v3ai/miata-ecus/motherboards/1996-97/README.md

# Miata ECU motherboard 1996-1997 (NA8 OBD2), rev 0.7

The motherboard replaces the stock Mazda ECU board inside the **stock ECU case**. It carries:

- the stock harness header;
- the year-independent I/O: the LSU 4.9 wideband sensor connector, IAT, USB-C and the MAP sensor;
- the sockets for the universal daughterboard, which does all the engine control (including the wideband controller).

## Changes in this revision
- Rev 0.7, for daughterboard rev 0.9: the daughterboard sits 16 mm lower, centred on the board (42 mm from the top, as up to rev 0.7), with its J1 on its top edge again: JD1 and the upper standoffs HD1/HD2 are back at their rev 0.7 places, JD2, the lower standoffs HD3/HD4, the AUX header J5 (with F4 beside it) and the parts placed against JD2 (CAN termination R1/R6, pull-up options) are 16 mm lower, and the board is routed again. Not compatible with a rev 0.8 daughterboard.
- Rev 0.6, for daughterboard rev 0.8: the harness's sensor 5 V (3I) and the AUX header pin J5-14 now come from the daughterboard's protected 5 V (V5_EXT, JD1 pin 13, which was a ground pin): a sensor 5 V wire shorted to the battery no longer back-feeds the MAP sensor and the ECU's own 5 V. The MAP sensor keeps its own supply (V5_SENS). The daughterboard outline on the silkscreen is 16 mm taller (125 x 76 mm): its new strip of output drivers overhangs the free area above JD1.
- Rev 0.5: LSU heater fuse F1 is a 3 A hold PTC (LUTE 2920L300/30GR, 30 V, 2920 size) instead of the 2 A 1812 part. A cold LSU 4.9 heater draws 1.6-2.3 A rms at the start of the wideband's warm-up, more than the old fuse holds once warm, so it could trip and the controller time out. No 1812 PTC holds 3 A above 8 V.
- Rev 0.4: freewheel diode D1 on the idle valve to its +12 V feed (the PWM turn-off energy no longer goes into the daughterboard driver); F4 resettable fuse on the AUX +12 V pin J5-15; not-fitted 12 V pull-up options R20-R22 for the VSS / A/C / clutch inputs.
- Rev 0.3: IAT source is now a removable jumper (JP1, 1x3 2.54 mm header + shunt) instead of the R4 / R5 0R links: shunt on EXT (default) reads the IAT connector J3, on STOCK the stock harness sensor; labelled on the silkscreen.
- Rev 0.2: MAP sensor is now the MPX5700AP (absolute, case 867B, one barb; LCSC C90152) instead of the MPX5700DP: new footprint with the real lozenge body and offset barb, holes on the NXP 23.11 mm spacing with 3.3 mm M3 clearance drills.
- Rev 0.1: first release (design complete, case geometry provisional).

## Files
| Path | What |
|---|---|
| `miata_mb_9697.kicad_pro / .kicad_sch / .kicad_pcb` | KiCad 7 project. Root schematic plus three sheets: harness, daughterboard, I/O |
| `miata_mb_9697_schematic.pdf` | Schematic PDF |
| `fab/miata-ecu-motherboard-1996-97-rev0.7_jlcpcb_gerbers.zip`, `fab/miata-ecu-motherboard-1996-97-rev0.7_jlcpcb_bom.csv`, `fab/miata-ecu-motherboard-1996-97-rev0.7_jlcpcb_cpl.csv` | JLC fabrication and assembly files (2 layers, 1.6 mm). The JLC BOM is the SMD parts and USB-C only |
| `fab/miata-ecu-motherboard-1996-97-rev0.7_self_order_bom.csv` | Everything you order and fit yourself: harness header, through-hole connectors, MAP sensor, shunt, standoffs and screws, plus the not-fitted options. Its columns load into LCSC's BOM tool |
| `fab/miata-ecu-motherboard-1996-97-rev0.7_parts_list.csv` | Every part, including the hand-fitted and not-fitted ones |
| `fab/drc_report.txt` | KiCad DRC |
| `ecu_mb.pretty/`, `fp-lib-table` | Project footprints (harness header, MAP sensor lying flat, USB-C, M4 case hole) |
| `renders/` | Top and bottom copper |
| `scripts/` | The design source; `mb_make.sh` rebuilds the whole board |

## Case fit
**PROVISIONAL.** No source gives this case's board outline and mounting holes yet (the open-source boards for these years either use their own enclosure or a different Mazda case). Until a stock board or case is measured, this board uses the NA case outline and holes as a stand-in, with the header centred on the top edge. Moving to the real outline is a change of OUTLINE / CASE_HOLES / HDR_1A in the year module plus an automatic reroute. **Do not order this board before the case is measured.**

Board: **154.0 × 161.5 mm**, 1.6 mm. The origin is the top-left corner and y points down, toward the bottom edge.

| Hole | x, y (mm) |
|---|---|
| H3 | 4.0, 84.0 |
| H4 | 150.0, 84.0 |
| H5 | 4.0, 143.0 |
| H6 | 150.0, 143.0 |

All holes are 4.5 mm plated with a 7 mm pad, tied to GND, for M4 screws. Harness header terminal 1A sits at (16.00, 18.13) mm (lower pin row).

## Harness header
TE **178780-1**, 76 positions (alternates 174915-6, 3-178780-6): OEM plug 1 = 1A-1V (22), plug 2 = 2A-2L (12, no harness plug: left open), plug 3 = 3A-3P (16), plug 4 = 4A-4Z (26). Hellen's board names the same cavities 1 / 4 / 2 / 3. Fitted by hand.

| Pin | Net | Use | Stock function / note |
|---|---|---|---|
| 1A | `OUT_FAN` | fan relay | cooling (radiator) fan relay |
| 1B | `OUT_LS7` | spare low side | fan No.2 / A/C condenser fan relay |
| 1E | `OUT_CEL` | check engine lamp | MIL |
| 1G | `OUT_AC` | A/C relay | A/C relay |
| 1K | `IN_SW2` | 12 V switch input 2 | A/C switch / refrigerant pressure switch |
| 1L | `IN_SW3` | 12 V switch input 3 | clutch switch |
| 1M | `IN_SW1` | 12 V switch input 1 | vehicle speed sensor |
| 1O | `GND` | ground | ground |
| 1U | `OUT_FP` | fuel pump relay | fuel pump relay |
| 3B | `IN_AUX3` | spare analog 3 | MAF signal |
| 3C | `IN_AUX2` | spare analog 2 | front HO2S (narrowband) |
| 3D | `IN_AUX1` | spare analog 1 | rear HO2S |
| 3F | `IN_TPS` | TPS | throttle position sensor |
| 3G | `IN_CLT` | coolant temp | coolant temperature sensor |
| 3I | `V5_EXT` | sensor 5 V reference (out; protected, short-to-battery proof) | +5 V sensor reference (TPS, MAF) |
| 3K | `HARN_IAT` | stock air-temp sensor (JP1 on STOCK) | intake air temperature sensor (IAT jumper JP1 on STOCK to use it) |
| 3M | `OUT_VVT` | PWM low side (VVT driver) | front HO2S heater (PWM low side; no VVT on this engine) |
| 3O | `GND` | ground | sensor ground (BLK/BLU) |
| 4A | `GND` | ground | ground |
| 4B | `VBAT_IN` | ECU power (main relay) | ECU +12 V from the main relay (WHT/RED) |
| 4C | `GND` | ground |  |
| 4D | `GND` | ground |  |
| 4F | `IN_HALL1` | hall input 1 (crank) | CAS 4-pulse crank angle (SGT), hall / open collector |
| 4G | `IN_HALL2` | hall input 2 (cam) | CAS 2-pulse cam (SGC), hall / open collector |
| 4L | `OUT_TACH` | tach out | tachometer |
| 4N | `OUT_IGN1` | ignition 1 (5 V logic) | igniter cylinders 1 & 4 |
| 4Q | `OUT_IACV` | idle air valve | idle air control valve (low side) |
| 4R | `OUT_IGN2` | ignition 2 (5 V logic) | igniter cylinders 2 & 3 |
| 4U | `OUT_INJ1` | injector 1 |  |
| 4V | `OUT_INJ2` | injector 2 |  |
| 4W | `OUT_INJ3` | injector 3 |  |
| 4X | `OUT_INJ4` | injector 4 |  |

Not connected: 1C, 1D, 1F, 1H, 1I, 1J, 1N, 1P, 1Q, 1R, 1S, 1T, 1V, 2A, 2B, 2C, 2D, 2E, 2F, 2G, 2H, 2I, 2J, 2K, 2L, 3A, 3E, 3H, 3J, 3L, 3N, 3P, 4E, 4H, 4I, 4J, 4K, 4M, 4O, 4P, 4S, 4T, 4Y, 4Z.

## Bottom edge, left to right
| Ref | What | Notes |
|---|---|---|
| J2 | LSU 4.9 (Molex Micro-Fit 2×3, right angle) | Pin n = LSU pin n: 1 IP, 2 VM, 3 H−, 4 H+, 5 RT, 6 UN. Heater fed from the main relay through F1 (3 A hold, 30 V, 2920). The controller is on the daughterboard |
| J3 | IAT (Micro-Fit 1×2) | M12×1.5 open-element thermistor, used when the IAT jumper JP1 is on EXT |
| JP1 | IAT source jumper (1×3, 2.54 mm) | Shunt on **2-3 (EXT, default)**: the IAT connector J3. Shunt on **1-2 (STOCK)**: the stock air-temp sensor through the harness (inside the airflow meter on 1989-97, in the air filter box on 1999-2005). Set the matching sensor curve in TunerStudio; the pull-up is 2.7 kΩ |
| J4 | USB-C | USB 2.0 device: tuning, logging, DFU |
| U2 | MPX5700AP | Absolute MAP sensor (15-700 kPa, case 867B). Lies flat on 2 × M3, marking side up, leads bent 90° down, the single barb toward the board centre |

**CAN:** R1 + R6 terminate the bus at the ECU end; remove R6 if the bus is terminated elsewhere.

**AUX (J5, 2×8 box header):** what the stock harness has no pins for: COP 3/4, boost, alternator and main-relay outputs, knock input, VR crank/cam inputs, external AFR input, UART, 5 V sensor supply, +12 V and GND.

**Protection (motherboard rev 0.4 / 0.6):** D1 (and D2 where the VVT driver runs a coil) freewheel the PWM valve coils into their own +12 V feed, so the drivers don't absorb the turn-off energy. F4 fuses the AUX +12 V pin (0.5 A hold).

**Switch inputs (R20-R22, not fitted):** the VSS, A/C and clutch inputs read signals that are driven to 12 V. If your car's signal only switches to ground (or is open collector), fit the 4.7 kΩ pull-up for that input. Never fit it for a switch that drives 12 V: the input would always read on.

**Sensor 5 V:** the harness's 5 V reference and the AUX header pin J5-14 come from the daughterboard's protected 5 V regulator (V5_EXT; it survives a short to the battery or to ground). The MAP sensor has its own supply (V5_SENS), so a damaged sensor wire doesn't take the MAP reading with it.

## Assembly
- The daughterboard plugs into JD1/JD2 (8.5 mm sockets) on four M3 × 11 mm standoffs.
- Fitted by hand (all in `fab/miata-ecu-motherboard-1996-97-rev0.7_self_order_bom.csv`): the harness header (salvage from a stock ECU or use a clone), the daughterboard sockets JD1/JD2, the LSU and IAT connectors, the AUX header, the JP1 header and its shunt (EXT or STOCK), the MAP sensor, the standoffs, and any not-fitted option links. JLCPCB fits only the SMD parts and USB-C. USB-C has through-hole shell pegs: check in JLC's quote whether that needs Standard PCBA.
- The case needs cut-outs in its bottom edge for the LSU, IAT, USB-C and MAP hose.

## Still to verify
- **The case outline, mounting holes and header position (provisional here).**
- The 76-position header housing is 130 mm wide and reaches into the top-corner notches of the provisional (NA) outline; the real 1996-97 case must clear it.
- 4E / 4H: the separate OBD-II crank-pulley sensor (VR) is left unconnected, as on every PnP board found; rusEFI uses the CAS signals on 4F / 4G.
- 1O and 4A are tied to ground (sources agree they are grounds; power vs signal role unconfirmed).
- 4I (possible battery backup), 4K, 1D, 1H, 1I, 1P, 3H, 3J, 3N, 3P and the other unidentified cavities are left open.
- Brake switch (1Q) is not read: the spare inputs are 0-5 V analog, not 12 V switch inputs.
