v3ai/miata-ecus/daughterboard/fab/drc_report.txt

** Drc report for /home/claude/miata-ecus/daughterboard/miata_ecu_daughter.kicad_pcb **
** Created on 2026-11-03 22:32:18 **

** Found 474 DRC violations **
[silk_overlap]: Silkscreen overlap
    Rule: board setup constraints silk; Severity: warning
    @(151.3500 mm, 121.5100 mm): Line on F.Silkscreen
    @(151.3800 mm, 120.1536 mm): Line on F.Silkscreen
[silk_overlap]: Silkscreen overlap
    Rule: board setup constraints silk; Severity: warning
    @(-1.1625 mm, -1.5100 mm): Polygon on F.Silkscreen
    @(156.6000 mm, 111.0000 mm): Reference 'D17'
[silk_overlap]: Silkscreen overlap
    Rule: board setup constraints silk; Severity: warning
    @(112.0000 mm, 108.6000 mm): Reference 'U8'
    @(111.7627 mm, 108.1225 mm): Line on F.Silkscreen
[silk_overlap]: Silkscreen overlap
    Rule: board setup constraints silk; Severity: warning
    @(121.7500 mm, 89.9100 mm): Line on F.Silkscreen
    @(121.8900 mm, 87.7400 mm): Line on F.Silkscreen
[silk_overlap]: Silkscreen overlap
    Rule: board setup constraints silk; Severity: warning
    @(121.7500 mm, 89.9100 mm): Line on F.Silkscreen
    @(121.8900 mm, 87.7400 mm): Line on F.Silkscreen
[silk_overlap]: Silkscreen overlap
    Rule: board setup constraints silk; Severity: warning
    @(118.4500 mm, 89.9100 mm): Line on F.Silkscreen
    @(121.8900 mm, 87.7400 mm): Line on F.Silkscreen
[silk_overlap]: Silkscreen overlap
    Rule: board setup constraints silk; Severity: warning
    @(114.0594 mm, 86.9100 mm): Line on F.Silkscreen
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
    Local override; Severity: warning
    @(166.3400 mm, 117.4000 mm): Footprint R52
[lib_footprint_issues]: The current configuration does not include the library 'Capacitor_SMD'.
    Local override; Severity: warning
    @(117.6000 mm, 95.2000 mm): Footprint C20
[lib_footprint_issues]: The current configuration does not include the library 'Resistor_SMD'.
    Local override; Severity: warning
    @(115.6000 mm, 113.6000 mm): Footprint R45
[lib_footprint_issues]: The current configuration does not include the library 'Package_TO_SOT_SMD'.
    Local override; Severity: warning
    @(166.3400 mm, 61.5000 mm): Footprint Q2
[lib_footprint_issues]: The current configuration does not include the library 'Diode_SMD'.
    Local override; Severity: warning
    @(124.0000 mm, 114.9000 mm): Footprint D20
[lib_footprint_issues]: The current configuration does not include the library 'Capacitor_SMD'.
    Local override; Severity: warning
    @(212.0000 mm, 104.0500 mm): Footprint C114
[lib_footprint_issues]: The current configuration does not include the library 'Capacitor_SMD'.
    Local override; Severity: warning
    @(118.0800 mm, 118.9000 mm): Footprint C44
[lib_footprint_issues]: The current configuration does not include the library 'Button_Switch_SMD'.
    Local override; Severity: warning
    @(219.5000 mm, 103.6000 mm): Footprint SW1
[lib_footprint_issues]: The current configuration does not include the library 'Package_TO_SOT_SMD'.
    Local override; Severity: warning
    @(173.9600 mm, 61.5000 mm): Footprint Q3
[lib_footprint_issues]: The current configuration does not include the library 'Package_SO'.
    Local override; Severity: warning
    @(151.7350 mm, 80.6000 mm): Footprint U7
[lib_footprint_issues]: The current configuration does not include the library 'Diode_SMD'.
    Local override; Severity: warning
    @(143.4800 mm, 114.3000 mm): Footprint D13
[lib_footprint_issues]: The current configuration does not include the library 'Resistor_SMD'.
    Local override; Severity: warning
    @(172.8000 mm, 120.0000 mm): Footprint R80
[lib_footprint_issues]: The current configuration does not include the library 'Diode_SMD'.
    Local override; Severity: warning
    @(149.7000 mm, 119.9000 mm): Footprint D27
[lib_footprint_issues]: The current configuration does not include the library 'MountingHole'.
    Local override; Severity: warning
    @(220.5000 mm, 121.5000 mm): Footprint H4
[lib_footprint_issues]: The current configuration does not include the library 'Resistor_SMD'.
    Local override; Severity: warning
    @(143.5000 mm, 120.0000 mm): Footprint R61
[lib_footprint_issues]: The current configuration does not include the library 'Resistor_SMD'.
    Local override; Severity: warning
    @(137.9000 mm, 117.6000 mm): Footprint R44
[lib_footprint_issues]: The current configuration does not include the library 'Package_TO_SOT_SMD'.
    Local override; Severity: warning
    @(151.1000 mm, 64.1000 mm): Footprint Q18
[lib_footprint_issues]: The current configuration does not include the library 'Fuse'.
    Local override; Severity: warning
    @(203.8200 mm, 120.4500 mm): Footprint F2
[lib_footprint_issues]: The current configuration does not include the library 'Capacitor_SMD'.
    Local override; Severity: warning
    @(179.7500 mm, 110.4400 mm): Footprint C67
[lib_footprint_issues]: The current configuration does not include the library 'Capacitor_SMD'.
    Local override; Severity: warning
    @(196.6000 mm, 105.0000 mm): Footprint C119
[lib_footprint_issues]: The current configuration does not include the library 'Capacitor_SMD'.
    Local override; Severity: warning
    @(107.4000 mm, 98.0000 mm): Footprint C24
[lib_footprint_issues]: The current configuration does not include the library 'Resistor_SMD'.
    Local override; Severity: warning
    @(176.2500 mm, 102.1000 mm): Footprint R139
[lib_footprint_issues]: The current configuration does not include the library 'LED_SMD'.
    Local override; Severity: warning
    @(219.6000 mm, 95.0000 mm): Footprint D4
[lib_footprint_issues]: The current configuration does not include the library 'Resistor_SMD'.
    Local override; Severity: warning
    @(150.4000 mm, 117.6000 mm): Footprint R68
[lib_footprint_issues]: The current configuration does not include the library 'Package_TO_SOT_SMD'.
    Local override; Severity: warning
    @(194.4000 mm, 75.4000 mm): Footprint U15
[lib_footprint_issues]: The current configuration does not include the library 'Capacitor_SMD'.
    Local override; Severity: warning
    @(143.5000 mm, 117.6000 mm): Footprint C51
[lib_footprint_issues]: The current configuration does not include the library 'Capacitor_SMD'.
    Local override; Severity: warning
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
    Local override; Severity: warning
    @(174.0000 mm, 97.5000 mm): Footprint D37
[lib_footprint_issues]: The current configuration does not include the library 'Package_TO_SOT_SMD'.
    Local override; Severity: warning
    @(141.4000 mm, 119.9000 mm): Footprint D35
[lib_footprint_issues]: The current configuration does not include the library 'Resistor_SMD'.
    Local override; Severity: warning
    @(205.6000 mm, 104.3000 mm): Footprint R124
[lib_footprint_issues]: The current configuration does not include the library 'Package_TO_SOT_SMD'.
    Local override; Severity: warning
    @(135.8600 mm, 58.5000 mm): Footprint Q13
[lib_footprint_issues]: The current configuration does not include the library 'Resistor_SMD'.
    Local override; Severity: warning
    @(215.8700 mm, 69.4000 mm): Footprint R26
[lib_footprint_issues]: The current configuration does not include the library 'Resistor_SMD'.
    Local override; Severity: warning
    @(141.9000 mm, 113.2000 mm): Footprint R13
[lib_footprint_issues]: The current configuration does not include the library 'Resistor_SMD'.
    Local override; Severity: warning
    @(140.1000 mm, 115.1000 mm): Footprint R12
[lib_footprint_issues]: The current configuration does not include the library 'MountingHole'.
    Local override; Severity: warning
    @(104.5000 mm, 54.5000 mm): Footprint H1
[lib_footprint_issues]: The current configuration does not include the library 'Capacitor_SMD'.
    Local override; Severity: warning
    @(136.3500 mm, 117.6000 mm): Footprint C42
[lib_footprint_issues]: The current configuration does not include the library 'Capacitor_SMD'.
    Local override; Severity: warning
    @(162.0000 mm, 79.4000 mm): Footprint C61
[lib_footprint_issues]: The current configuration does not include the library 'Capacitor_SMD'.
    Local override; Severity: warning
    @(150.4000 mm, 101.2000 mm): Footprint C3
[lib_footprint_issues]: The current configuration does not include the library 'Crystal'.
    Local override; Severity: warning
    @(144.6000 mm, 98.4000 mm): Footprint Y1
[lib_footprint_issues]: The current configuration does not include the library 'Resistor_SMD'.
    Local override; Severity: warning
    @(155.4000 mm, 116.6000 mm): Footprint R75
[lib_footprint_issues]: The current configuration does not include the library 'Package_QFP'.
    Local override; Severity: warning
    @(200.5000 mm, 98.5000 mm): Footprint U102
[lib_footprint_issues]: The current configuration does not include the library 'Capacitor_SMD'.
    Local override; Severity: warning
    @(123.8500 mm, 117.6000 mm): Footprint C37
[lib_footprint_issues]: The current configuration does not include the library 'Resistor_SMD'.
    Local override; Severity: warning
    @(163.8000 mm, 117.4000 mm): Footprint R54
[lib_footprint_issues]: The current configuration does not include the library 'Button_Switch_SMD'.
    Local override; Severity: warning
    @(219.5000 mm, 111.4000 mm): Footprint SW2
[lib_footprint_issues]: The current configuration does not include the library 'Resistor_SMD'.
    Local override; Severity: warning
    @(155.4000 mm, 119.3000 mm): Footprint R78
[lib_footprint_issues]: The current configuration does not include the library 'Capacitor_SMD'.
    Local override; Severity: warning
    @(153.2000 mm, 88.0000 mm): Footprint C1
[lib_footprint_issues]: The current configuration does not include the library 'Resistor_SMD'.
    Local override; Severity: warning
    @(174.8000 mm, 95.4500 mm): Footprint R140
[courtyards_overlap]: Courtyards overlap
    Rule: board setup constraints courtyard; Severity: error
    @(135.1500 mm, 117.6000 mm): Footprint R42
    @(135.7500 mm, 119.8000 mm): Footprint R41
[courtyards_overlap]: Courtyards overlap
    Rule: board setup constraints courtyard; Severity: error
    @(173.8000 mm, 102.4000 mm): Footprint C4
    @(174.0000 mm, 100.5000 mm): Footprint D36
[courtyards_overlap]: Courtyards overlap
    Rule: board setup constraints courtyard; Severity: error
    @(153.5500 mm, 63.3000 mm): Footprint R147
    @(151.1000 mm, 64.1000 mm): Footprint Q18
[courtyards_overlap]: Courtyards overlap
    Rule: board setup constraints courtyard; Severity: error
    @(153.5500 mm, 63.3000 mm): Footprint R147
    @(153.6400 mm, 58.9000 mm): Footprint D34
[courtyards_overlap]: Courtyards overlap
    Rule: board setup constraints courtyard; Severity: error
    @(133.2500 mm, 119.8000 mm): Footprint R39
    @(133.8500 mm, 117.6000 mm): Footprint C41
[courtyards_overlap]: Courtyards overlap
    Rule: board setup constraints courtyard; Severity: error
    @(133.2500 mm, 119.8000 mm): Footprint R39
    @(132.6500 mm, 117.6000 mm): Footprint R40
[courtyards_overlap]: Courtyards overlap
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
    @(198.0000 mm, 80.0000 mm): Footprint C63
[courtyards_overlap]: Courtyards overlap
    Rule: board setup constraints courtyard; Severity: error
    @(136.1500 mm, 112.7500 mm): Footprint D38
    @(136.3500 mm, 114.9000 mm): Footprint D25
[courtyards_overlap]: Courtyards overlap
    Rule: board setup constraints courtyard; Severity: error
    @(136.1500 mm, 112.7500 mm): Footprint D38
    @(134.0000 mm, 114.9000 mm): Footprint D24

** Found 0 unconnected pads **

** Found 0 Footprint errors **

** End of Report **
