v3ai/miata-ecus/motherboards/1989-93/fab/drc_report.txt

** Drc report for ../mb/release_8993/miata_mb_8993.kicad_pcb **
** Created on 2026-11-04 20:15:21 **

** Found 110 DRC violations **
[silk_overlap]: Silkscreen overlap
    Rule: board setup constraints silk; Severity: warning
    @(119.0000 mm, 92.3000 mm): Reference 'HD1'
    @(114.5000 mm, 92.0000 mm): Line on F.Silkscreen
[silk_overlap]: Silkscreen overlap
    Rule: board setup constraints silk; Severity: warning
    @(194.4325 mm, 169.8373 mm): Line on F.Silkscreen
    @(194.2800 mm, 169.6000 mm): Reference 'R6'
[silk_overlap]: Silkscreen overlap
    Rule: board setup constraints silk; Severity: warning
    @(114.5000 mm, 92.0000 mm): Line on F.Silkscreen
    @(235.0000 mm, 92.3000 mm): Reference 'HD2'
[silk_overlap]: Silkscreen overlap
    Rule: board setup constraints silk; Severity: warning
    @(163.5825 mm, 160.2373 mm): Line on F.Silkscreen
    @(164.1700 mm, 160.0000 mm): Reference 'R21'
[silk_overlap]: Silkscreen overlap
    Rule: board setup constraints silk; Severity: warning
    @(166.7100 mm, 160.0000 mm): Reference 'R22'
    @(166.1225 mm, 160.2373 mm): Line on F.Silkscreen
[silk_over_copper]: Silkscreen clipped by solder mask
    Local override; Severity: warning
    @(139.7025 mm, 68.1300 mm): PTH pad 1A [<no net>] of J1
[silk_over_copper]: Silkscreen clipped by solder mask
    Local override; Severity: warning
    @(139.7025 mm, 63.6291 mm): PTH pad 1B [VBAT_IN] of J1
[silk_over_copper]: Silkscreen clipped by solder mask
    Local override; Severity: warning
    @(143.2001 mm, 68.1300 mm): PTH pad 1C [VIGN_IN] of J1
[silk_over_copper]: Silkscreen clipped by solder mask
    Local override; Severity: warning
    @(143.2001 mm, 63.6291 mm): PTH pad 1D [<no net>] of J1
[silk_over_copper]: Silkscreen clipped by solder mask
    Local override; Severity: warning
    @(146.3015 mm, 68.1300 mm): PTH pad 1E [OUT_CEL] of J1
[silk_over_copper]: Silkscreen clipped by solder mask
    Local override; Severity: warning
    @(146.3015 mm, 63.6291 mm): PTH pad 1F [<no net>] of J1
[silk_over_copper]: Silkscreen clipped by solder mask
    Local override; Severity: warning
    @(149.3012 mm, 68.1300 mm): PTH pad 1G [OUT_IGN1] of J1
[silk_over_copper]: Silkscreen clipped by solder mask
    Local override; Severity: warning
    @(149.3012 mm, 63.6291 mm): PTH pad 1H [OUT_IGN2] of J1
[silk_over_copper]: Silkscreen clipped by solder mask
    Local override; Severity: warning
    @(152.3009 mm, 68.1300 mm): PTH pad 1I [<no net>] of J1
[silk_over_copper]: Silkscreen clipped by solder mask
    Local override; Severity: warning
    @(152.3009 mm, 63.6291 mm): PTH pad 1J [OUT_AC] of J1
[silk_over_copper]: Silkscreen clipped by solder mask
    Local override; Severity: warning
    @(155.3007 mm, 68.1300 mm): PTH pad 1K [<no net>] of J1
[silk_over_copper]: Silkscreen clipped by solder mask
    Local override; Severity: warning
    @(155.3007 mm, 63.6291 mm): PTH pad 1L [OUT_FAN] of J1
[silk_over_copper]: Silkscreen clipped by solder mask
    Local override; Severity: warning
    @(158.3004 mm, 68.1300 mm): PTH pad 1M [IN_SW1] of J1
[silk_over_copper]: Silkscreen clipped by solder mask
    Local override; Severity: warning
    @(158.3004 mm, 63.6291 mm): PTH pad 1N [HARN_1N] of J1
[silk_over_copper]: Silkscreen clipped by solder mask
    Local override; Severity: warning
    @(161.3002 mm, 68.1300 mm): PTH pad 1O [<no net>] of J1
[silk_over_copper]: Silkscreen clipped by solder mask
    Local override; Severity: warning
    @(161.3002 mm, 63.6291 mm): PTH pad 1P [<no net>] of J1
[silk_over_copper]: Silkscreen clipped by solder mask
    Local override; Severity: warning
    @(164.2999 mm, 68.1300 mm): PTH pad 1Q [IN_SW2] of J1
[silk_over_copper]: Silkscreen clipped by solder mask
    Local override; Severity: warning
    @(164.2999 mm, 63.6291 mm): PTH pad 1R [OUT_LS7] of J1
[silk_over_copper]: Silkscreen clipped by solder mask
    Local override; Severity: warning
    @(167.2996 mm, 68.1300 mm): PTH pad 1S [<no net>] of J1
[silk_over_copper]: Silkscreen clipped by solder mask
    Local override; Severity: warning
    @(167.2996 mm, 63.6291 mm): PTH pad 1T [<no net>] of J1
[silk_over_copper]: Silkscreen clipped by solder mask
    Local override; Severity: warning
    @(170.4010 mm, 68.1300 mm): PTH pad 1U [<no net>] of J1
[silk_over_copper]: Silkscreen clipped by solder mask
    Local override; Severity: warning
    @(170.4010 mm, 63.6291 mm): PTH pad 1V [IN_SW3] of J1
[silk_over_copper]: Silkscreen clipped by solder mask
    Local override; Severity: warning
    @(176.6011 mm, 68.1300 mm): PTH pad 2A [GND] of J1
[silk_over_copper]: Silkscreen clipped by solder mask
    Local override; Severity: warning
    @(176.6011 mm, 63.6291 mm): PTH pad 2B [GND] of J1
[silk_over_copper]: Silkscreen clipped by solder mask
    Local override; Severity: warning
    @(180.1012 mm, 68.1300 mm): PTH pad 2C [GND] of J1
[silk_over_copper]: Silkscreen clipped by solder mask
    Local override; Severity: warning
    @(180.1012 mm, 63.6291 mm): PTH pad 2D [GND] of J1
[silk_over_copper]: Silkscreen clipped by solder mask
    Local override; Severity: warning
    @(183.2051 mm, 68.1300 mm): PTH pad 2E [IN_HALL1] of J1
[silk_over_copper]: Silkscreen clipped by solder mask
    Local override; Severity: warning
    @(183.2051 mm, 63.6291 mm): PTH pad 2F [GND] of J1
[silk_over_copper]: Silkscreen clipped by solder mask
    Local override; Severity: warning
    @(186.2049 mm, 68.1300 mm): PTH pad 2G [IN_HALL2] of J1
[silk_over_copper]: Silkscreen clipped by solder mask
    Local override; Severity: warning
    @(186.2049 mm, 63.6291 mm): PTH pad 2H [<no net>] of J1
[silk_over_copper]: Silkscreen clipped by solder mask
    Local override; Severity: warning
    @(189.2046 mm, 68.1300 mm): PTH pad 2I [OUT_TACH] of J1
[silk_over_copper]: Silkscreen clipped by solder mask
    Local override; Severity: warning
    @(189.2046 mm, 63.6291 mm): PTH pad 2J [<no net>] of J1
[silk_over_copper]: Silkscreen clipped by solder mask
    Local override; Severity: warning
    @(192.2043 mm, 68.1300 mm): PTH pad 2K [V5_EXT] of J1
[silk_over_copper]: Silkscreen clipped by solder mask
    Local override; Severity: warning
    @(192.2043 mm, 63.6291 mm): PTH pad 2L [HARN_2L] of J1
[silk_over_copper]: Silkscreen clipped by solder mask
    Local override; Severity: warning
    @(195.2041 mm, 68.1300 mm): PTH pad 2M [IN_TPS] of J1
[silk_over_copper]: Silkscreen clipped by solder mask
    Local override; Severity: warning
    @(195.2041 mm, 63.6291 mm): PTH pad 2N [IN_AUX2] of J1
[silk_over_copper]: Silkscreen clipped by solder mask
    Local override; Severity: warning
    @(198.2038 mm, 68.1300 mm): PTH pad 2O [IN_AUX3] of J1
[silk_over_copper]: Silkscreen clipped by solder mask
    Local override; Severity: warning
    @(198.2038 mm, 63.6291 mm): PTH pad 2P [HARN_IAT] of J1
[silk_over_copper]: Silkscreen clipped by solder mask
    Local override; Severity: warning
    @(201.2036 mm, 68.1300 mm): PTH pad 2Q [IN_CLT] of J1
[silk_over_copper]: Silkscreen clipped by solder mask
    Local override; Severity: warning
    @(201.2036 mm, 63.6291 mm): PTH pad 2R [<no net>] of J1
[silk_over_copper]: Silkscreen clipped by solder mask
    Local override; Severity: warning
    @(204.2033 mm, 68.1300 mm): PTH pad 2S [<no net>] of J1
[silk_over_copper]: Silkscreen clipped by solder mask
    Local override; Severity: warning
    @(204.2033 mm, 63.6291 mm): PTH pad 2T [OUT_FP] of J1
[silk_over_copper]: Silkscreen clipped by solder mask
    Local override; Severity: warning
    @(207.3046 mm, 68.1300 mm): PTH pad 2U [OUT_INJ1] of J1
[silk_over_copper]: Silkscreen clipped by solder mask
    Local override; Severity: warning
    @(207.3046 mm, 63.6291 mm): PTH pad 2V [OUT_INJ2] of J1
[silk_over_copper]: Silkscreen clipped by solder mask
    Local override; Severity: warning
    @(210.8048 mm, 68.1300 mm): PTH pad 2W [OUT_IACV] of J1
[silk_over_copper]: Silkscreen clipped by solder mask
    Local override; Severity: warning
    @(210.8048 mm, 63.6291 mm): PTH pad 2X [OUT_VVT] of J1
[silk_over_copper]: Silkscreen clipped by solder mask
    Local override; Severity: warning
    @(214.3049 mm, 68.1300 mm): PTH pad 2Y [HARN_2Y] of J1
[silk_over_copper]: Silkscreen clipped by solder mask
    Local override; Severity: warning
    @(214.3049 mm, 63.6291 mm): PTH pad 2Z [HARN_2Z] of J1
[silk_over_copper]: Silkscreen clipped by solder mask
    Local override; Severity: warning
    @(194.2800 mm, 169.6000 mm): Reference 'R6'
[starved_thermal]: Thermal relief connection to zone incomplete (zone min spoke count 2; actual 1)
    Local override; Severity: error
    @(115.5000 mm, 50.0000 mm): Zone [GND] on F.Cu
    @(176.8000 mm, 203.9200 mm): Pad A1 [GND] of J4 on F.Cu
[starved_thermal]: Thermal relief connection to zone incomplete (zone min spoke count 2; actual 1)
    Local override; Severity: error
    @(115.5000 mm, 50.0000 mm): Zone [GND] on F.Cu
    @(176.8000 mm, 203.9200 mm): Pad B12 [GND] of J4 on F.Cu
[starved_thermal]: Thermal relief connection to zone incomplete (zone min spoke count 2; actual 1)
    Local override; Severity: error
    @(115.5000 mm, 50.0000 mm): Zone [GND] on F.Cu
    @(176.6011 mm, 68.1300 mm): PTH pad 2A [GND] of J1
[starved_thermal]: Thermal relief connection to zone incomplete (zone min spoke count 2; actual 1)
    Local override; Severity: error
    @(115.5000 mm, 50.0000 mm): Zone [GND] on F.Cu
    @(180.1012 mm, 68.1300 mm): PTH pad 2C [GND] of J1
[starved_thermal]: Thermal relief connection to zone incomplete (zone min spoke count 2; actual 1)
    Local override; Severity: error
    @(115.5000 mm, 50.0000 mm): Zone [GND] on F.Cu
    @(226.5600 mm, 165.2500 mm): PTH pad 40 [GND] of JD2
[starved_thermal]: Thermal relief connection to zone incomplete (zone min spoke count 2; actual 1)
    Local override; Severity: error
    @(115.5000 mm, 50.0000 mm): Zone [GND] on F.Cu
    @(168.1100 mm, 180.7875 mm): PTH pad 16 [GND] of J5
[lib_footprint_issues]: The current configuration does not include the library 'Resistor_SMD'.
    Local override; Severity: warning
    @(196.0000 mm, 107.5000 mm): Footprint R26
[lib_footprint_issues]: The current configuration does not include the library 'Package_TO_SOT_SMD'.
    Local override; Severity: warning
    @(180.0000 mm, 199.0000 mm): Footprint U4
[lib_footprint_issues]: The current configuration does not include the library 'ecu_mb'.
    Local override; Severity: warning
    @(117.0000 mm, 57.3000 mm): Footprint H1
[lib_footprint_issues]: The current configuration does not include the library 'Fuse'.
    Local override; Severity: warning
    @(198.0000 mm, 179.0000 mm): Footprint F4
[lib_footprint_issues]: The current configuration does not include the library 'ecu_mb'.
    Local override; Severity: warning
    @(224.0000 mm, 192.0000 mm): Footprint U2
[lib_footprint_issues]: The current configuration does not include the library 'Diode_SMD'.
    Local override; Severity: warning
    @(186.0000 mm, 114.0000 mm): Footprint D4
[lib_footprint_issues]: The current configuration does not include the library 'ecu_mb'.
    Local override; Severity: warning
    @(104.0000 mm, 134.0000 mm): Footprint H3
[lib_footprint_issues]: The current configuration does not include the library 'Resistor_SMD'.
    Local override; Severity: warning
    @(193.9100 mm, 169.6000 mm): Footprint R1
[lib_footprint_issues]: The current configuration does not include the library 'Capacitor_SMD'.
    Local override; Severity: warning
    @(243.6000 mm, 186.6000 mm): Footprint C2
[lib_footprint_issues]: The current configuration does not include the library 'Resistor_SMD'.
    Local override; Severity: warning
    @(190.0000 mm, 107.5000 mm): Footprint R25
[lib_footprint_issues]: The current configuration does not include the library 'Diode_SMD'.
    Local override; Severity: warning
    @(203.7000 mm, 102.0000 mm): Footprint D1
[lib_footprint_issues]: The current configuration does not include the library 'ecu_mb'.
    Local override; Severity: warning
    @(250.0000 mm, 193.0000 mm): Footprint H6
[lib_footprint_issues]: The current configuration does not include the library 'Resistor_SMD'.
    Local override; Severity: warning
    @(163.0600 mm, 160.0000 mm): Footprint R20
[lib_footprint_issues]: The current configuration does not include the library 'MountingHole'.
    Local override; Severity: warning
    @(119.0000 mm, 96.5000 mm): Footprint HD1
[lib_footprint_issues]: The current configuration does not include the library 'Diode_SMD'.
    Local override; Severity: warning
    @(211.3200 mm, 102.0000 mm): Footprint D2
[lib_footprint_issues]: The current configuration does not include the library 'Resistor_SMD'.
    Local override; Severity: warning
    @(142.5000 mm, 152.5000 mm): Footprint R30
[lib_footprint_issues]: The current configuration does not include the library 'Connector_Molex'.
    Local override; Severity: warning
    @(129.0000 mm, 202.3000 mm): Footprint J2
[lib_footprint_issues]: The current configuration does not include the library 'Capacitor_SMD'.
    Local override; Severity: warning
    @(243.6000 mm, 198.0000 mm): Footprint C3
[lib_footprint_issues]: The current configuration does not include the library 'Resistor_SMD'.
    Local override; Severity: warning
    @(173.5000 mm, 201.0000 mm): Footprint R2
[lib_footprint_issues]: The current configuration does not include the library 'Capacitor_SMD'.
    Local override; Severity: warning
    @(243.6000 mm, 190.6000 mm): Footprint C1
[lib_footprint_issues]: The current configuration does not include the library 'Resistor_SMD'.
    Local override; Severity: warning
    @(158.2000 mm, 72.7500 mm): Footprint R28
[lib_footprint_issues]: The current configuration does not include the library 'Resistor_SMD'.
    Local override; Severity: warning
    @(184.6000 mm, 103.0000 mm): Footprint R24
[lib_footprint_issues]: The current configuration does not include the library 'Resistor_SMD'.
    Local override; Severity: warning
    @(149.0900 mm, 152.5000 mm): Footprint R29
[lib_footprint_issues]: The current configuration does not include the library 'MountingHole'.
    Local override; Severity: warning
    @(119.0000 mm, 163.5000 mm): Footprint HD3
[lib_footprint_issues]: The current configuration does not include the library 'ecu_mb'.
    Local override; Severity: warning
    @(180.0000 mm, 207.6000 mm): Footprint J4
[lib_footprint_issues]: The current configuration does not include the library 'ecu_mb'.
    Local override; Severity: warning
    @(139.7000 mm, 68.1300 mm): Footprint J1
[lib_footprint_issues]: The current configuration does not include the library 'ecu_mb'.
    Local override; Severity: warning
    @(237.0000 mm, 57.3000 mm): Footprint H2
[lib_footprint_issues]: The current configuration does not include the library 'Resistor_SMD'.
    Local override; Severity: warning
    @(186.5000 mm, 201.0000 mm): Footprint R3
[lib_footprint_issues]: The current configuration does not include the library 'Connector_Molex'.
    Local override; Severity: warning
    @(155.0000 mm, 202.3000 mm): Footprint J3
[lib_footprint_issues]: The current configuration does not include the library 'Diode_SMD'.
    Local override; Severity: warning
    @(172.0000 mm, 114.0000 mm): Footprint D3
[lib_footprint_issues]: The current configuration does not include the library 'Resistor_SMD'.
    Local override; Severity: warning
    @(184.6000 mm, 99.0000 mm): Footprint R23
[lib_footprint_issues]: The current configuration does not include the library 'Connector_PinSocket_2.54mm'.
    Local override; Severity: warning
    @(127.5000 mm, 165.2500 mm): Footprint JD2
[lib_footprint_issues]: The current configuration does not include the library 'Connector_PinSocket_2.54mm'.
    Local override; Severity: warning
    @(127.5000 mm, 94.7500 mm): Footprint JD1
[lib_footprint_issues]: The current configuration does not include the library 'MountingHole'.
    Local override; Severity: warning
    @(235.0000 mm, 96.5000 mm): Footprint HD2
[lib_footprint_issues]: The current configuration does not include the library 'ecu_mb'.
    Local override; Severity: warning
    @(104.0000 mm, 193.0000 mm): Footprint H5
[lib_footprint_issues]: The current configuration does not include the library 'Connector_PinHeader_2.54mm'.
    Local override; Severity: warning
    @(152.4600 mm, 195.0000 mm): Footprint JP1
[lib_footprint_issues]: The current configuration does not include the library 'Resistor_SMD'.
    Local override; Severity: warning
    @(147.8200 mm, 160.0000 mm): Footprint R27
[lib_footprint_issues]: The current configuration does not include the library 'ecu_mb'.
    Local override; Severity: warning
    @(250.0000 mm, 134.0000 mm): Footprint H4
[lib_footprint_issues]: The current configuration does not include the library 'MountingHole'.
    Local override; Severity: warning
    @(235.0000 mm, 163.5000 mm): Footprint HD4
[lib_footprint_issues]: The current configuration does not include the library 'Resistor_SMD'.
    Local override; Severity: warning
    @(168.1400 mm, 160.0000 mm): Footprint R22
[lib_footprint_issues]: The current configuration does not include the library 'Connector_IDC'.
    Local override; Severity: warning
    @(185.8900 mm, 178.2475 mm): Footprint J5
[lib_footprint_issues]: The current configuration does not include the library 'Resistor_SMD'.
    Local override; Severity: warning
    @(195.7100 mm, 169.6000 mm): Footprint R6
[lib_footprint_issues]: The current configuration does not include the library 'Fuse'.
    Local override; Severity: warning
    @(144.0000 mm, 193.0000 mm): Footprint F1
[lib_footprint_issues]: The current configuration does not include the library 'Resistor_SMD'.
    Local override; Severity: warning
    @(165.6000 mm, 160.0000 mm): Footprint R21
[silk_edge_clearance]: Silkscreen clipped by board edge
    Rule: board setup constraints silk; Severity: warning
    @(115.5000 mm, 50.0000 mm): Line on Edge.Cuts
    @(135.8494 mm, 42.6309 mm): Line on F.Silkscreen
[silk_edge_clearance]: Silkscreen clipped by board edge
    Rule: board setup constraints silk; Severity: warning
    @(115.5000 mm, 50.0000 mm): Line on Edge.Cuts
    @(218.1555 mm, 42.6309 mm): Line on F.Silkscreen
[hole_clearance]: Hole clearance violation (board setup constraints hole clearance 0.2500 mm; actual 0.1944 mm)
    Rule: board setup constraints hole; Severity: error
    @(177.1100 mm, 204.9950 mm): NPTH pad of J4
    @(176.8000 mm, 203.9200 mm): Pad A1 [GND] of J4 on F.Cu
[hole_clearance]: Hole clearance violation (board setup constraints hole clearance 0.2500 mm; actual 0.1944 mm)
    Rule: board setup constraints hole; Severity: error
    @(177.1100 mm, 204.9950 mm): NPTH pad of J4
    @(176.8000 mm, 203.9200 mm): Pad B12 [GND] of J4 on F.Cu
[hole_clearance]: Hole clearance violation (board setup constraints hole clearance 0.2500 mm; actual 0.1944 mm)
    Rule: board setup constraints hole; Severity: error
    @(182.8900 mm, 204.9950 mm): NPTH pad of J4
    @(183.2000 mm, 203.9200 mm): Pad A12 [GND] of J4 on F.Cu
[hole_clearance]: Hole clearance violation (board setup constraints hole clearance 0.2500 mm; actual 0.1944 mm)
    Rule: board setup constraints hole; Severity: error
    @(182.8900 mm, 204.9950 mm): NPTH pad of J4
    @(183.2000 mm, 203.9200 mm): Pad B1 [GND] of J4 on F.Cu

** Found 0 unconnected pads **

** Found 0 Footprint errors **

** End of Report **
