v3ai/miata-ecus/daughterboard/renders/bottom_copper.png

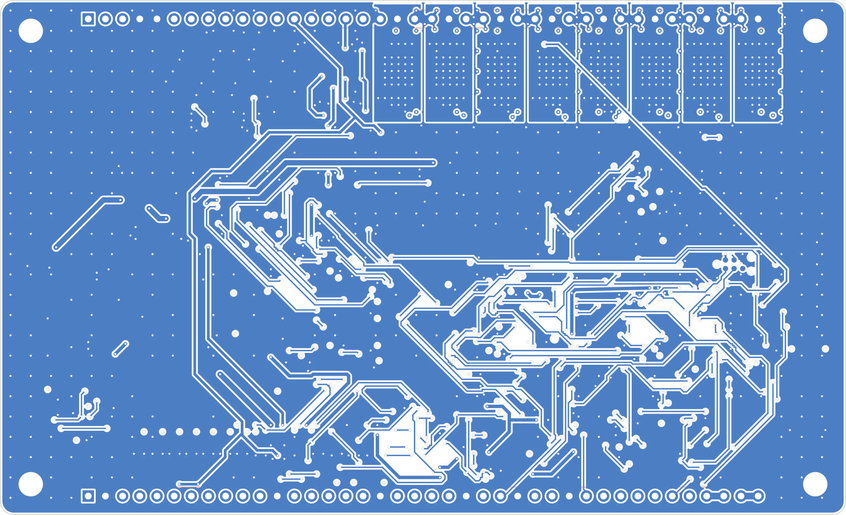
daughterboard/renders/bottom_copper.png
