v3ai/miata-ecus/daughterboard/renders/top_copper_silk.png

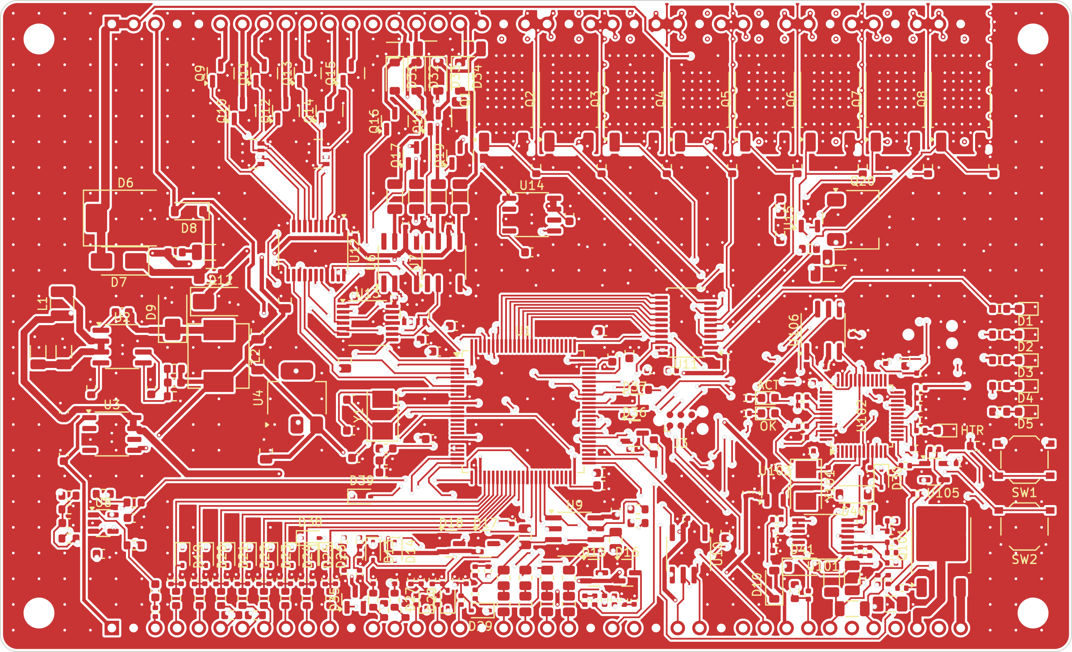
daughterboard/renders/top_copper_silk.png
