v3ai/miata-ecus/images/annotated_1989-93.jpg

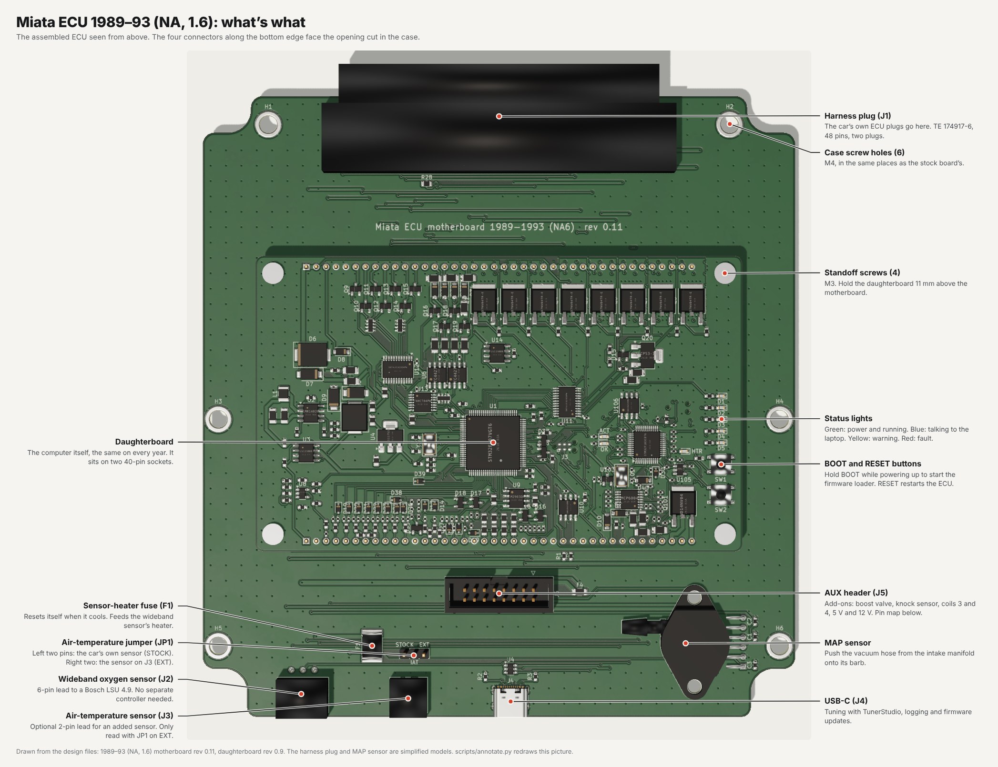
images/annotated_1989-93.jpg
