v3ai/miata-ecus/images/annotated_motherboard_1989-93.jpg

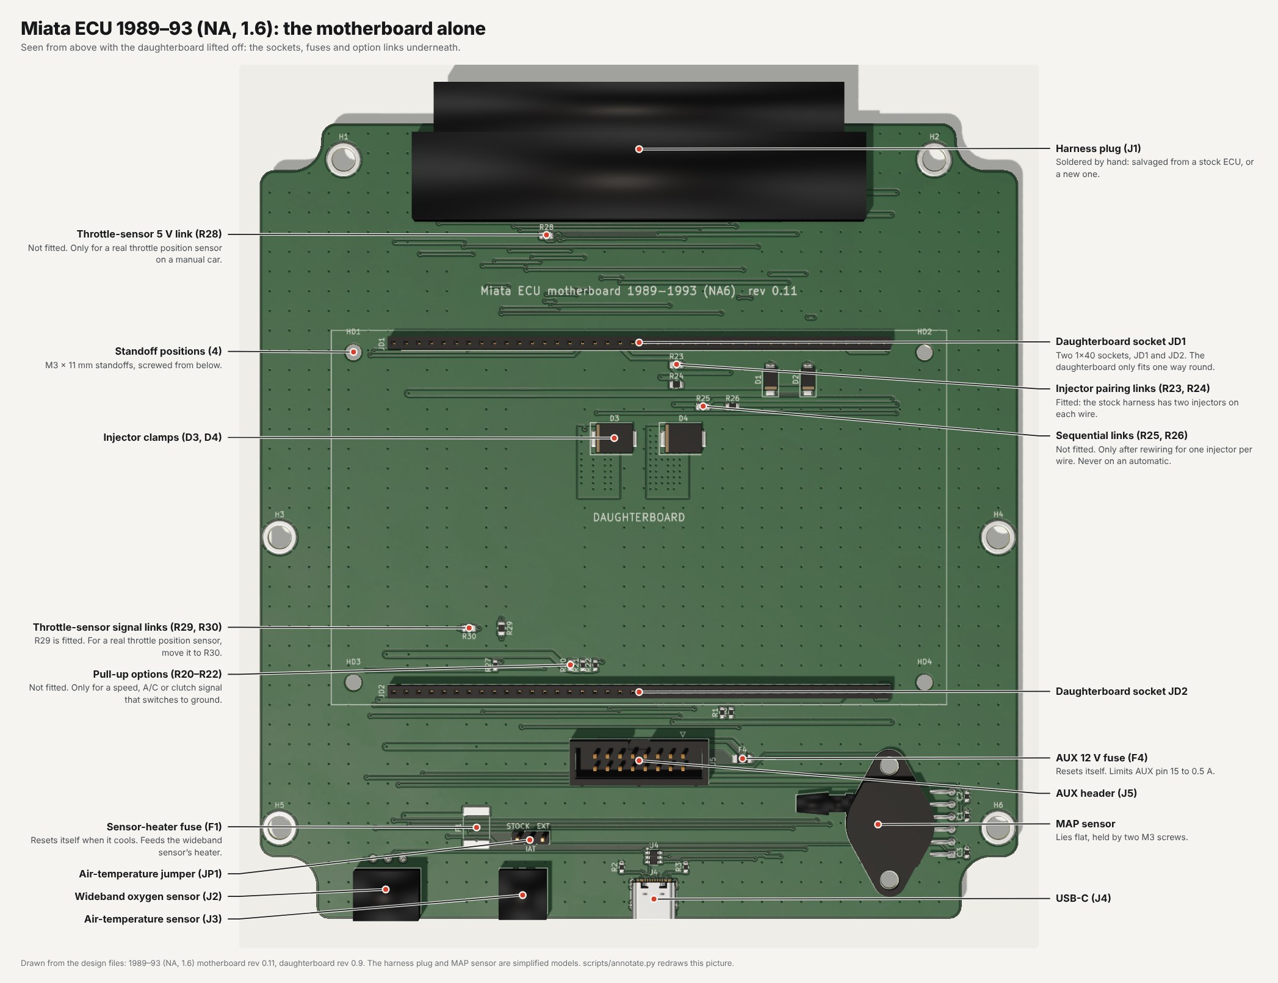
images/annotated_motherboard_1989-93.jpg
