v3ai/miata-ecus/images/annotated_motherboard_1999-2000.jpg

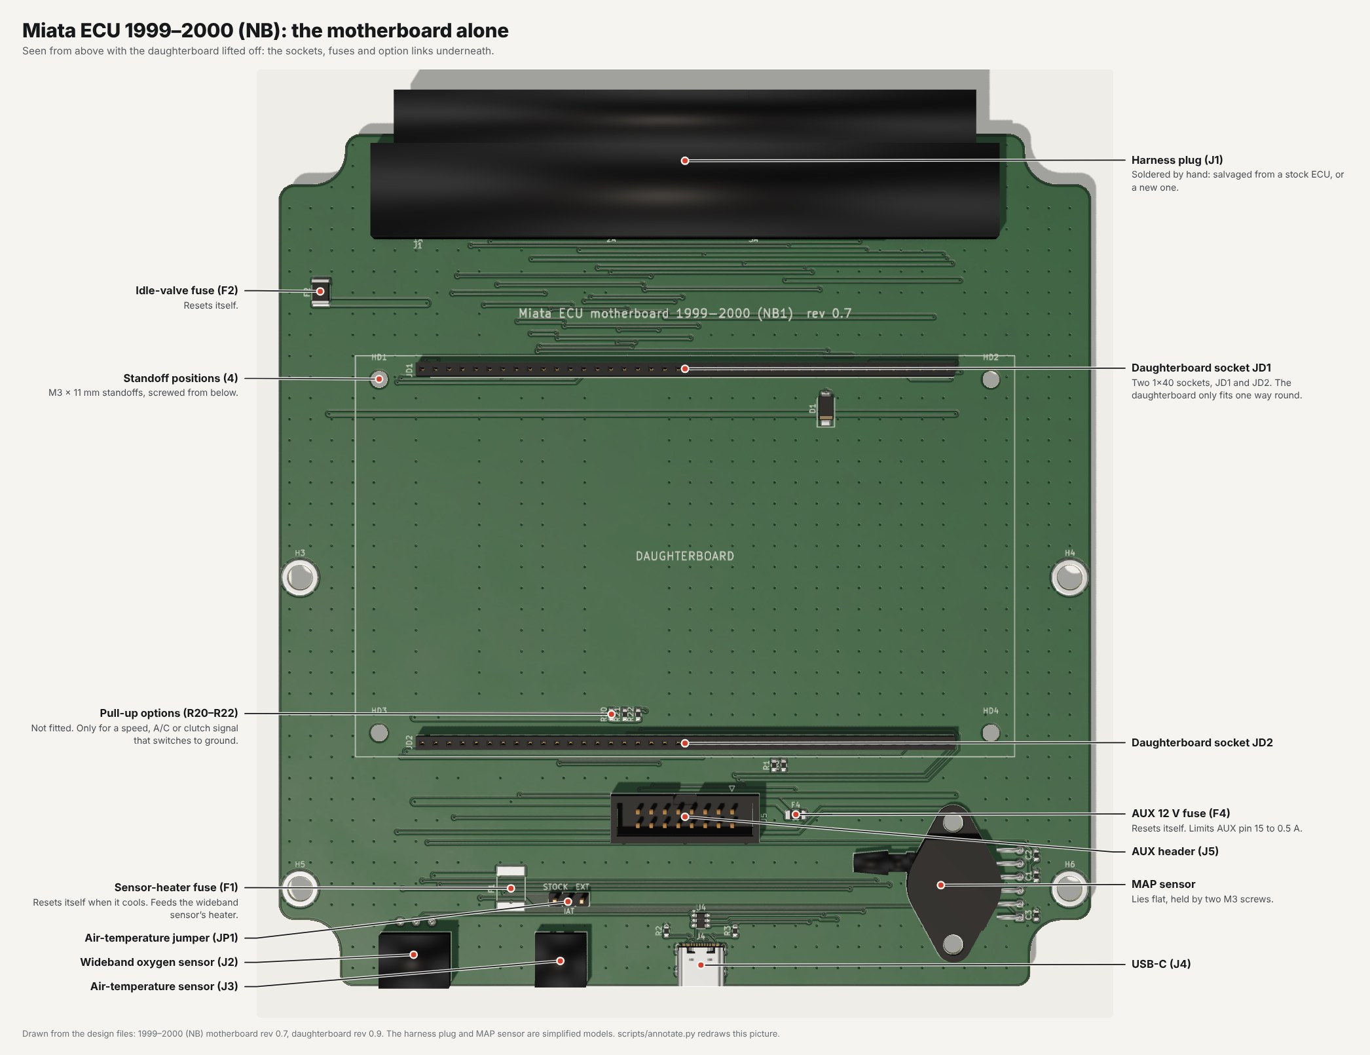
images/annotated_motherboard_1999-2000.jpg
