v3ai/miata-ecus/motherboards/1989-93/renders/bottom_copper.png

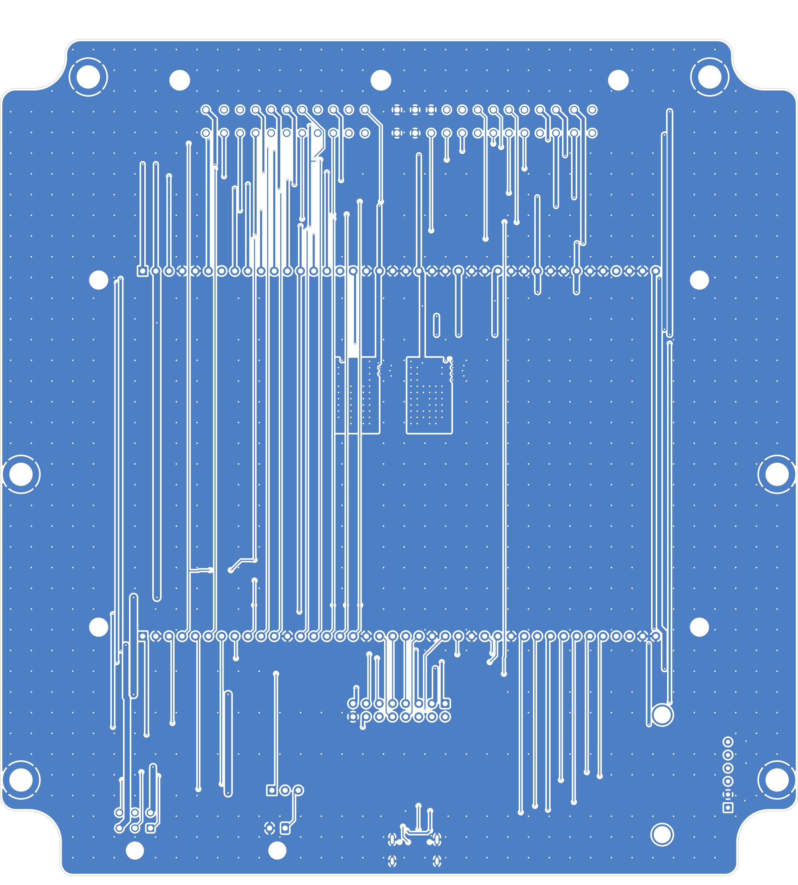
motherboards/1989-93/renders/bottom_copper.png
