v3ai/miata-ecus/motherboards/1989-93/renders/top_copper_silk.png

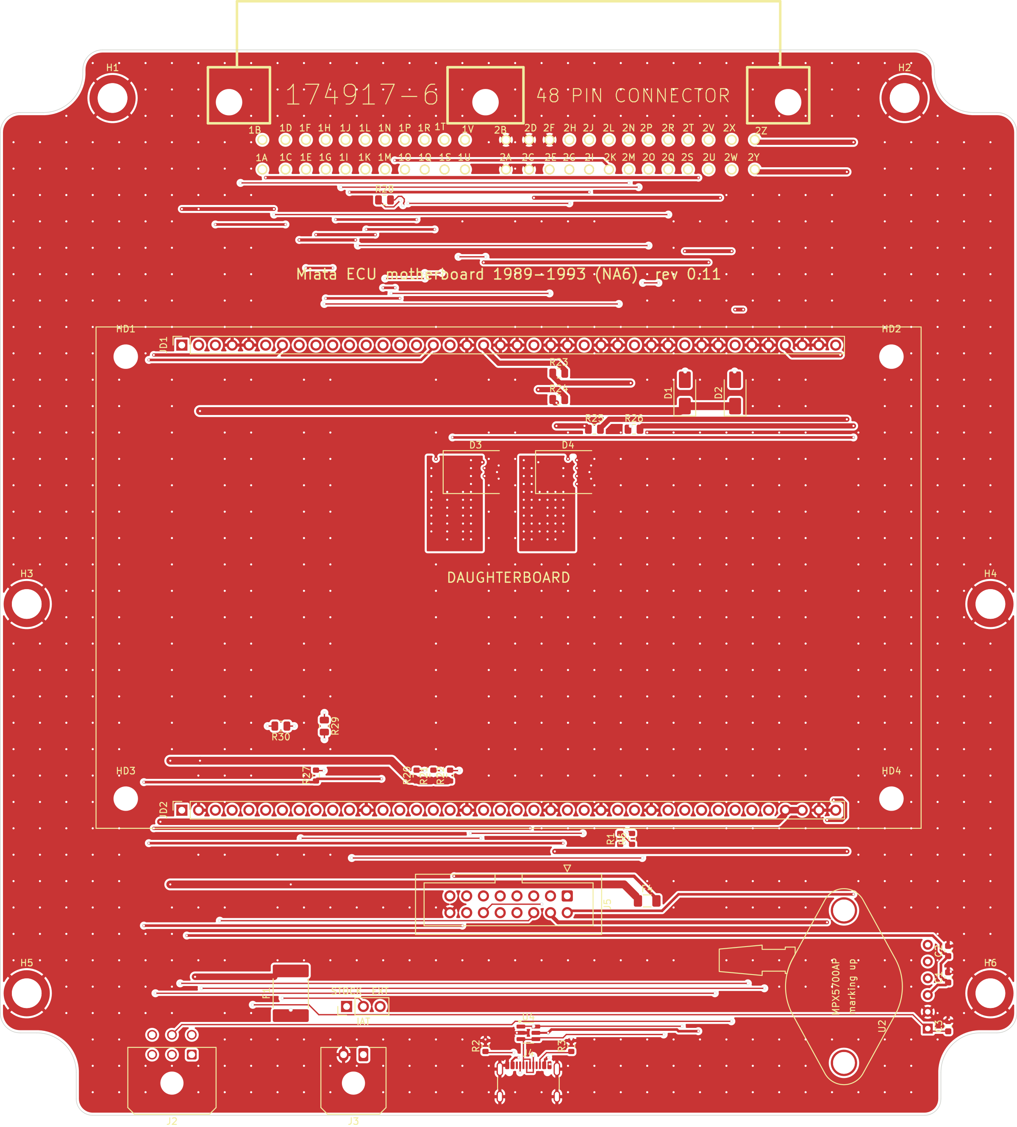
motherboards/1989-93/renders/top_copper_silk.png
