v3ai/miata-ecus/motherboards/1994-95/renders/bottom_copper.png

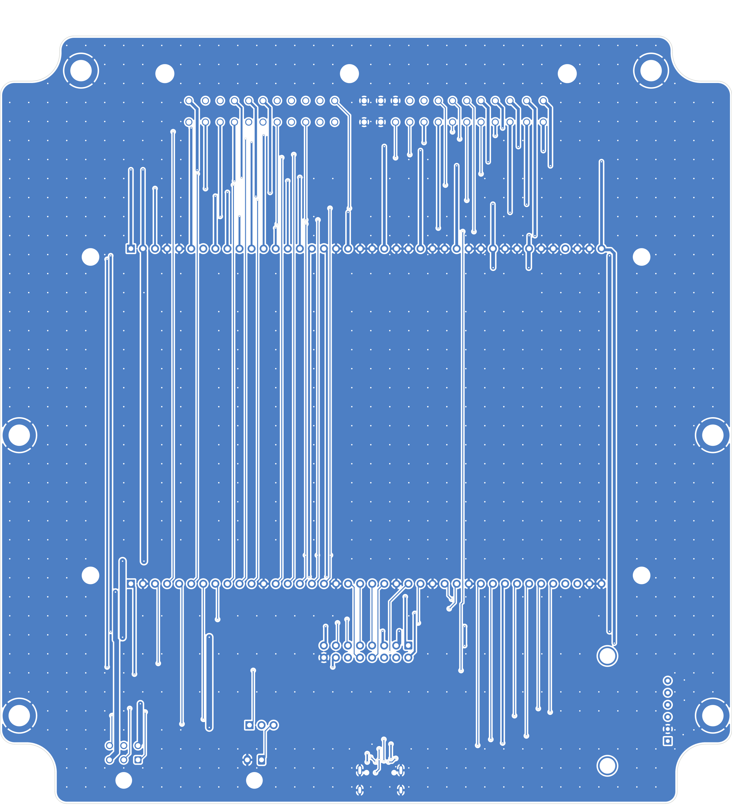
motherboards/1994-95/renders/bottom_copper.png
