v3ai/miata-ecus/motherboards/1996-97/renders/bottom_copper.png

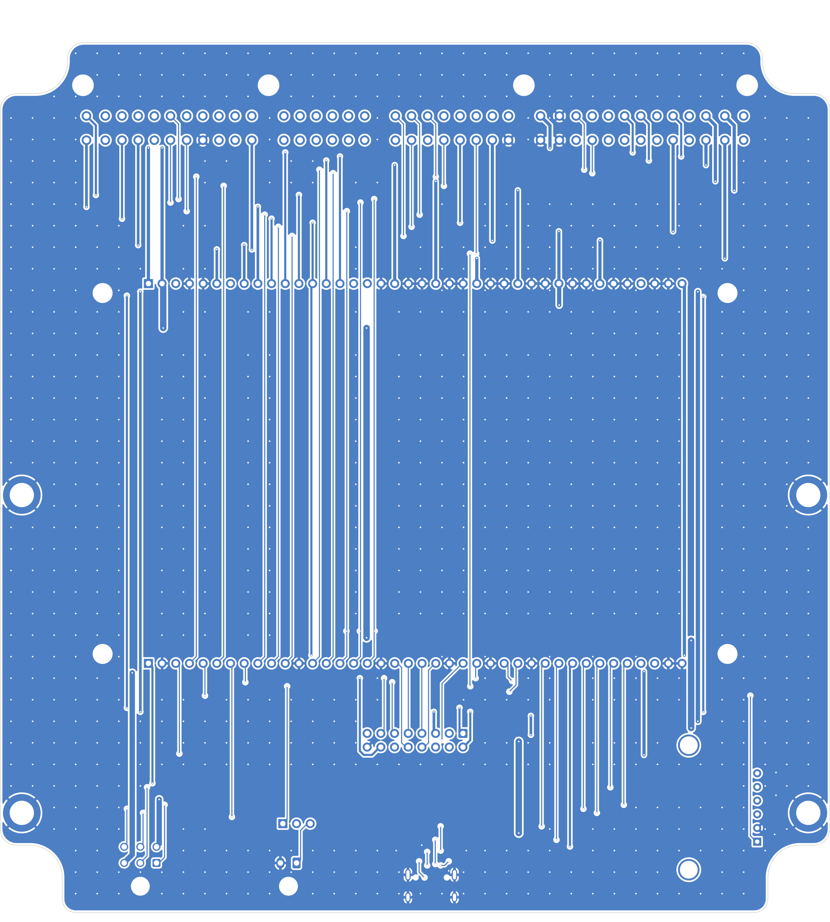
motherboards/1996-97/renders/bottom_copper.png
