v3ai/miata-ecus/motherboards/1996-97/renders/top_copper_silk.png

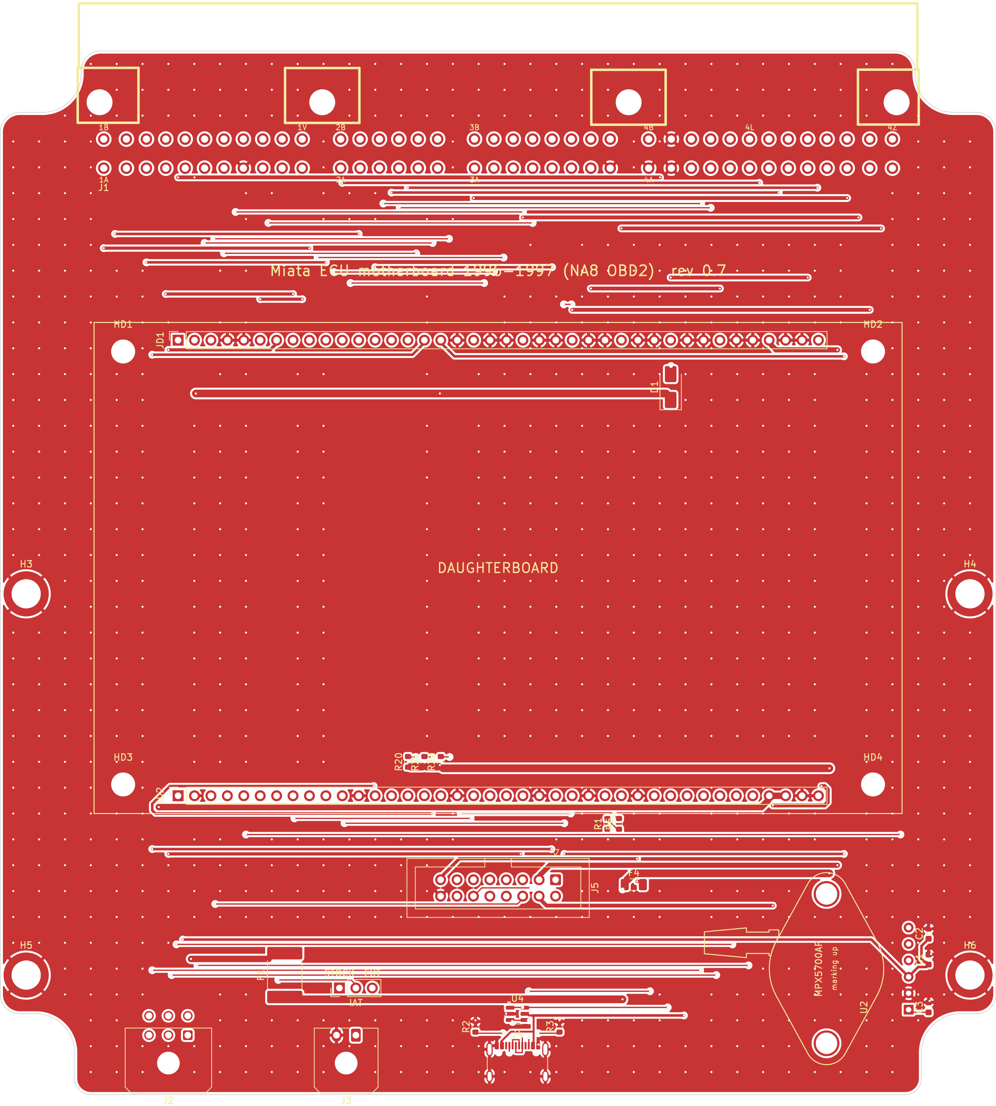
motherboards/1996-97/renders/top_copper_silk.png
