v3ai/miata-ecus/motherboards/1999-2000/renders/bottom_copper.png

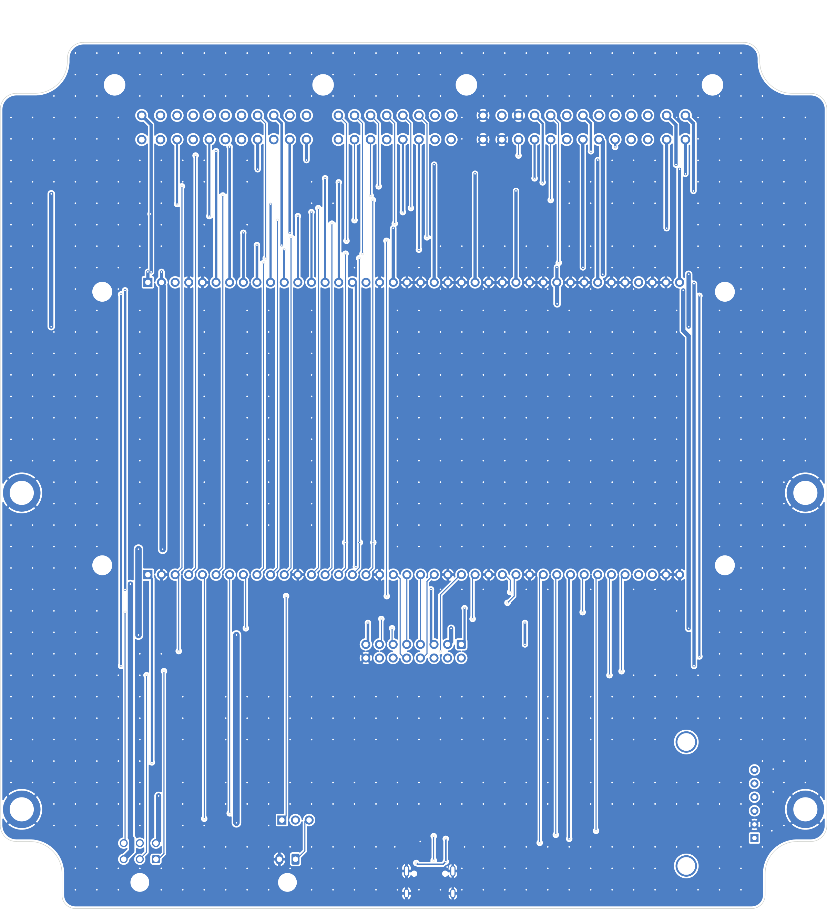
motherboards/1999-2000/renders/bottom_copper.png
