v3ai/miata-ecus/motherboards/1999-2000/renders/top_copper_silk.png

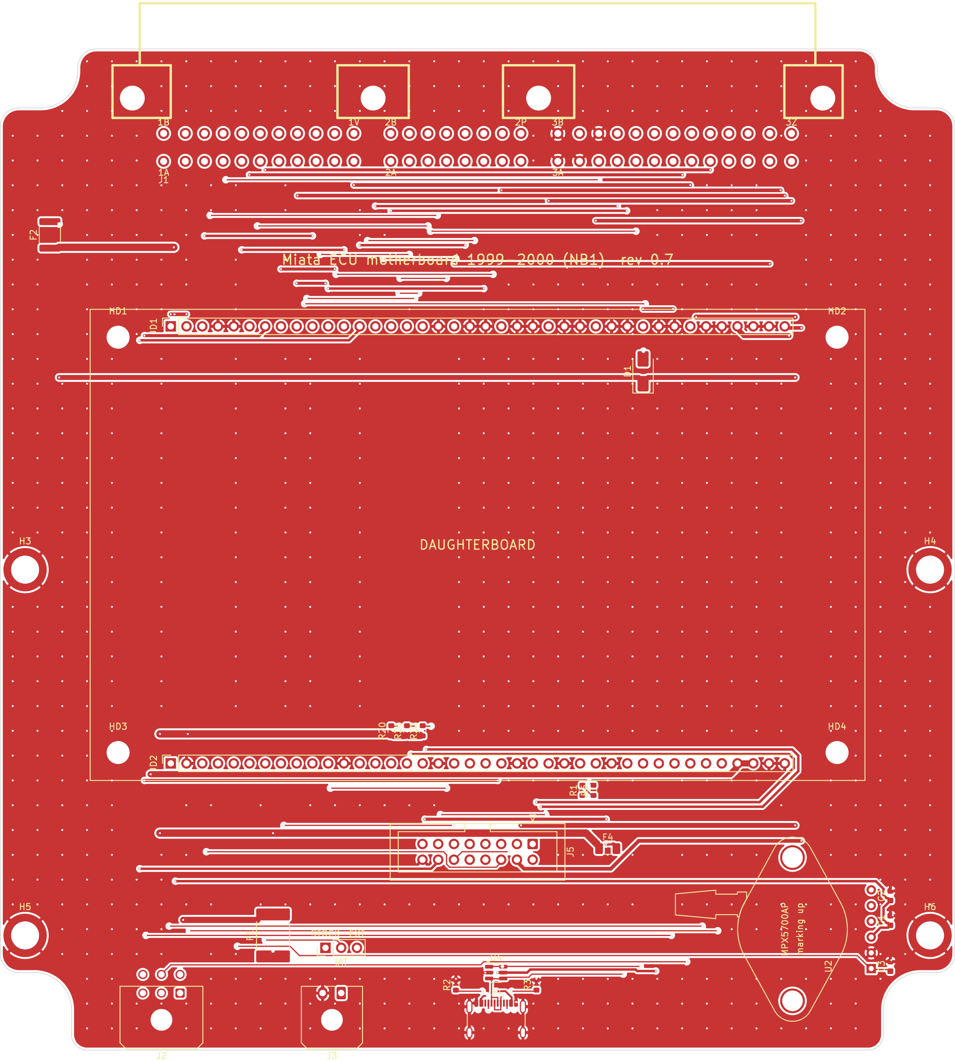
motherboards/1999-2000/renders/top_copper_silk.png
