v3ai/miata-ecus/motherboards/2001-05/renders/bottom_copper.png

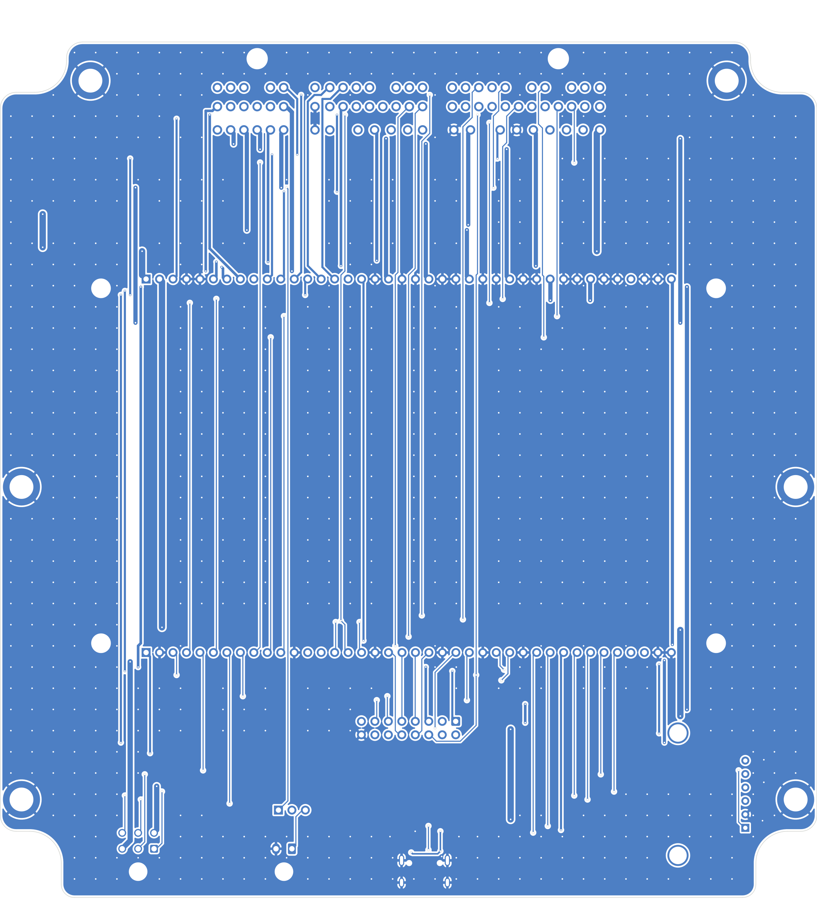
motherboards/2001-05/renders/bottom_copper.png
