v3ai/miata-ecus/motherboards/2001-05/renders/top_copper_silk.png

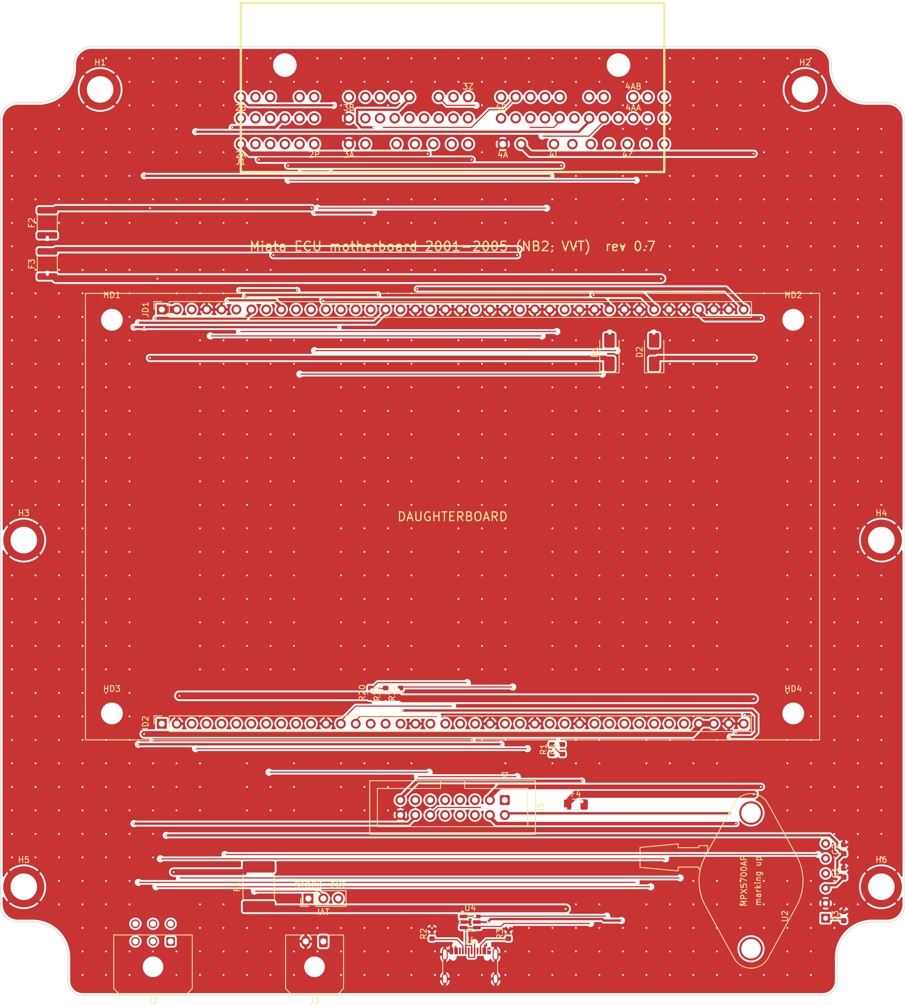
motherboards/2001-05/renders/top_copper_silk.png
