v3ai/miata-ecus/ordered-boards/2026-11/images/header_pinouts.png

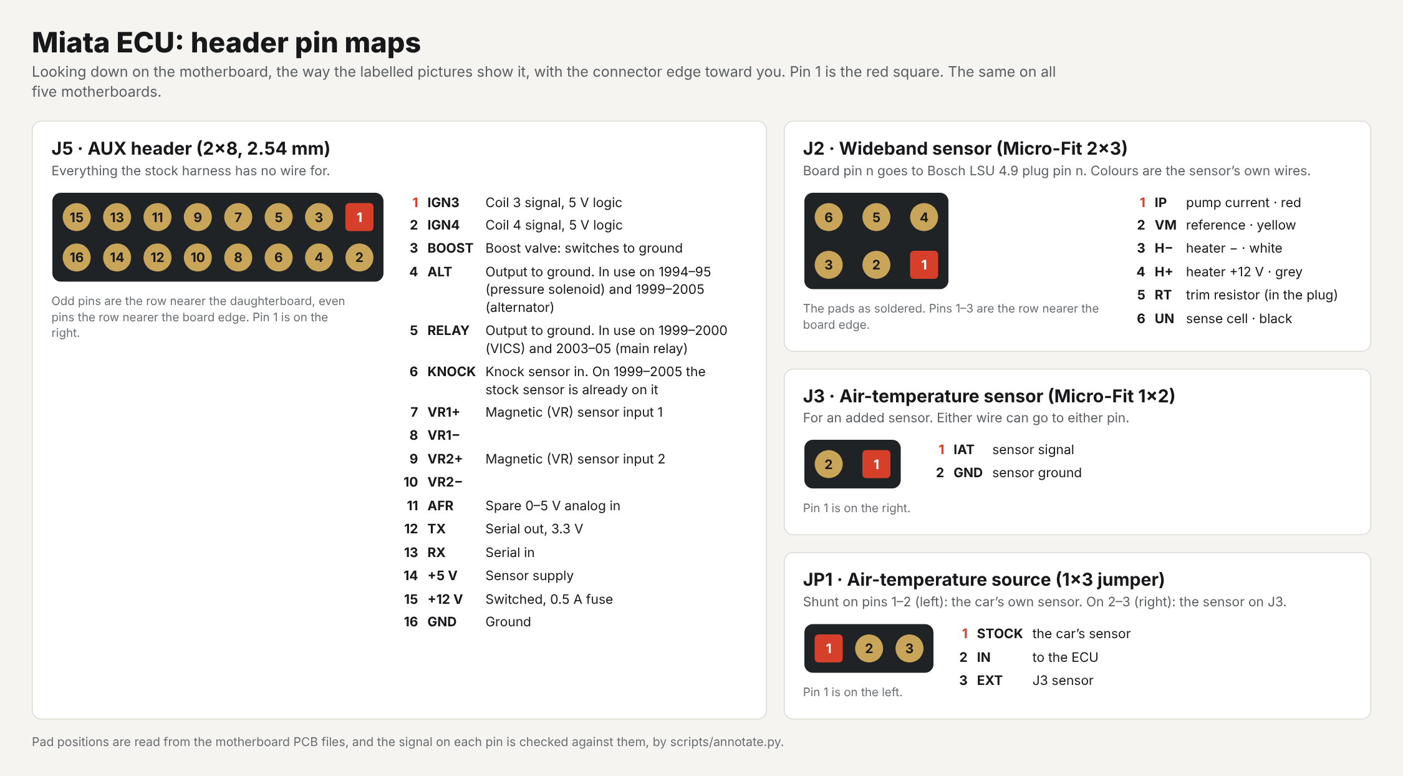
ordered-boards/2026-11/images/header_pinouts.png
