v3ai/miata-ecus/viewer/bottom_albedo.webp

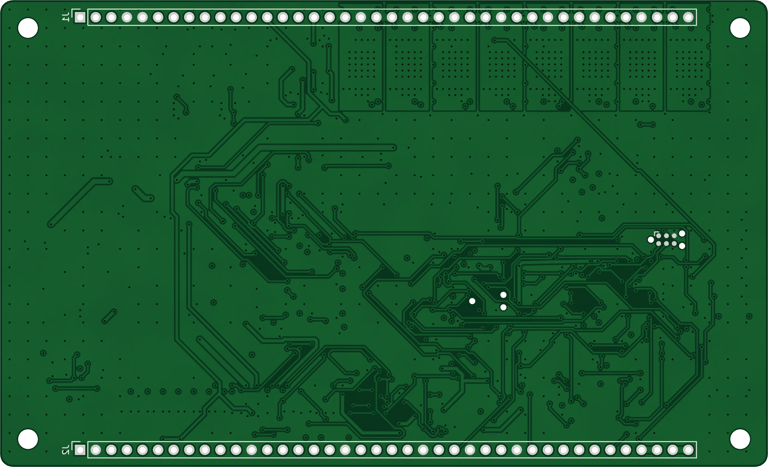
viewer/bottom_albedo.webp
