v3ai/miata-ecus/viewer/bottom_normal.webp

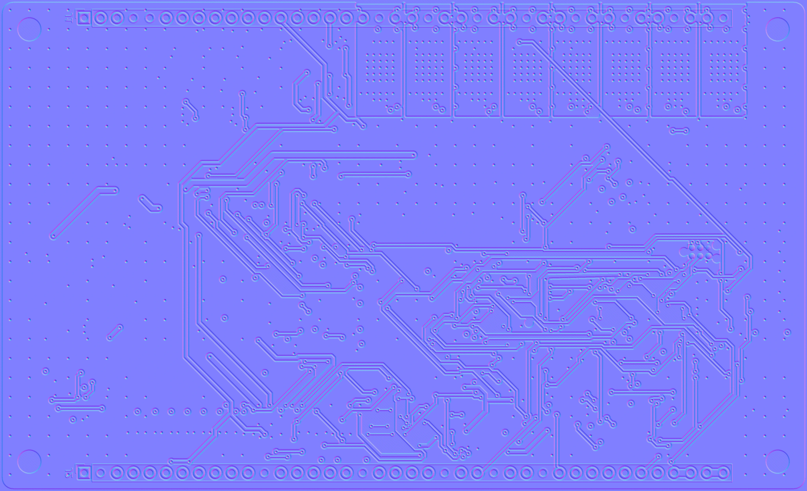
viewer/bottom_normal.webp
