v3ai/miata-ecus/viewer/bottom_orm.webp

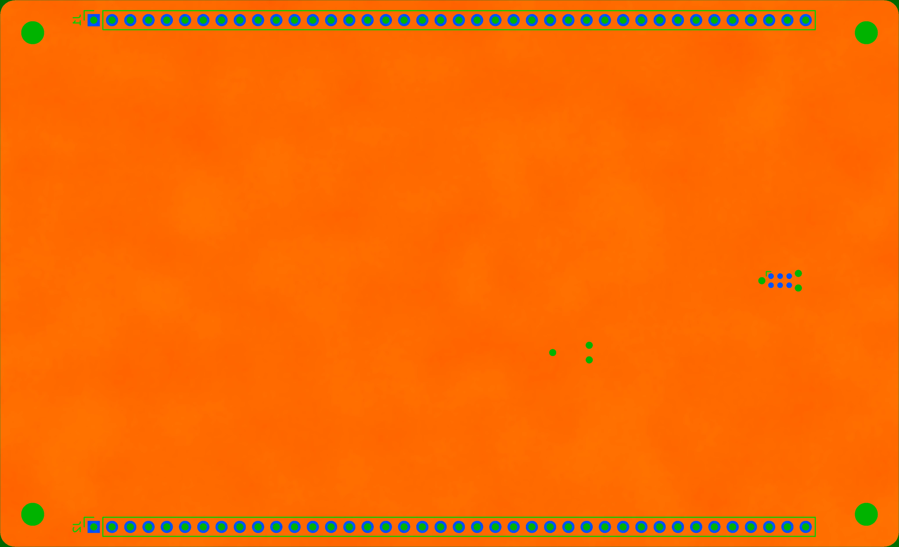
viewer/bottom_orm.webp
