v3ai/miata-ecus/viewer/mb0105_bottom_albedo.webp

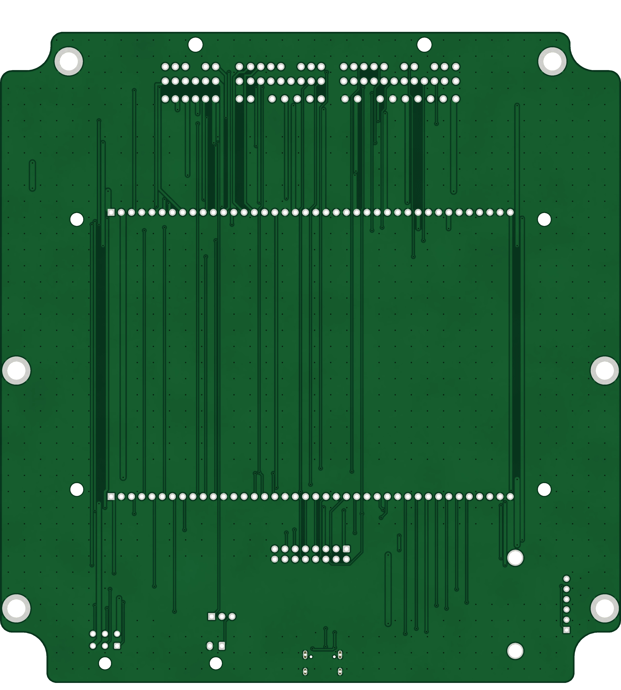
viewer/mb0105_bottom_albedo.webp
