v3ai/miata-ecus/viewer/mb0105_bottom_normal.webp

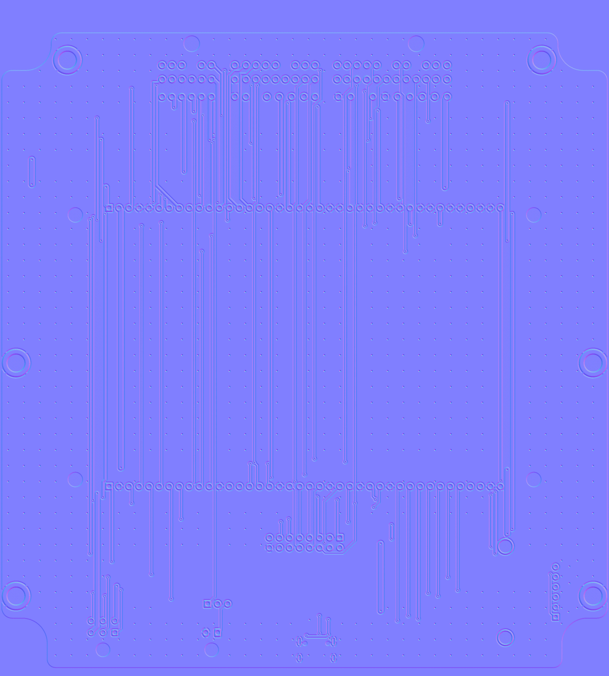
viewer/mb0105_bottom_normal.webp
