v3ai/miata-ecus/viewer/mb0105_bottom_orm.webp

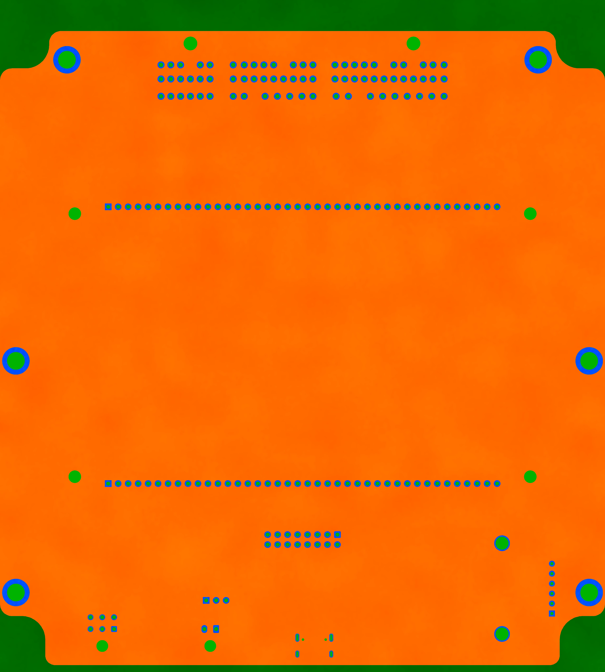
viewer/mb0105_bottom_orm.webp
