v3ai/miata-ecus/viewer/mb0105_top_albedo.webp

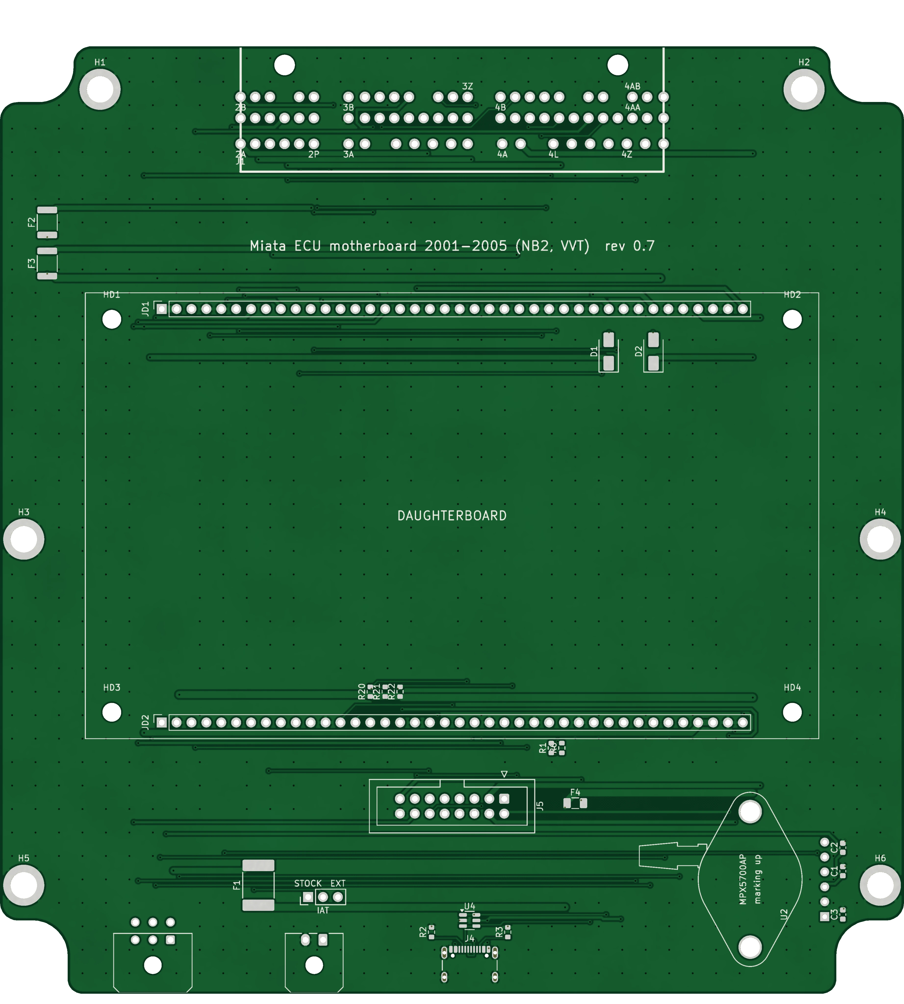
viewer/mb0105_top_albedo.webp
