v3ai/miata-ecus/viewer/mb0105_top_orm.webp

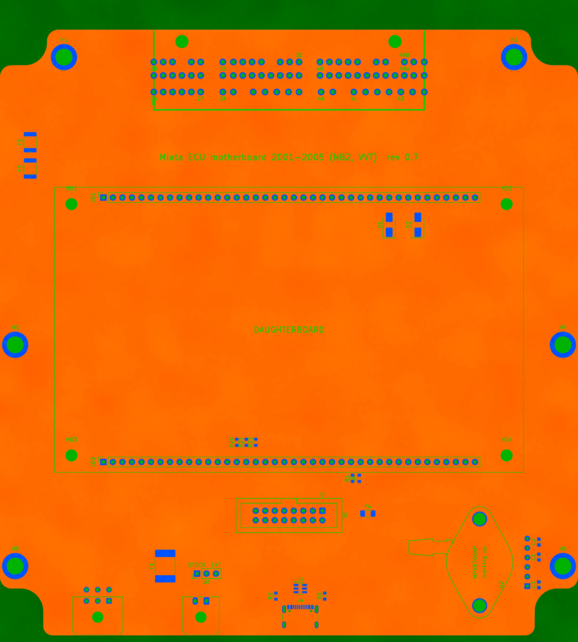
viewer/mb0105_top_orm.webp
