v3ai/miata-ecus/viewer/mb8993_bottom_albedo.webp

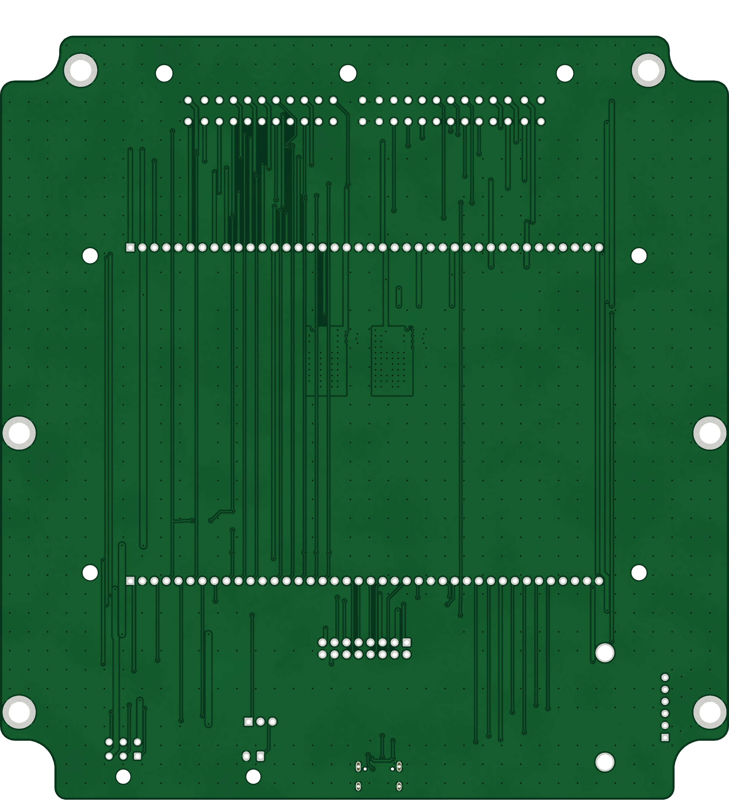
viewer/mb8993_bottom_albedo.webp
