v3ai/miata-ecus/viewer/mb8993_bottom_normal.webp

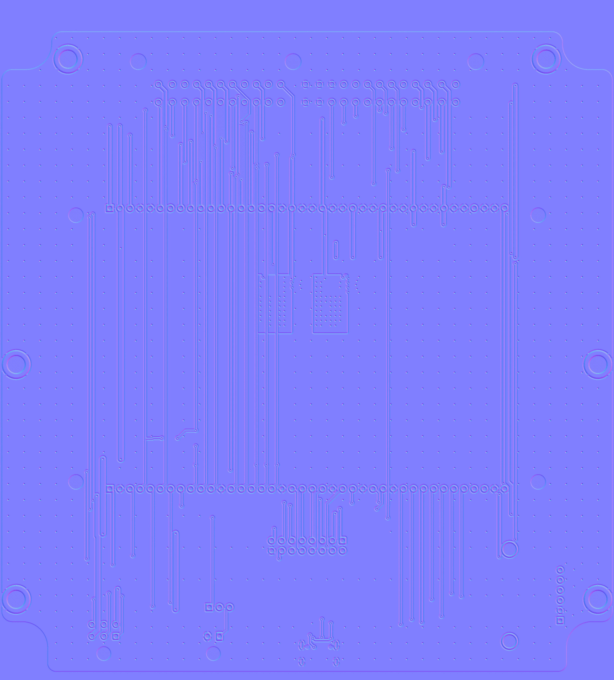
viewer/mb8993_bottom_normal.webp
