v3ai/miata-ecus/viewer/mb8993_bottom_orm.webp

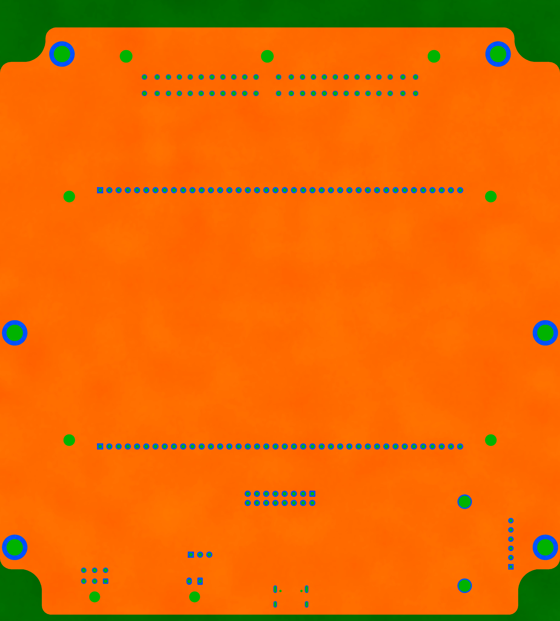
viewer/mb8993_bottom_orm.webp
