v3ai/miata-ecus/viewer/mb8993_top_albedo.webp

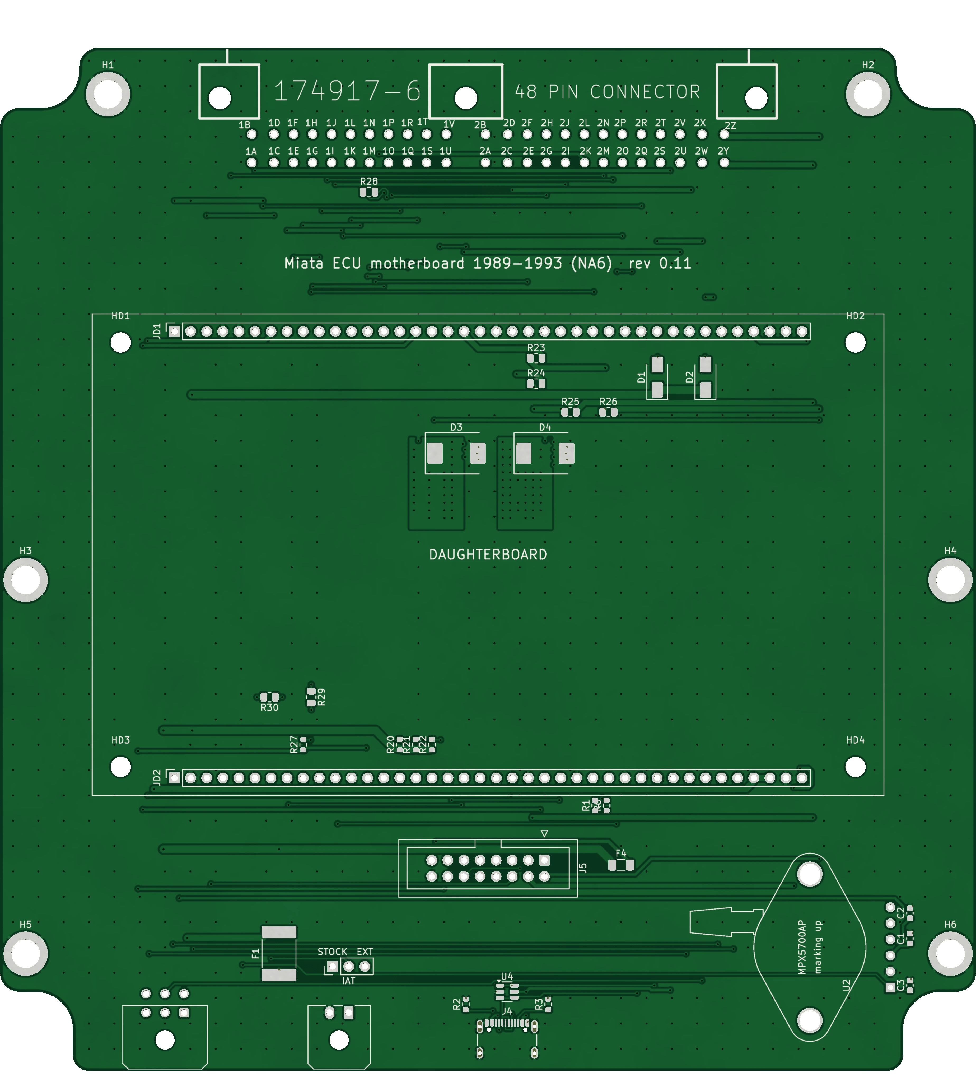
viewer/mb8993_top_albedo.webp
