v3ai/miata-ecus/viewer/mb8993_top_orm.webp

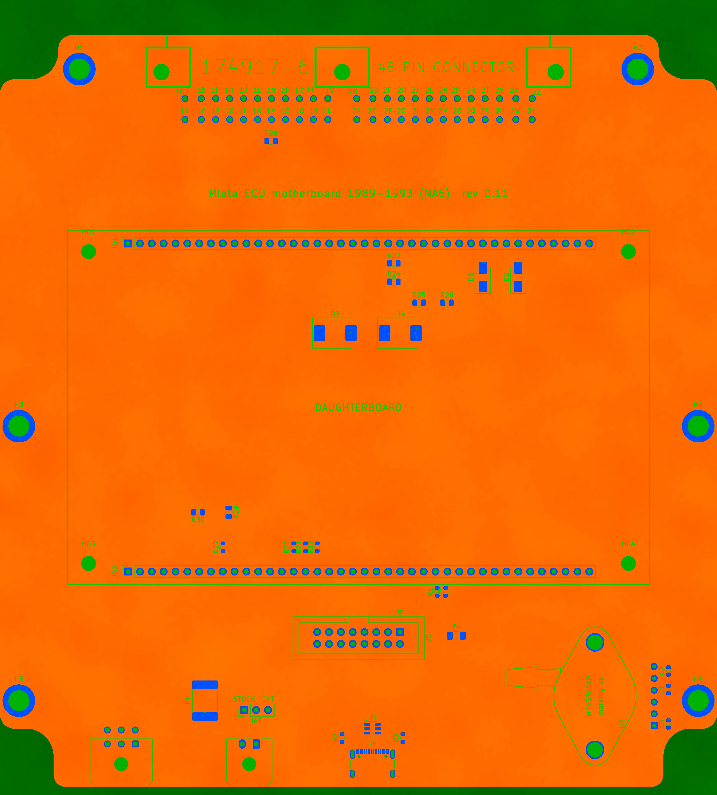
viewer/mb8993_top_orm.webp
