v3ai/miata-ecus/viewer/mb9495_bottom_albedo.webp

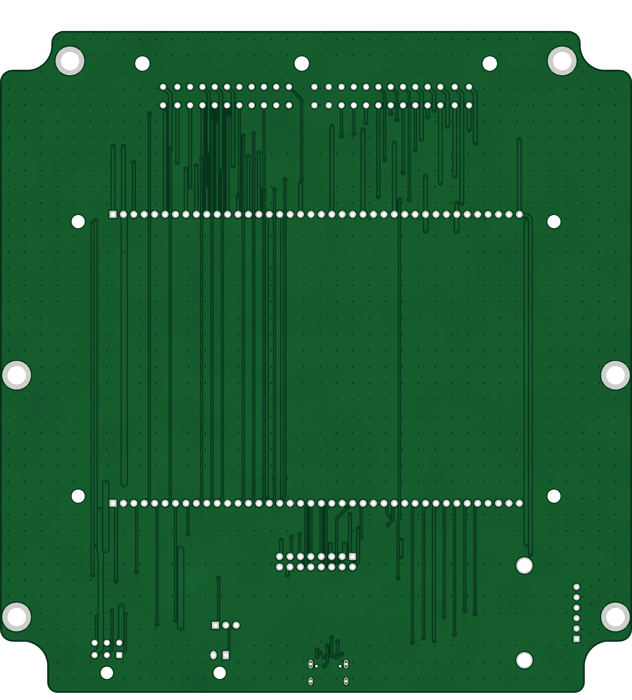
viewer/mb9495_bottom_albedo.webp
