v3ai/miata-ecus/viewer/mb9495_bottom_orm.webp

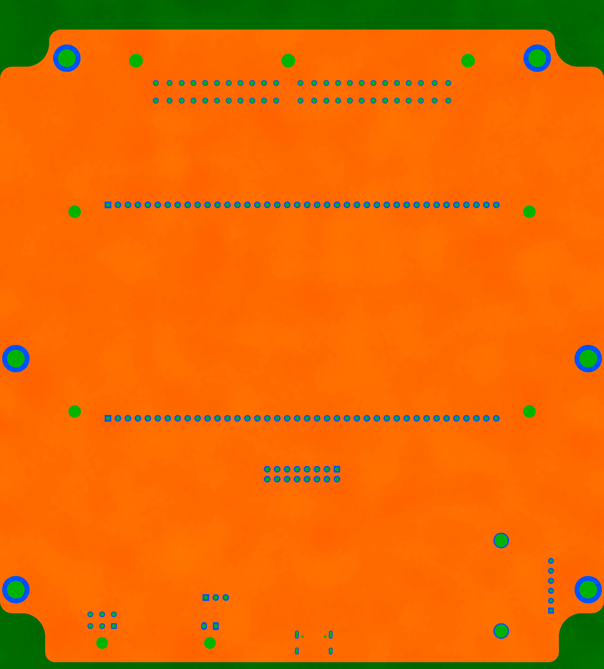
viewer/mb9495_bottom_orm.webp
