v3ai/miata-ecus/viewer/mb9495_top_albedo.webp

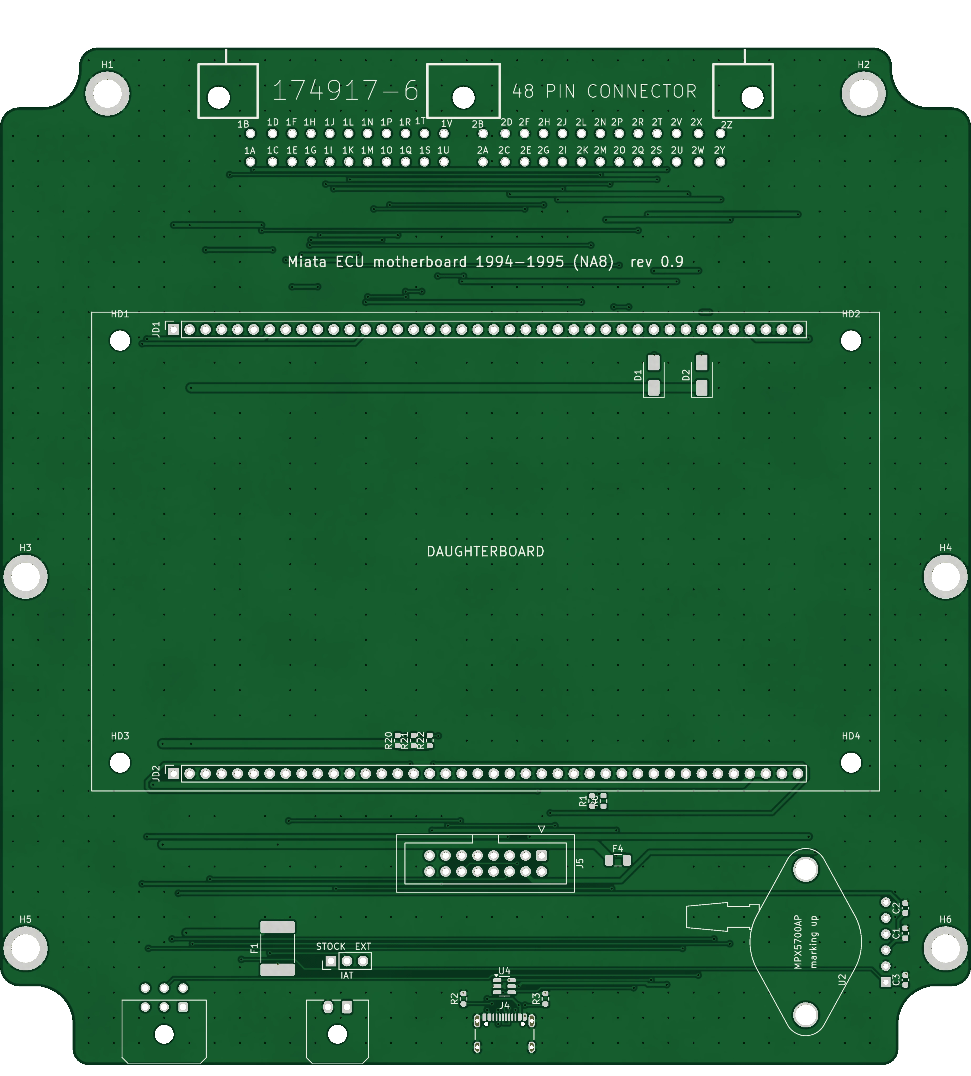
viewer/mb9495_top_albedo.webp
