v3ai/miata-ecus/viewer/mb9495_top_orm.webp

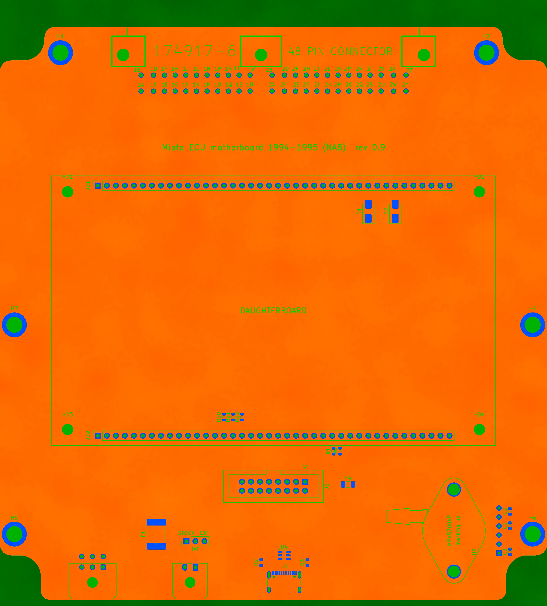
viewer/mb9495_top_orm.webp
