v3ai/miata-ecus/viewer/mb9697_bottom_albedo.webp

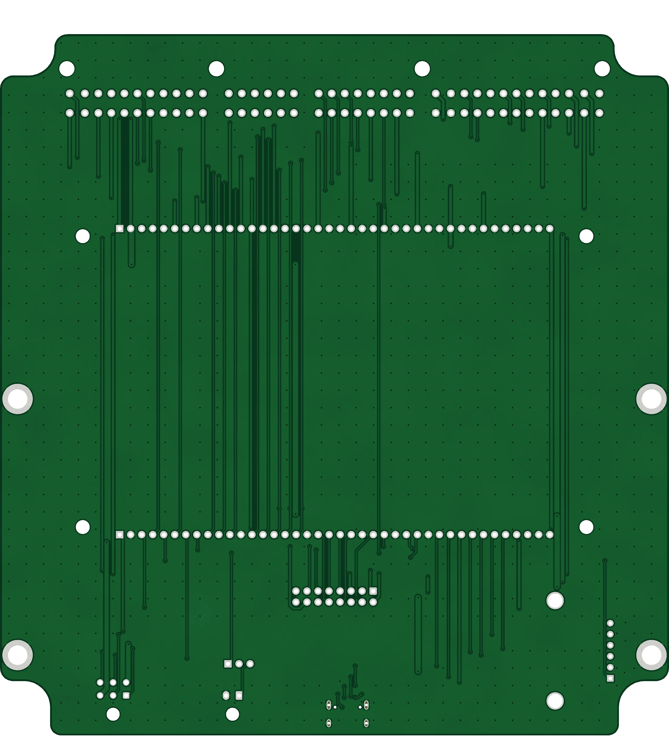
viewer/mb9697_bottom_albedo.webp
