v3ai/miata-ecus/viewer/mb9697_bottom_orm.webp

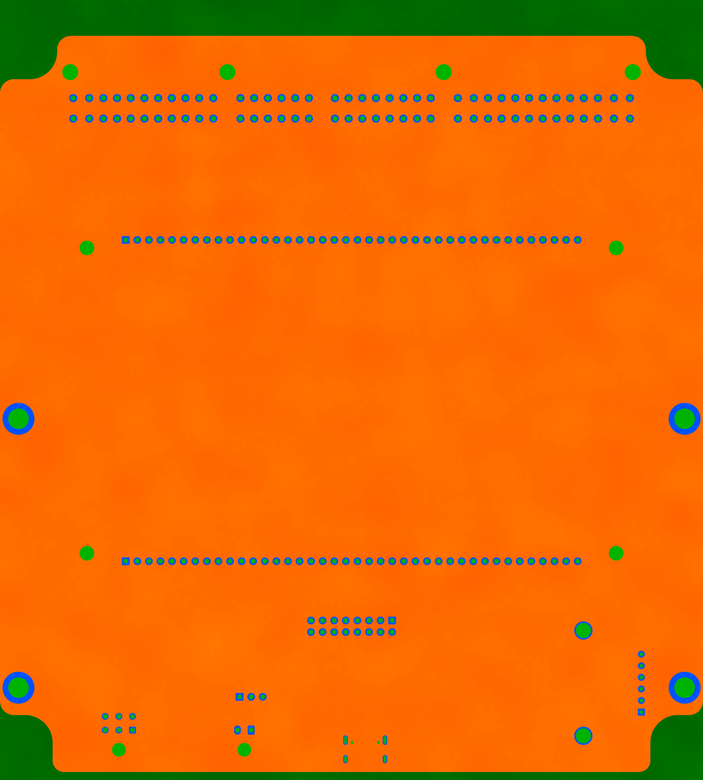
viewer/mb9697_bottom_orm.webp
