v3ai/miata-ecus/viewer/mb9697_top_albedo.webp

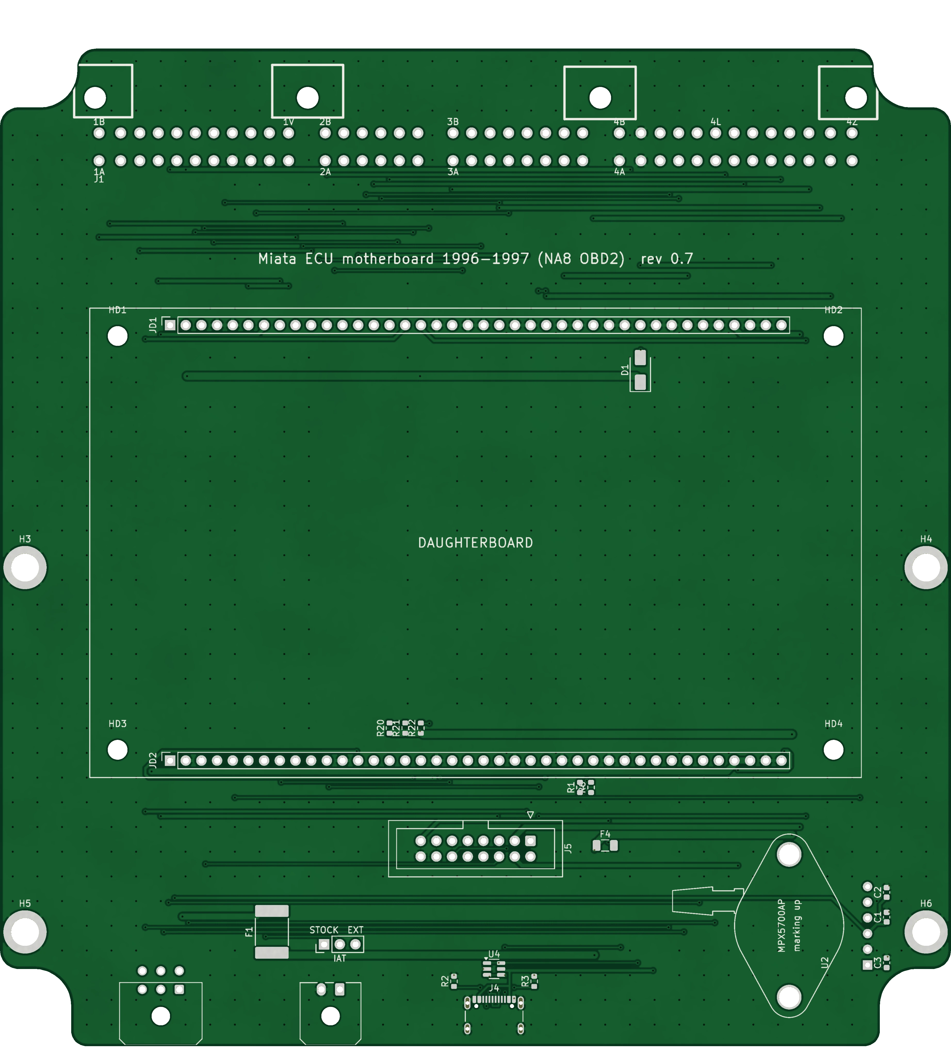
viewer/mb9697_top_albedo.webp
