v3ai/miata-ecus/viewer/mb9900_bottom_albedo.webp

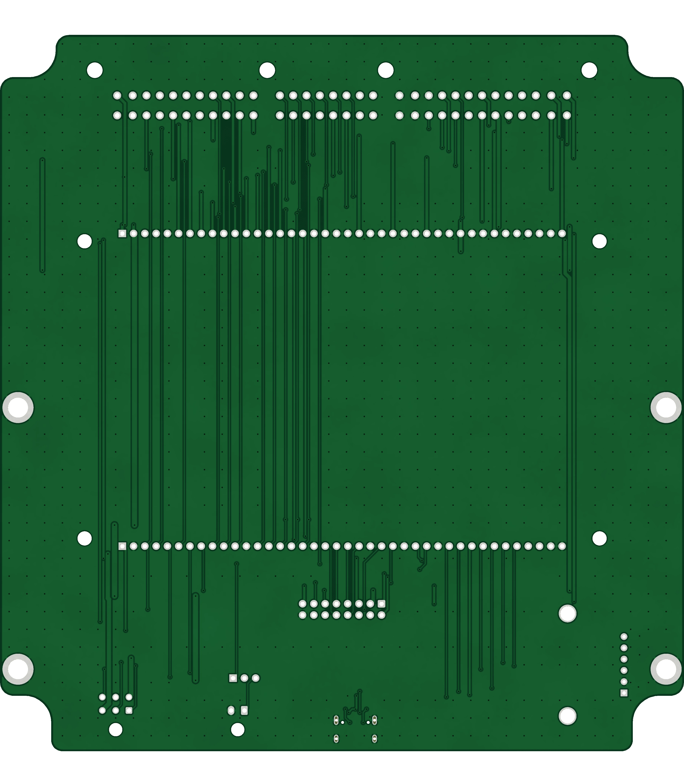
viewer/mb9900_bottom_albedo.webp
