v3ai/miata-ecus/viewer/mb9900_bottom_orm.webp

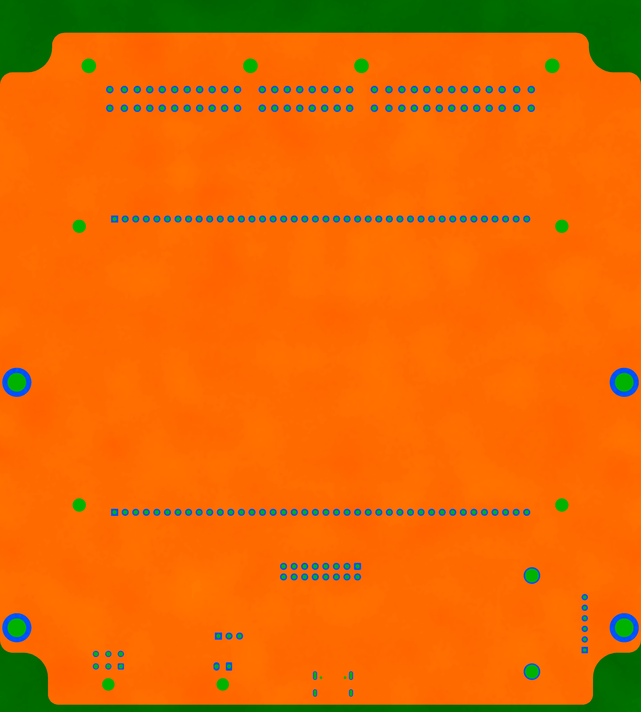
viewer/mb9900_bottom_orm.webp
