v3ai/miata-ecus/viewer/mb9900_top_albedo.webp

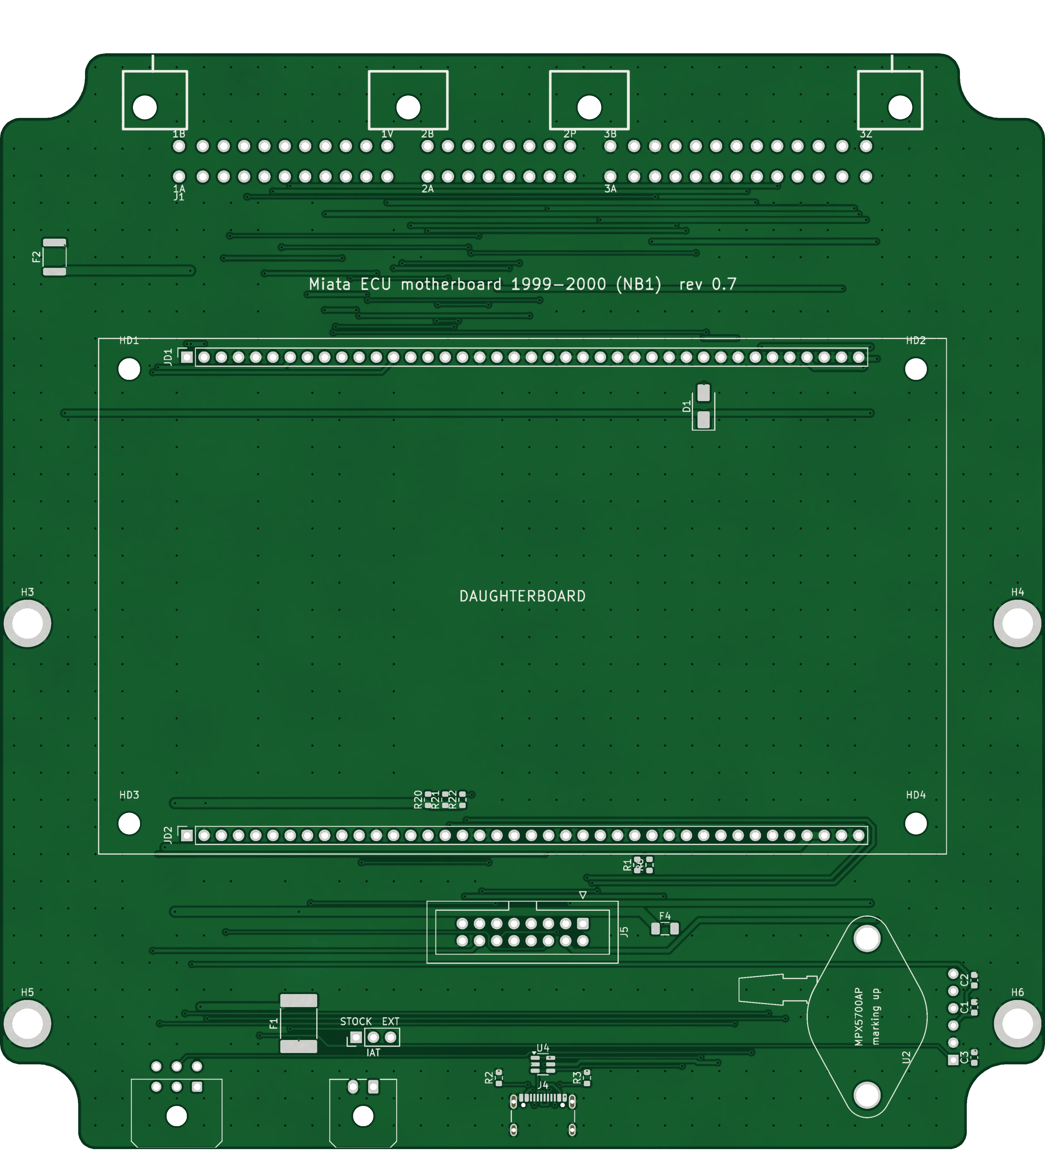
viewer/mb9900_top_albedo.webp
