v3ai/miata-ecus/viewer/mb9900_top_orm.webp

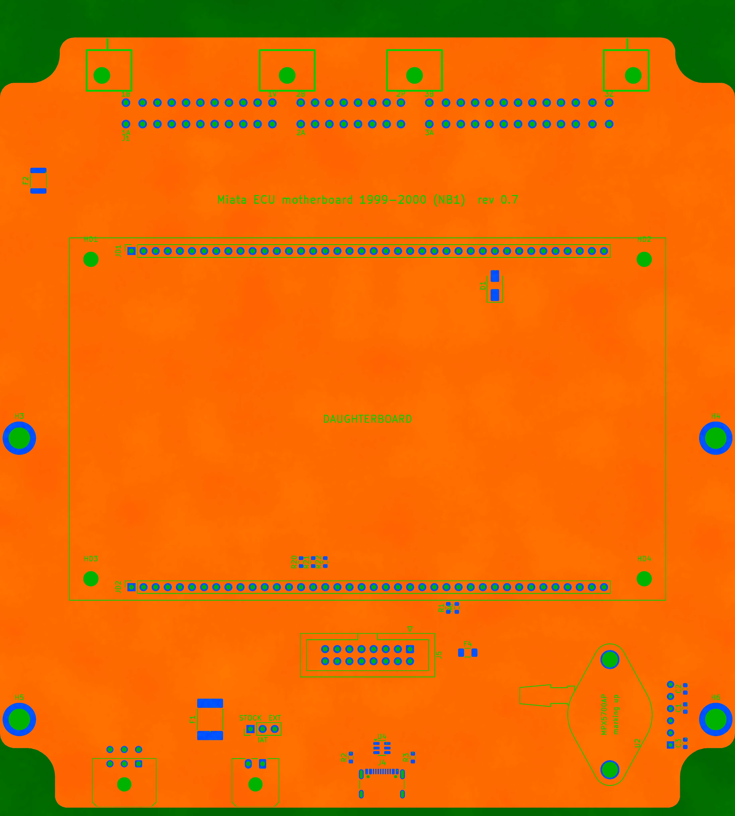
viewer/mb9900_top_orm.webp
