v3ai/miata-ecus/viewer/top_albedo.webp

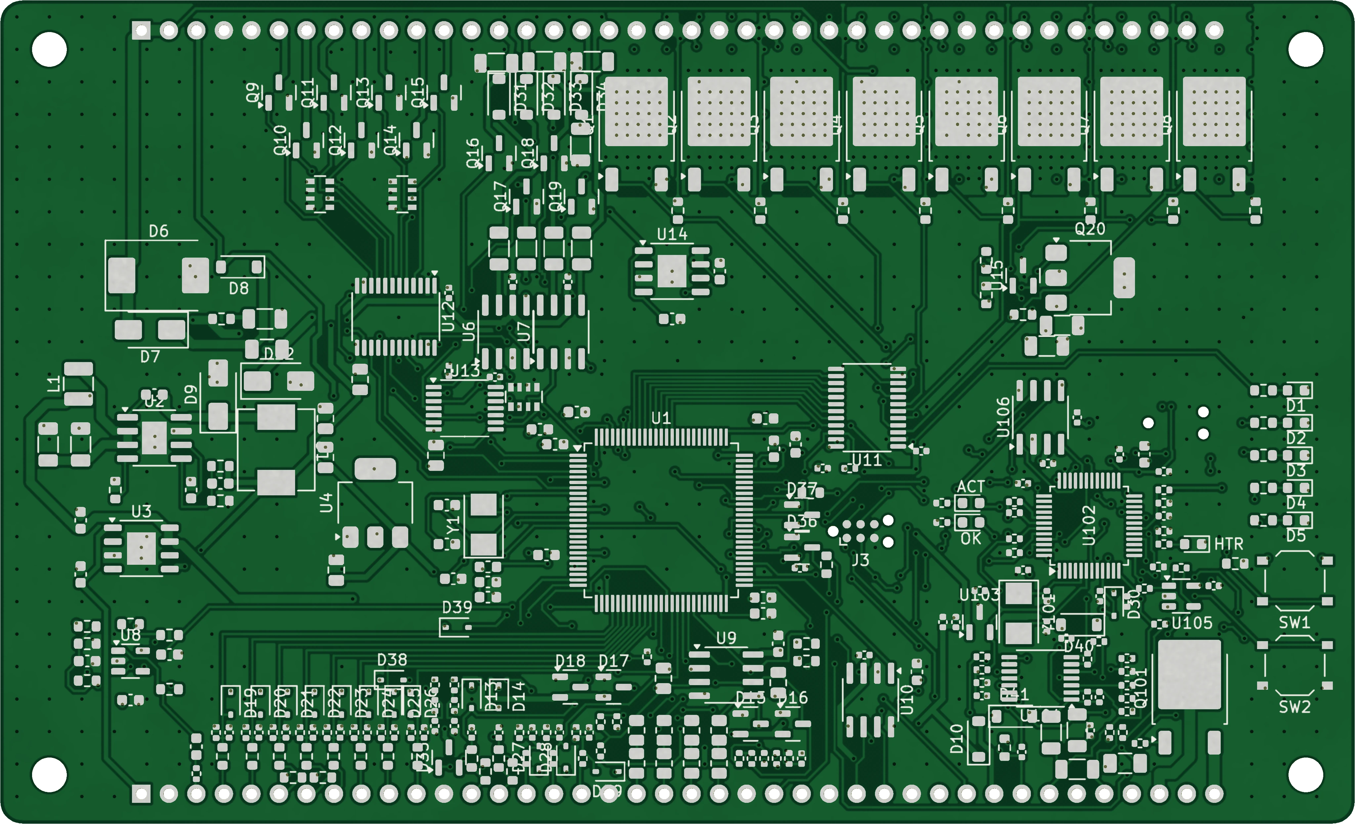
viewer/top_albedo.webp
