v3ai/miata-ecus/viewer/top_normal.webp

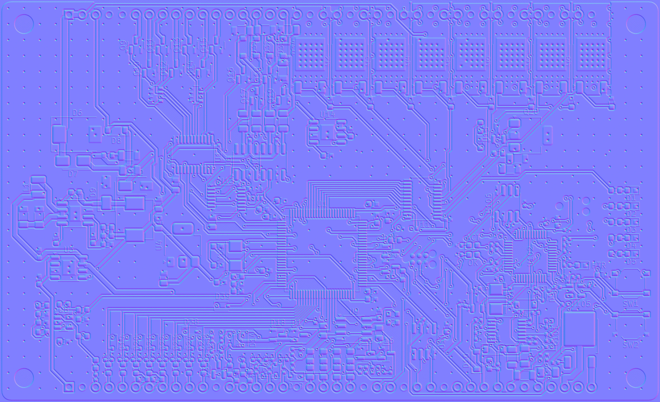
viewer/top_normal.webp
