v3ai/miata-ecus/viewer/top_orm.webp

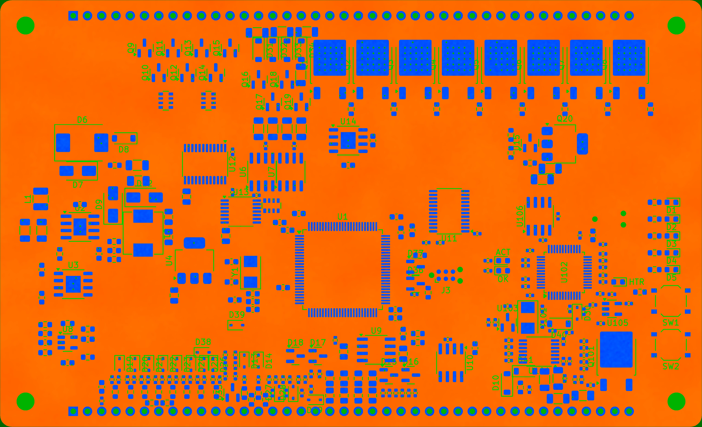
viewer/top_orm.webp
