v3ai/miata-ecus/website/product-images/ecu-0105.jpg

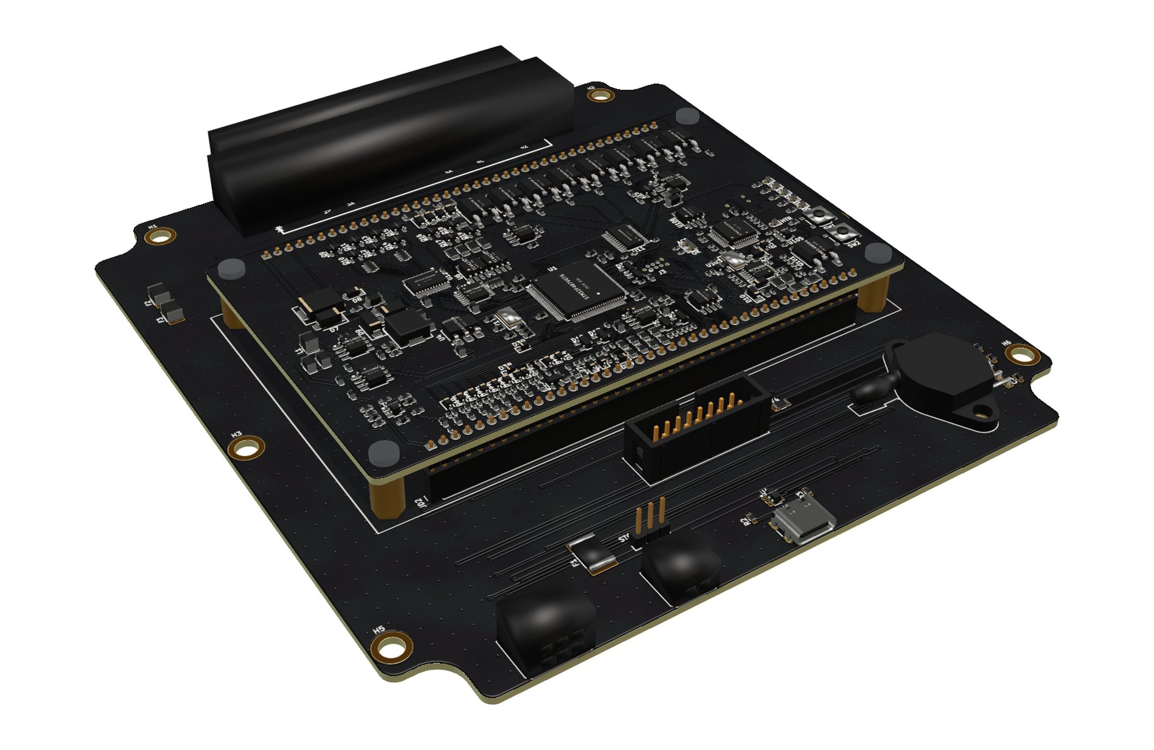
website/product-images/ecu-0105.jpg
