v3ai/miata-ecus/website/product-images/ecu-9697.jpg

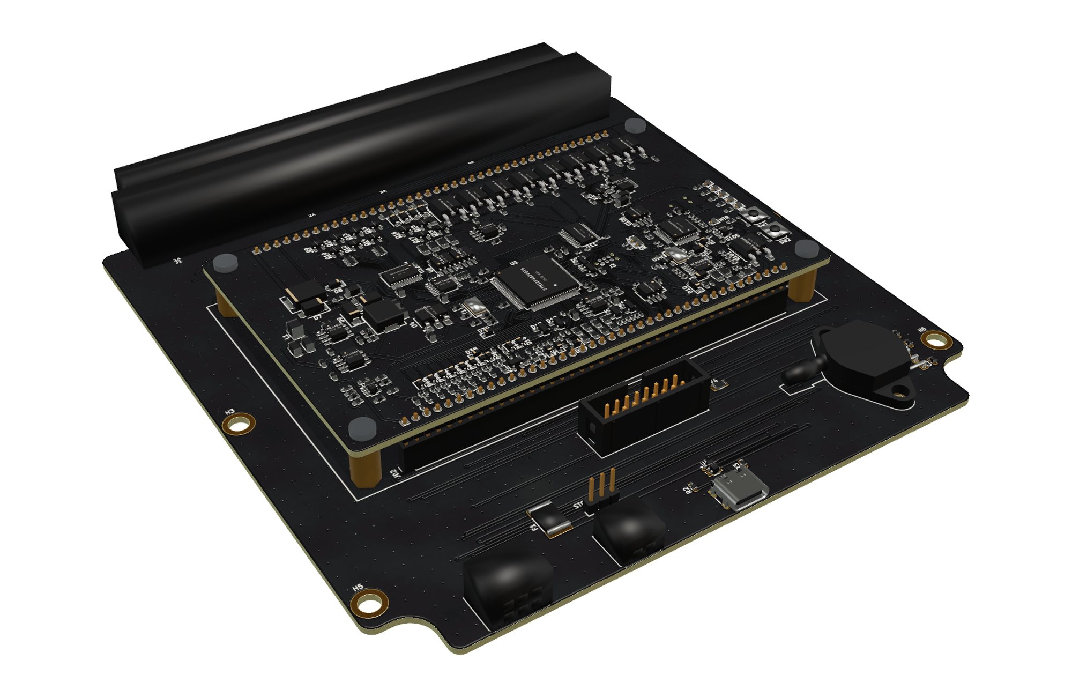
website/product-images/ecu-9697.jpg
