v3ai/miata-ecus/website/product-images/ecu-9900.jpg

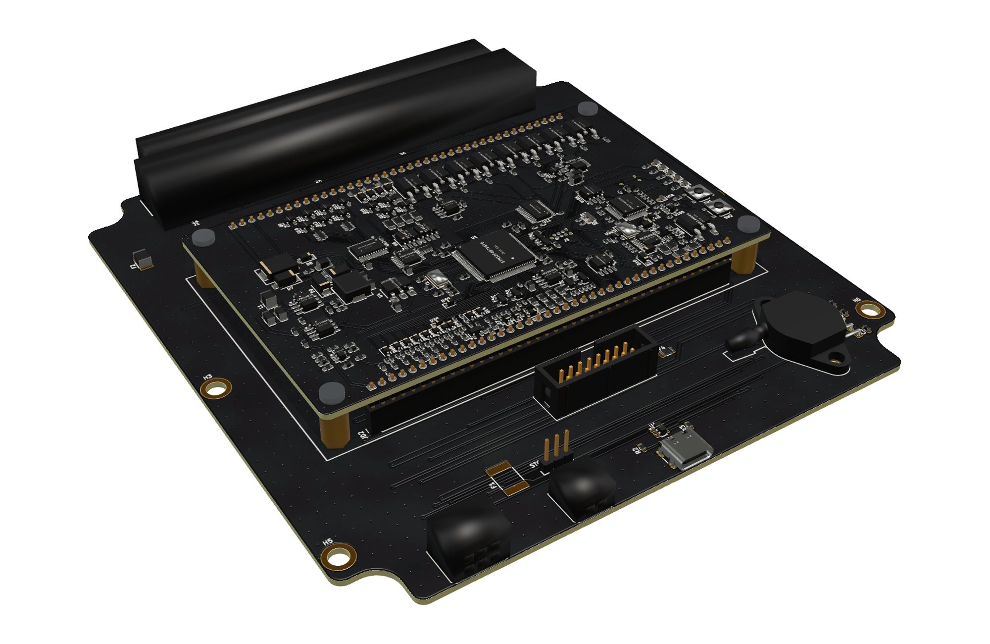
website/product-images/ecu-9900.jpg
