v3ai/miata-ecus/website/product-images/exploded.jpg

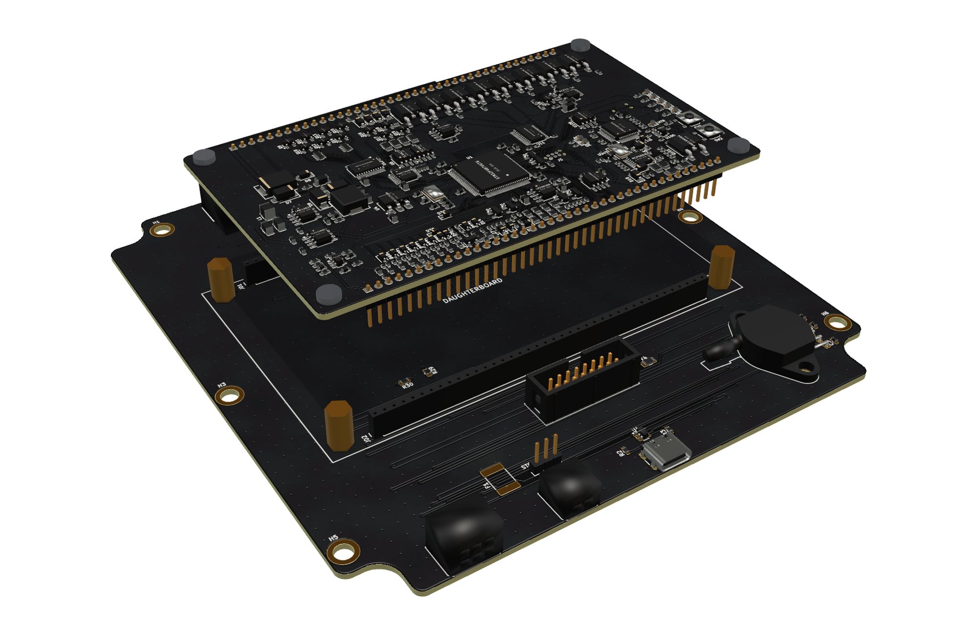
website/product-images/exploded.jpg
