v3ai/miata-ecus/website/theme/assets/render-daughterboard-1200.jpg

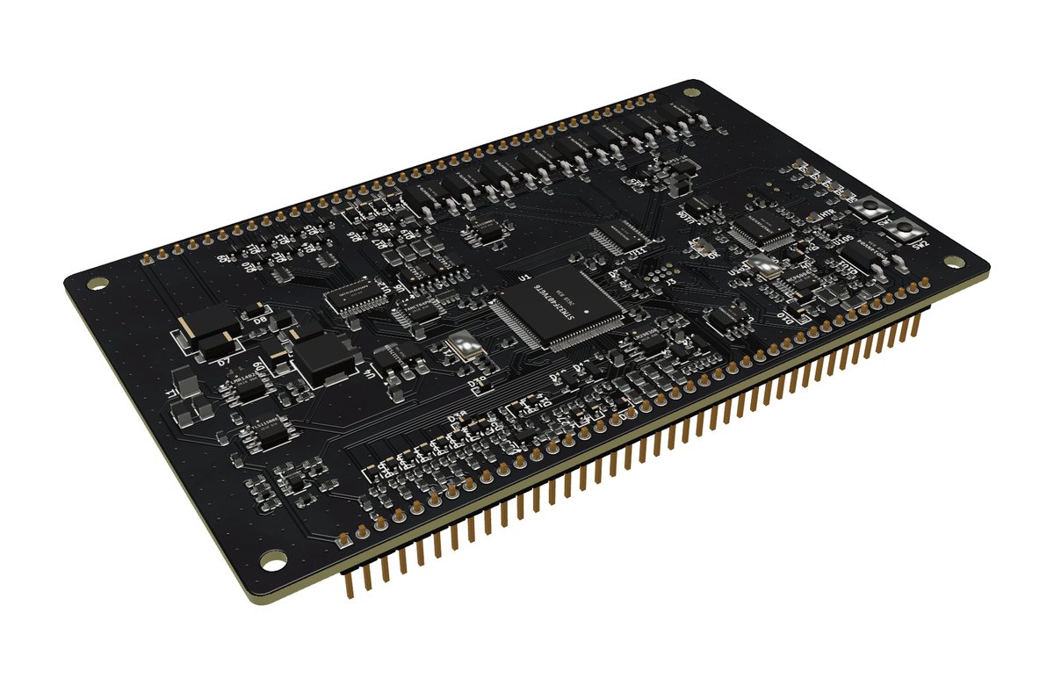
website/theme/assets/render-daughterboard-1200.jpg
