v3ai/miata-ecus/daughterboard/miata_ecu_daughterboard_parts.xlsx

Sheet: Parts List
Group | Qty | Value | Description | Designators | Footprint | LCSC # | JLC type | Notes | Manufacturer | MPN
MCU & support
MCU & support | 7 | 100n |  | C1, C2, C3, C5, C6, C12, C15 | C_0603_1608Metric | C14663 | Basic |  | YAGEO | CC0603KRX7R9BB104
MCU & support | 1 | 100n |  | C4 | C_0402_1005Metric | C1525 | Basic |  | Samsung Electro-Mechanics | CL05B104KO5NNNC
MCU & support | 1 | 10k |  | R1 | R_0603_1608Metric | C25804 | Basic |  | UNI-ROYAL(Uniroyal Elec) | 0603WAF1002T5E
MCU & support | 1 | 1u |  | C11 | C_0603_1608Metric | C15849 | Basic |  | Samsung Electro-Mechanics | CL10A105KB8NNNC
MCU & support | 2 | 2.2u |  | C9, C10 | C_0603_1608Metric | C23630 | Basic |  | Samsung Electro-Mechanics | CL10A225KO8NNNC
MCU & support | 2 | 33p |  | C13, C14 | C_0603_1608Metric | C1663 | Extended |  | Samsung Electro-Mechanics | CL10C330JB8NNNC
MCU & support | 2 | 4.7u |  | C7, C8 | C_0603_1608Metric | C19666 | Basic |  | Samsung Electro-Mechanics | CL10A475KO8NNNC
MCU & support | 1 | 8MHz | 8MHz crystal 5032, 20pF (YXC X50328MSB2GI) | Y1 | Crystal_SMD_5032-2Pin_5.0x3.2mm | C115962 | Extended |  | YXC Crystal Oscillators | X50328MSB2GI
MCU & support | 1 | BLM18PG221 |  | FB1 | L_0603_1608Metric | C80165 | Extended |  | Murata | BLM18PG221SN1D
MCU & support | 1 | BOOT |  | SW1 | SW_Push_1P1T_XKB_TS-1187A | C318884 | Basic |  | XKB Connection | TS-1187A-B-A-B
MCU & support | 1 | RESET |  | SW2 | SW_Push_1P1T_XKB_TS-1187A | C318884 | Basic |  | XKB Connection | TS-1187A-B-A-B
MCU & support | 1 | STM32F407VGT6 | MCU, Cortex-M4F 168MHz, 1MB flash, LQFP-100 | U1 | LQFP-100_14x14mm_P0.5mm | C12345 | Extended |  | STMicroelectronics | STM32F407VGT6
MCU & support | 1 | SWD | Tag-Connect TC2030-NL footprint, nothing to place | J3 | Tag-Connect_TC2030-IDC-NL_2x03_P1.27mm_Vertical |  |  | Not assembled
Status LEDs
Status LEDs | 5 | 1k |  | R2, R3, R4, R5, R6 | R_0603_1608Metric | C21190 | Basic |  | UNI-ROYAL(Uniroyal Elec) | 0603WAF1001T5E
Status LEDs | 1 | BLUE |  | D2 | LED_0603_1608Metric | C2288 | Extended |  | Hubei KENTO Elec | KT-0603B
Status LEDs | 2 | GREEN |  | D1, D5 | LED_0603_1608Metric | C12624 | Extended |  | Hubei KENTO Elec | KT-0603G
Status LEDs | 1 | RED |  | D4 | LED_0603_1608Metric | C2286 | Basic |  | Hubei KENTO Elec | KT-0603R
Status LEDs | 1 | YELLOW |  | D3 | LED_0603_1608Metric | C2287 | Extended |  | Hubei KENTO Elec | KT-0603Y
Power
Power | 1 | 1 |  | R7 | R_0603_1608Metric | C22936 | Basic |  | UNI-ROYAL(Uniroyal Elec) | 0603WAF100KT5E
Power | 1 | 100n |  | C19 | C_0603_1608Metric | C14663 | Basic |  | YAGEO | CC0603KRX7R9BB104
Power | 2 | 100n |  | C28, C29 | C_0402_1005Metric | C1525 | Basic |  | Samsung Electro-Mechanics | CL05B104KO5NNNC
Power | 1 | 10k |  | R8 | R_0603_1608Metric | C25804 | Basic |  | UNI-ROYAL(Uniroyal Elec) | 0603WAF1002T5E
Power | 1 | 10n |  | C20 | C_0603_1608Metric | C57112 | Basic |  | FH(Guangdong Fenghua Advanced Tech) | 0603B103K500NT
Power | 4 | 10u |  | C22, C23, C26, C27 | C_0805_2012Metric | C15850 | Basic |  | Samsung Electro-Mechanics | CL21A106KAYNNNE
Power | 3 | 10u/50V |  | C16, C17, C18 | C_1206_3216Metric | C13585 | Basic |  | Samsung Electro-Mechanics | CL31A106KBHNNNE
Power | 1 | 10uH |  | L2 | L_Sunlord_MWSA0603S | C132141 | Extended |  | Sunlord | MWSA0603S-100MT
Power | 1 | 12k |  | R10 | R_0603_1608Metric | C22790 | Basic |  | UNI-ROYAL(Uniroyal Elec) | 0603WAF1202T5E
Power | 2 | 1u |  | C24, C25 | C_0603_1608Metric | C15849 | Basic |  | Samsung Electro-Mechanics | CL10A105KB8NNNC
Power | 1 | 2.2uH |  | L1 | L_1210_3225Metric | C70960 | Extended |  | FH(Guangdong Fenghua Advanced Tech) | CMI322513U2R2KT
Power | 1 | 220p |  | C21 | C_0603_1608Metric | C1603 | Basic |  | Samsung Electro-Mechanics | CL10B221KB8NNNC
Power | 2 | 33k |  | R11, R13 | R_0402_1005Metric | C25779 | Basic |  | UNI-ROYAL(Uniroyal Elec) | 0402WGF3302TCE
Power | 2 | 6.8k |  | R12, R14 | R_0402_1005Metric | C25917 | Basic |  | UNI-ROYAL(Uniroyal Elec) | 0402WGF6801TCE
Power | 1 | 68k |  | R9 | R_0603_1608Metric | C23231 | Basic |  | UNI-ROYAL(Uniroyal Elec) | 0603WAF6802T5E
Power | 1 | B360A | 3A 60V Schottky, buck catch diode | D9 | D_SMA | C94193 | Extended |  | Diodes Incorporated | B360A-13-F
Power | 2 | B5819W | 1A 40V Schottky | D8, D10 | D_SOD-123 | C8598 | Extended |  | JSCJ | B5819W SL
Power | 1 | LDL1117S33R |  | U4 | SOT-223-3_TabPin2 | C435835 | Extended |  | STMicroelectronics | LDL1117S33R
Power | 1 | LMR14020 | 40V 2A buck converter, 12V -> 5V | U2 | SOIC-8-1EP_3.9x4.9mm_P1.27mm_EP2.29x3mm | C187824 | Extended |  | Texas Instruments | LMR14020SDDAR
Power | 1 | SMCJ30A | 1500W TVS, load dump | D6 | D_SMC | C224048 | Extended |  | Littelfuse | SMCJ30A
Power | 1 | SS34 | 3A 40V Schottky | D7 | D_SMA | C8678 | Basic |  | MDD(Microdiode Semiconductor) | SS34
Power | 1 | TLS115B0EJ | 5V sensor supply tracker, short-to-battery protected | U3 | Infineon_PG-DSO-8-27_3.9x4.9mm_EP2.65x3mm | C3743696 | Extended |  | Infineon | TLS115B0EJ
Injector / solenoid drivers
Injector / solenoid drivers | 1 | BCP53-16 |  | Q20 | SOT-223 | C85085 | Extended
Injector / solenoid drivers | 1 | VND14NV04 |  | Q101 | TO-252-2 | C2649436 | Extended |  | STMicroelectronics | VND14NV04TR-E
Injector / solenoid drivers | 8 | VND7NV04TR-E |  | Q1, Q2, Q3, Q4, Q5, Q6, Q7, Q8 | TO-252-2 | C155605 | Extended
Injector / solenoid drivers | 11 | ZXMS6004FFTA |  | Q9, Q10, Q11, Q12, Q13, Q14, Q15, Q16, Q17, Q18, Q19 | SOT-23 | C95063 | Extended
Ignition drivers
Ignition drivers | 4 | 100 |  | R15, R16, R17, R18 | R_1206_3216Metric | C17901 | Extended
Ignition drivers | 2 | 1u |  | C34, C35 | C_0402_1005Metric | C52923 | Extended |  | Samsung Electro-Mechanics | CL05A105KA5NQNC
Ignition drivers | 4 | 3.3k |  | R144, R145, R146, R147 | R_1206_3216Metric | C26032 | Extended
Ignition drivers | 1 | 4x10k |  | RN1 | R_Array_Convex_4x0603 | C29718 | Basic |  | UNI-ROYAL(Uniroyal Elec) | 4D03WGJ0103T5E
Ignition drivers | 1 | 74HCT04PW |  | U13 | TSSOP-14_4.4x5mm_P0.65mm | C131317 | Extended
Ignition drivers | 4 | B5819W | 1A 40V Schottky | D31, D32, D33, D34 | D_SOD-123 | C8598 | Extended |  | JSCJ | B5819W SL
Ignition drivers | 1 | BAT54WS |  | D39 | D_SOD-323 | C124205 | Extended |  | Diodes Incorporated | BAT54WS-7-F
Ignition drivers | 1 | Mezz_Power_Out | 1x40 2.54mm male header (power/outputs) | J1 | PinHeader_1x40_P2.54mm_Vertical | C2977586 | Extended |  | ZHOURI | 2.54-1*40
Ignition drivers | 2 | TC4427 | Dual 1.5A driver, 5V logic out for COP smart coils | U6, U7 | SOIC-8_3.9x4.9mm_P1.27mm | C20551 | Extended |  | Microchip | TC4427AEOA713
Knock input
Knock input | 3 | 100k |  | R45, R46, R47 | R_0603_1608Metric | C25803 | Basic |  | UNI-ROYAL(Uniroyal Elec) | 0603WAF1003T5E
Knock input | 1 | 100n |  | C44 | C_0603_1608Metric | C14663 | Basic |  | YAGEO | CC0603KRX7R9BB104
Knock input | 1 | 10k |  | R49 | R_0603_1608Metric | C25804 | Basic |  | UNI-ROYAL(Uniroyal Elec) | 0603WAF1002T5E
Knock input | 1 | 10n |  | C46 | C_0603_1608Metric | C57112 | Basic |  | FH(Guangdong Fenghua Advanced Tech) | 0603B103K500NT
Knock input | 1 | 1u |  | C45 | C_0603_1608Metric | C15849 | Basic |  | Samsung Electro-Mechanics | CL10A105KB8NNNC
Knock input | 1 | 2.2k |  | R138 | R_0402_1005Metric | C25879 | Basic |  | UNI-ROYAL | 0402WGF2201TCE
Knock input | 1 | 330 |  | R50 | R_0603_1608Metric | C23138 | Basic |  | UNI-ROYAL(Uniroyal Elec) | 0603WAF3300T5E
Knock input | 1 | 47k |  | R48 | R_0603_1608Metric | C25819 | Basic |  | UNI-ROYAL(Uniroyal Elec) | 0603WAF4702T5E
Knock input | 1 | LMV321IDBVR | Op-amp, knock sensor gain stage | U8 | SOT-23-5 | C7972 | Extended |  | Texas Instruments | LMV321IDBVR
VR (crank/cam) input
VR (crank/cam) input | 4 | 100k |  | R73, R74, R75, R76 | R_0402_1005Metric | C25741 | Extended |  | UNI-ROYAL(Uniroyal Elec) | 0402WGF1003TCE
VR (crank/cam) input | 1 | 100n |  | C60 | C_0402_1005Metric | C1525 | Basic |  | Samsung Electro-Mechanics | CL05B104KO5NNNC
VR (crank/cam) input | 1 | 100n |  | C50 | C_0603_1608Metric | C14663 | Basic |  | YAGEO | CC0603KRX7R9BB104
VR (crank/cam) input | 2 | 10k |  | R79, R80 | R_0402_1005Metric | C25744 | Basic |  | UNI-ROYAL(Uniroyal Elec) | 0402WGF1002TCE
VR (crank/cam) input | 2 | 10k |  | R55, R60 | R_0603_1608Metric | C25804 | Basic |  | UNI-ROYAL(Uniroyal Elec) | 0603WAF1002T5E
VR (crank/cam) input | 2 | 1M |  | R77, R78 | R_0402_1005Metric | C26083 | Extended |  | UNI-ROYAL(Uniroyal Elec) | 0402WGF1004TCE
VR (crank/cam) input | 2 | 1n |  | C48, C49 | C_0805_2012Metric | C46653 | Basic |  | Samsung Electro-Mechanics | CL21B102KBCNNNC
VR (crank/cam) input | 8 | 5.1k |  | R51, R52, R53, R54, R56, R57, R58, R59 | R_0805_2012Metric | C27834 | Basic |  | UNI-ROYAL(Uniroyal Elec) | 0805W8F5101T5E
VR (crank/cam) input | 4 | BAT54S | Dual series Schottky, VR input clamp | D15, D16, D17, D18 | SOT-23 | C19726 | Extended |  | onsemi | BAT54SLT1G
VR (crank/cam) input | 1 | LM2903DR | Dual comparator, VR input conditioner (spare VR inputs) | U9 | SOIC-8_3.9x4.9mm_P1.27mm | C7549 | Extended |  | Texas Instruments | LM2903DR
VR (crank/cam) input | 1 | Mezz_Signal_In | 1x40 2.54mm male header (inputs/comms) | J2 | PinHeader_1x40_P2.54mm_Vertical | C2977586 | Extended |  | ZHOURI | 2.54-1*40
Analog / hall / switch inputs
Analog / hall / switch inputs | 11 | 10k |  | R28, R30, R32, R35, R38, R40, R42, R44, R66, R68, R70 | R_0402_1005Metric | C25744 | Basic |  | UNI-ROYAL(Uniroyal Elec) | 0402WGF1002TCE
Analog / hall / switch inputs | 11 | 10n |  | C36, C37, C38, C39, C40, C41, C42, C43, C53, C54, C55 | C_0402_1005Metric | C15195 | Basic |  | Samsung Electro-Mechanics | CL05B103KB5NNNC
Analog / hall / switch inputs | 5 | 1N4148WS |  | D13, D14, D27, D28, D29 | D_SOD-323 | C2128 | Extended |  | JSCJ | 1N4148WS
Analog / hall / switch inputs | 2 | 1k |  | R62, R64 | R_0603_1608Metric | C21190 | Basic |  | UNI-ROYAL(Uniroyal Elec) | 0603WAF1001T5E
Analog / hall / switch inputs | 2 | 1n |  | C51, C52 | C_0402_1005Metric | C1523 | Basic |  | FH(Guangdong Fenghua Advanced Tech) | 0402B102K500NT
Analog / hall / switch inputs | 2 | 2.7k |  | R33, R36 | R_0603_1608Metric | C13167 | Extended |  | UNI-ROYAL | 0603WAF2701T5E
Analog / hall / switch inputs | 3 | 22k |  | R65, R67, R69 | R_0402_1005Metric | C25768 | Extended |  | UNI-ROYAL(Uniroyal Elec) | 0402WGF2202TCE
Analog / hall / switch inputs | 2 | 4.7k |  | R61, R63 | R_0603_1608Metric | C23162 | Basic |  | UNI-ROYAL(Uniroyal Elec) | 0603WAF4701T5E
Analog / hall / switch inputs | 8 | 5.6k |  | R27, R29, R31, R34, R37, R39, R41, R43 | R_0603_1608Metric | C23189 | Extended |  | UNI-ROYAL | 0603WAF5601T5E
Analog / hall / switch inputs | 9 | BAT54WS |  | D19, D20, D21, D22, D23, D24, D25, D26, D38 | D_SOD-323 | C124205 | Extended |  | Diodes Incorporated | BAT54WS-7-F
CAN
CAN | 1 | 100n |  | C56 | C_0603_1608Metric | C14663 | Basic |  | YAGEO | CC0603KRX7R9BB104
CAN | 1 | TCAN1042VDRQ1 |  | U10 | SOIC-8_3.9x4.9mm_P1.27mm | C485806 | Extended
Mechanical
Mechanical | 4 | M3 | M3 mounting hole | H1, H2, H3, H4 | MountingHole_3.2mm_M3 |  |  | Not assembled
Other
Other | 1 | 10 |  | R109 | R_1206_3216Metric | C17903 | Extended
Other | 3 | 100k |  | R115, R117, R120 | R_0402_1005Metric | C25741 | Extended |  | UNI-ROYAL(Uniroyal Elec) | 0402WGF1003TCE
Other | 1 | 100n |  | C47 | C_0603_1608Metric | C14663 | Basic |  | YAGEO | CC0603KRX7R9BB104
Other | 18 | 100n |  | C57, C58, C64, C65, C66, C67, C111, C112, C113, C114, C116, C102, C105, C108, C109, C122, C118, C121 | C_0402_1005Metric | C1525 | Basic |  | Samsung Electro-Mechanics | CL05B104KO5NNNC
Other | 2 | 100u |  | C63, C68 | C_1206_3216Metric | C15008 | Extended
Other | 10 | 10k |  | R19, R20, R21, R22, R23, R24, R25, R26, R139, R140 | R_0603_1608Metric | C25804 | Basic |  | UNI-ROYAL(Uniroyal Elec) | 0603WAF1002T5E
Other | 11 | 10k |  | R71, R72, R111, R112, R121, R129, R103, R133, R134, R104, R135 | R_0402_1005Metric | C25744 | Basic |  | UNI-ROYAL(Uniroyal Elec) | 0402WGF1002TCE
Other | 1 | 10u |  | C59 | C_0805_2012Metric | C15850 | Basic |  | Samsung Electro-Mechanics | CL21A106KAYNNNE
Other | 1 | 12k |  | R143 | R_0603_1608Metric | C22790 | Basic |  | UNI-ROYAL(Uniroyal Elec) | 0603WAF1202T5E
Other | 1 | 1k |  | R141 | R_0603_1608Metric | C21190 | Basic |  | UNI-ROYAL(Uniroyal Elec) | 0603WAF1001T5E
Other | 7 | 1k |  | R101, R113, R102, R125, R126, R127, R130 | R_0402_1005Metric | C11702 | Basic |  | UNI-ROYAL(Uniroyal Elec) | 0402WGF1001TCE
Other | 2 | 1u |  | C61, C62 | C_0603_1608Metric | C15849 | Basic |  | Samsung Electro-Mechanics | CL10A105KB8NNNC
Other | 5 | 1u |  | C101, C117, C104, C106, C107 | C_0402_1005Metric | C52923 | Extended |  | Samsung Electro-Mechanics | CL05A105KA5NQNC
Other | 2 | 22k |  | R106, R137 | R_0402_1005Metric | C25768 | Extended |  | UNI-ROYAL(Uniroyal Elec) | 0402WGF2202TCE
Other | 2 | 27k |  | R105, R107 | R_0402_1005Metric | C25771 | Extended |  | UNI-ROYAL(Uniroyal Elec) | 0402WGF2702TCE
Other | 1 | 3.3k |  | R124 | R_0402_1005Metric | C25890 | Extended |  | UNI-ROYAL(Uniroyal Elec) | 0402WGF3301TCE
Other | 1 | 33n |  | C103 | C_0402_1005Metric | C106862 | Extended |  | YAGEO | CC0402KRX7R9BB333
Other | 2 | 33p |  | C119, C120 | C_0402_1005Metric | C1562 | Extended |  | FH(Guangdong Fenghua Advanced Tech) | 0402CG330J500NT
Other | 1 | 4.7u |  | C110 | C_0603_1608Metric | C19666 | Basic |  | Samsung Electro-Mechanics | CL10A475KO8NNNC
Other | 1 | 47 |  | R108 | R_1206_3216Metric | C17969 | Extended
Other | 1 | 47k |  | R119 | R_0402_1005Metric | C25792 | Extended |  | UNI-ROYAL(Uniroyal Elec) | 0402WGF4702TCE
Other | 2 | 4x10k |  | RN2, RN3 | R_Array_Convex_4x0603 | C29718 | Basic |  | UNI-ROYAL(Uniroyal Elec) | 4D03WGJ0103T5E
Other | 1 | 5.1k |  | R142 | R_0603_1608Metric | C23186 | Basic |  | UNI-ROYAL(Uniroyal Elec) | 0603WAF5101T5E
Other | 1 | 6.8k |  | R116 | R_0402_1005Metric | C25917 | Basic |  | UNI-ROYAL(Uniroyal Elec) | 0402WGF6801TCE
Other | 1 | 62 |  | R110 | R_1206_3216Metric | C25341 | Extended
Other | 1 | 62k |  | R114 | R_0603_1608Metric | C23221 | Extended |  | UNI-ROYAL(Uniroyal Elec) | 0603WAF6202T5E
Other | 2 | 68k |  | R131, R132 | R_0402_1005Metric | C36871 | Extended |  | UNI-ROYAL(Uniroyal Elec) | 0402WGF6802TCE
Other | 1 | 8MHz | 8MHz crystal 5032, 20pF (YXC X50328MSB2GI) | Y101 | Crystal_SMD_5032-2Pin_5.0x3.2mm | C115962 | Extended |  | YXC Crystal Oscillators | X50328MSB2GI
Other | 1 | AD8628 |  | U105 | SOT-23-5 | C29309 | Extended |  | Analog Devices | AD8628ARTZ-REEL7
Other | 2 | B5819W | 1A 40V Schottky | D40, D41 | D_SOD-123 | C8598 | Extended |  | JSCJ | B5819W SL
Other | 1 | BAT54A |  | D35 | SOT-23 | C916423 | Extended
Other | 2 | BAT54S | Dual series Schottky, VR input clamp | D36, D37 | SOT-23 | C19726 | Extended |  | onsemi | BAT54SLT1G
Other | 1 | BAT54WS |  | D30 | D_SOD-323 | C124205 | Extended |  | Diodes Incorporated | BAT54WS-7-F
Other | 1 | BLUE |  | D103 | LED_0603_1608Metric | C2288 | Extended |  | Hubei KENTO Elec | KT-0603B
Other | 1 | GREEN |  | D102 | LED_0603_1608Metric | C12624 | Extended |  | Hubei KENTO Elec | KT-0603G
Other | 1 | MCP6004 |  | U101 | TSSOP-14_4.4x5mm_P0.65mm | C50282 | Extended |  | Microchip | MCP6004T-I/ST
Other | 1 | RED |  | D101 | LED_0603_1608Metric | C2286 | Basic |  | Hubei KENTO Elec | KT-0603R
Other | 1 | REF3033 |  | U103 | SOT-23 | C36658 | Extended |  | Texas Instruments | REF3033AIDBZR
Other | 1 | SMAJ33A |  | D12 | D_SMA | C223988 | Extended |  | Littelfuse | SMAJ33A
Other | 2 | SN74LVC4245APWR |  | U12, U11 | TSSOP-24_4.4x7.8mm_P0.65mm | C7859 | Extended |  | Texas Instruments | SN74LVC4245APWR
Other | 1 | STM32F103C8T6 |  | U102 | LQFP-48_7x7mm_P0.5mm | C8734 | Extended |  | STMicroelectronics | STM32F103C8T6
Other | 1 | SWD (WBO) |  | J102 | Tag-Connect_TC2030-IDC-NL_2x03_P1.27mm_Vertical |  |  | Not assembled
Other | 1 | TCAN1042VDRQ1 |  | U106 | SOIC-8_3.9x4.9mm_P1.27mm | C485806 | Extended
Other | 1 | TL431AIDBZR |  | U15 | SOT-23 | C23892 | Extended
Other | 1 | TLS115B0EJ | 5V sensor supply tracker, short-to-battery protected | U14 | Infineon_PG-DSO-8-27_3.9x4.9mm_EP2.65x3mm | C3743696 | Extended |  | Infineon | TLS115B0EJ
Other | 1 | nSMD010 |  | F2 | Fuse_1206_3216Metric | C70065 | Extended
Other | 1 | nSMD050-33V |  | F1 | Fuse_1206_3216Metric | C70077 | Extended |  | TECHFUSE | nSMD050-33V
Total placements
Unique extended parts |  | JLC charges a one-time loading fee per unique extended part
All LCSC numbers were checked against LCSC/JLCPCB listings on 2026-10-28 (manufacturer + MPN columns). Check stock at order time.

Sheet: Header Pinout
Pin | J1 (top edge) net | J1 function | J2 (bottom edge) net | J2 function
1 | VBAT_IN | 12V from main relay (feeds ECU + flyback) | V5_SENS | Protected 5V sensor supply
2 | VBAT_IN | 12V from main relay (feeds ECU + flyback) | GND | Ground
3 | VIGN_IN | Switched ignition (wakes ECU, sensed) | IN_KNOCK | Knock sensor
4 | GND | Ground | IN_TPS | Throttle position 0-5V
5 | GND | Ground | IN_MAP | MAP sensor 0-5V (MPX5700AP on motherboard)
6 | OUT_FP | Fuel pump relay (low side) | IN_CLT | Coolant temp (2.7k pull-up on board)
7 | OUT_MAINRLY | Main relay coil (low side) | IN_IAT | Intake air temp (2.7k pull-up on board)
8 | OUT_AC | A/C clutch relay (low side) | IN_AFR | Wideband analog out 0-5V
9 | OUT_FAN | Radiator fan relay (low side) | IN_AUX1 | Spare analog 0-5V
10 | OUT_CEL | Check engine lamp (low side) | IN_AUX2 | Spare analog 0-5V
11 | OUT_TACH | Tach output (open collector) | IN_AUX3 | Spare analog 0-5V
12 | OUT_LS7 | Spare low side 500mA | GND | Ground
13 | V5_EXT |  | IN_HALL1 | Hall input (1k pull-up to 5V), e.g. NB2 cam
14 | OUT_IGN1 | Coil 1, 5V logic (COP / igniter) | IN_HALL2 | Hall input, e.g. VSS
15 | OUT_IGN2 | Coil 2, 5V logic | IN_SW1 | Switch input 0-12V (A/C request)
16 | OUT_IGN3 | Coil 3, 5V logic | IN_SW2 | Switch input 0-12V (clutch/neutral)
17 | OUT_IGN4 | Coil 4, 5V logic | IN_SW3 | Switch input 0-12V (PS pressure)
18 | GND | Ground | GND | Ground
19 | OUT_INJ1 | Injector 1 (low side, protected) | VR2_N | VR #2 (cam) -
20 | GND | Ground | VR2_P | VR #2 (cam) +
21 | GND | Ground | VR1_P | VR #1 (crank) +
22 | OUT_INJ2 | Injector 2 | VR1_N | VR #1 (crank) -
23 | GND | Ground | GND | Ground
24 | GND | Ground | UART_TX | USART3 TX (3.3V, Bluetooth etc.)
25 | OUT_INJ3 | Injector 3 | UART_RX | USART3 RX
26 | GND | Ground | GND | Ground
27 | GND | Ground | CAN_L | CAN low (wideband controller, dash)
28 | OUT_INJ4 | Injector 4 | CAN_H | CAN high
29 | GND | Ground | GND | Ground
30 | GND | Ground | USB_DM | USB D- to motherboard USB-C
31 | OUT_IACV | Idle air valve (PWM) | USB_DP | USB D+
32 | GND | Ground | USB_VBUS | USB 5V (bench power/flashing)
33 | GND | Ground | LSU_UN
34 | OUT_VVT | VVT oil control valve (PWM, NB2) | LSU_RT
35 | GND | Ground | LSU_VM
36 | GND | Ground | LSU_IP
37 | OUT_BOOST | Boost control solenoid (PWM) | LSU_HTR_N
38 | GND | Ground | LSU_HTR_N
39 | GND | Ground | HTR_GND
40 | OUT_ALT | Alternator field control (NB2) | HTR_GND

Sheet: MCU Pin Map
LQFP pin | Port | Net | Use
1 | PE2 | LS7_CTL
2 | PE3 | TACH_CTL
3 | PE4 | CEL_CTL
4 | PE5 | FAN_CTL
5 | PE6 | AC_CTL
7 | PC13 | MAINRLY_CTL
8 | PC14 | FP_CTL
12 | PH0 | HSE_IN
13 | PH1 | HSE_OUT
14 | NRST | NRST | MCU reset
24 | PA1 | AN_VBATT
25 | PA2 | AN_VIGN
26 | PA3 | AN_KNOCK
29 | PA4 | AN_TPS
30 | PA5 | AN_MAP
31 | PA6 | AN_CLT
32 | PA7 | AN_IAT
33 | PC4 | AN_AFR
34 | PC5 | AN_AUX1
35 | PB0 | AN_AUX2
36 | PB1 | AN_AUX3
37 | PB2 | BOOT1
38 | PE7 | HALL1
39 | PE8 | HALL2
40 | PE9 | SW1
41 | PE10 | SW2
42 | PE11 | SW3
43 | PE12 | VR2_OUT
44 | PE13 | VR1_OUT
51 | PB12 | CAN_RX
52 | PB13 | CAN_TX
55 | PD8 | WB_PROG_TX
56 | PD9 | WB_PROG_RX
57 | PD10 | WB_BOOT0
58 | PD11 | WB_NRST
59 | PD12 | LED_RUN
62 | PD15 | LED_ERR
63 | PC6 | UART_TX_M
64 | PC7 | UART_RX_M
65 | PC8 | LED_COMM
66 | PC9 | LED_WARN
67 | PA8 | DRV_EN_N
70 | PA11 | USB_DM | USB D- to motherboard USB-C
71 | PA12 | USB_DP | USB D+
72 | PA13 | SWDIO | SWD data
76 | PA14 | SWCLK | SWD clock
86 | PD5 | ALT_CTL
87 | PD6 | BOOST_CTL
88 | PD7 | VVT_CTL
89 | PB3 | IACV_CTL
90 | PB4 | INJ4_CTL
91 | PB5 | INJ3_CTL
92 | PB6 | INJ2_CTL
93 | PB7 | INJ1_CTL
94 | BOOT0 | BOOT0 | DFU boot select
95 | PB8 | IGN4_CTL
96 | PB9 | IGN3_CTL
97 | PE0 | IGN2_CTL
98 | PE1 | IGN1_CTL
