v3ai/miata-ecus/daughterboard/fab/self_order_bom.csv

Line | Item | Quantity | Designator | Manufacturer | Manufacture Part Number | LCSC Part Number | Required | Find it | Notes
1 | Pin header, male, 1x40, 2.54mm, through-hole, vertical | 2 | J1,J2 | ZHOURI | 2.54-1*40 | C2977586 | Yes | https://www.lcsc.com/product-detail/C2977586.html | Bottom side. Solder while plugged into a motherboard's sockets so they come out straight
