v3ai/miata-ecus/motherboards/1989-93/fab/miata-ecu-motherboard-1989-93-rev0.11_jlcpcb_bom.csv

Comment | Designator | Footprint | LCSC Part #
120 | R1 | R_0603_1608Metric | C22787
0R | R6 | R_0603_1608Metric | C21189
3A hold | F1 | Fuse_2920_7451Metric | C22446884
1u | C1 | C_0603_1608Metric | C15849
10n | C2 | C_0603_1608Metric | C57112
470p | C3 | C_0603_1608Metric | C1620
USB4105-GF-A | J4 | USB_C_GCT_USB4105_16P | C3020560
5.1k | R2,R3 | R_0603_1608Metric | C23186
USBLC6-2SC6 | U4 | SOT-23-6 | C7519
0.5A hold | F4 | Fuse_1206_3216Metric | C70077
SS34 | D1,D2 | D_SMA | C8678
0R | R23,R24,R29 | R_0805_2012Metric | C17477
SMCJ30A | D3,D4 | D_SMC | C224048
