v3ai/miata-ecus/motherboards/1989-93/fab/miata-ecu-motherboard-1989-93-rev0.11_parts_list.csv

Ref | Value | Footprint | LCSC | Assembly | Description
J1 | TE 174917-6 | ecu_mb:TE_174917-6_48P |  | hand-fit / not fitted | Stock harness header, 48 pins (22 + 26). Hand-solder; salvage from a stock ECU or use a clone
H1 | M4 | ecu_mb:MountingHole_M4_4.5mm_Pad7 |  | mechanical | Case mounting boss, M4 x 10
H2 | M4 | ecu_mb:MountingHole_M4_4.5mm_Pad7 |  | mechanical | Case mounting boss, M4 x 10
H3 | M4 | ecu_mb:MountingHole_M4_4.5mm_Pad7 |  | mechanical | Case mounting boss, M4 x 10
H4 | M4 | ecu_mb:MountingHole_M4_4.5mm_Pad7 |  | mechanical | Case mounting boss, M4 x 10
H5 | M4 | ecu_mb:MountingHole_M4_4.5mm_Pad7 |  | mechanical | Case mounting boss, M4 x 10
H6 | M4 | ecu_mb:MountingHole_M4_4.5mm_Pad7 |  | mechanical | Case mounting boss, M4 x 10
JD1 | Socket 1x40 (daughter J1) | Connector_PinSocket_2.54mm:PinSocket_1x40_P2.54mm_Vertical | C124412 | hand-fit | 2.54 mm 1x40 female, 8.5 mm. Mates with the daughterboard J1 (power + outputs)
JD2 | Socket 1x40 (daughter J2) | Connector_PinSocket_2.54mm:PinSocket_1x40_P2.54mm_Vertical | C124412 | hand-fit | 2.54 mm 1x40 female, 8.5 mm. Mates with the daughterboard J2 (inputs + comms)
HD1 | M3 standoff | MountingHole:MountingHole_3.2mm_M3 |  | mechanical | Daughterboard standoff, M3 x 11 mm (8.5 mm socket + 2.5 mm header plastic)
HD2 | M3 standoff | MountingHole:MountingHole_3.2mm_M3 |  | mechanical | Daughterboard standoff, M3 x 11 mm (8.5 mm socket + 2.5 mm header plastic)
HD3 | M3 standoff | MountingHole:MountingHole_3.2mm_M3 |  | mechanical | Daughterboard standoff, M3 x 11 mm (8.5 mm socket + 2.5 mm header plastic)
HD4 | M3 standoff | MountingHole:MountingHole_3.2mm_M3 |  | mechanical | Daughterboard standoff, M3 x 11 mm (8.5 mm socket + 2.5 mm header plastic)
R1 | 120 | Resistor_SMD:R_0603_1608Metric | C22787 | JLC | CAN termination
R6 | 0R | Resistor_SMD:R_0603_1608Metric | C21189 | JLC | CAN termination link: fitted = 120R terminator active; remove if the bus is terminated elsewhere
F1 | 3A hold | Fuse:Fuse_2920_7451Metric | C22446884 | JLC | Resettable fuse for the LSU heater supply (LUTE 2920L300/30GR: 3 A hold, 5 A trip, 30 V)
J2 | LSU 4.9 | Connector_Molex:Molex_Micro-Fit_3.0_43045-0600_2x03_P3.00mm_Horizontal | C127367 | hand-fit | Bosch LSU 4.9 wideband sensor. Pin n = LSU pin n: 1 IP, 2 VM, 3 H-, 4 H+, 5 RT, 6 UN
J3 | IAT | Connector_Molex:Molex_Micro-Fit_3.0_43650-0200_1x02_P3.00mm_Horizontal | C587650 | hand-fit | Intake air temperature sensor (M12x1.5 thermistor, 2 wires)
JP1 | IAT SEL | Connector_PinHeader_2.54mm:PinHeader_1x03_P2.54mm_Vertical | C49257 | hand-fit | IAT source jumper: shunt on 1-2 (STOCK) = stock harness air-temp sensor, on 2-3 (EXT) = IAT connector J3 (default). Shunt: 2.54 mm jumper cap, LCSC C5305, fitted by hand
U2 | MPX5700AP | ecu_mb:MPX5700AP_867B_Flat | C90152 | hand-fit | MAP sensor, 15-700 kPa absolute, single barbed port (case 867B). Lies flat, marking up, leads bent 90 deg, 2x M3 screws
C1 | 1u | Capacitor_SMD:C_0603_1608Metric | C15849 | JLC | MAP supply
C2 | 10n | Capacitor_SMD:C_0603_1608Metric | C57112 | JLC | MAP supply
C3 | 470p | Capacitor_SMD:C_0603_1608Metric | C1620 | JLC | MAP output filter
J4 | USB-C | ecu_mb:USB_C_GCT_USB4105_16P | C3020560 | JLC | USB-C for tuning and firmware (USB 2.0 FS)
R2 | 5.1k | Resistor_SMD:R_0603_1608Metric | C23186 | JLC | USB-C sink CC1
R3 | 5.1k | Resistor_SMD:R_0603_1608Metric | C23186 | JLC | USB-C sink CC2
U4 | USBLC6-2SC6 | Package_TO_SOT_SMD:SOT-23-6 | C7519 | JLC | USB ESD protection
J5 | AUX 2x8 | Connector_IDC:IDC-Header_2x08_P2.54mm_Vertical | C3406 | hand-fit | Add-on I/O: COP 3/4, boost, alternator, main relay, knock, VR crank/cam, external AFR, UART, 5 V, +12 V (fused, F4)
F4 | 0.5A hold | Fuse:Fuse_1206_3216Metric | C70077 | JLC | Resettable fuse for the AUX +12 V pin J5-15 (TECHFUSE nSMD050-33V: 0.5 A hold, 1 A trip, 33 V)
D1 | SS34 | Diode_SMD:D_SMA | C8678 | JLC | Idle valve freewheel diode (to its +12 V feed, VBAT_IN): keeps the PWM turn-off energy out of the driver
D2 | SS34 | Diode_SMD:D_SMA | C8678 | JLC | VVT-driver coil freewheel diode (to its +12 V feed, VBAT_IN)
R20 | 4.7k | Resistor_SMD:R_0603_1608Metric |  | hand-fit / not fitted | NOT FITTED: 12 V pull-up for the vehicle speed input. Fit (4.7k 0603, LCSC C23162: 48 mW at 15 V with the switch closed) only if your car's signal switches to ground or is open collector; a switch that drives 12 V must not have it
R21 | 4.7k | Resistor_SMD:R_0603_1608Metric |  | hand-fit / not fitted | NOT FITTED: 12 V pull-up for the A/C switch input. Fit (4.7k 0603, LCSC C23162: 48 mW at 15 V with the switch closed) only if your car's signal switches to ground or is open collector; a switch that drives 12 V must not have it
R22 | 4.7k | Resistor_SMD:R_0603_1608Metric |  | hand-fit / not fitted | NOT FITTED: 12 V pull-up for the clutch switch input. Fit (4.7k 0603, LCSC C23162: 48 mW at 15 V with the switch closed) only if your car's signal switches to ground or is open collector; a switch that drives 12 V must not have it
R23 | 0R | Resistor_SMD:R_0805_2012Metric | C17477 | JLC | Batch: INJ4 driver in parallel with INJ1 on 2U (remove for a sequential conversion)
R24 | 0R | Resistor_SMD:R_0805_2012Metric | C17477 | JLC | Batch: INJ3 driver in parallel with INJ2 on 2V (remove for a sequential conversion)
R25 | 0R | Resistor_SMD:R_0805_2012Metric |  | hand-fit / not fitted | NOT FITTED: sequential conversion only, INJ3 to 2Y (fit instead of R24)
R26 | 0R | Resistor_SMD:R_0805_2012Metric |  | hand-fit / not fitted | NOT FITTED: sequential conversion only, INJ4 to 2Z (fit instead of R23). NEVER on an automatic: 2Z is the A/T unit
D3 | SMCJ30A | Diode_SMD:D_SMC | C224048 | JLC | Injector clamp for the two injectors on 2U (30 V standoff, 33.3-36.8 V breakdown, about 37.5 V at the 1.8 A turn-off current: always below the VND7NV04 drivers' 40 V minimum clamp, so the TVS takes all of the turn-off energy). Same part as the daughterboard's load-dump TVS D6
D4 | SMCJ30A | Diode_SMD:D_SMC | C224048 | JLC | Injector clamp for the two injectors on 2V (30 V standoff, 33.3-36.8 V breakdown, about 37.5 V at the 1.8 A turn-off current: always below the VND7NV04 drivers' 40 V minimum clamp, so the TVS takes all of the turn-off energy). Same part as the daughterboard's load-dump TVS D6
R27 | 4.7k | Resistor_SMD:R_0603_1608Metric |  | hand-fit / not fitted | NOT FITTED: 5 V pull-up for the stock throttle switch contact on 2L (manual cars, R29 fitted). Fit (4.7k 0603, LCSC C23162; 1.1 mA with the switch closed) to read the stock switch; never with a sensor on 2L
R28 | 0R | Resistor_SMD:R_0805_2012Metric |  | hand-fit / not fitted | NOT FITTED: TPS conversion only (manual cars): protected 5 V to 1N for a 0-5 V sensor on the stock plug. Never with the stock throttle switch: it shorts 1N to ground at idle
R29 | 0R | Resistor_SMD:R_0805_2012Metric | C17477 | JLC | Stock: 2L to the spare analog input AUX1 (remove for a TPS conversion)
R30 | 0R | Resistor_SMD:R_0805_2012Metric |  | hand-fit / not fitted | NOT FITTED: TPS conversion only (manual cars): 2L to the TPS input, in place of R29. Never on an automatic: its sensor is on 2M
