v3ai/miata-ecus/motherboards/1989-93/fab/miata-ecu-motherboard-1989-93-rev0.10_self_order_bom.csv

Line | Item | Quantity | Designator | Manufacturer | Manufacture Part Number | LCSC Part Number | Required | Find it | Notes
1 | Harness header TE 174917-6 | 1 | J1 | TE Connectivity | 174917-6 |  | Yes | https://www.digikey.com/en/products/result?keywords=174917-6 | Not available from TE: salvage from a stock NA ECU or buy a clone
2 | Female socket 1x40, 2.54mm, through-hole, 8.5mm | 2 | JD1,JD2 | Ckmtw(Shenzhen Cankemeng) | B-2200S40P-A120 | C124412 | Yes | https://www.lcsc.com/product-detail/C124412.html
3 | IDC box header 2x8 (16P), 2.54mm, through-hole | 1 | J5 | BOOMELE(Boom Precision Elec) | 2.54-2*8P | C3406 | Yes | https://www.lcsc.com/product-detail/C3406.html
4 | Jumper shunt, 2.54 mm | 1 |  | BOOMELE(Boom Precision Elec) | 2.54 Short Circuit Cap | C5305 | Yes | https://www.lcsc.com/product-detail/C5305.html | For JP1 (IAT source): EXT = board IAT connector J3, STOCK = harness sensor
5 | Micro-Fit 3.0 header, 1x2 (2P), 3.0mm, right angle, through-hole | 1 | J3 | MOLEX | 436500202 | C587650 | Yes | https://www.lcsc.com/product-detail/C587650.html
6 | Micro-Fit 3.0 header, 1x4 (4P), 3.0mm, right angle, through-hole | 1 | J6 | MOLEX | 436500400 | C277684 | Yes | https://www.lcsc.com/product-detail/C277684.html
7 | Micro-Fit 3.0 header, male, 2x3 (6P), 3.0mm, right angle, through-hole | 1 | J2 | MOLEX | 430450600 | C127367 | Yes | https://www.lcsc.com/product-detail/C127367.html
8 | Pin header, male, 1x3, 2.54mm, through-hole, vertical | 1 | JP1 | BOOMELE(Boom Precision Elec) | 2.54-1*3PPin | C49257 | Yes | https://www.lcsc.com/product-detail/C49257.html
9 | Pressure sensor 15-700kPa absolute, 5V, ratiometric analog out, unibody single port (867B) | 1 | U2 | NXP | MPX5700AP | C90152 | Yes | https://www.lcsc.com/product-detail/C90152.html | Lies flat, marking side up, leads bent 90 deg down, held by 2 x M3 screws
10 | Nut, M3 | 2 |  |  | M3 hex nut |  | Yes |  | MAP sensor (U2) hold-down
11 | Screw, M3 x 10, pan head | 2 |  |  | M3 x 10 pan head |  | Yes |  | MAP sensor (U2) hold-down
12 | Screw, M3 x 6, pan head | 8 |  |  | M3 x 6 pan head |  | Yes |  | Two per daughterboard standoff (HD1-HD4)
13 | Standoff, M3 x 11 mm, hex, female-female | 4 | HD1,HD2,HD3,HD4 |  | M3 x 11 F-F hex standoff |  | Yes |  | Daughterboard above the motherboard (8.5 mm sockets + 2.5 mm header plastic)
14 | Thick film resistor 0 ohm 0805 | 2 | R25,R26 | UNI-ROYAL(Uniroyal Elec) | 0805W8F0000T5E | C17477 | Optional | https://www.lcsc.com/product-detail/C17477.html | R25: sequential conversion only, INJ3 to 2Y (fit instead of R24); R26: sequential conversion only, INJ4 to 2Z (fit instead of R23). NEVER on an automatic: 2Z is the A/T unit
15 | Thick film resistor 4.7k 1% 100mW 0603 | 4 | R20,R21,R22,R27 | UNI-ROYAL(Uniroyal Elec) | 0603WAF4701T5E | C23162 | Optional | https://www.lcsc.com/product-detail/C23162.html | R20: 12 V pull-up for the vehicle speed input. Fit (4.7k 0603, LCSC C23162: 48 mW at 15 V with the switch closed) only if your car's signal switches to ground or is open collector; a switch that drives 12 V must not have it; R21: 12 V pull-up for the A/C switch input. Fit (4.7k 0603, LCSC C23162: 48 mW at 15 V with the switch closed) only if your car's signal switches to ground or is open collector; a switch that drives 12 V must not have it; R22: 12 V pull-up for the clutch switch input. Fit (4.7k 0603, LCSC C23162: 48 mW at 15 V with the switch closed) only if your car's signal switches to ground or is open collector; a switch that drives 12 V must not have it; R27: 5 V pull-up for the TPS idle switch on 2L (manual cars). Fit (4.7k 0603, LCSC C23162; 1.1 mA with the switch closed) if the idle switch is used; from the protected harness 5 V
16 | Throttle position sensor, 0-5 V potentiometer, 3 pins | 1 |  | Bosch | 0 280 122 001 |  | Manual cars | https://www.digikey.com/en/products/result?keywords=0%20280%20122%20001 | Same part as BMW 13 63 1 721 456; the sensor the NA6 adapter plates below are made for. 86 deg usable travel, 2 kOhm track, -40 to +130 C. Pins 1 and 2 are the ends of the track (5 V and ground, about 2 kOhm between them at any throttle), pin 3 the wiper (signal): check with an ohmmeter before wiring. Replaces the stock idle switch
17 | TPS adapter plate for the NA6 throttle body (buy) | 1 |  | Flyin' Miata | TPS upgrade kit 07-360XX, no-TPS option |  | Manual cars | https://flyinmiata.com/products/tps-upgrade | Bolts to the side of the 1990-93 manual throttle body and carries the Bosch / BMW sensor. Either this or the printed plate below. Not with an NB intake manifold
18 | TPS plug, Bosch Junior Timer 3-pin, with terminals | 1 |  | Bosch | 1 237 000 039 |  | Manual cars | https://www.efihardware.com/products/388/connector-TPS-Module-3-pin-plug-Bosch | Mates with the Bosch 0 280 122 001. Buy it as a kit with its terminals (e.g. EFI Hardware C03F-0002): loose terminals often don't fit the housing
19 | Shielded cable, 3 x 22 AWG with drain, 105 C or better | 3 |  |  | M27500-22SB3T23 (or equivalent), metres |  | Manual cars |  | J6 to the sensor: about 3 m from the ECU in the passenger footwell through the firewall to the throttle body; measure your route. Shield drain to J6 pin 4 only (open at the sensor end). Office cable rated 60 C is not good enough under the hood. Three twisted 22 AWG TXL wires in loom also work (leave pin 4 empty)
20 | Micro-Fit 3.0 receptacle, 1x4 | 1 |  | Molex | 43645-0400 |  | Manual cars | https://www.digikey.com/en/products/result?keywords=43645-0400 | Mates with J6: 1 = 5 V, 2 = TPS signal, 3 = sensor ground, 4 = shield drain
21 | Micro-Fit 3.0 female crimp terminal, 20-24 AWG (TPS lead) | 4 |  | Molex | 43030-0007 |  | Manual cars | https://www.digikey.com/en/products/result?keywords=43030-0007 | For the J6 receptacle; buy spares
22 | TPS adapter plate for the NA6 throttle body (3D print) | 1 |  |  | Thingiverse 4476762 or Printables 619337 |  | Optional | https://www.thingiverse.com/thing:4476762 | Instead of the bought plate: Skuzzle's "Mazda MX5 - BMW TPS adapter" (Thingiverse 4476762), or its thicker remix "BMW tps adaptor maximum beef" (Printables 619337). Print in ASA (PLA and PETG soften in the engine bay); check the licence on the model page
23 | Screw, M4, with nut (sensor to printed plate) | 2 |  |  | M4 screw + M4 nut, length to suit the plate |  | Optional |  | Printed plate only
24 | Screw, M4, with wide (fender) washer (printed plate to throttle body) | 2 |  |  | M4 screw + M4 fender washer, length to suit |  | Optional |  | Printed plate only: the wide washers spread the load on the plastic
25 | Convoluted loom, 6 mm (1/4 in), split | 2 |  |  | 6 mm split loom, metres |  | Optional |  | Engine-bay run of the TPS lead; tie it to the engine harness, away from the exhaust and the coil leads
