v3ai/miata-ecus/website/products/products.csv

Handle | Title | Body (HTML) | Vendor | Type | Tags | Published | Option1 Name | Option1 Value | Variant SKU | Variant Inventory Policy | Variant Fulfillment Service | Variant Price | Variant Requires Shipping | Variant Taxable | Image Src | Image Alt Text | Gift Card | SEO Title | SEO Description | Status
plug-in-ecu-1989-93 | Plug-in ECU 1989–93 | <p>A rusEFI engine computer for the 1989–93 Mazda MX-5 Miata (NA · 1.6). It fits the stock ECU case and plugs into the stock harness connector. Two boards: the universal daughterboard that runs the engine, and a motherboard made for your model year.</p><p>The 1989–93 manual cars have a throttle switch rather than a throttle position sensor. For closed-loop idle and throttle-based acceleration fuel, add a 0–5 V sensor on the stock plug: two 0 Ω links on the board.</p><table><tr><th>Fits</th><td>1989–93 MX-5 Miata, manual and manual-swapped</td></tr><tr><th>Connector</th><td>Stock 48-pin (2 plugs)</td></tr><tr><th>Processor</th><td>STM32F407, running rusEFI</td></tr><tr><th>Wideband</th><td>Built-in LSU 4.9 controller</td></tr><tr><th>MAP sensor</th><td>700 kPa absolute, on the board</td></tr><tr><th>Outputs</th><td>8 low-side drivers, 7 protected relay and lamp outputs, 4 ignition</td></tr><tr><th>Tuning</th><td>TunerStudio over USB-C</td></tr><tr><th>You add</th><td>A Bosch LSU 4.9 sensor (it fits the stock front oxygen sensor's hole) and its lead, a vacuum hose to the intake manifold, your stock ECU case</td></tr></table> |  | Plug-in ECU | ECU, NA, 1989–93 | FALSE | Title | Default Title | plug-in-ecu-1989-93 | deny | manual | 399.00 | TRUE | TRUE |  |  | FALSE | Plug-in ECU 1989–93 | Plug-in ECU 1989–93: a plug-in rusEFI engine computer for the Mazda MX-5 Miata. | draft
plug-in-ecu-1994-95 | Plug-in ECU 1994–95 | <p>A rusEFI engine computer for the 1994–95 Mazda MX-5 Miata (NA · 1.8). It fits the stock ECU case and plugs into the stock harness connector. Two boards: the universal daughterboard that runs the engine, and a motherboard made for your model year.</p><table><tr><th>Fits</th><td>1994–95 MX-5 Miata, manual and manual-swapped</td></tr><tr><th>Connector</th><td>Stock 48-pin (2 plugs)</td></tr><tr><th>Processor</th><td>STM32F407, running rusEFI</td></tr><tr><th>Wideband</th><td>Built-in LSU 4.9 controller</td></tr><tr><th>MAP sensor</th><td>700 kPa absolute, on the board</td></tr><tr><th>Outputs</th><td>8 low-side drivers, 7 protected relay and lamp outputs, 4 ignition</td></tr><tr><th>Tuning</th><td>TunerStudio over USB-C</td></tr><tr><th>You add</th><td>A Bosch LSU 4.9 sensor (it fits the stock front oxygen sensor's hole) and its lead, a vacuum hose to the intake manifold, your stock ECU case</td></tr></table> |  | Plug-in ECU | ECU, NA, 1994–95 | FALSE | Title | Default Title | plug-in-ecu-1994-95 | deny | manual | 399.00 | TRUE | TRUE |  |  | FALSE | Plug-in ECU 1994–95 | Plug-in ECU 1994–95: a plug-in rusEFI engine computer for the Mazda MX-5 Miata. | draft
plug-in-ecu-1996-97 | Plug-in ECU 1996–97 | <p>A rusEFI engine computer for the 1996–97 Mazda MX-5 Miata (NA · 1.8 OBD-II). It fits the stock ECU case and plugs into the stock harness connector. Two boards: the universal daughterboard that runs the engine, and a motherboard made for your model year.</p><table><tr><th>Fits</th><td>1996–97 MX-5 Miata, manual and manual-swapped</td></tr><tr><th>Connector</th><td>Stock 76-pin</td></tr><tr><th>Processor</th><td>STM32F407, running rusEFI</td></tr><tr><th>Wideband</th><td>Built-in LSU 4.9 controller</td></tr><tr><th>MAP sensor</th><td>700 kPa absolute, on the board</td></tr><tr><th>Outputs</th><td>8 low-side drivers, 7 protected relay and lamp outputs, 4 ignition</td></tr><tr><th>Tuning</th><td>TunerStudio over USB-C</td></tr><tr><th>You add</th><td>A Bosch LSU 4.9 sensor (it fits the stock front oxygen sensor's hole) and its lead, a vacuum hose to the intake manifold, your stock ECU case</td></tr></table> |  | Plug-in ECU | ECU, NA, 1996–97 | FALSE | Title | Default Title | plug-in-ecu-1996-97 | deny | manual | 399.00 | TRUE | TRUE |  |  | FALSE | Plug-in ECU 1996–97 | Plug-in ECU 1996–97: a plug-in rusEFI engine computer for the Mazda MX-5 Miata. | draft
plug-in-ecu-1999-2000 | Plug-in ECU 1999–2000 | <p>A rusEFI engine computer for the 1999–2000 Mazda MX-5 Miata (NB · 1.8). It fits the stock ECU case and plugs into the stock harness connector. Two boards: the universal daughterboard that runs the engine, and a motherboard made for your model year.</p><table><tr><th>Fits</th><td>1999–2000 MX-5 Miata, manual and manual-swapped</td></tr><tr><th>Connector</th><td>Stock 64-pin</td></tr><tr><th>Processor</th><td>STM32F407, running rusEFI</td></tr><tr><th>Wideband</th><td>Built-in LSU 4.9 controller</td></tr><tr><th>MAP sensor</th><td>700 kPa absolute, on the board</td></tr><tr><th>Outputs</th><td>8 low-side drivers, 7 protected relay and lamp outputs, 4 ignition</td></tr><tr><th>Tuning</th><td>TunerStudio over USB-C</td></tr><tr><th>You add</th><td>A Bosch LSU 4.9 sensor (it fits the stock front oxygen sensor's hole) and its lead, a vacuum hose to the intake manifold, your stock ECU case</td></tr></table> |  | Plug-in ECU | ECU, NB, 1999–2000 | FALSE | Title | Default Title | plug-in-ecu-1999-2000 | deny | manual | 399.00 | TRUE | TRUE |  |  | FALSE | Plug-in ECU 1999–2000 | Plug-in ECU 1999–2000: a plug-in rusEFI engine computer for the Mazda MX-5 Miata. | draft
plug-in-ecu-2001-05 | Plug-in ECU 2001–05 | <p>A rusEFI engine computer for the 2001–05 Mazda MX-5 Miata (NB · 1.8 VVT). It fits the stock ECU case and plugs into the stock harness connector. Two boards: the universal daughterboard that runs the engine, and a motherboard made for your model year.</p><table><tr><th>Fits</th><td>2001–05 MX-5 Miata, manual and manual-swapped</td></tr><tr><th>Connector</th><td>Stock 72-pin (3 rows)</td></tr><tr><th>Processor</th><td>STM32F407, running rusEFI</td></tr><tr><th>Wideband</th><td>Built-in LSU 4.9 controller</td></tr><tr><th>MAP sensor</th><td>700 kPa absolute, on the board</td></tr><tr><th>Outputs</th><td>8 low-side drivers, 7 protected relay and lamp outputs, 4 ignition</td></tr><tr><th>Tuning</th><td>TunerStudio over USB-C</td></tr><tr><th>You add</th><td>A Bosch LSU 4.9 sensor (it fits the stock front oxygen sensor's hole) and its lead, a vacuum hose to the intake manifold, your stock ECU case</td></tr></table> |  | Plug-in ECU | ECU, NB, 2001–05 | FALSE | Title | Default Title | plug-in-ecu-2001-05 | deny | manual | 399.00 | TRUE | TRUE |  |  | FALSE | Plug-in ECU 2001–05 | Plug-in ECU 2001–05: a plug-in rusEFI engine computer for the Mazda MX-5 Miata. | draft
