v3ai/miata-ecus/daughterboard/miata_ecu_daughter_schematic.pdf

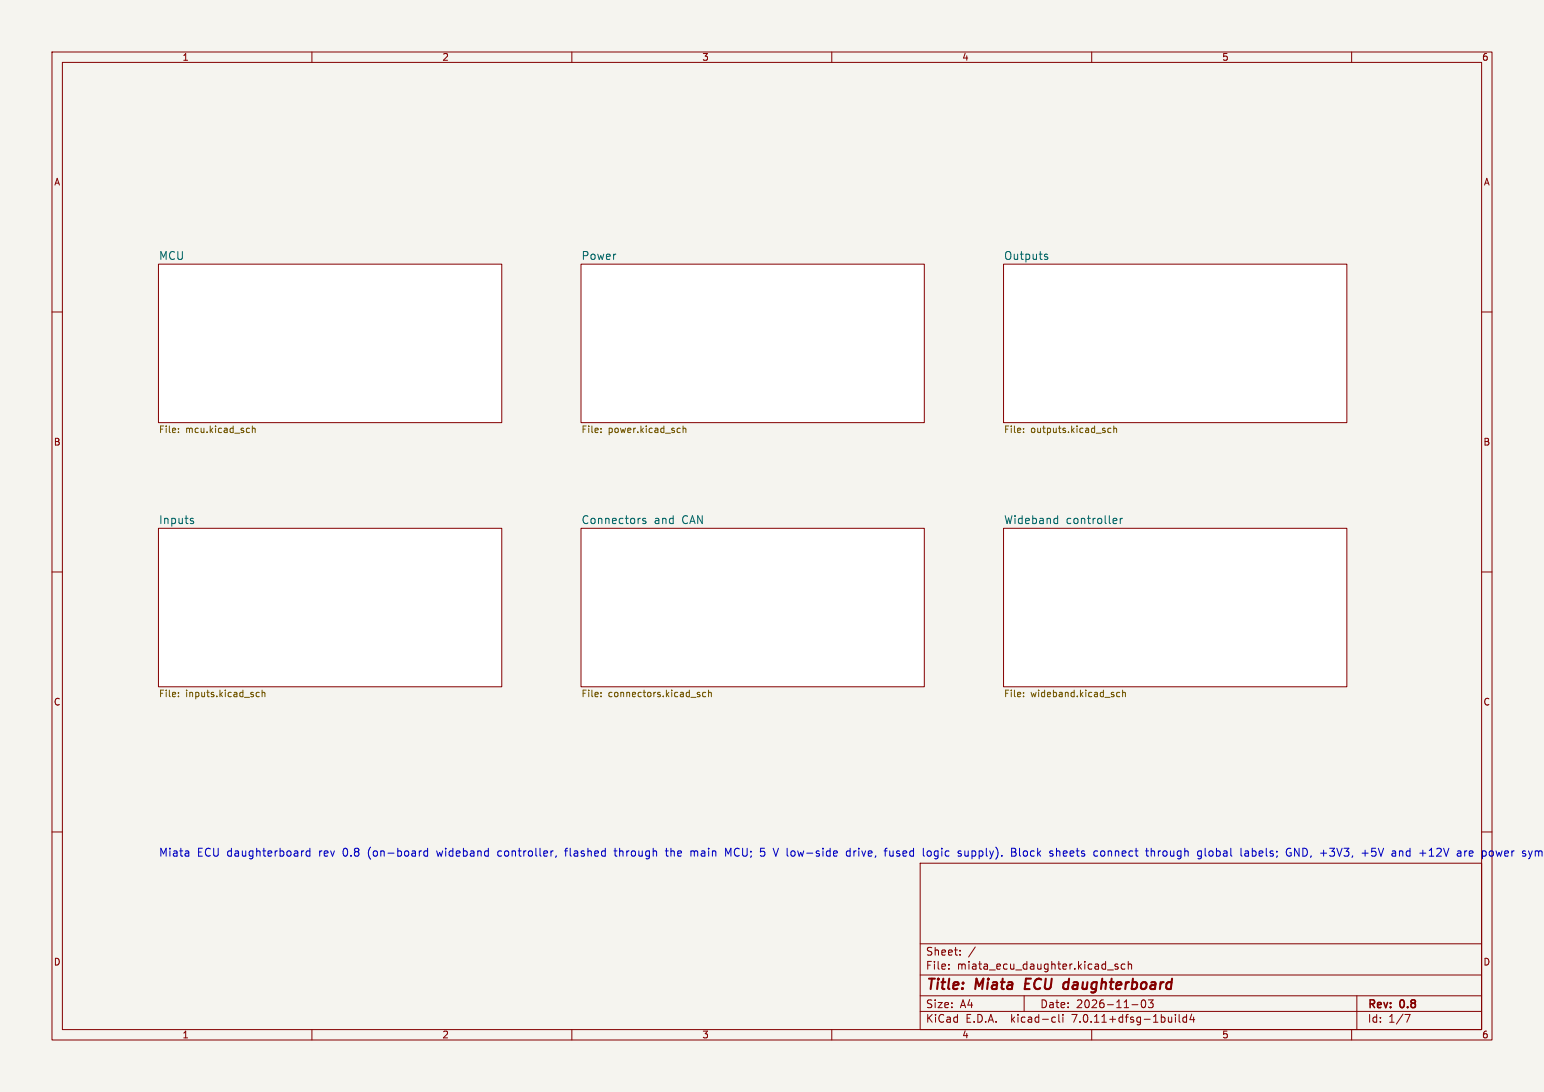
[picture p52: page 1]

File: miata_ecu_daughter.kicad_sch Sheet: /
Id: 1/7 Title: Miata ECU daughterboard

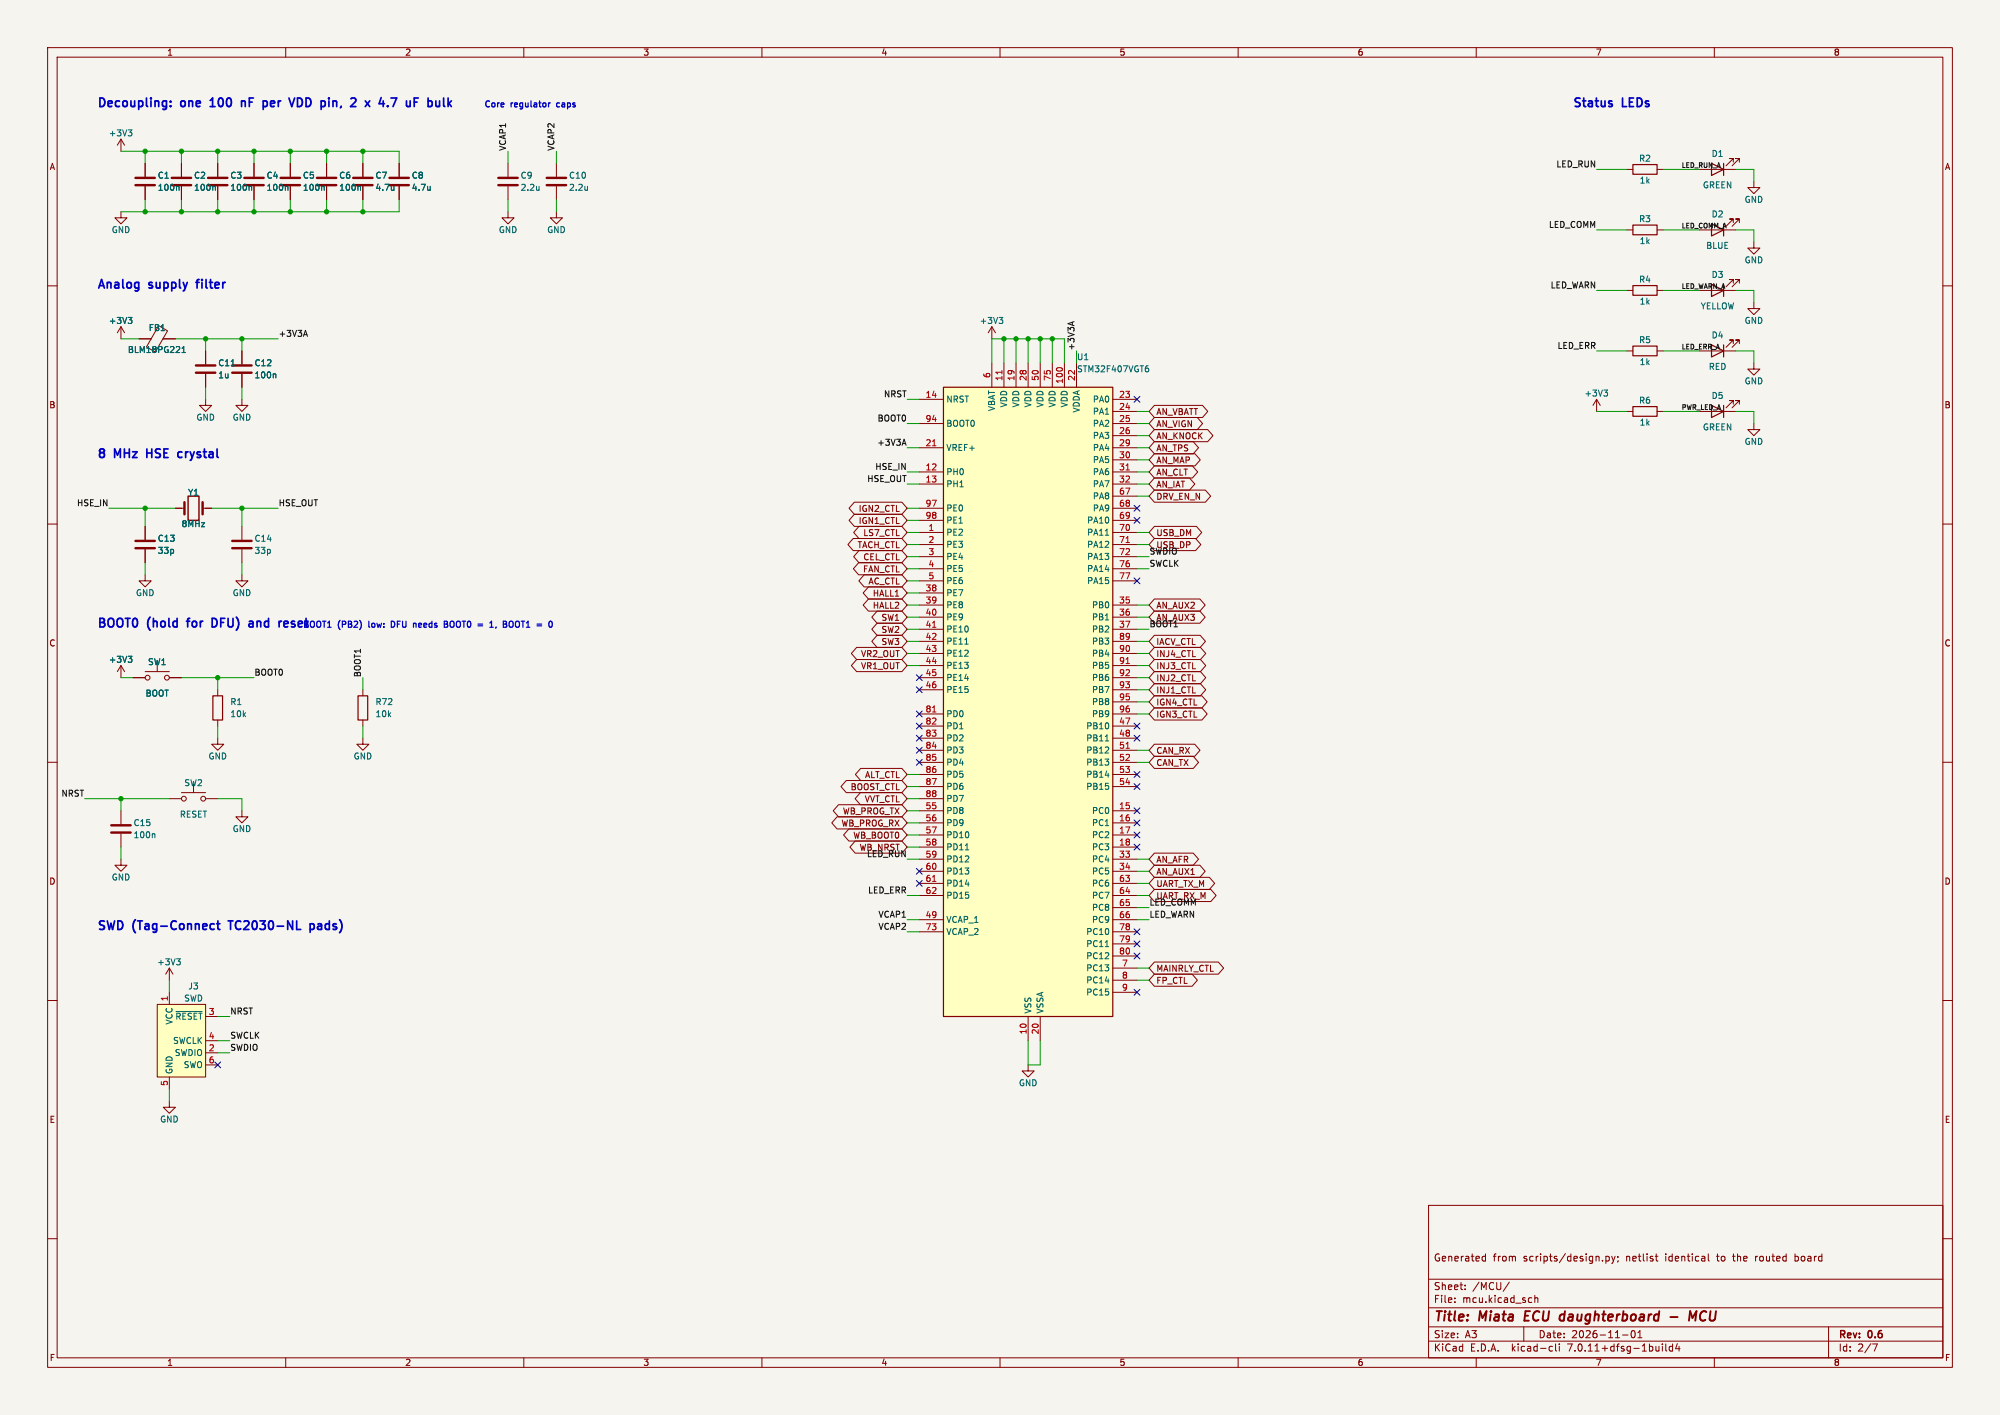
[picture p53: page 2]

Decoupling: one 100 nF per VDD pin, 2 x 4.7 uF bulk

BOOT0 (hold for DFU) and reset BOOT1 (PB2) low: DFU needs BOOT0 = 1, BOOT1 = 0

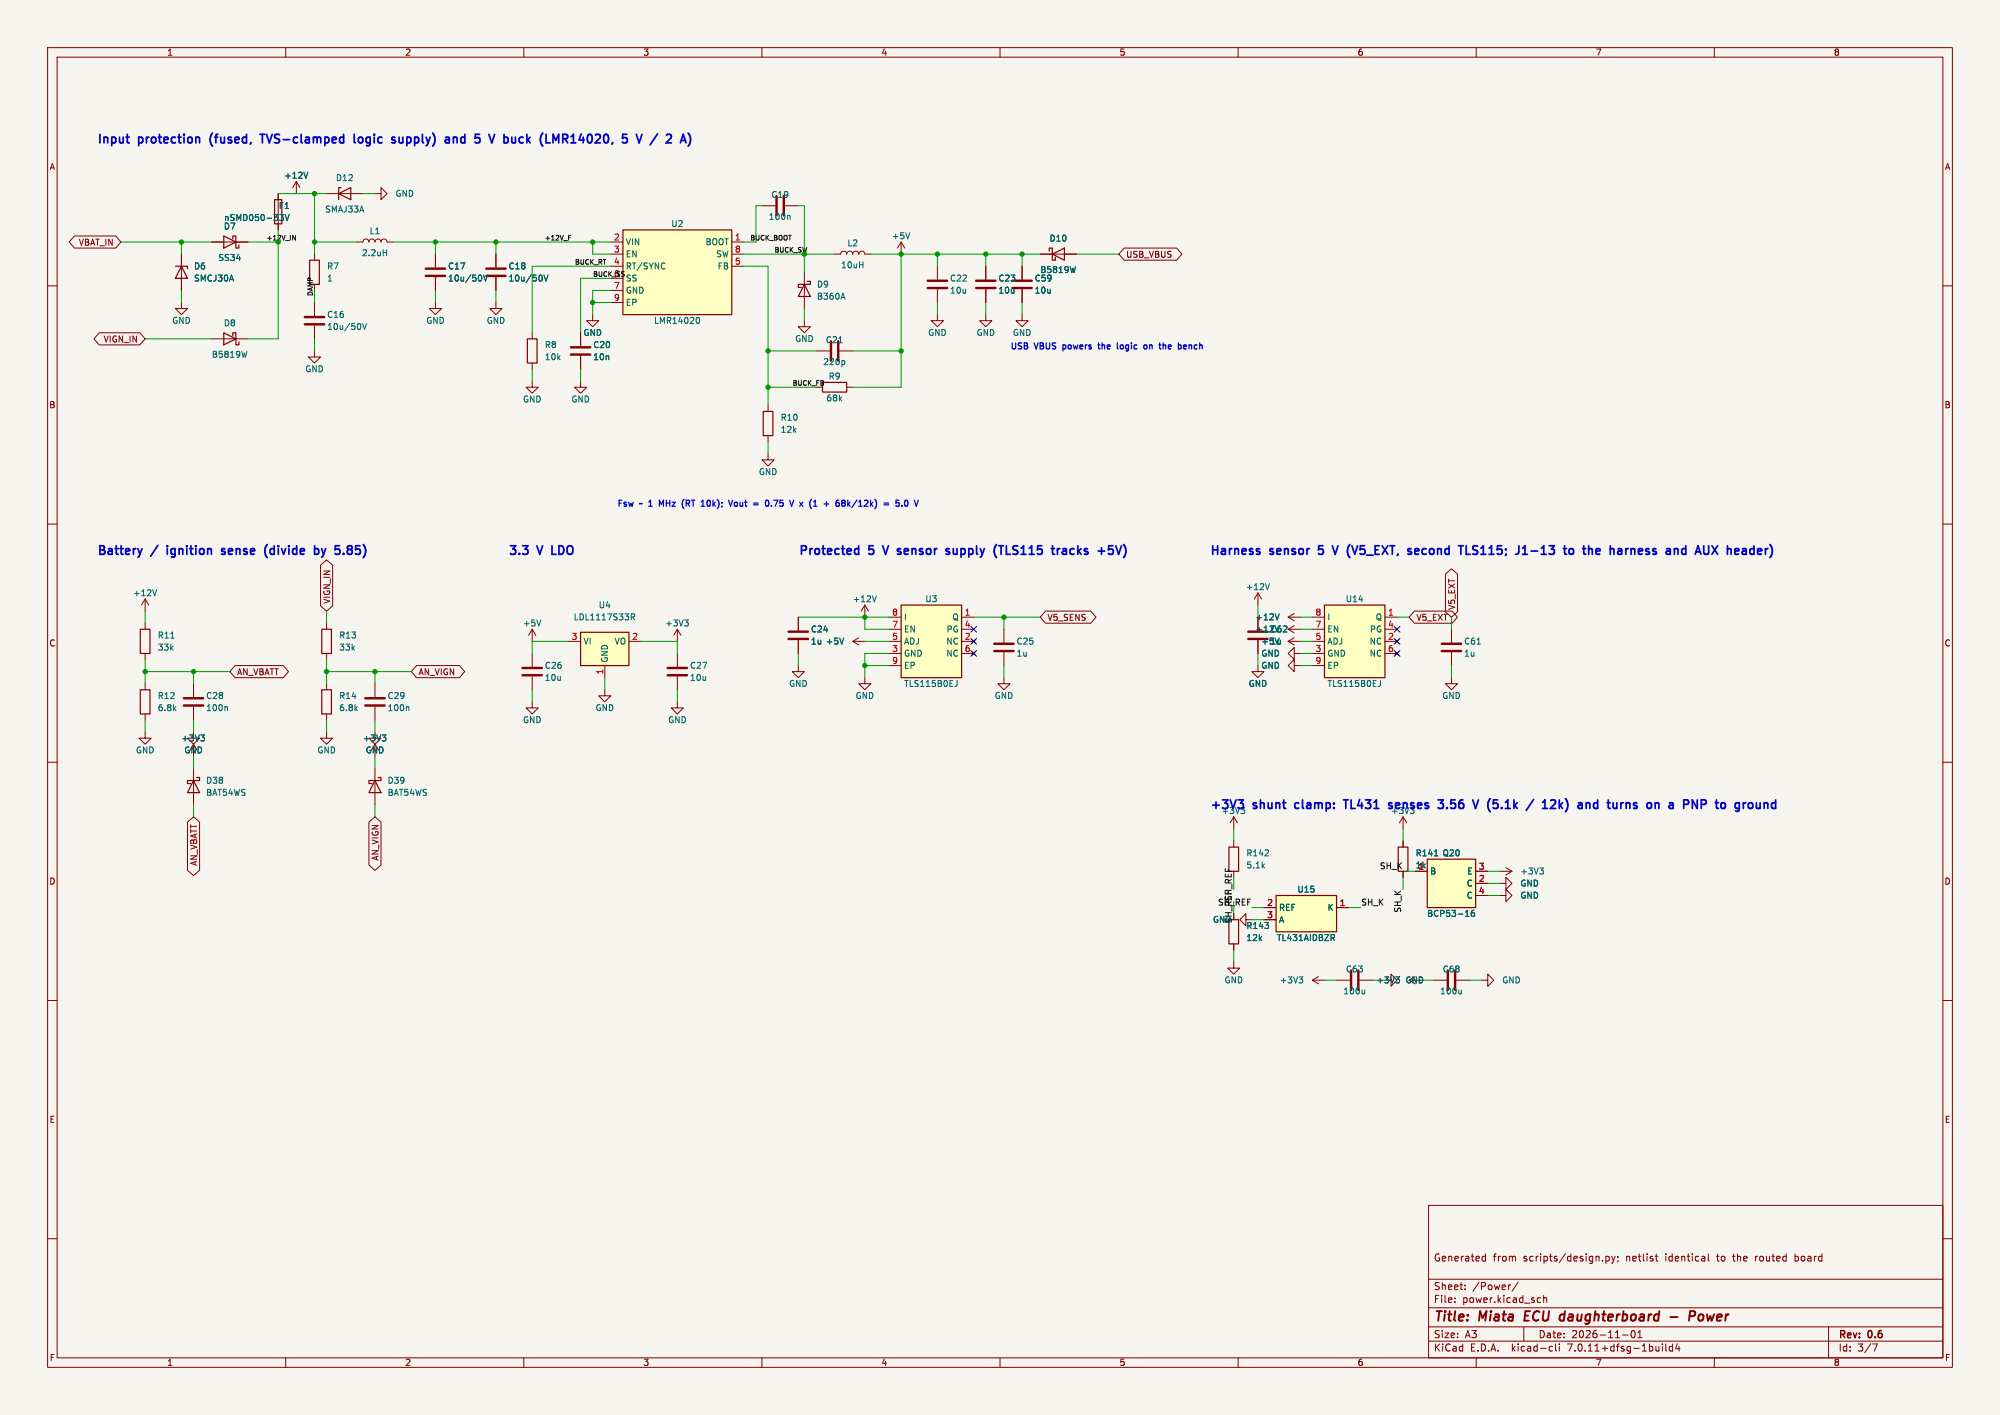
[picture p54: page 3]

GND
USB VBUS powers the logic on the bench

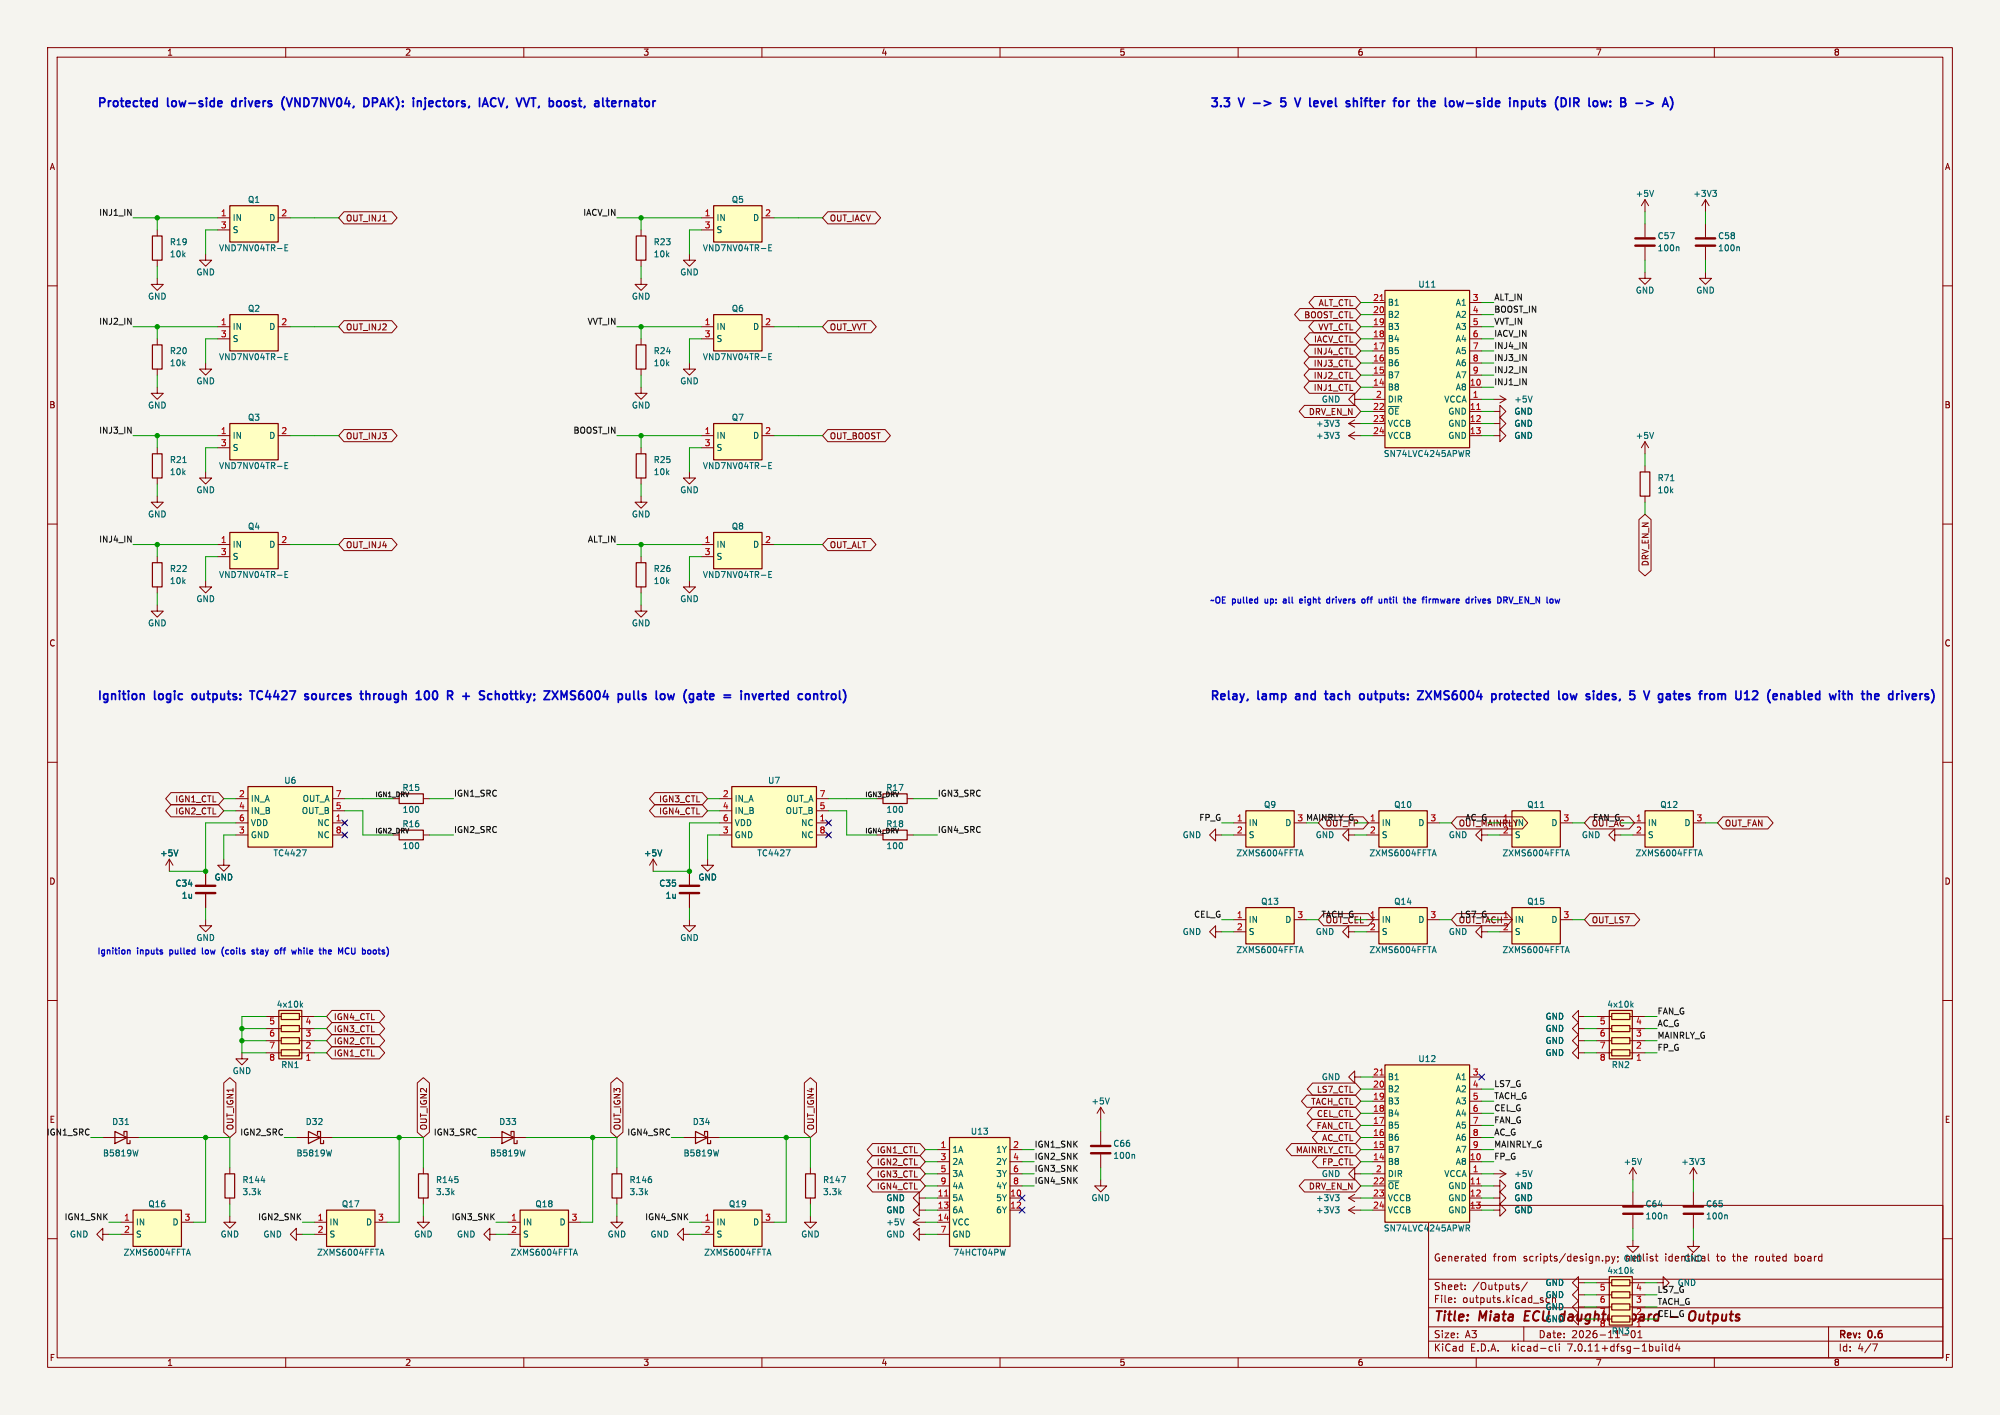
[picture p55: page 4]

Ignition inputs pulled low (coils stay off while the MCU boots)

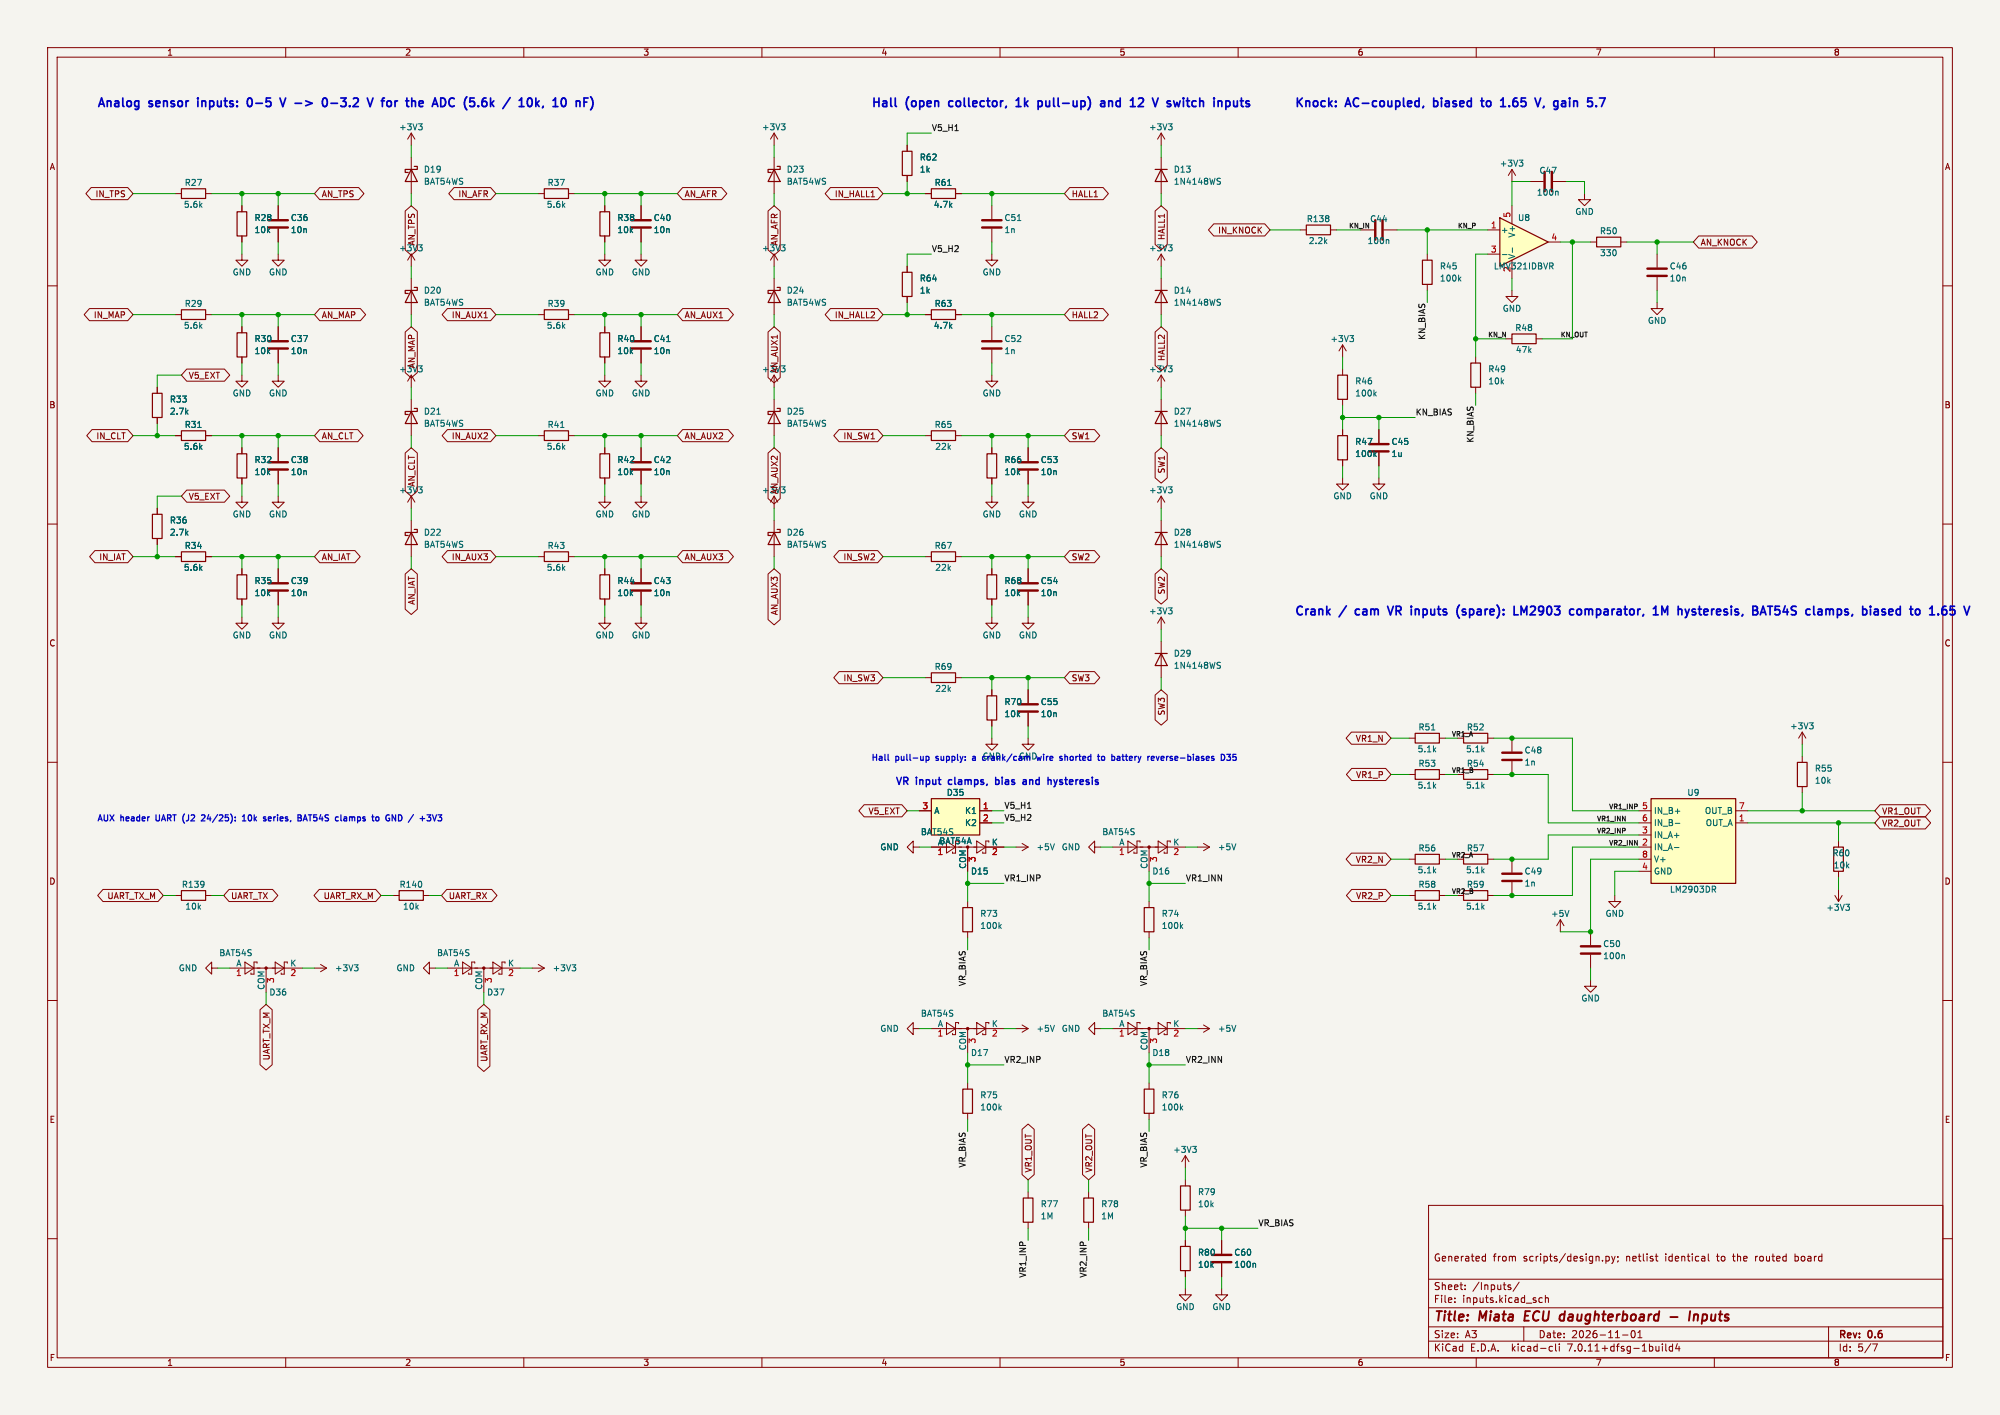
[picture p56: page 5]

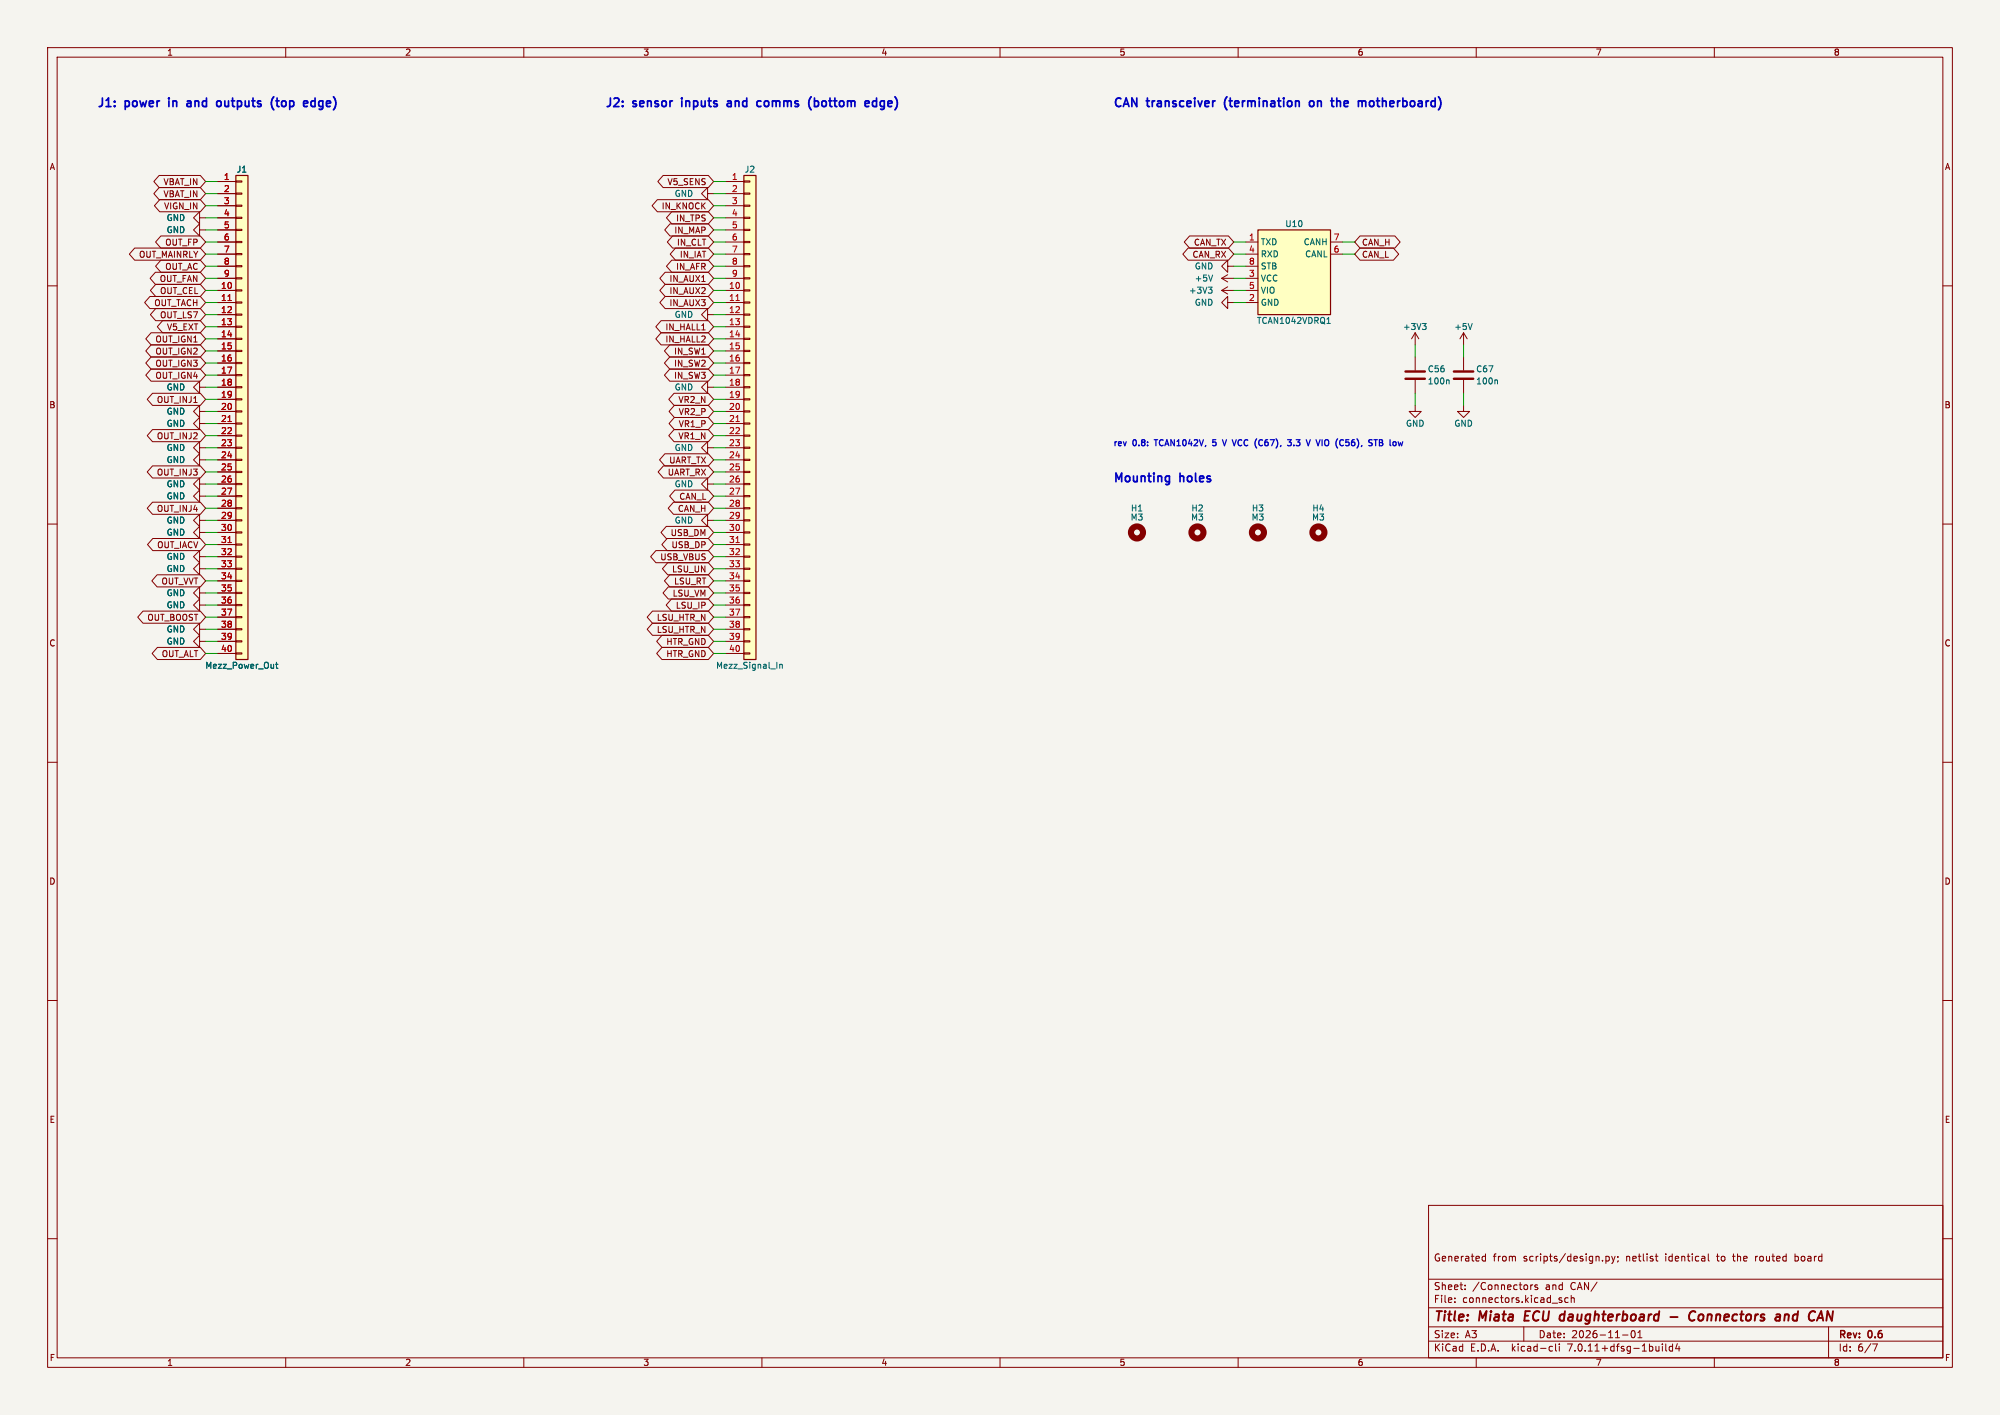
[picture p57: page 6]

9 GND GND GND GND GND GND GND GND GND GND GND GND GND GND GND GND GND
H3 M3 H2 M3 H1 M3 GND GND GND GND GND GND GND GND GND

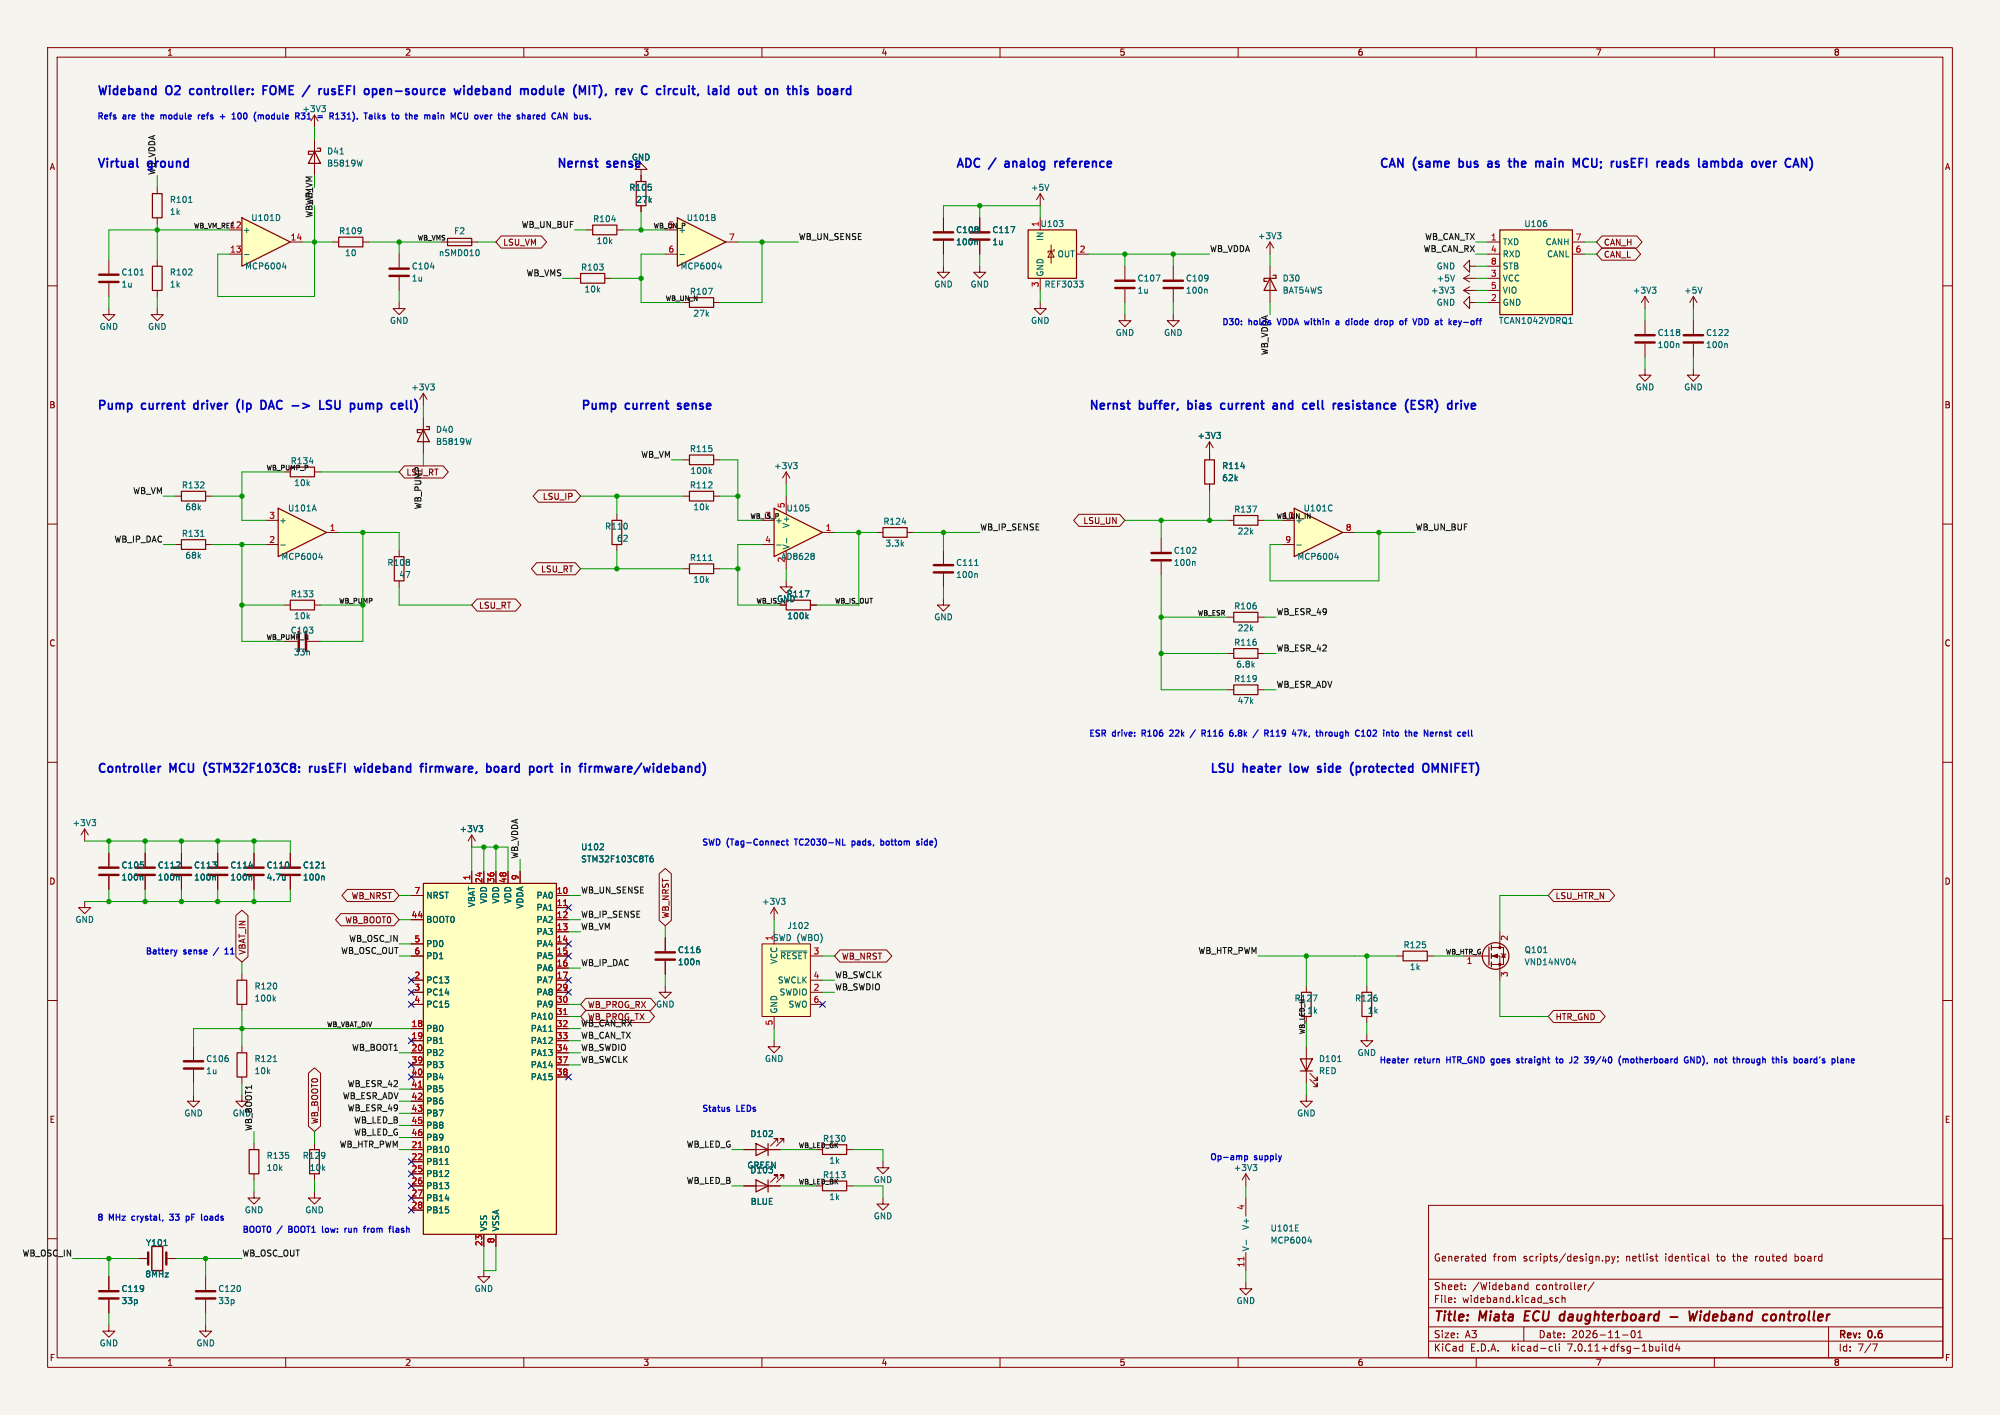
[picture p58: page 7]

Refs are the module refs + 100 (module R31 = R131). Talks to the main MCU over the shared CAN bus.

CAN (same bus as the main MCU; rusEFI reads lambda over CAN)

D30: holds VDDA within a diode drop of VDD at key-off

Nernst buffer, bias current and cell resistance (ESR) drive

1 PA0 10 PA1 11 PA2 12 PA3 13 PA4 14 PA5 15 PA6 16 PA7 17 PB0 18 PB1 19 PC13 2 PB2 20 PB10 21 PB11 22 VSS 23 VDD 24 PB12 25 PB13 26 PB14 27 PB15 28 PA8 29 PC14 3 PA9 30 PA10 31 PA11 32 PA12 33 PA13 34 VDD 36 PA14 37 PA15 38 PB3 39 PC15 4 PB4 40 PB5 41 PB6 42 PB7 43 BOOT0 44 PB8 45 PB9 46 VDD 48 PD0 5 PD1 6 NRST 7 VSSA

1 SWDIO 2 ~{RESET}3 SWCLK 4 GND
1k GND VCC

8 MHz crystal, 33 pF loads
