v3ai/miata-ecus/motherboards/1989-93/miata_mb_8993_schematic.pdf

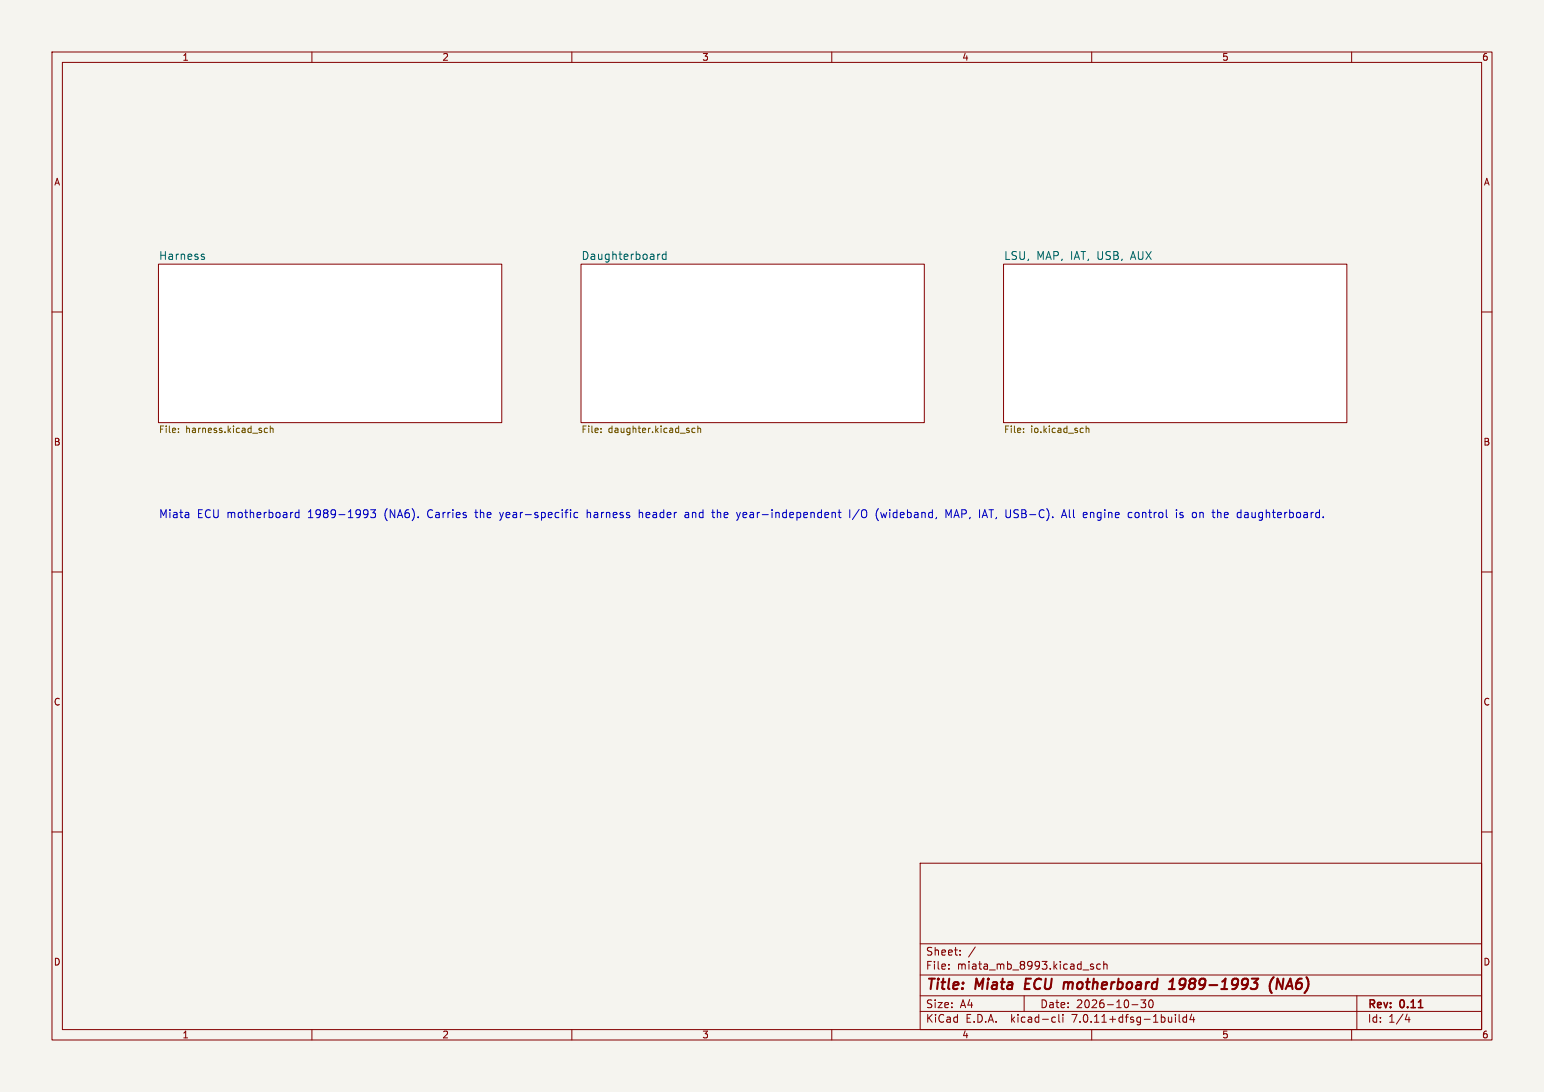
[picture p59: page 1]

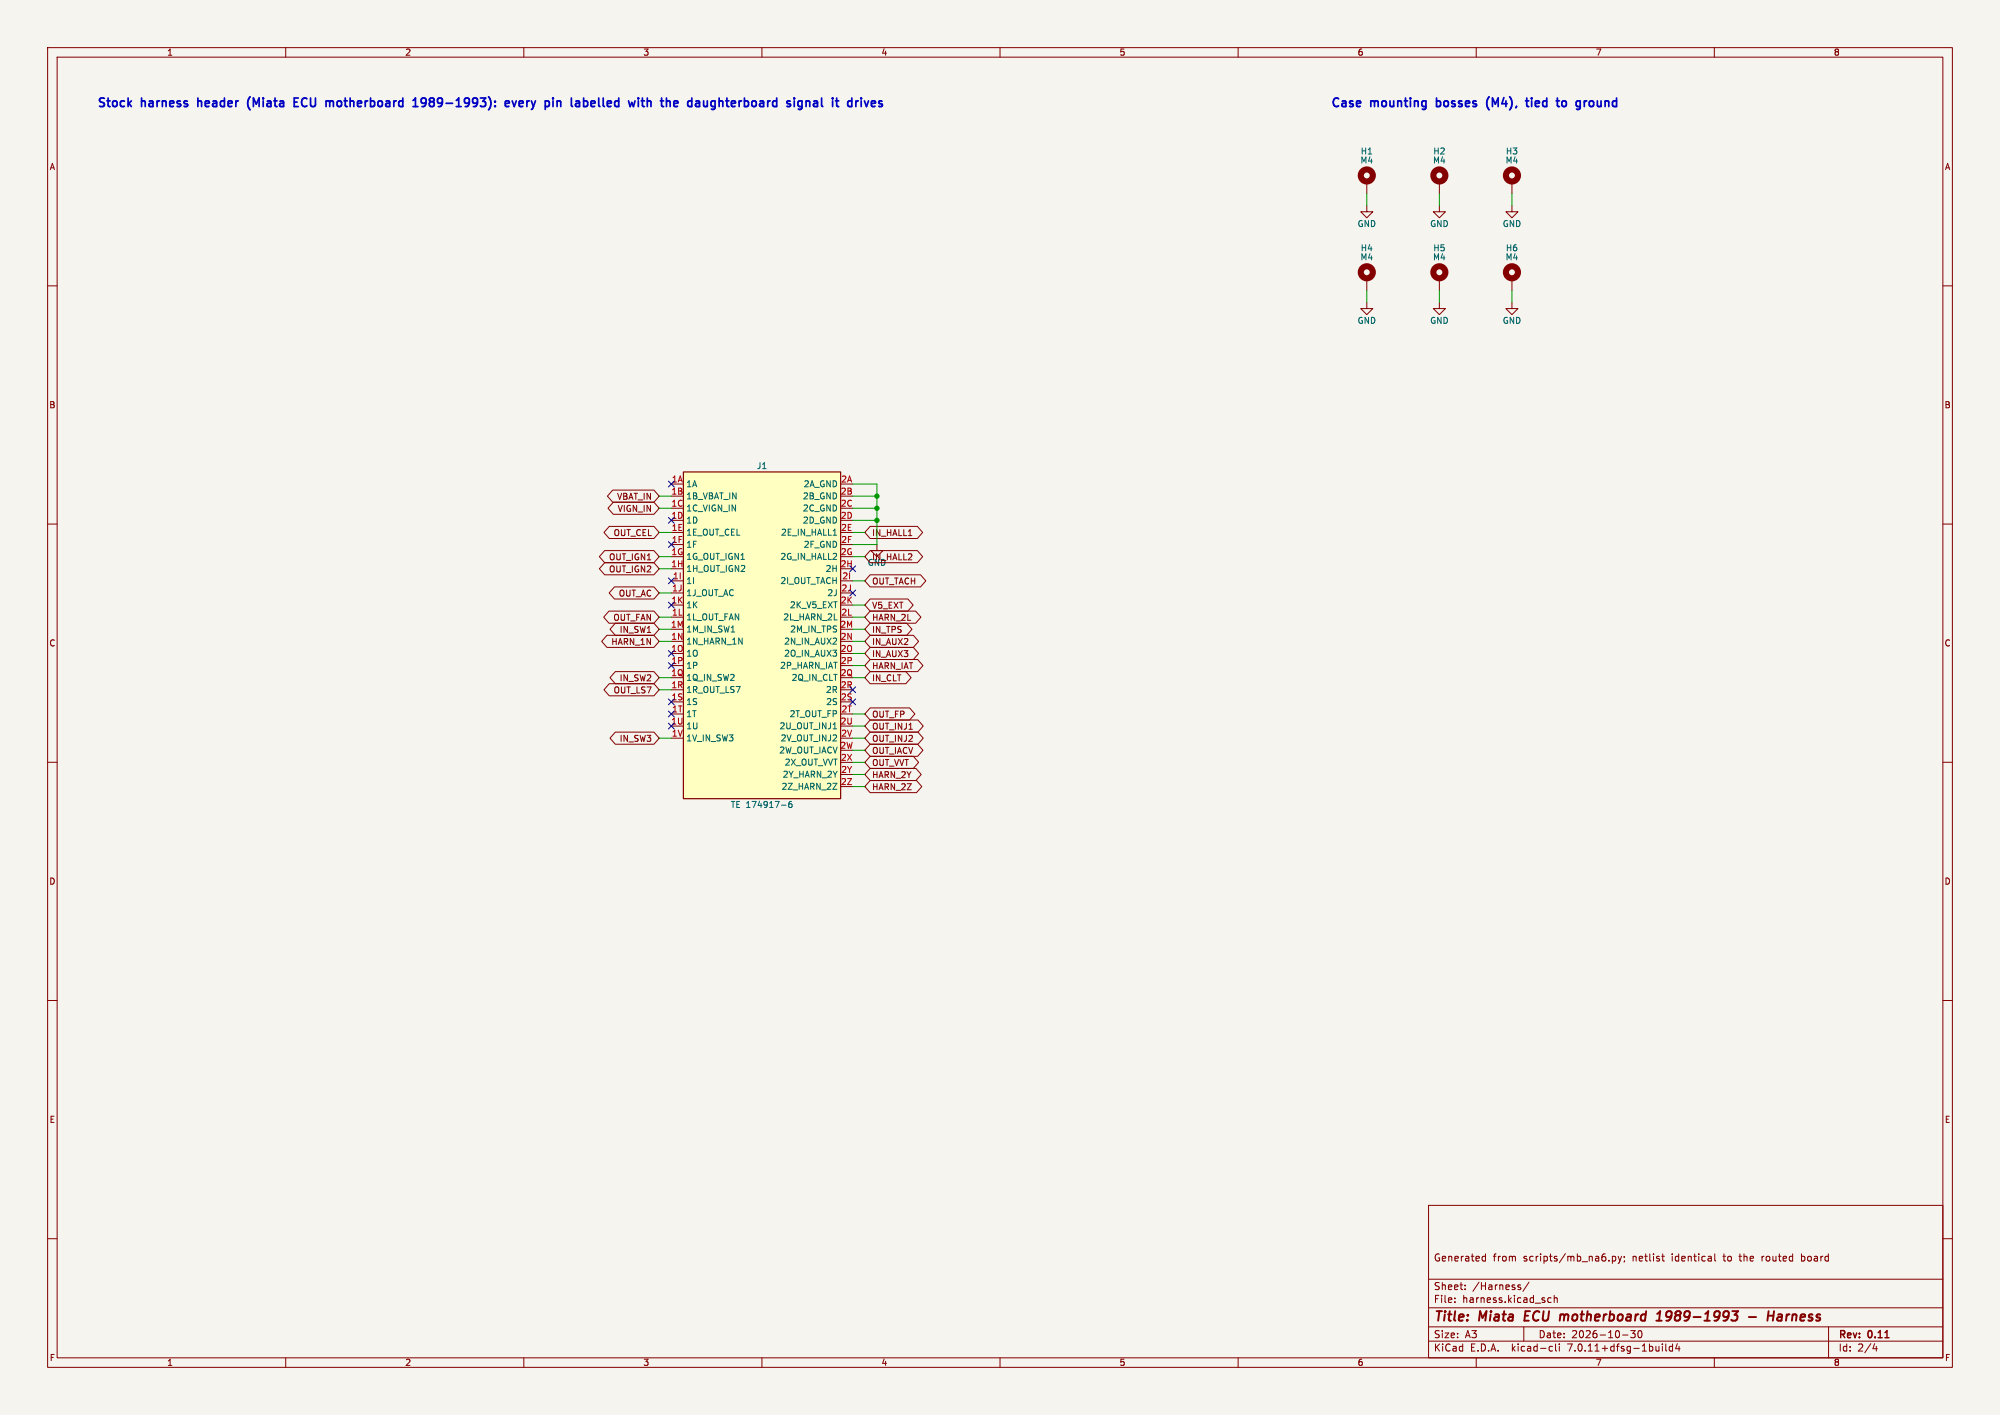
[picture p60: page 2]

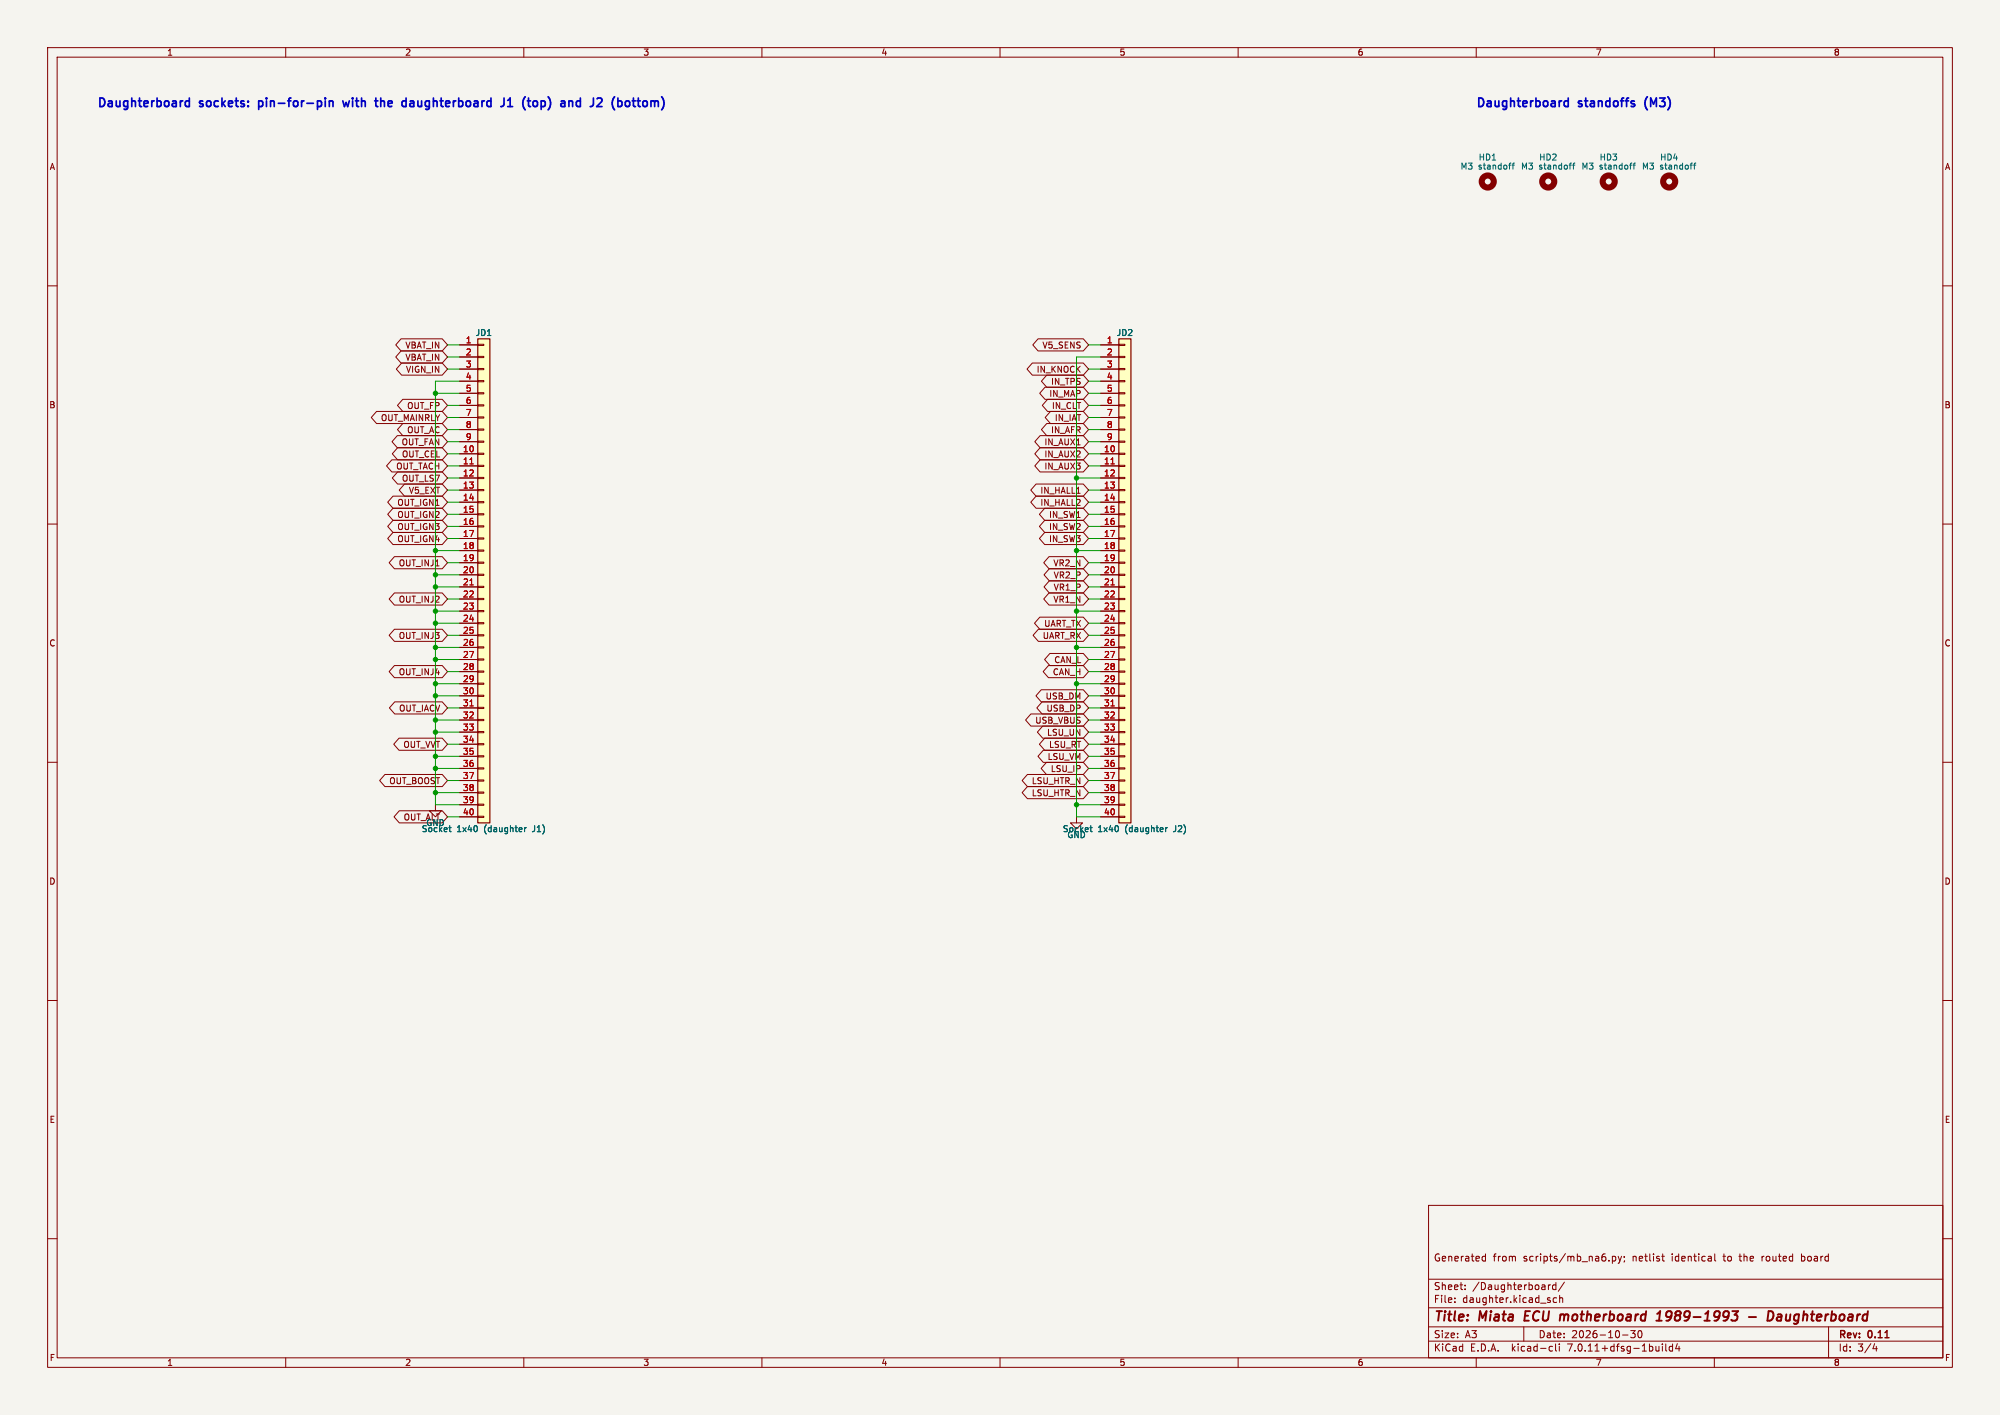
[picture p61: page 3]

HD4 M3 standoff HD3 M3 standoff HD2 M3 standoff HD1 M3 standoff GND

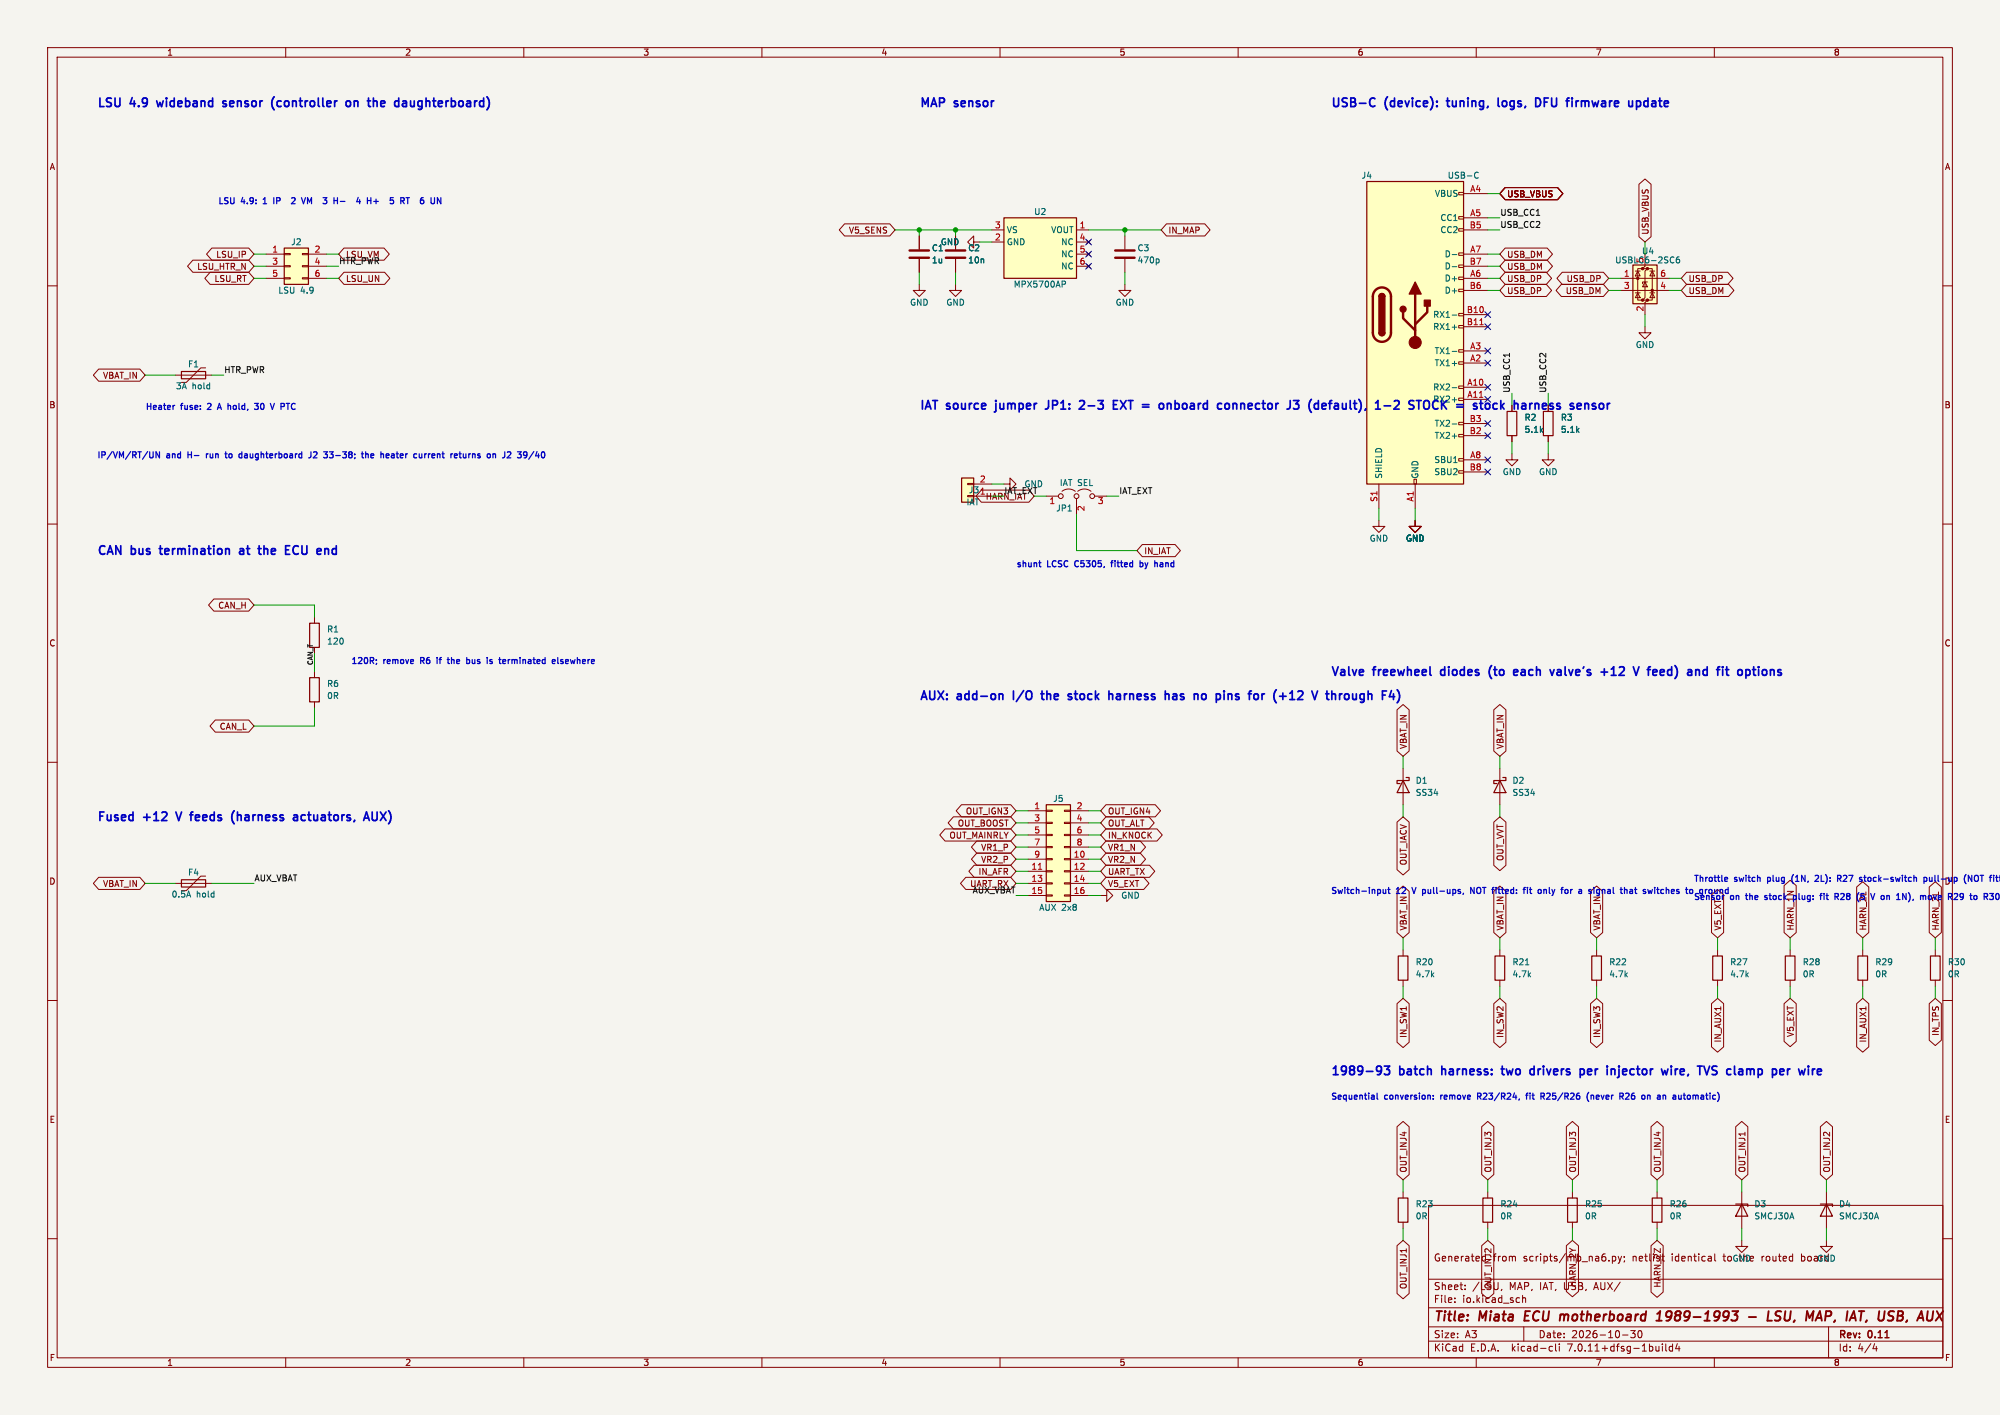
[picture p62: page 4]
