v3ai/miata-ecus/motherboards/1994-95/miata_mb_9495_schematic.pdf

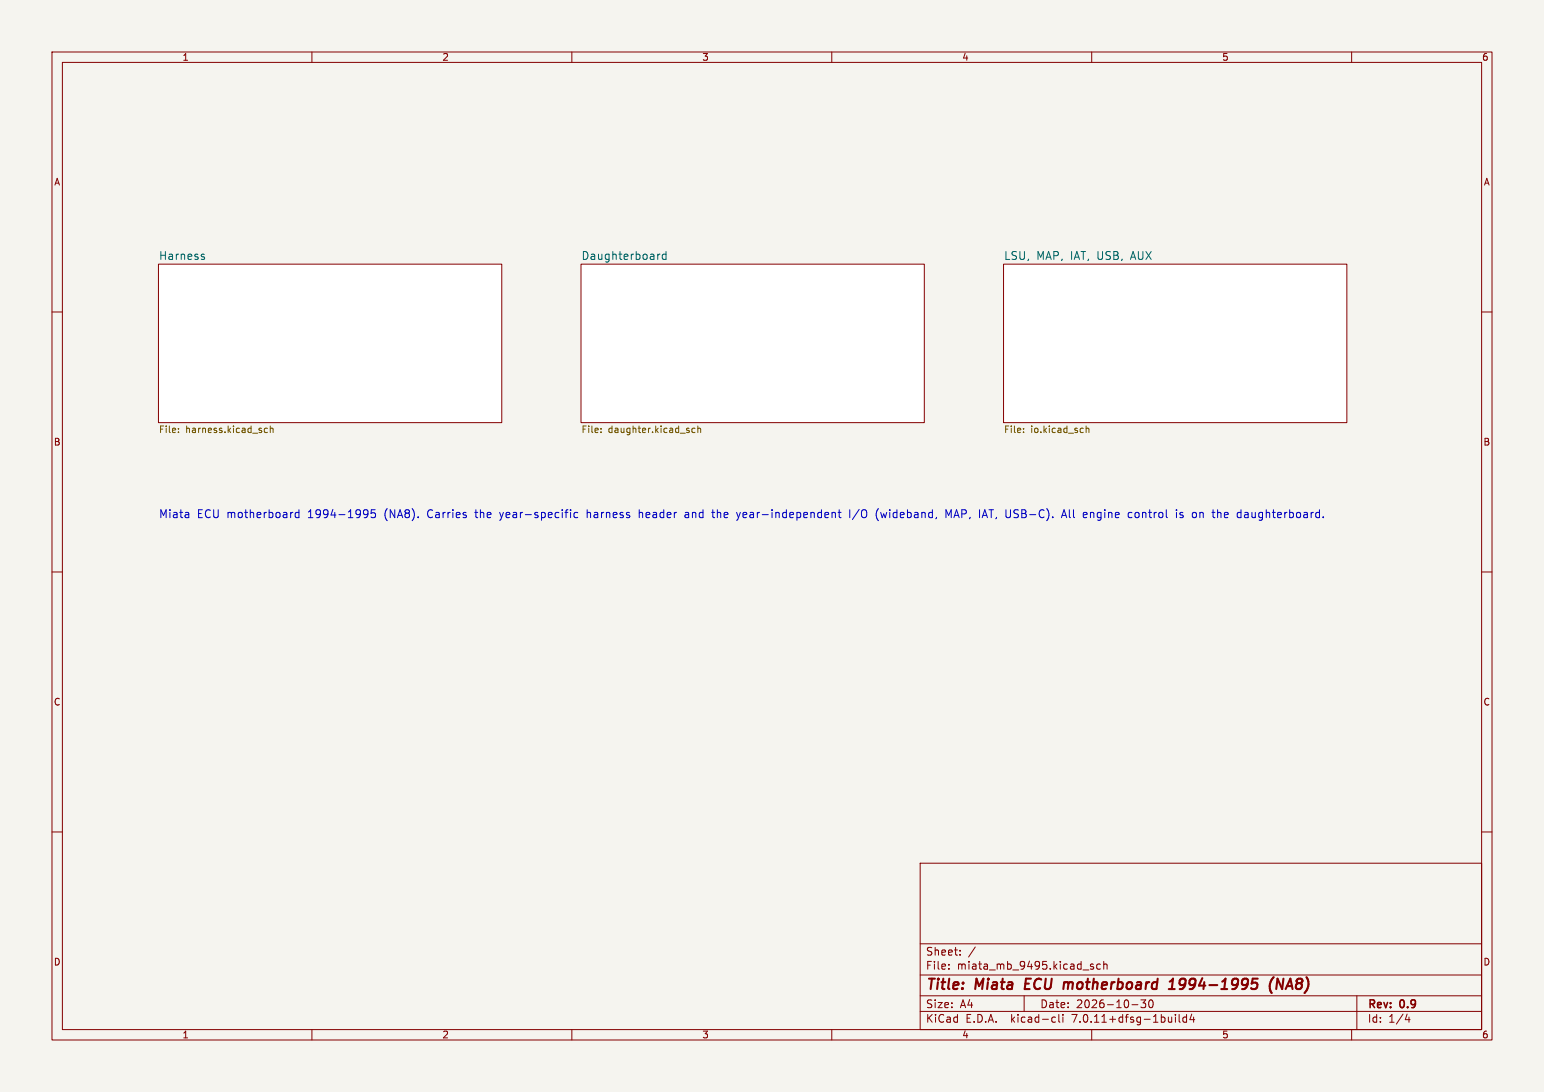
[picture p63: page 1]

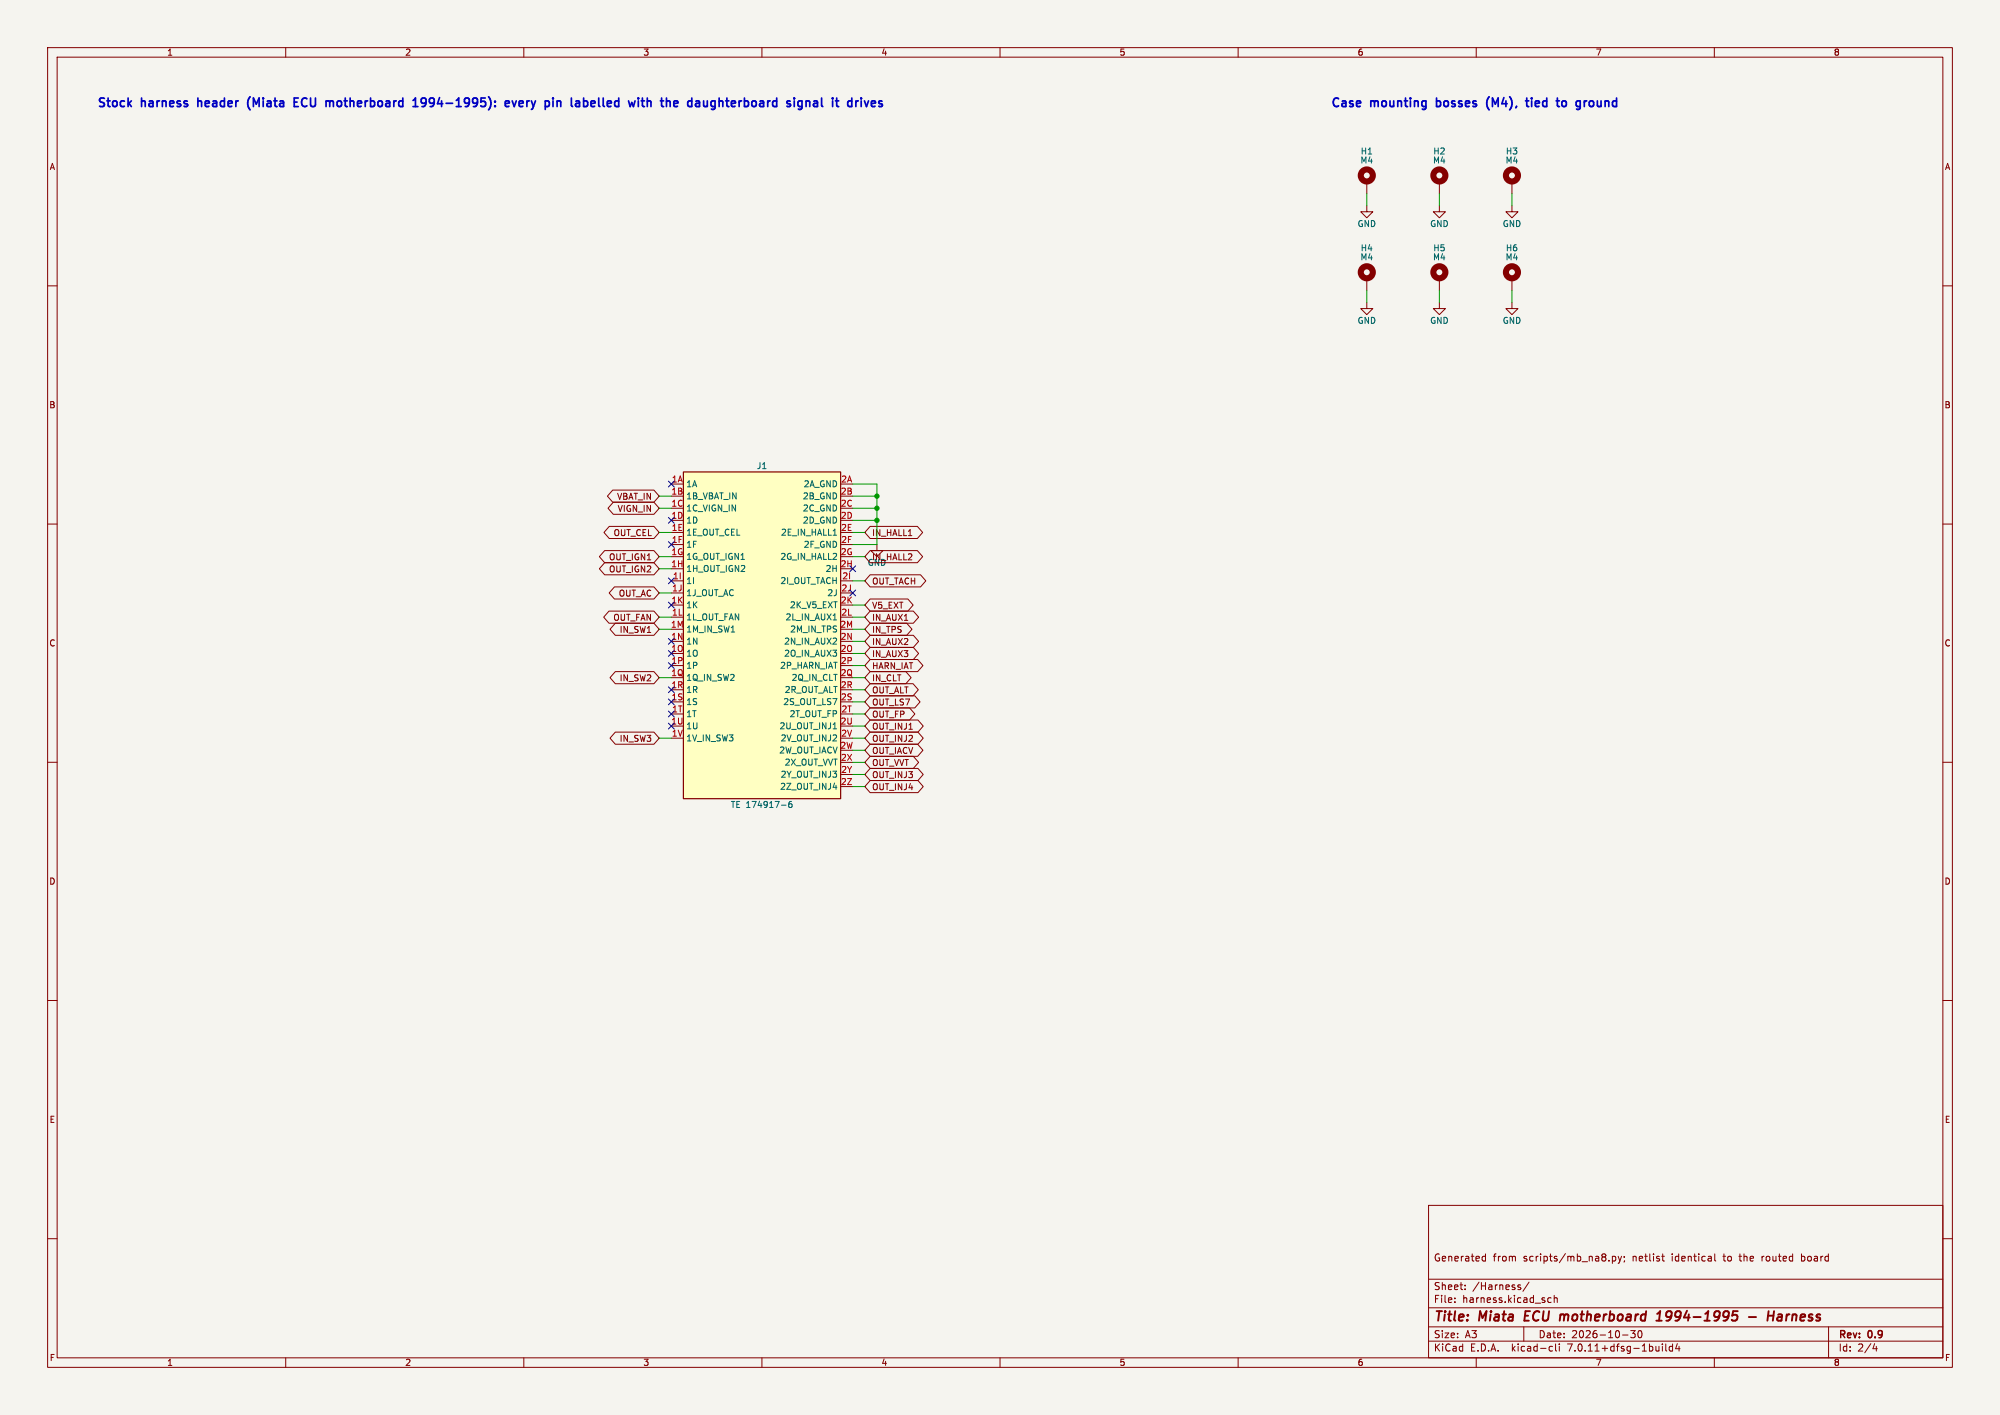
[picture p64: page 2]

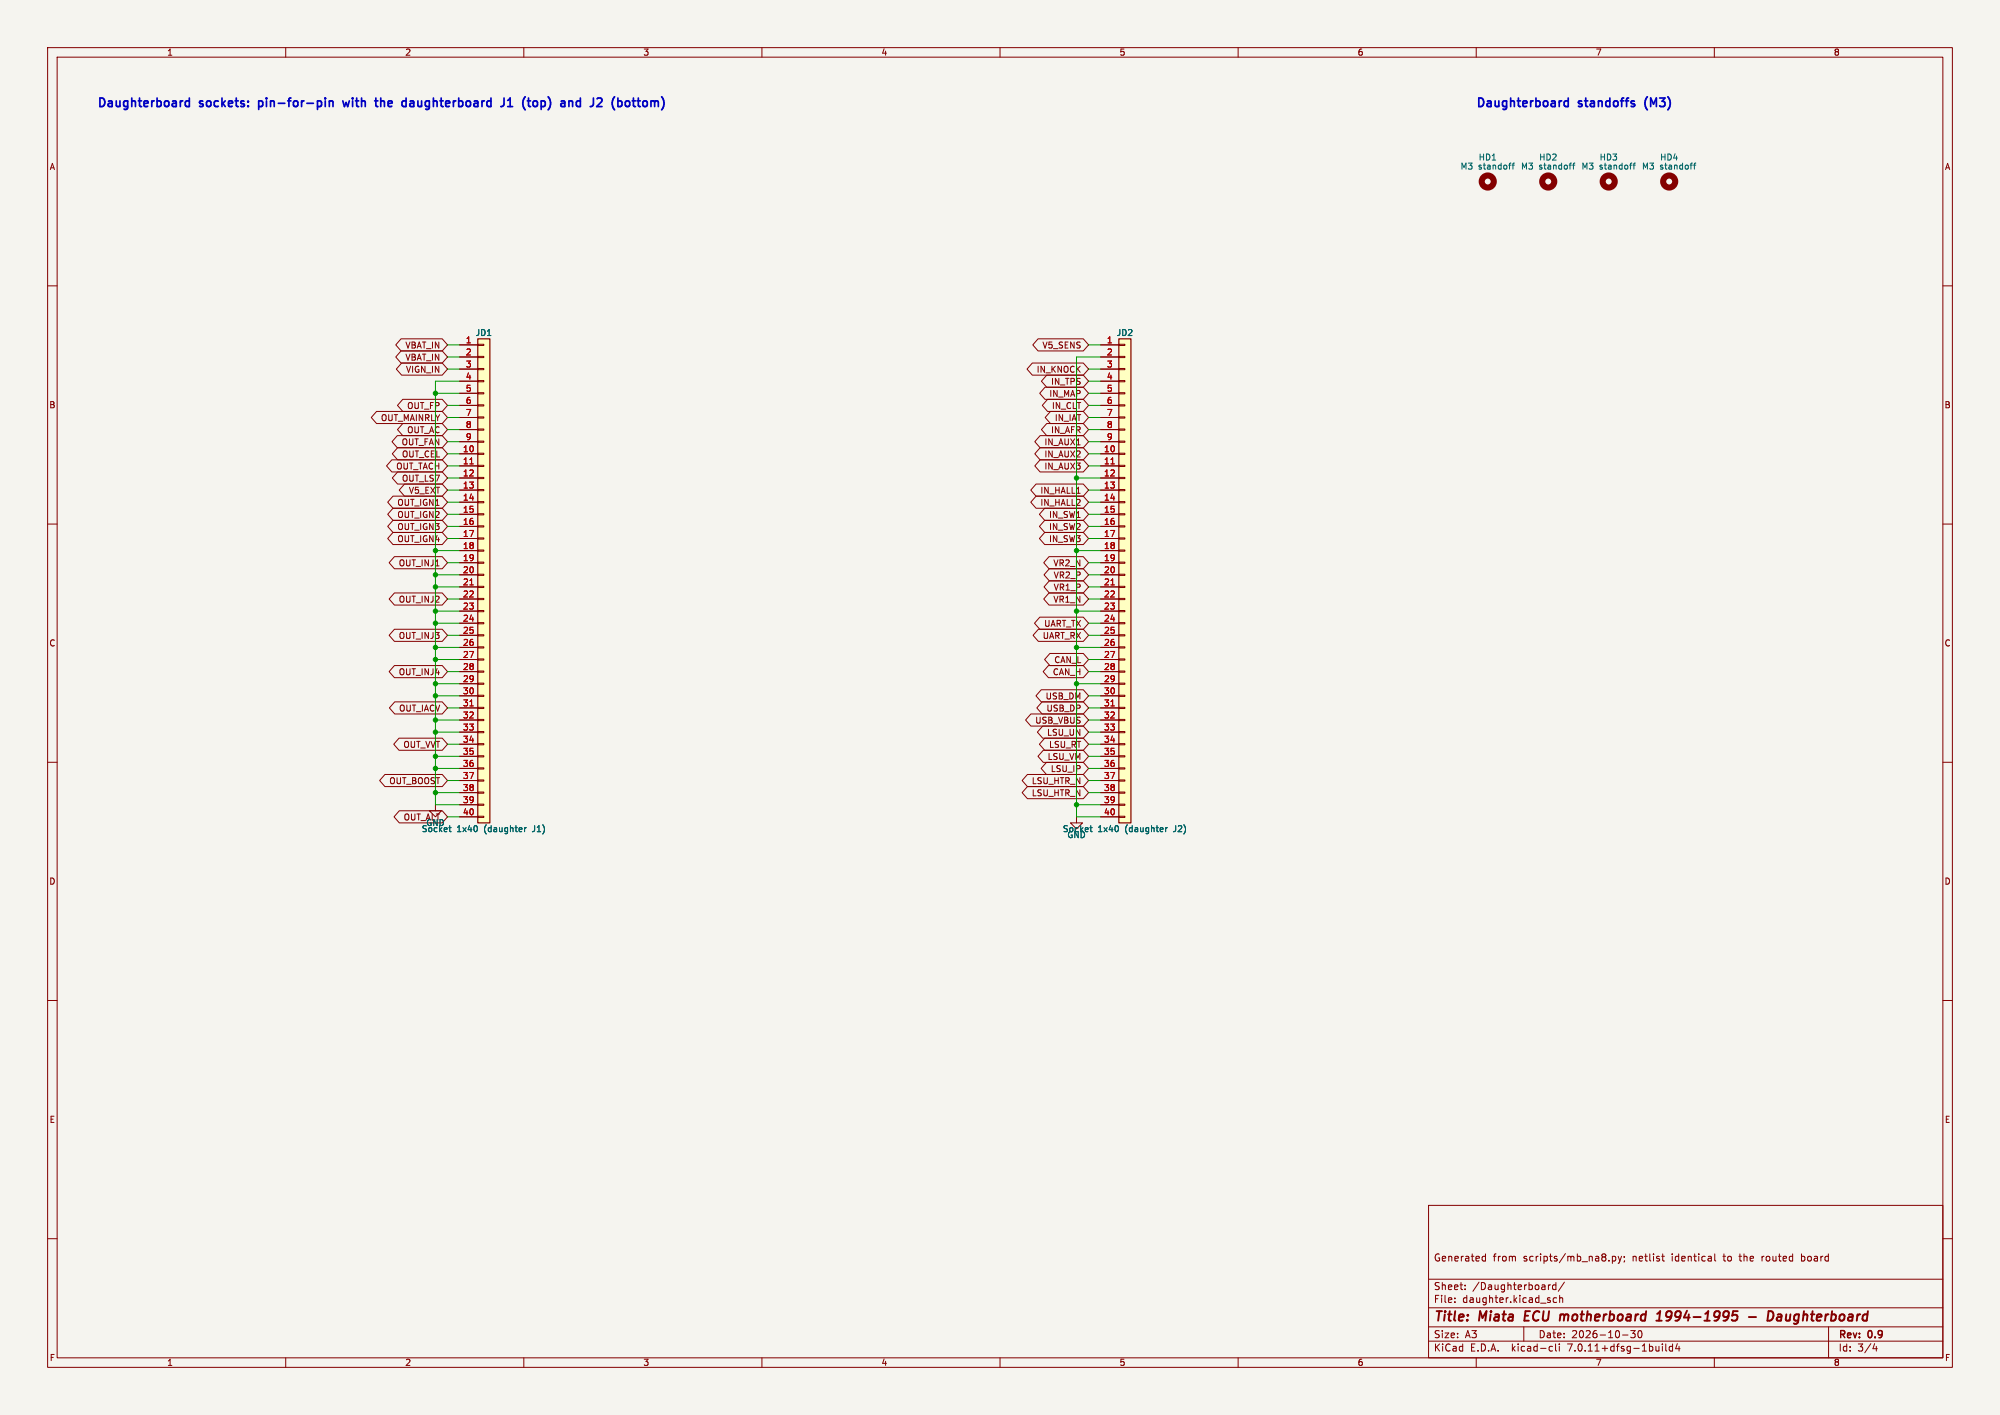
[picture p65: page 3]

HD4 M3 standoff HD3 M3 standoff HD2 M3 standoff HD1 M3 standoff GND

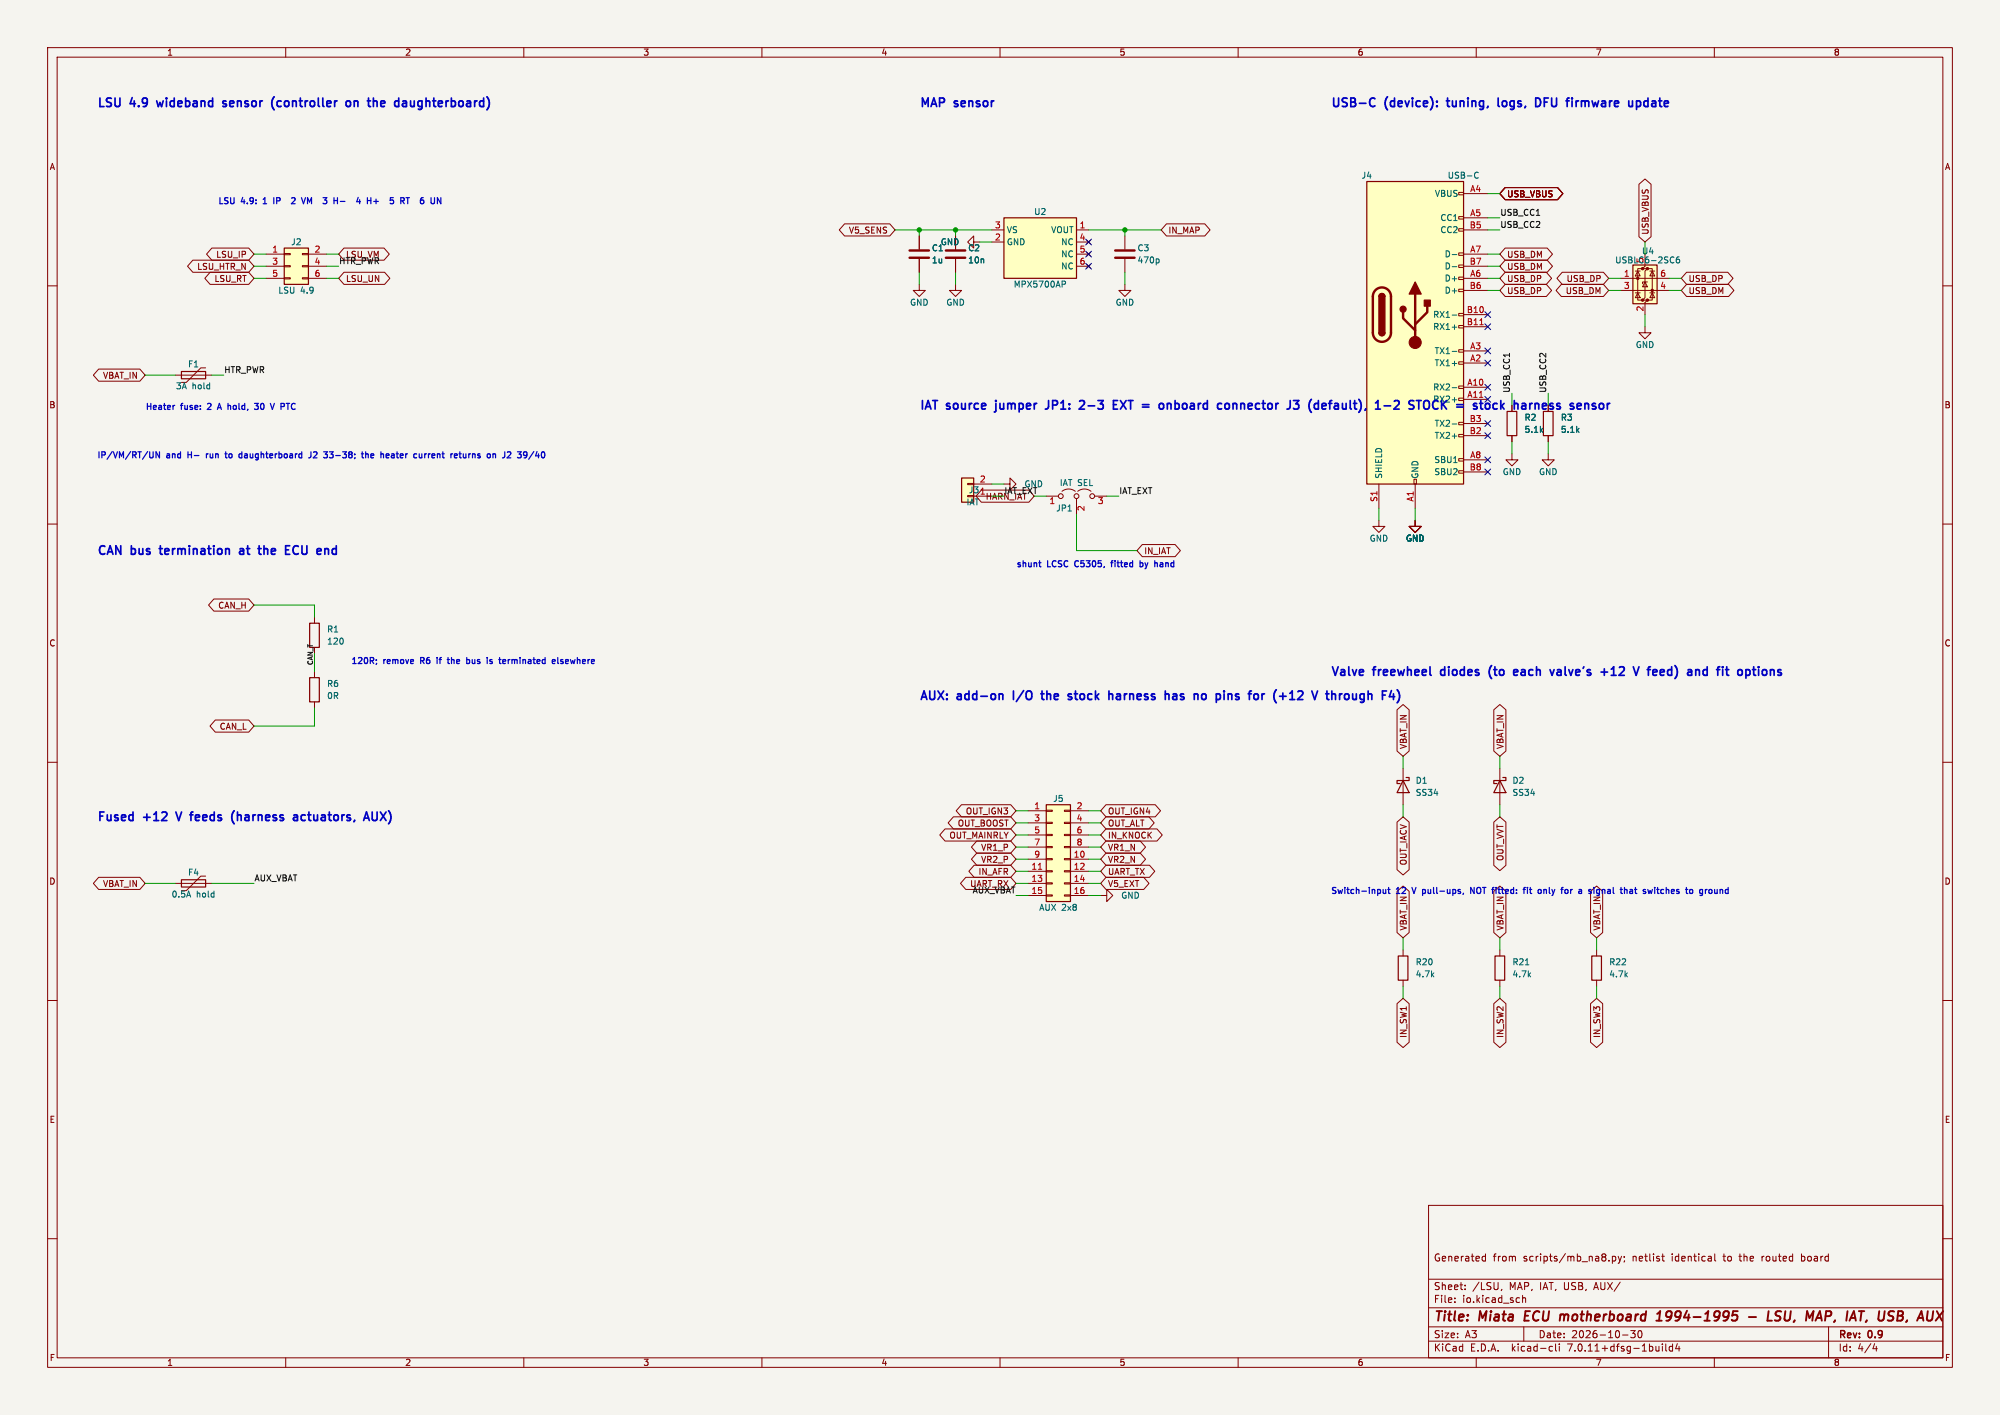
[picture p66: page 4]

Valve freewheel diodes (to each valve's +12 V feed) and fit options
