v3ai/miata-ecus/motherboards/2001-05/miata_mb_0105_schematic.pdf

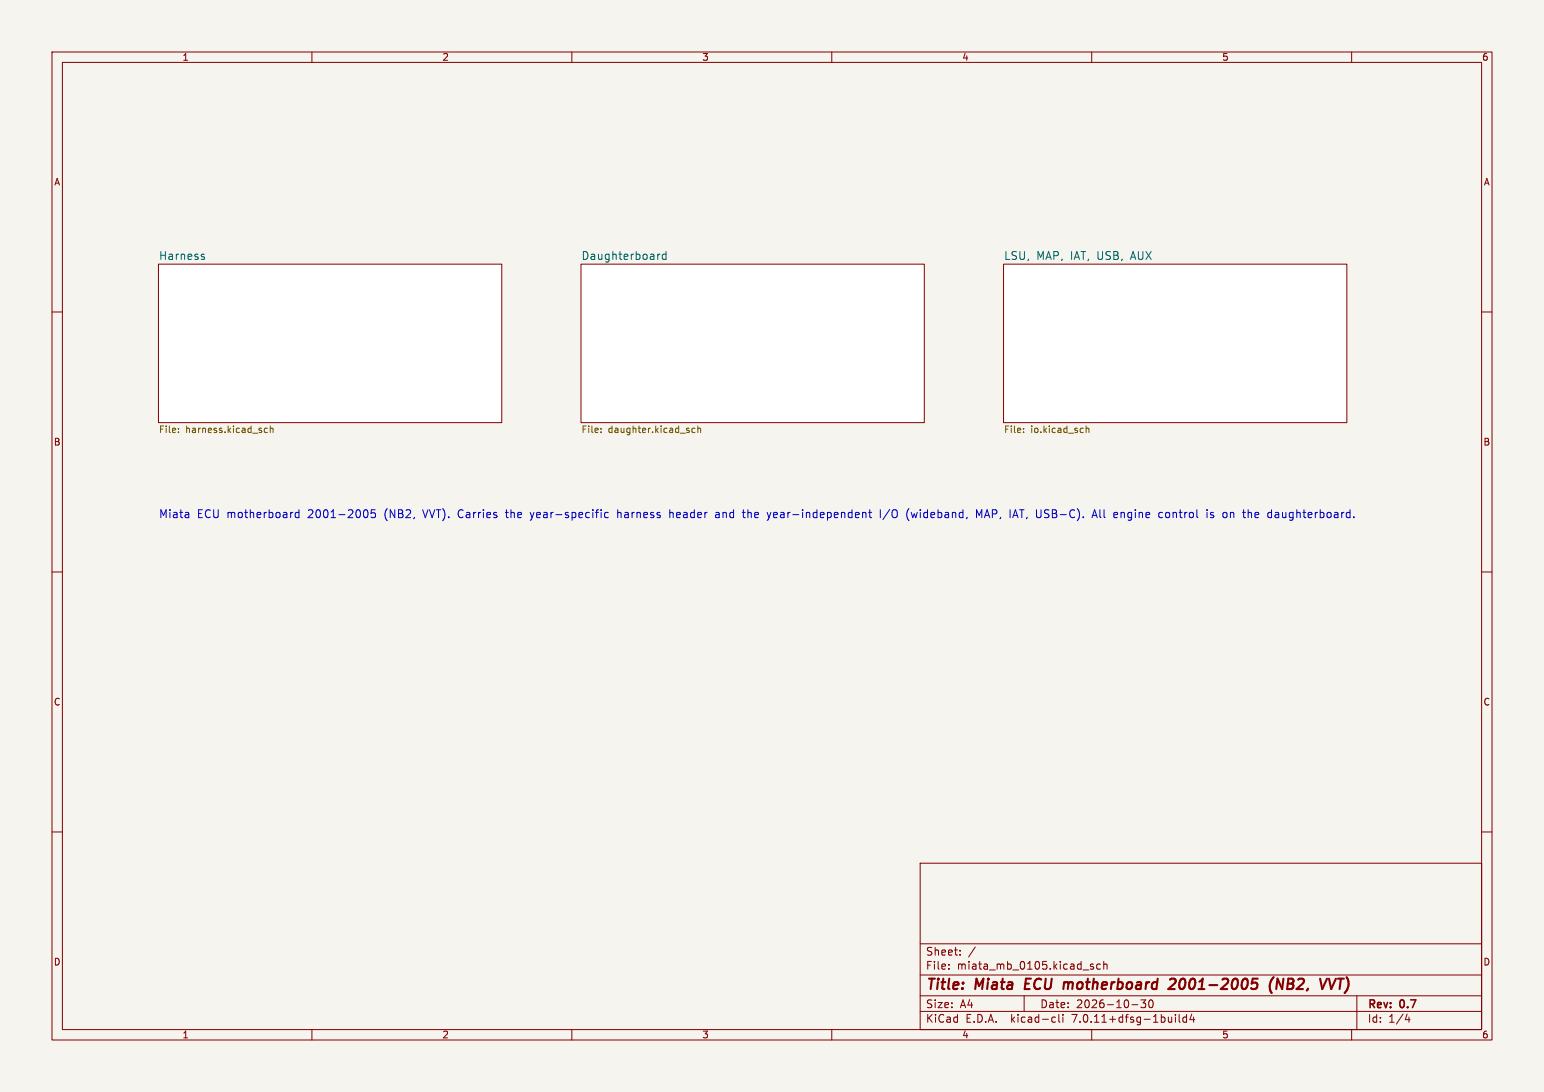
[picture p67: page 1]

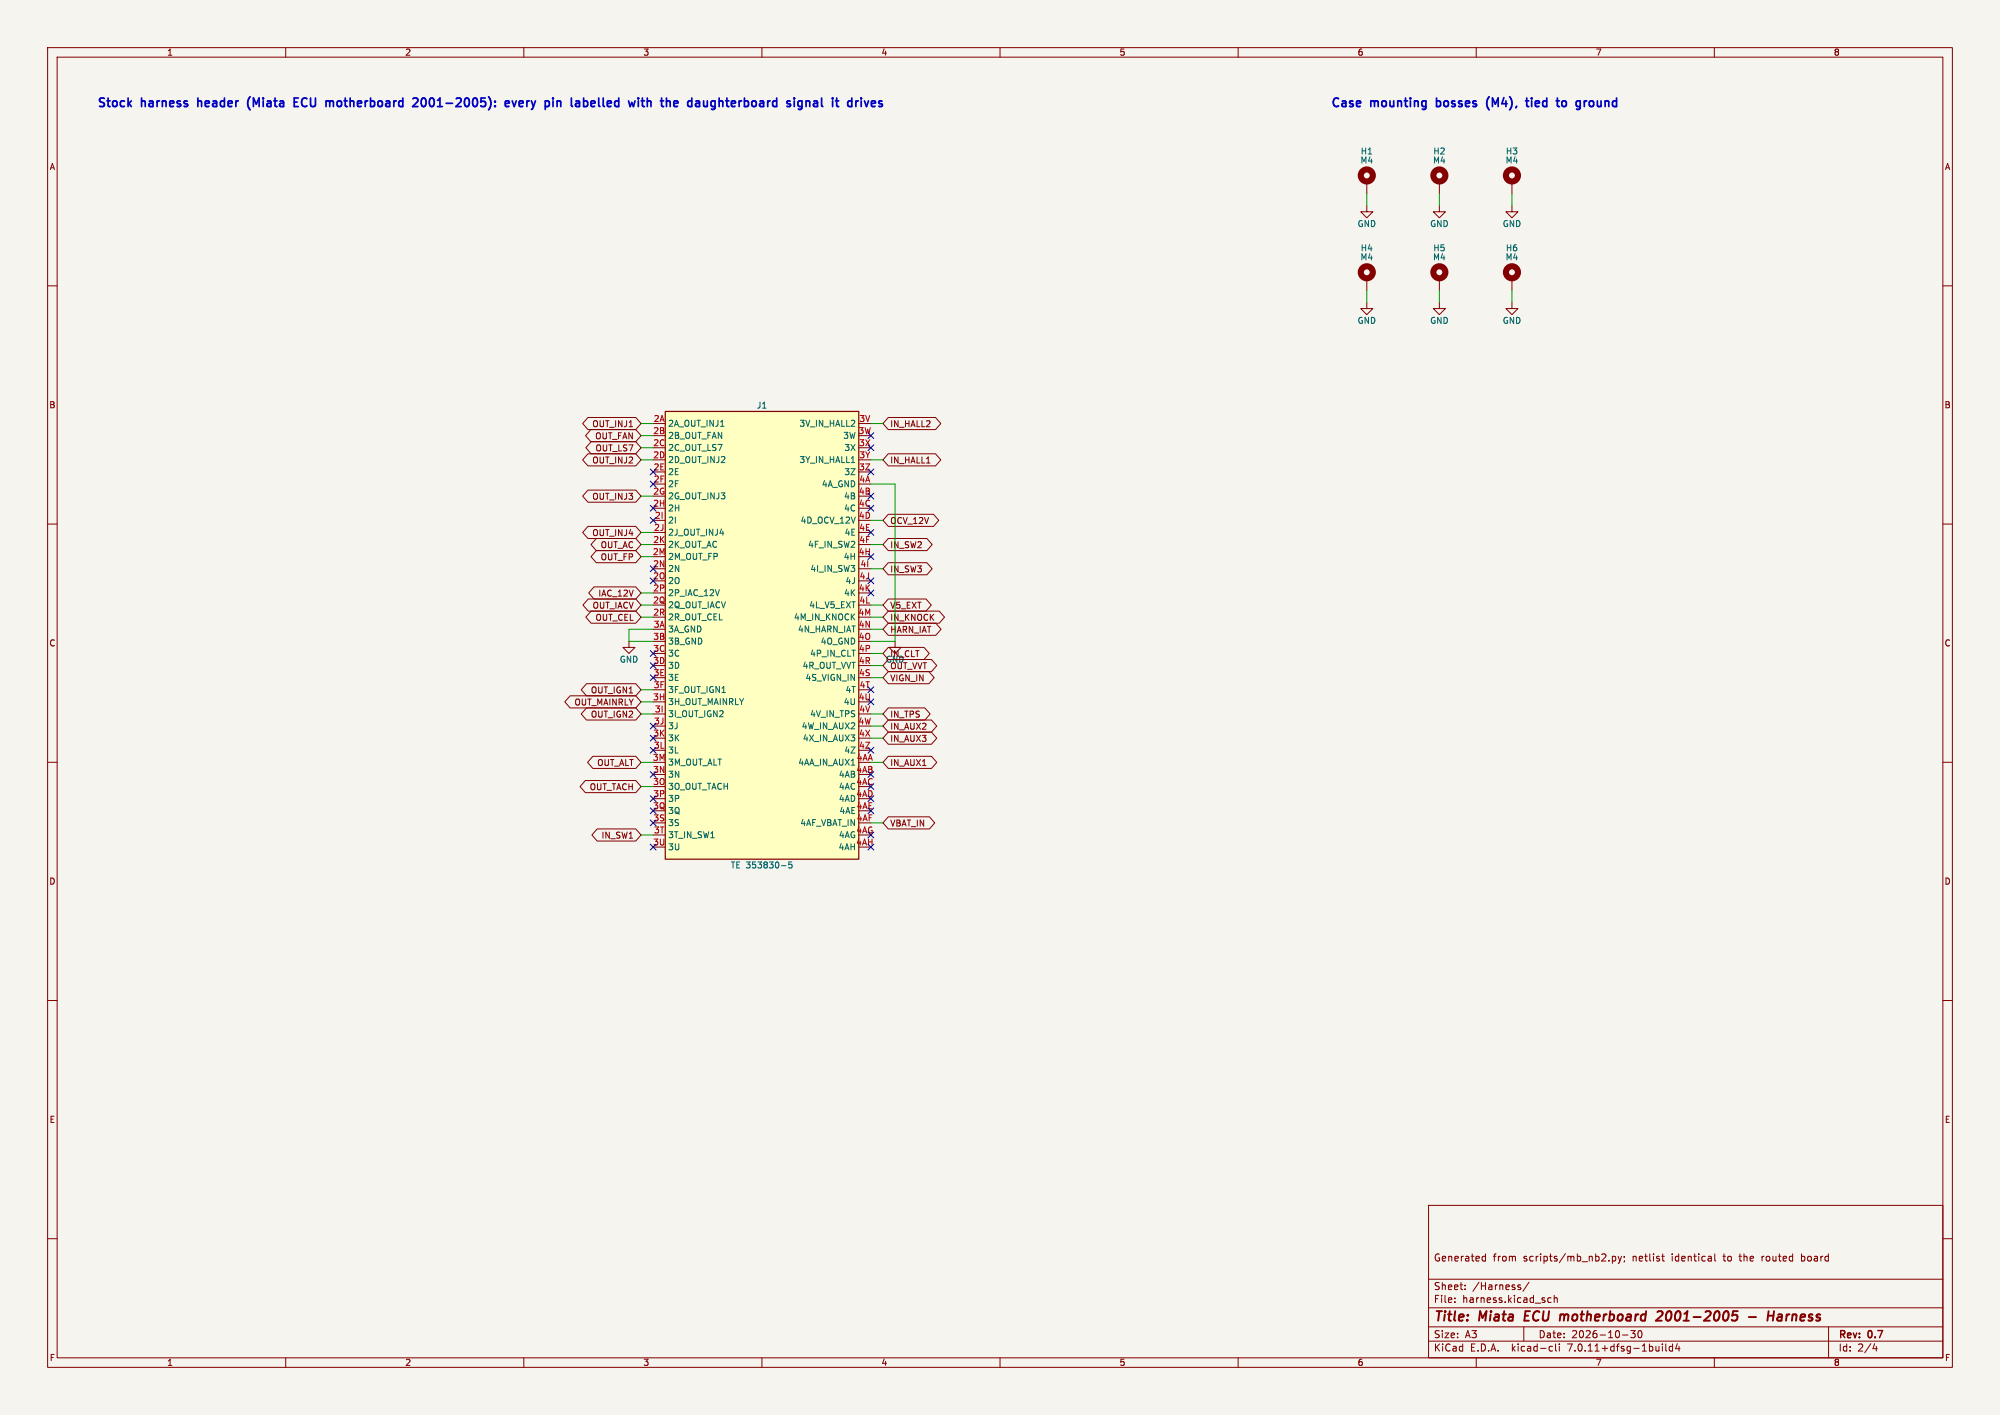
[picture p68: page 2]

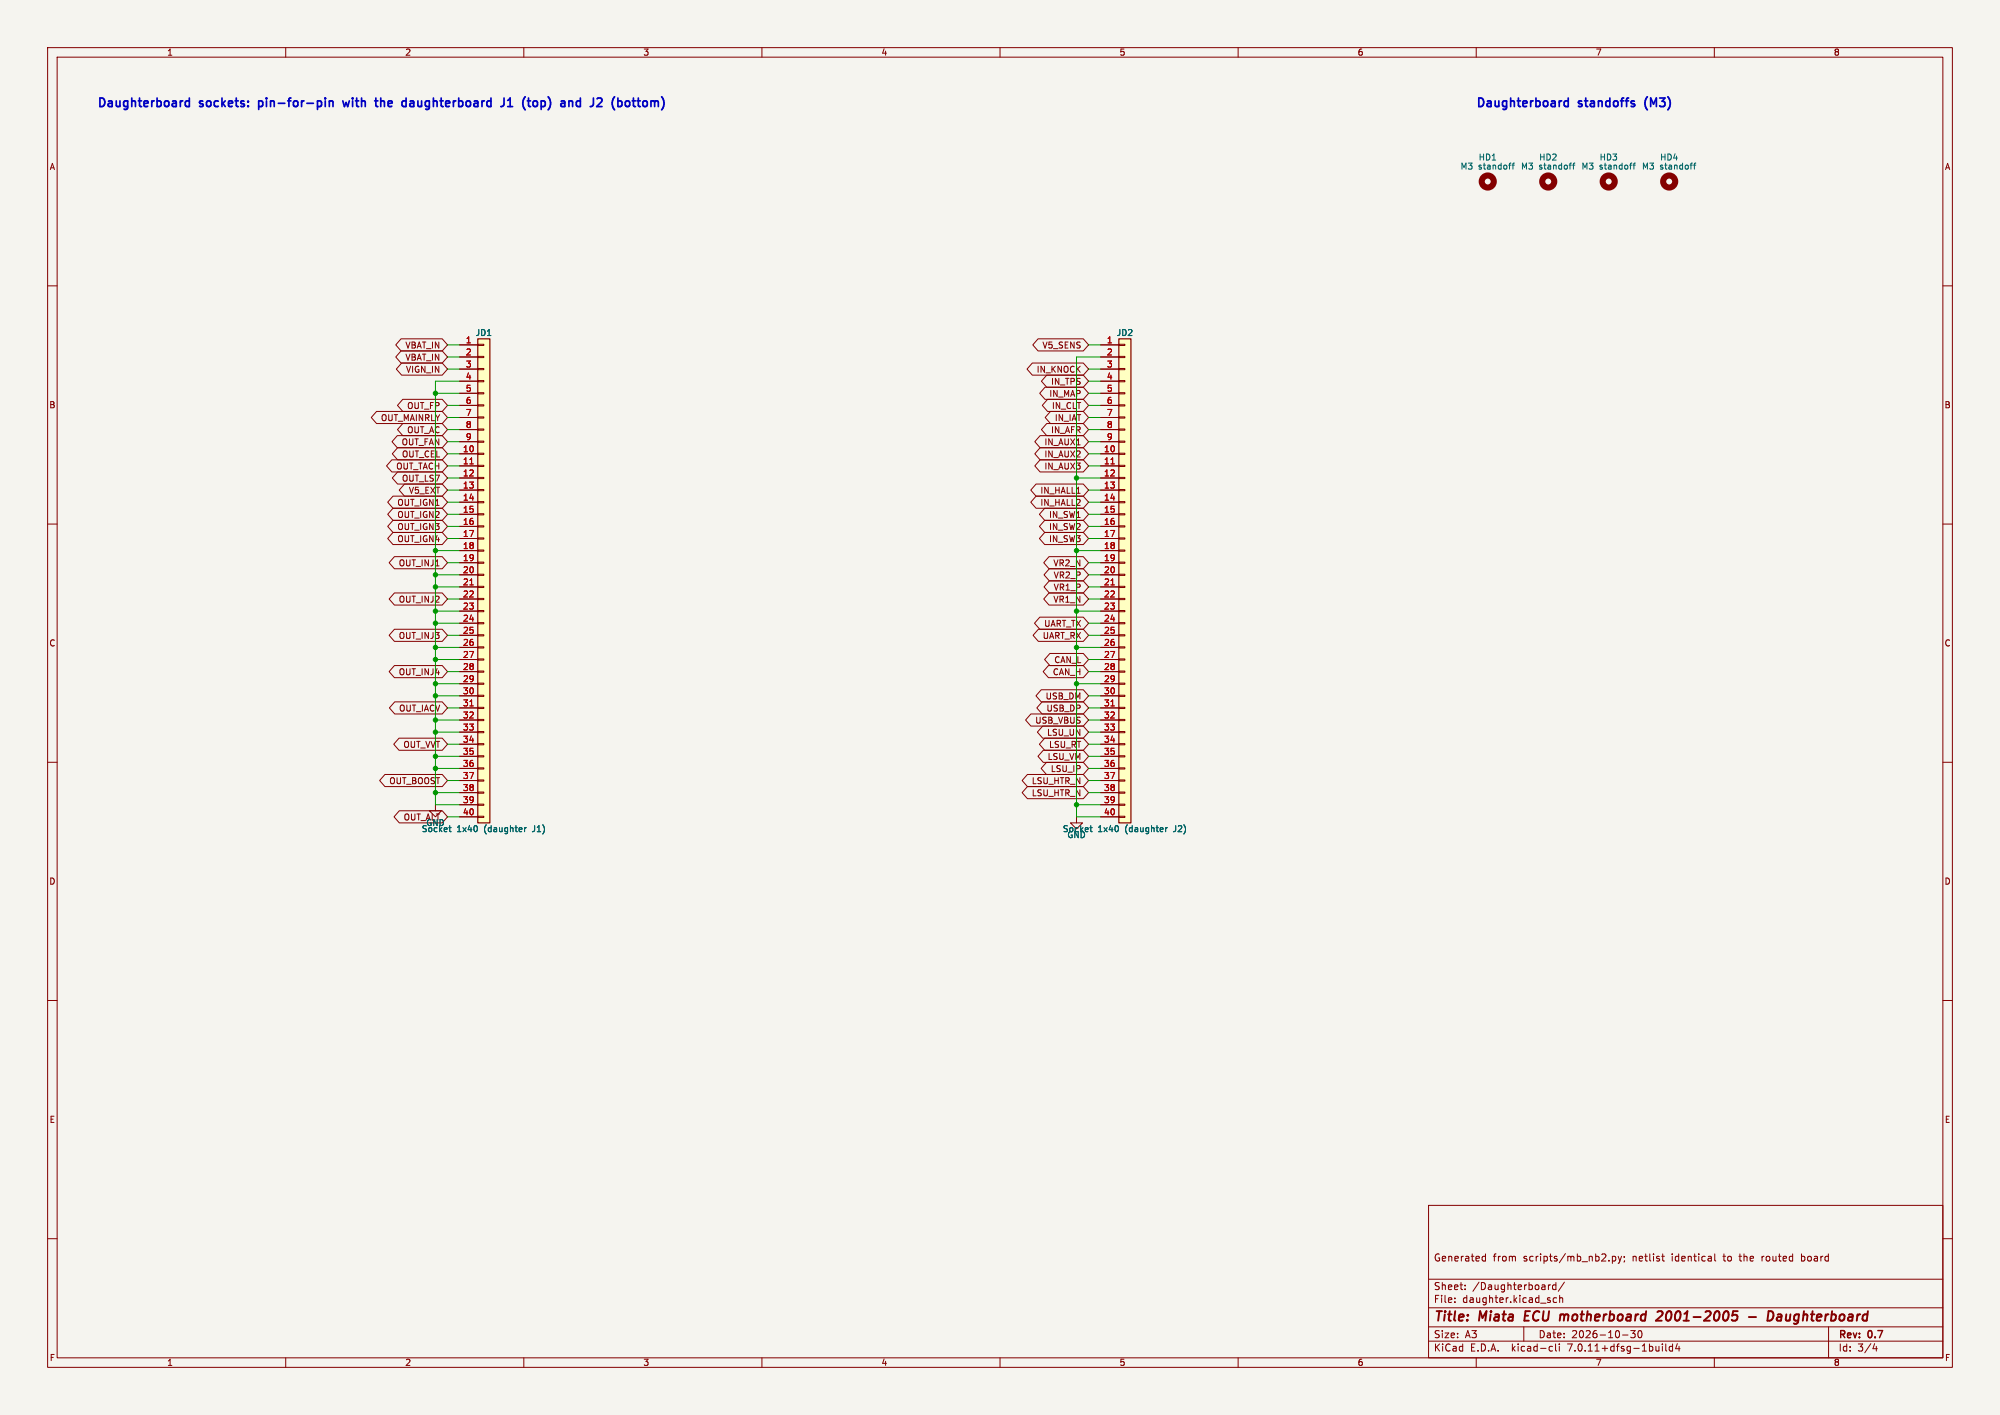
[picture p69: page 3]

HD4 M3 standoff HD3 M3 standoff HD2 M3 standoff HD1 M3 standoff GND

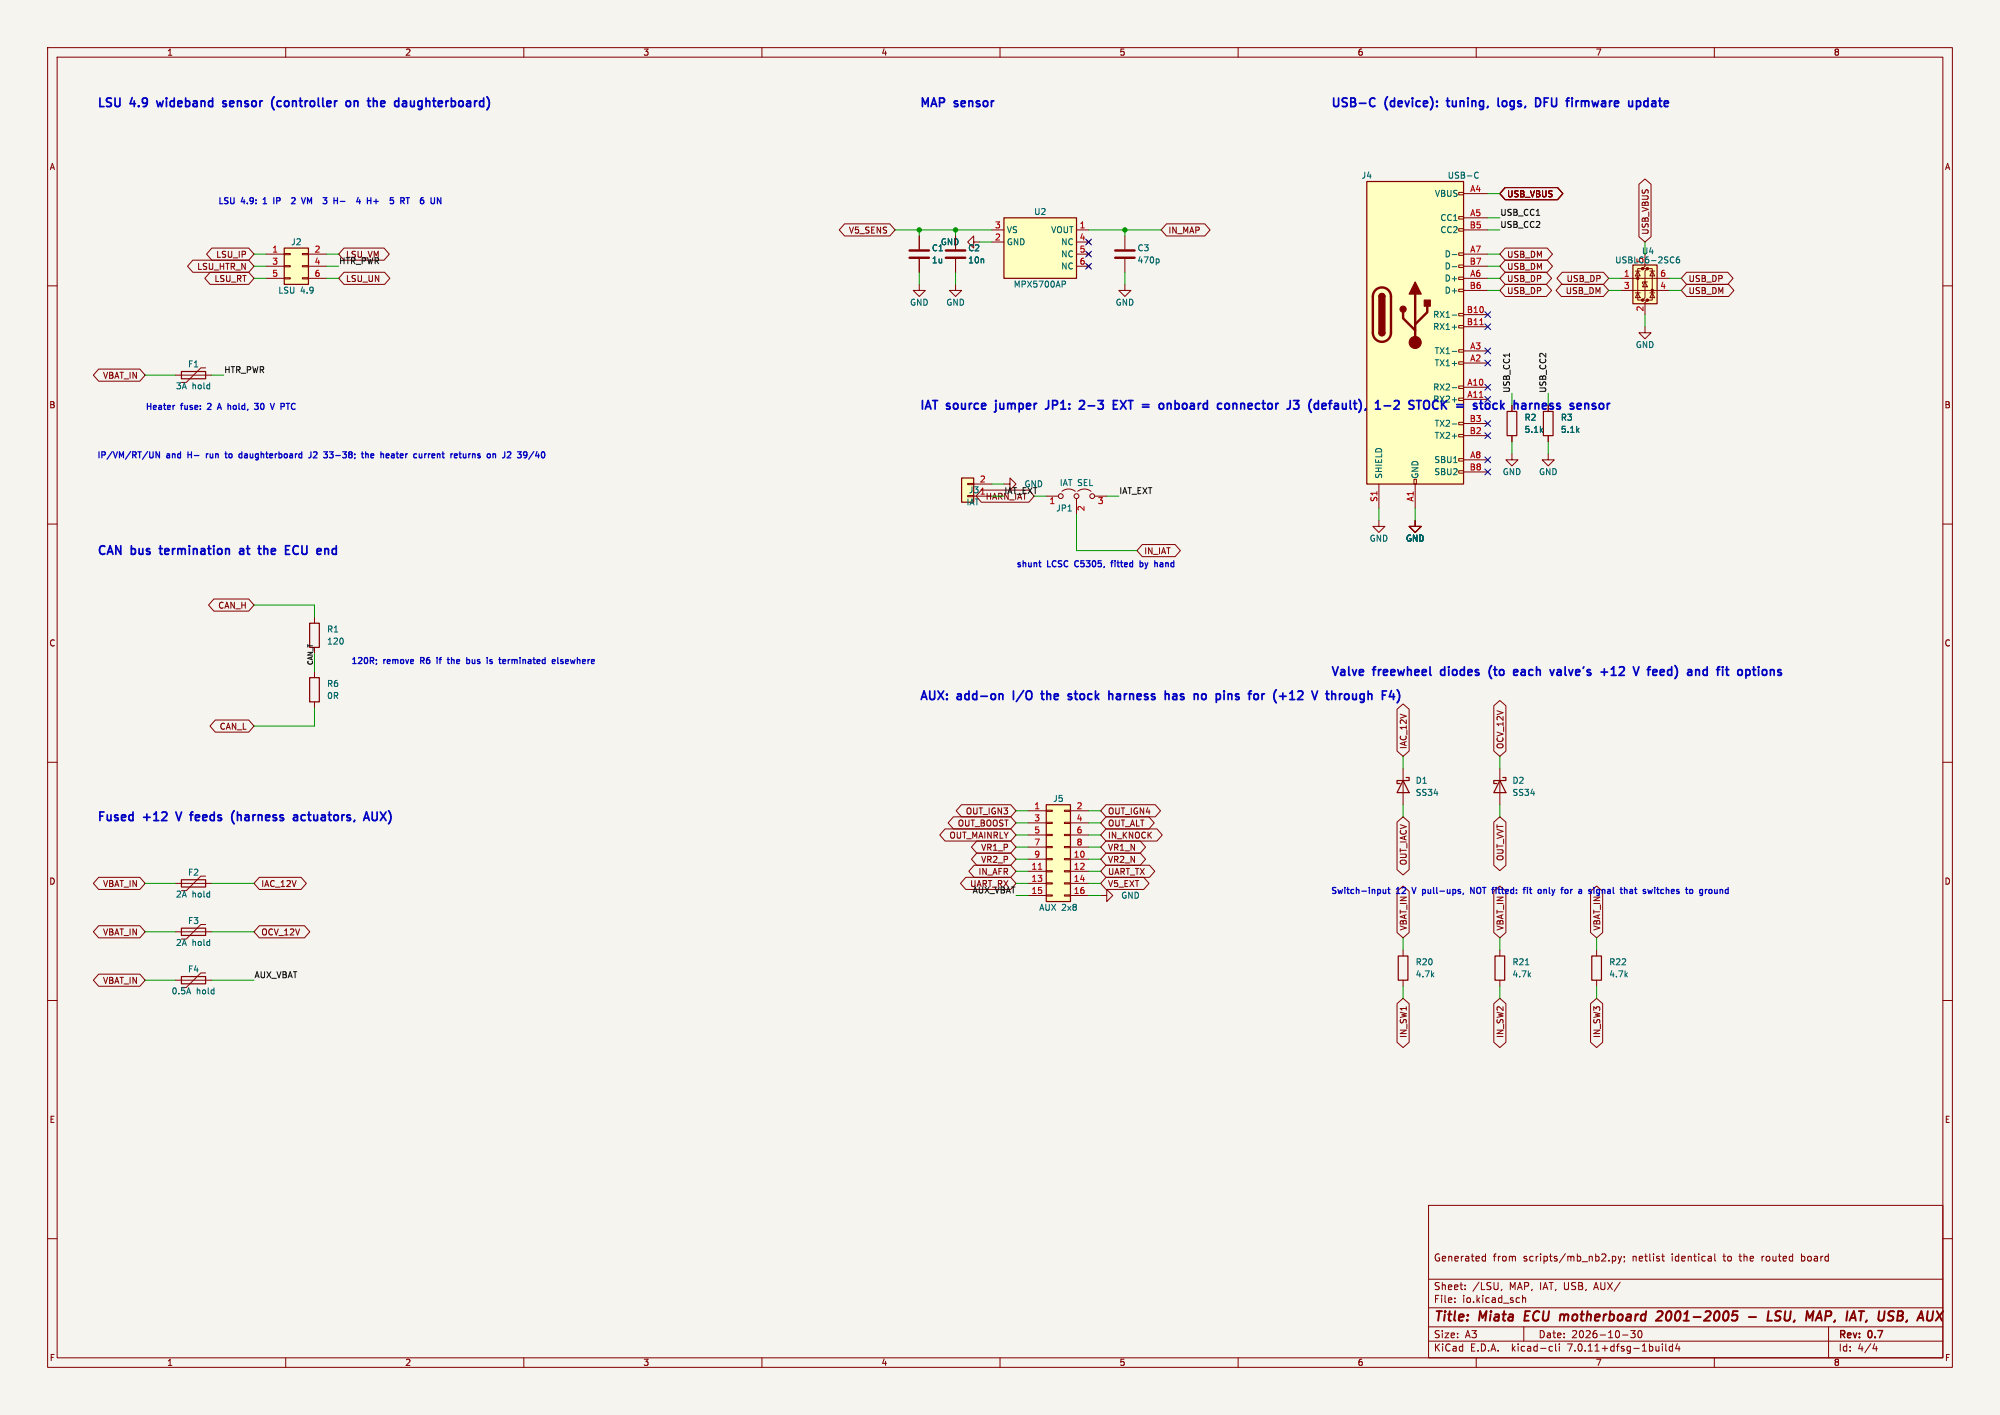
[picture p70: page 4]

shunt LCSC C5305, fitted by hand

Valve freewheel diodes (to each valve's +12 V feed) and fit options
