v3ai/miata-ecus/motherboards/1996-97/miata_mb_9697_schematic.pdf

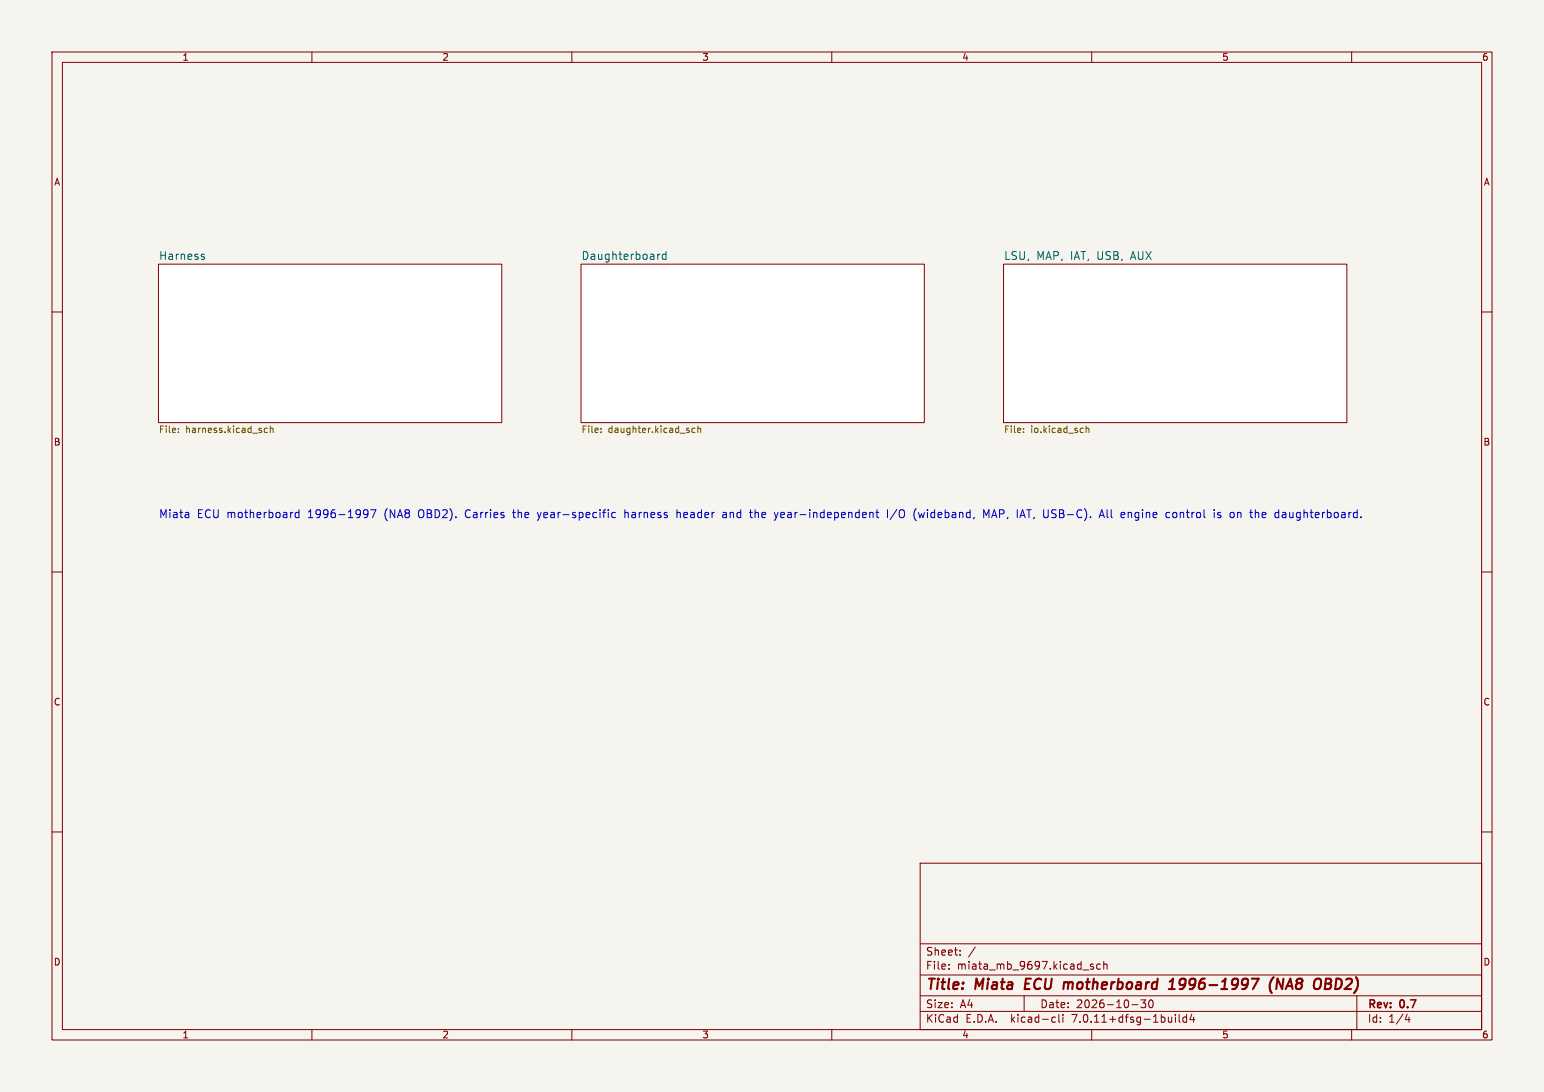
[picture p71: page 1]

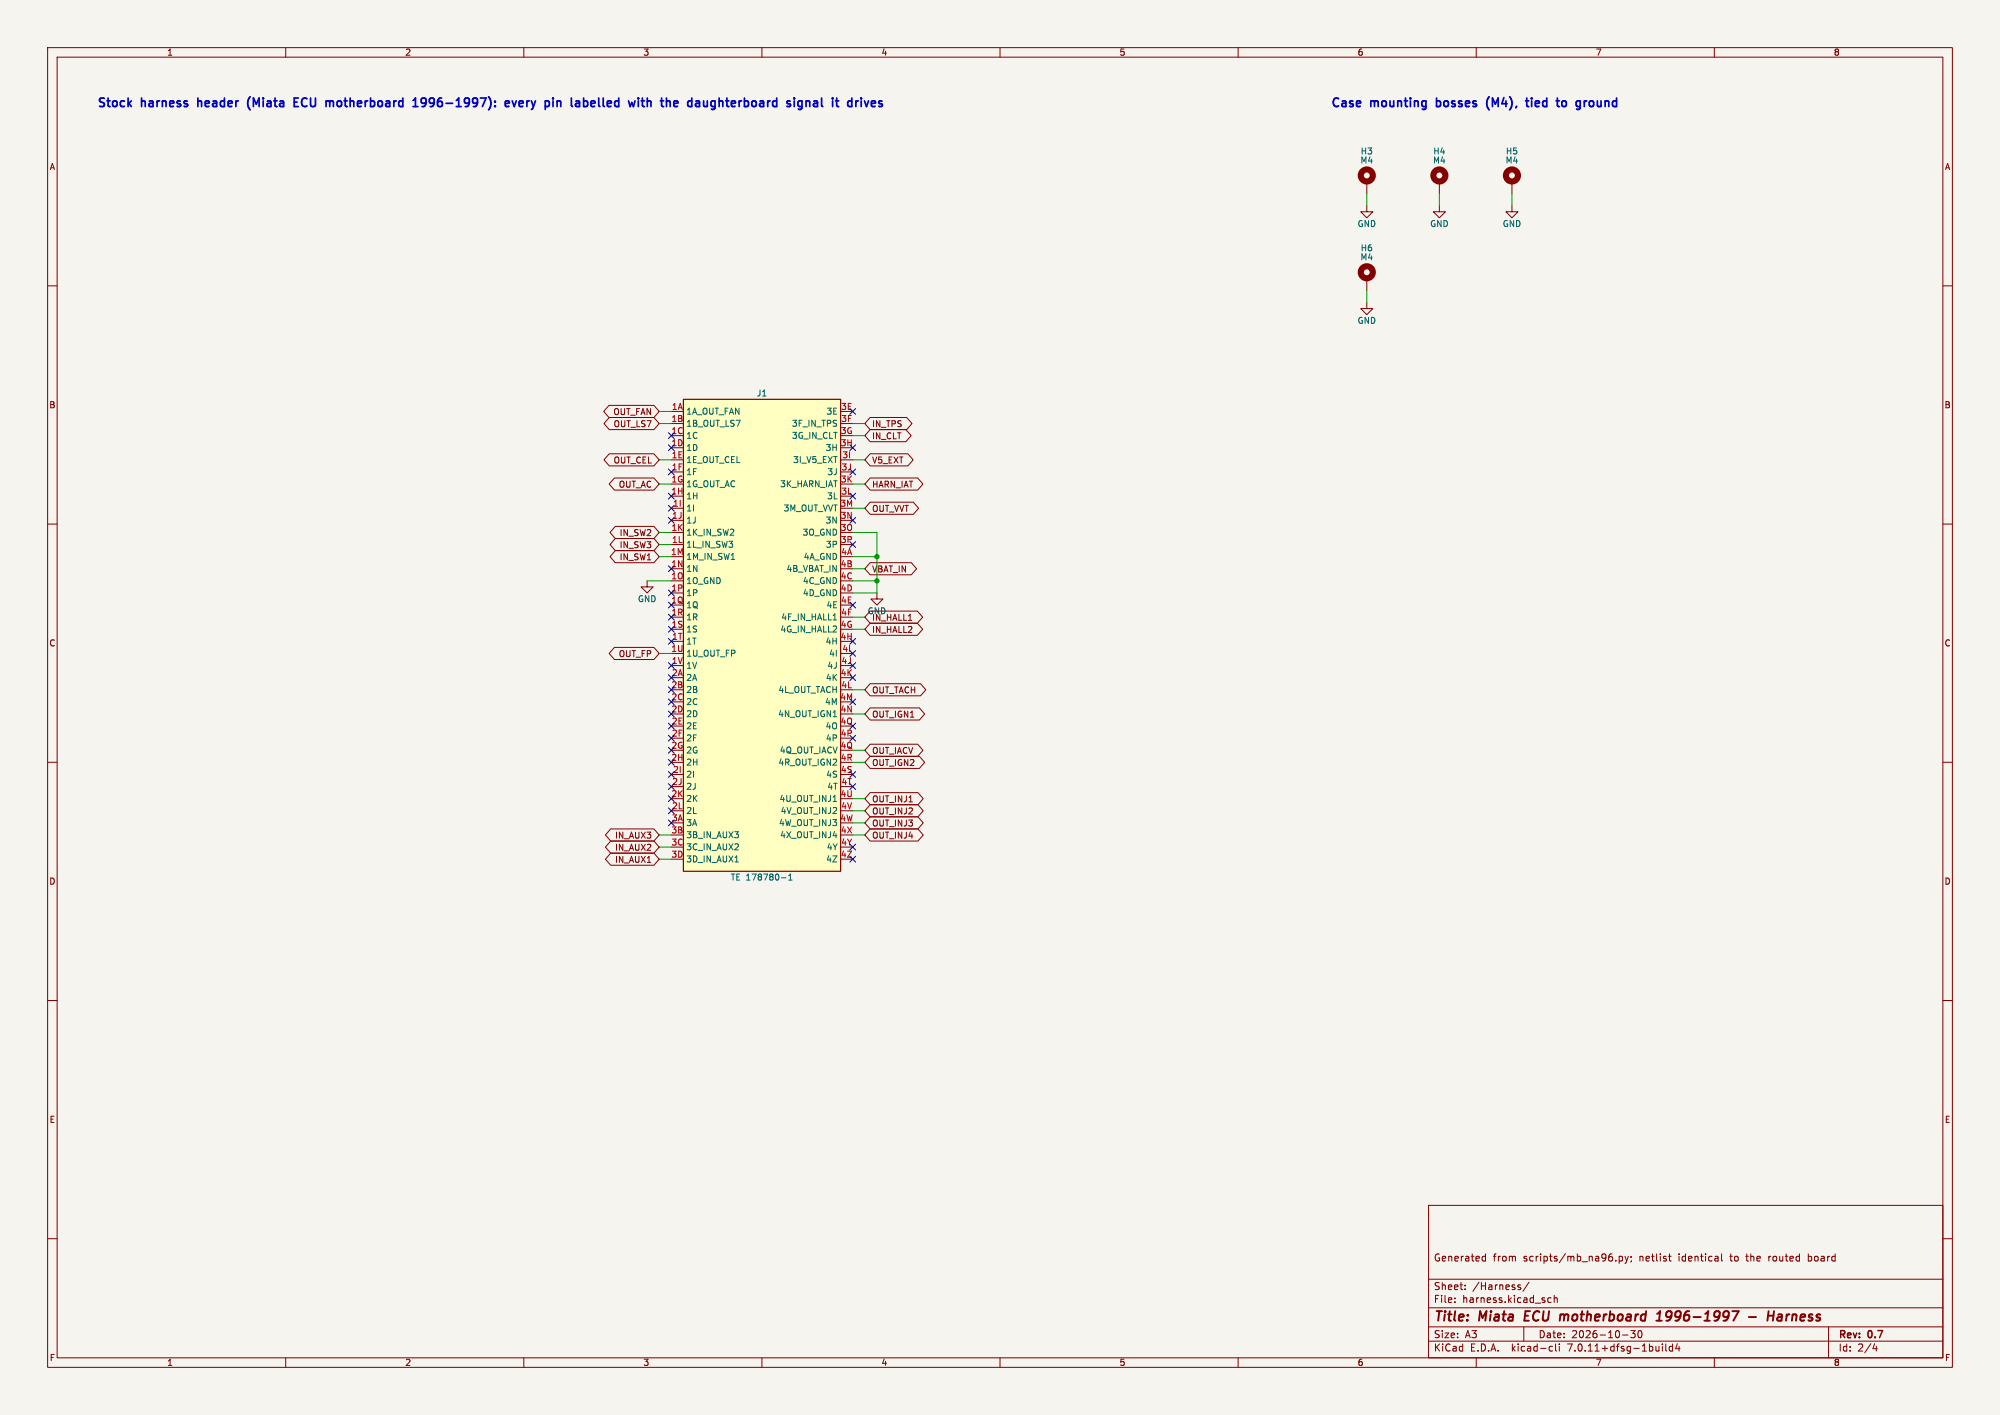
[picture p72: page 2]

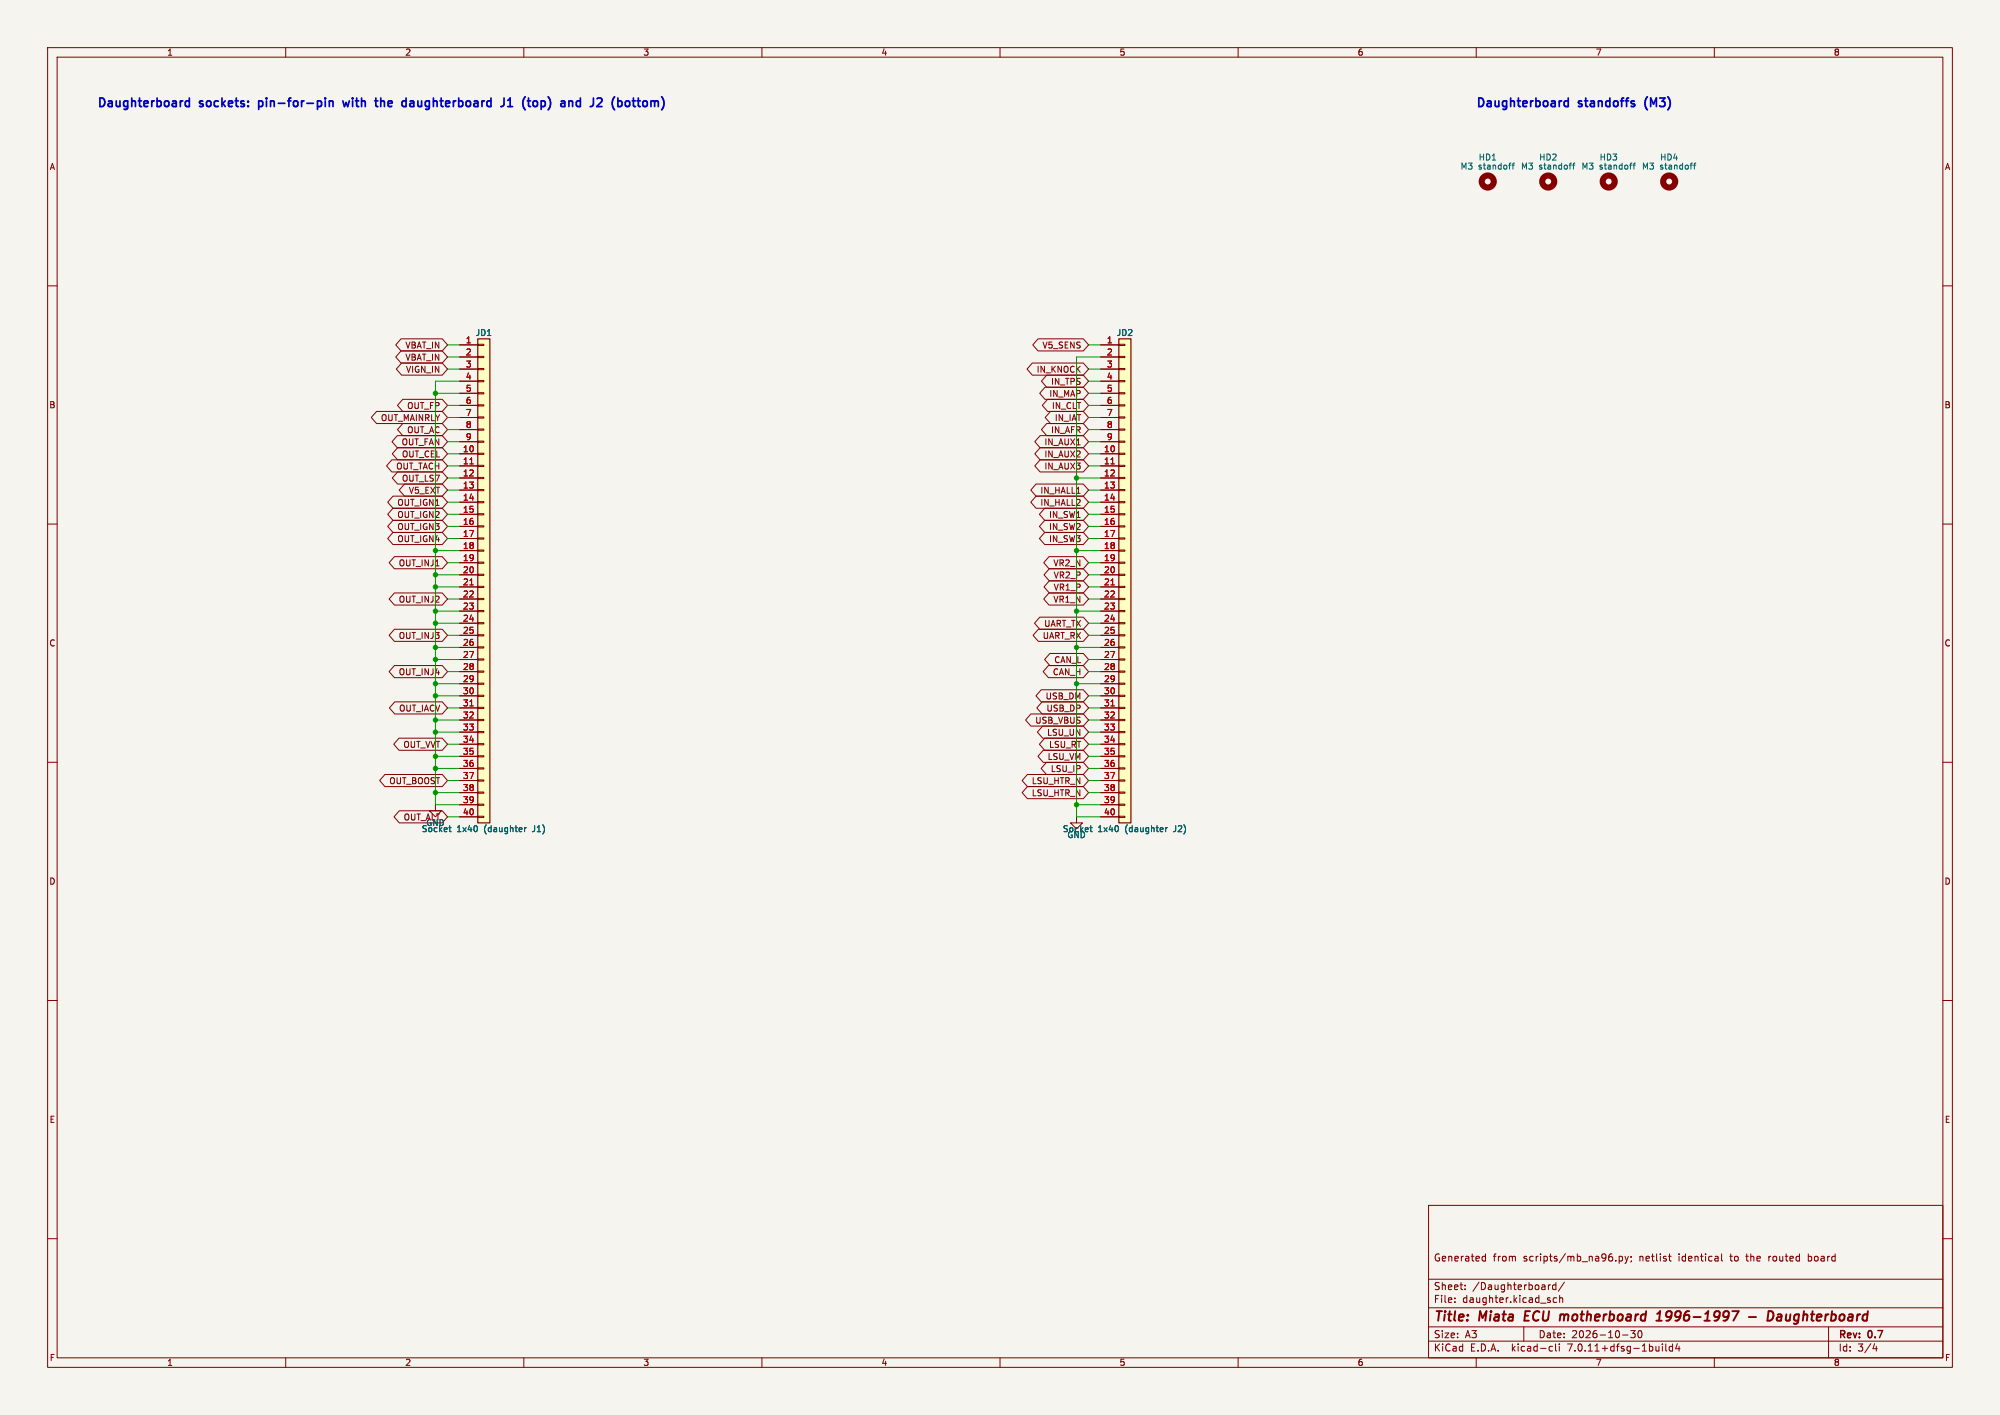
[picture p73: page 3]

HD4 M3 standoff HD3 M3 standoff HD2 M3 standoff HD1 M3 standoff GND

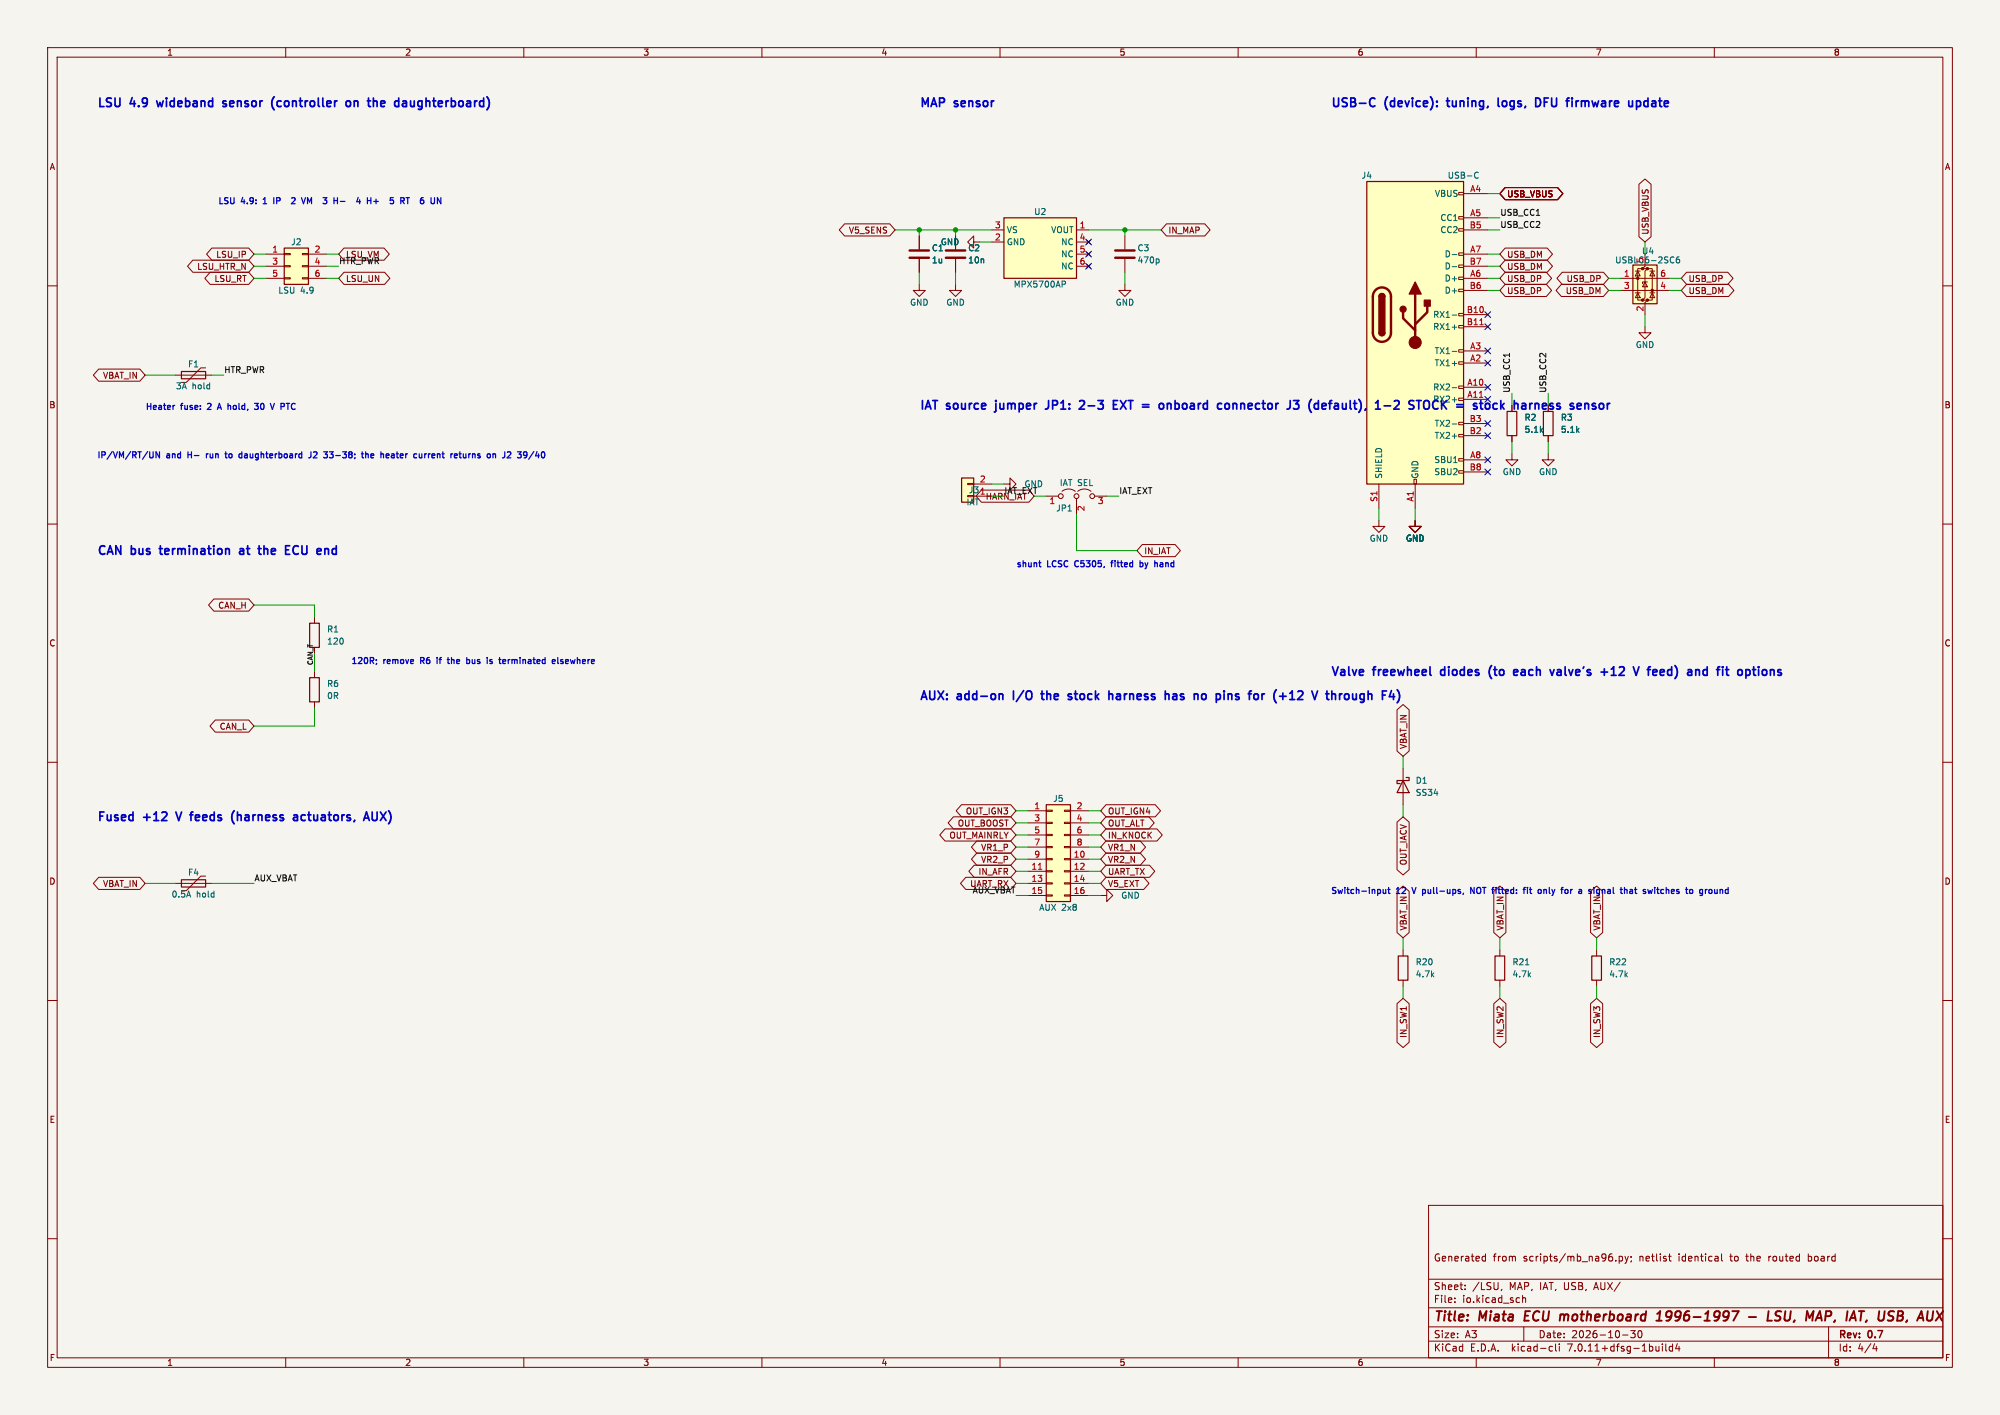
[picture p74: page 4]

Valve freewheel diodes (to each valve's +12 V feed) and fit options
