v3ai/miata-ecus/motherboards/1999-2000/miata_mb_9900_schematic.pdf

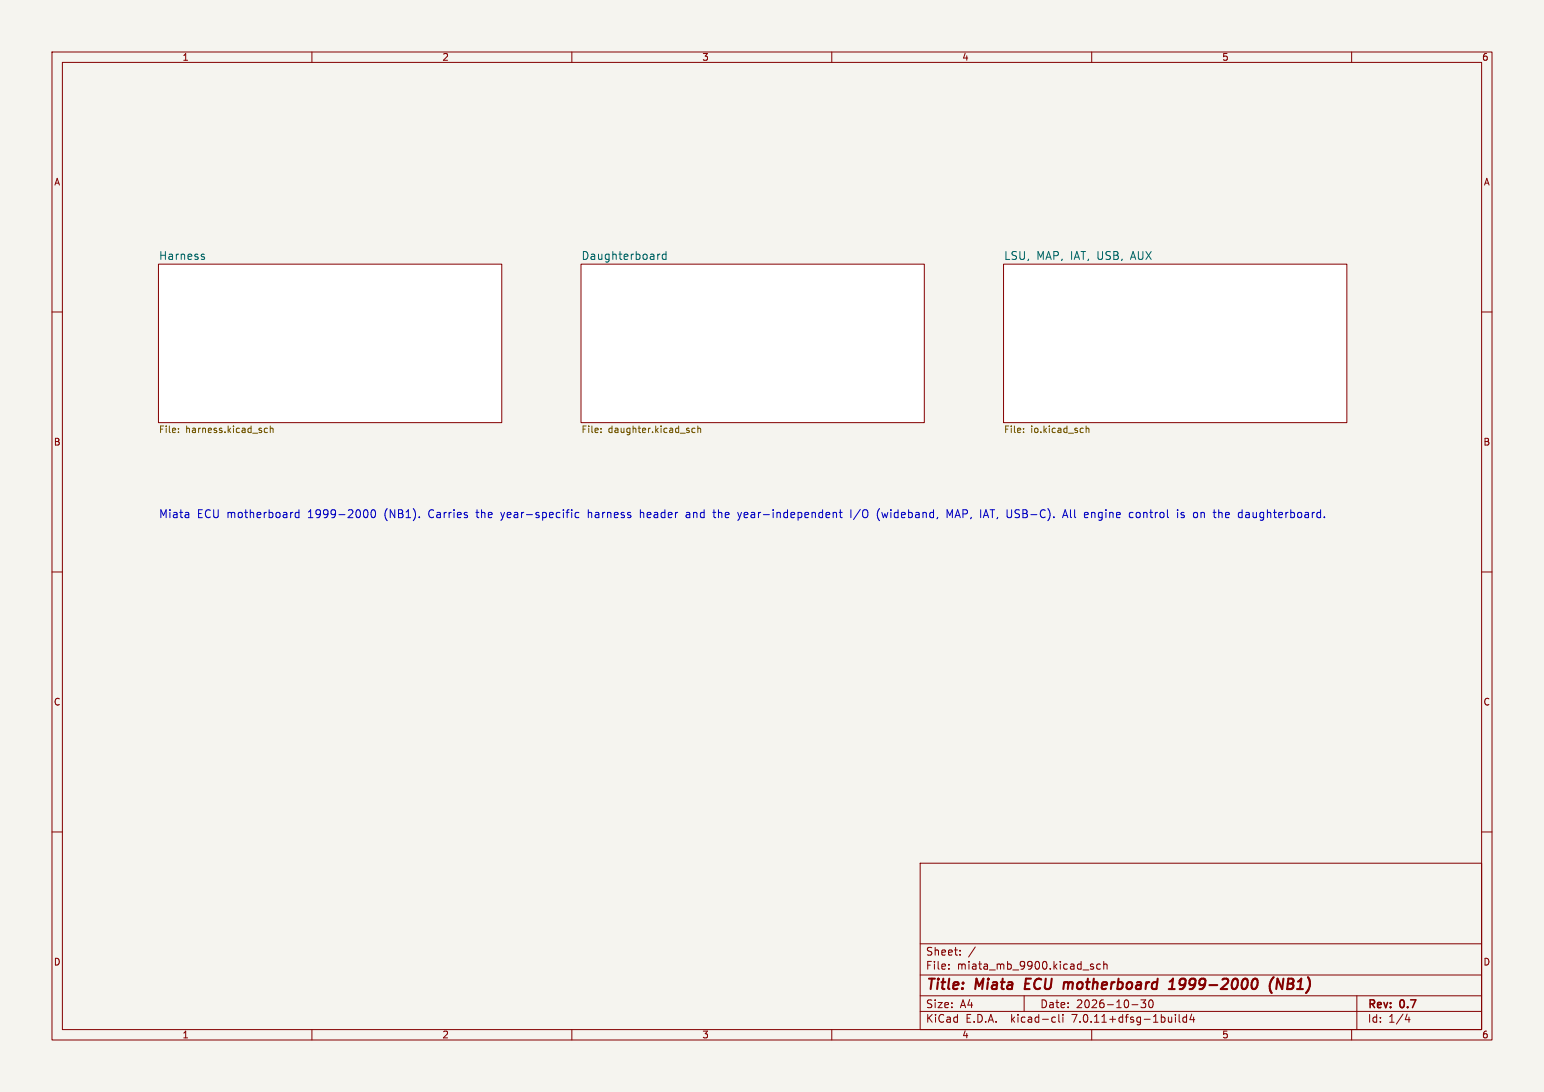
[picture p75: page 1]

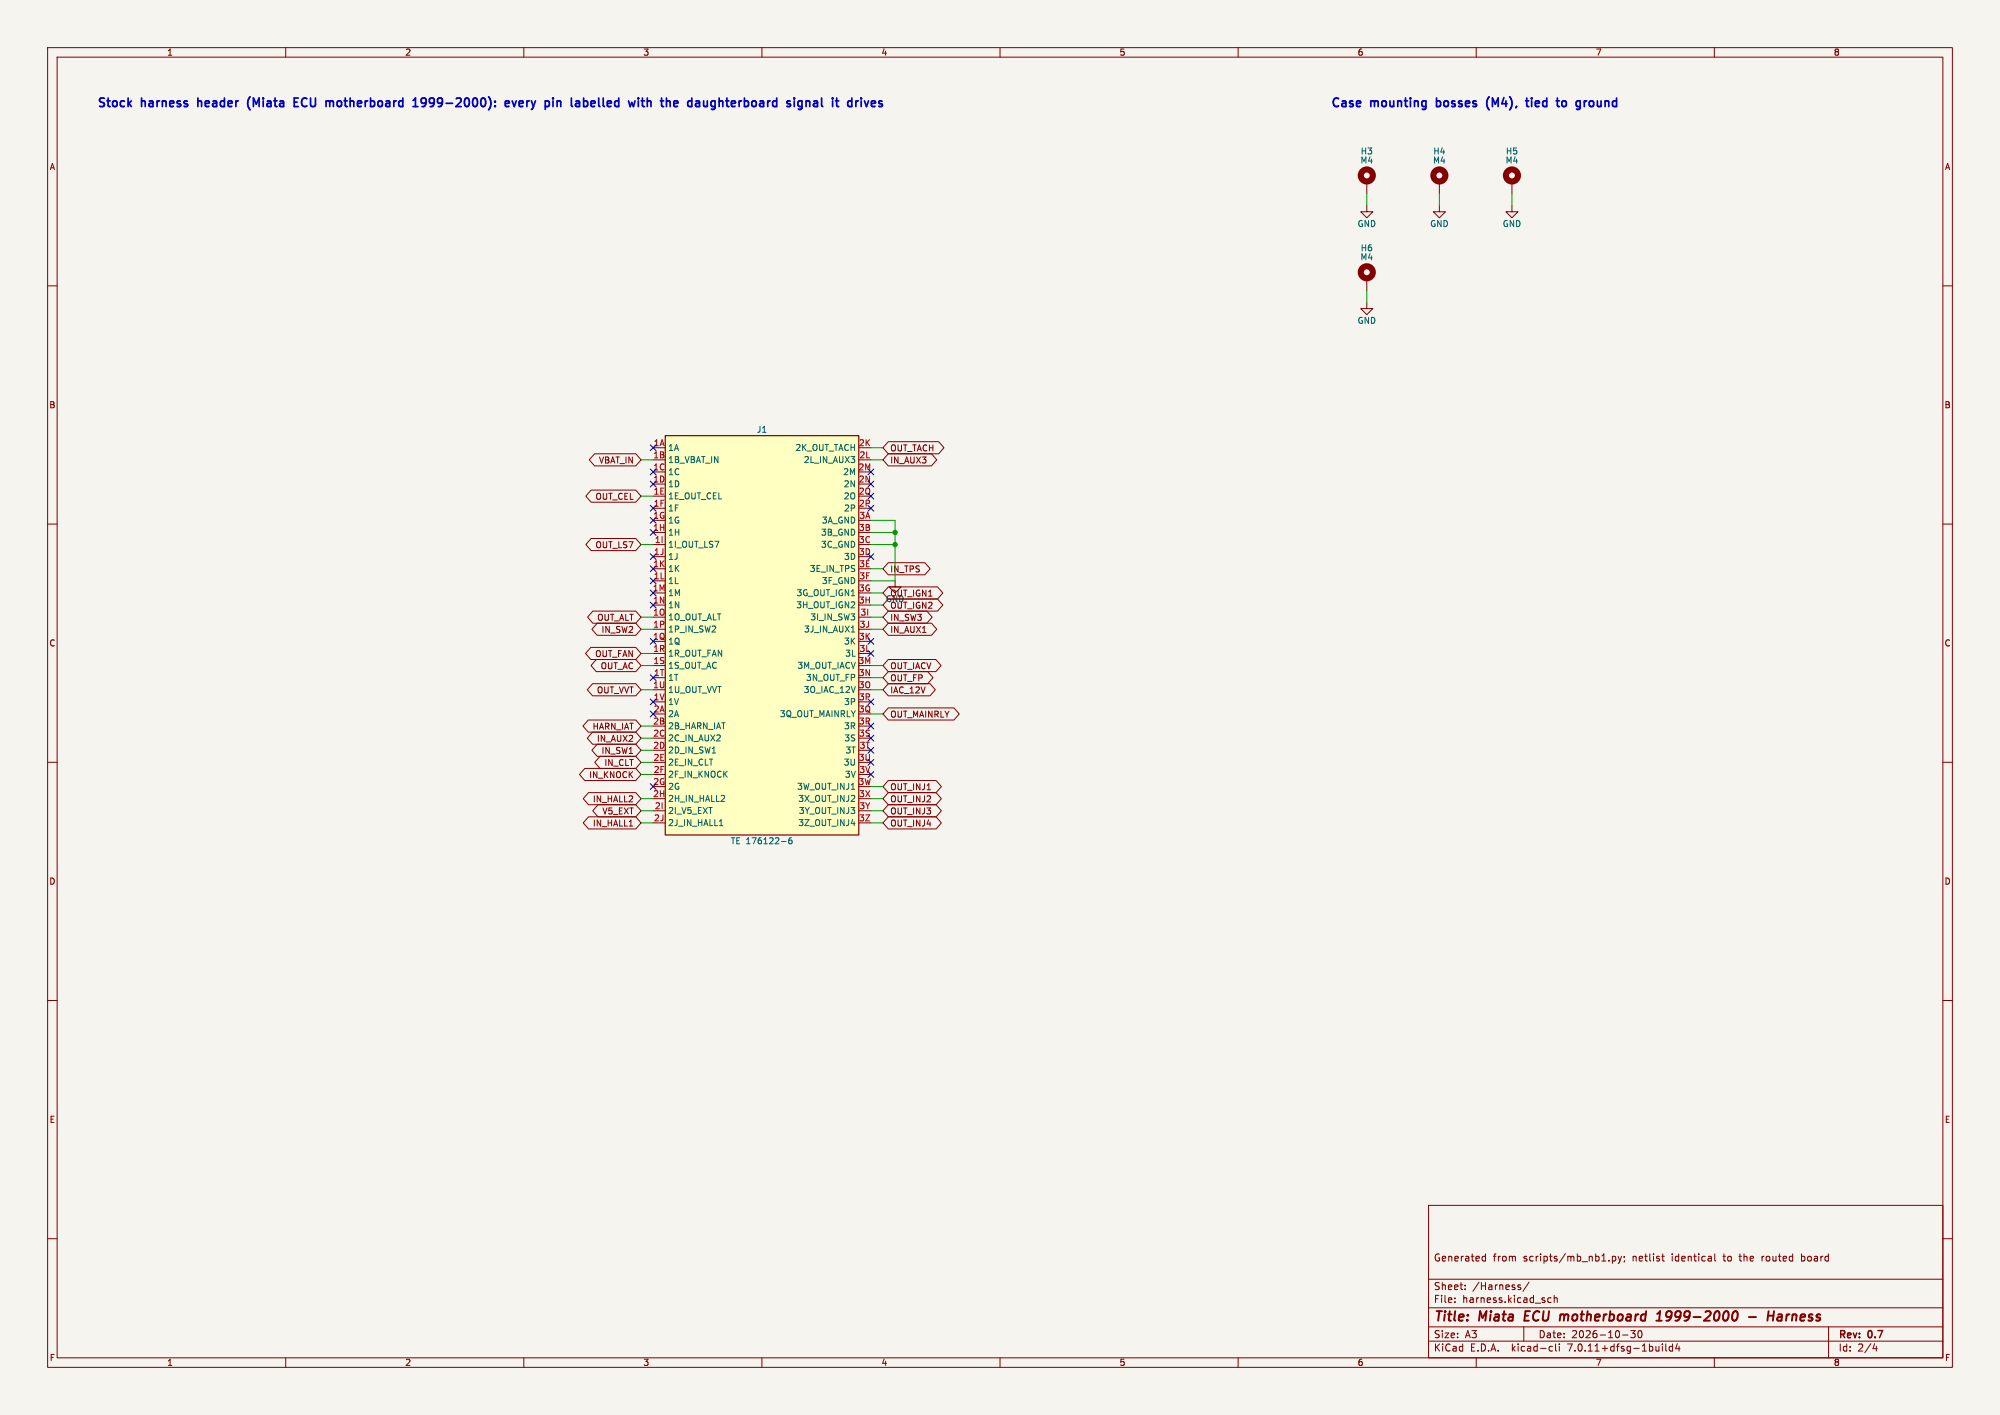
[picture p76: page 2]

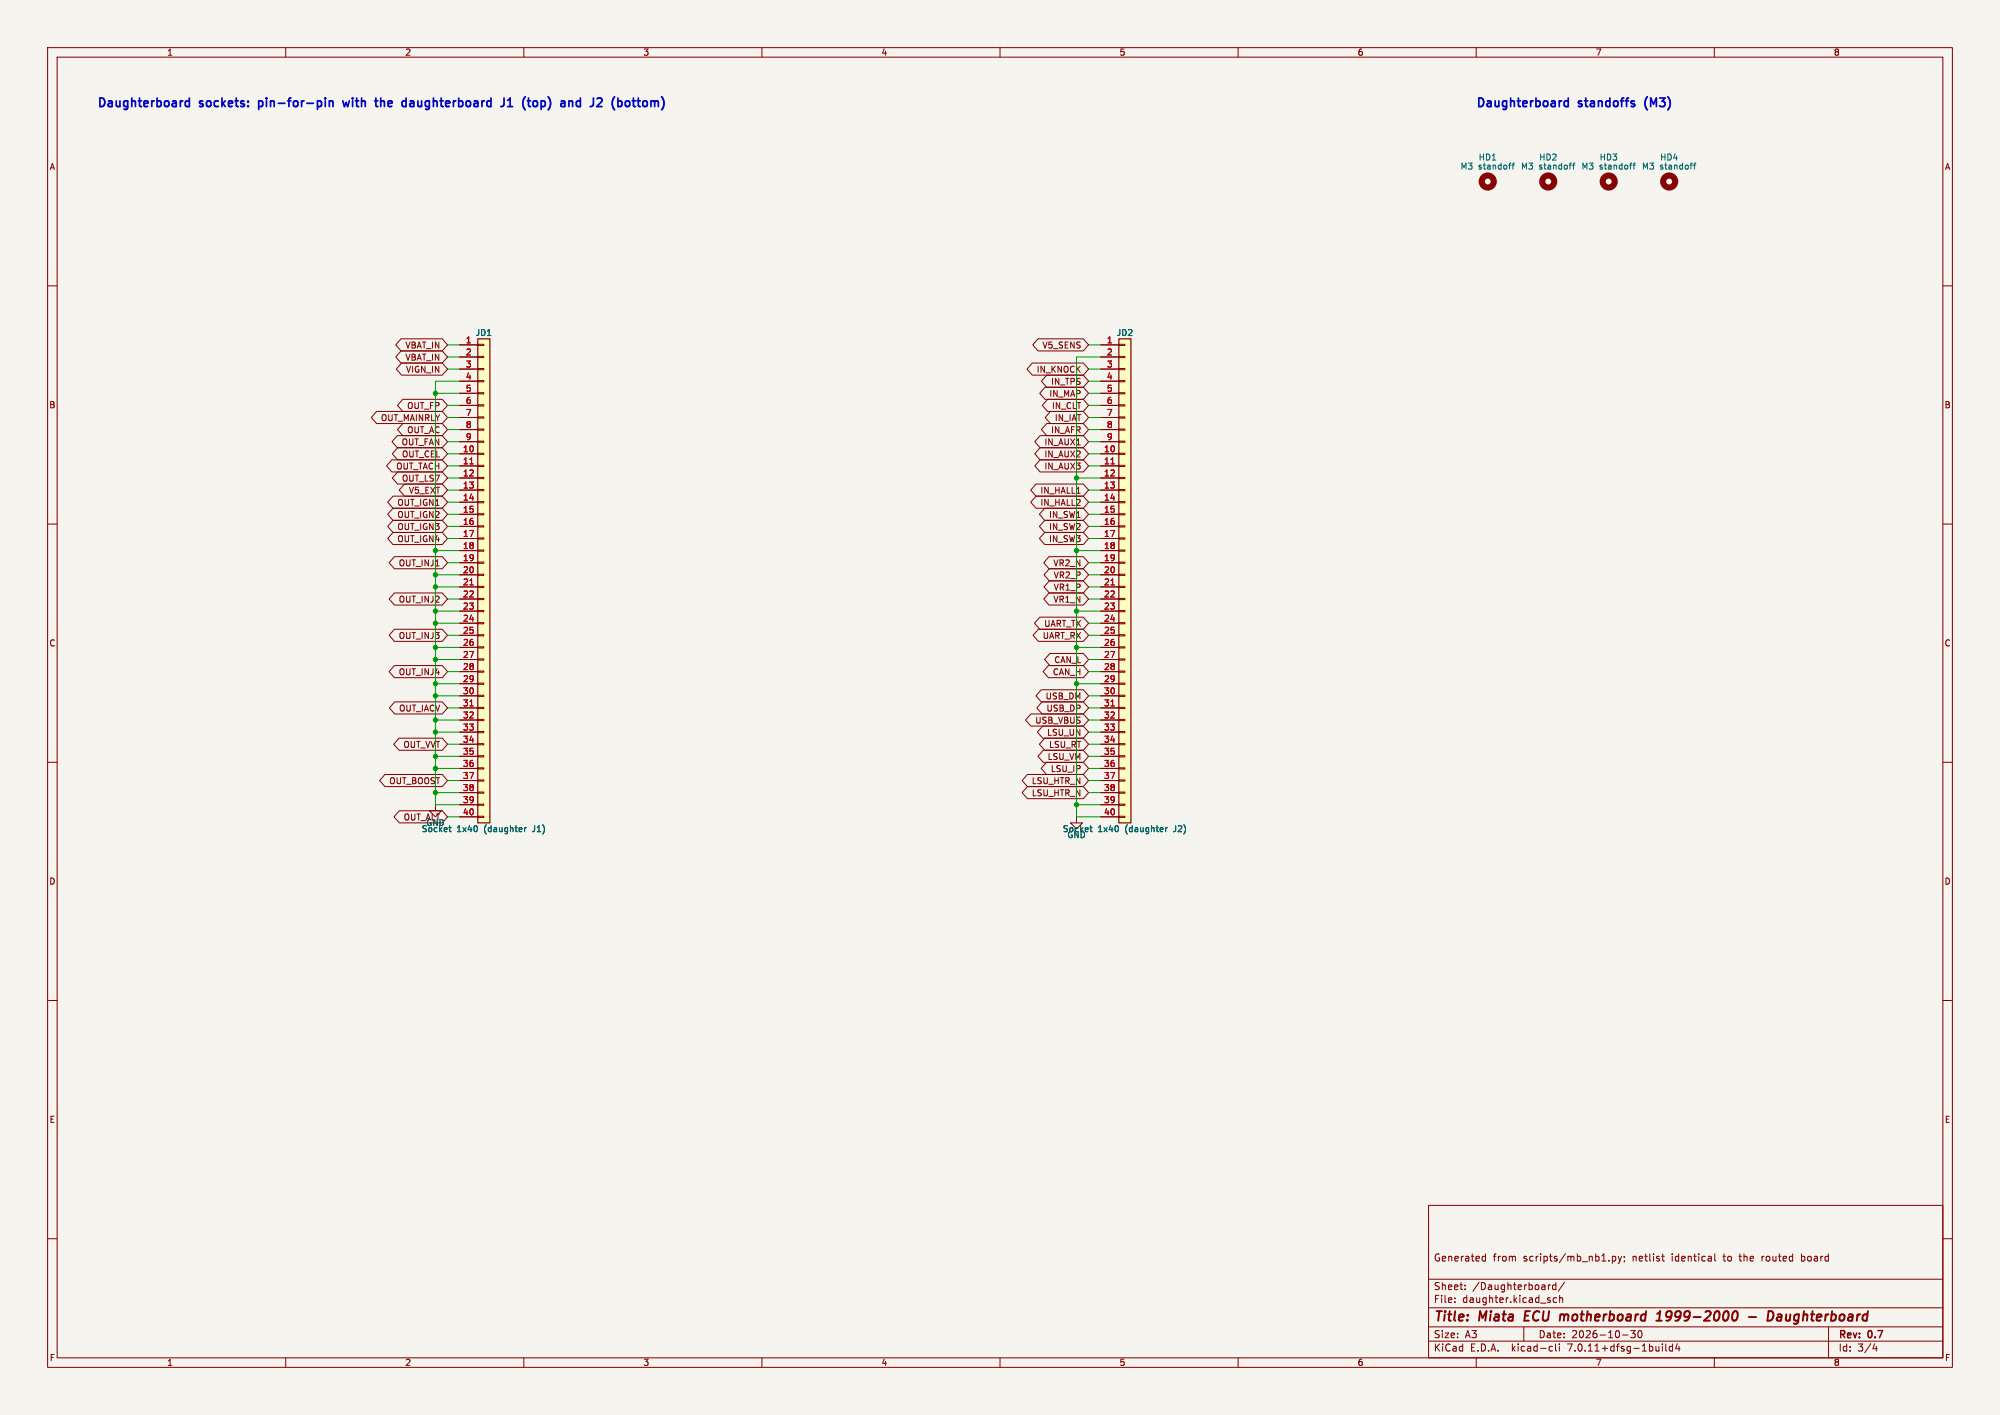
[picture p77: page 3]

HD4 M3 standoff HD3 M3 standoff HD2 M3 standoff HD1 M3 standoff GND

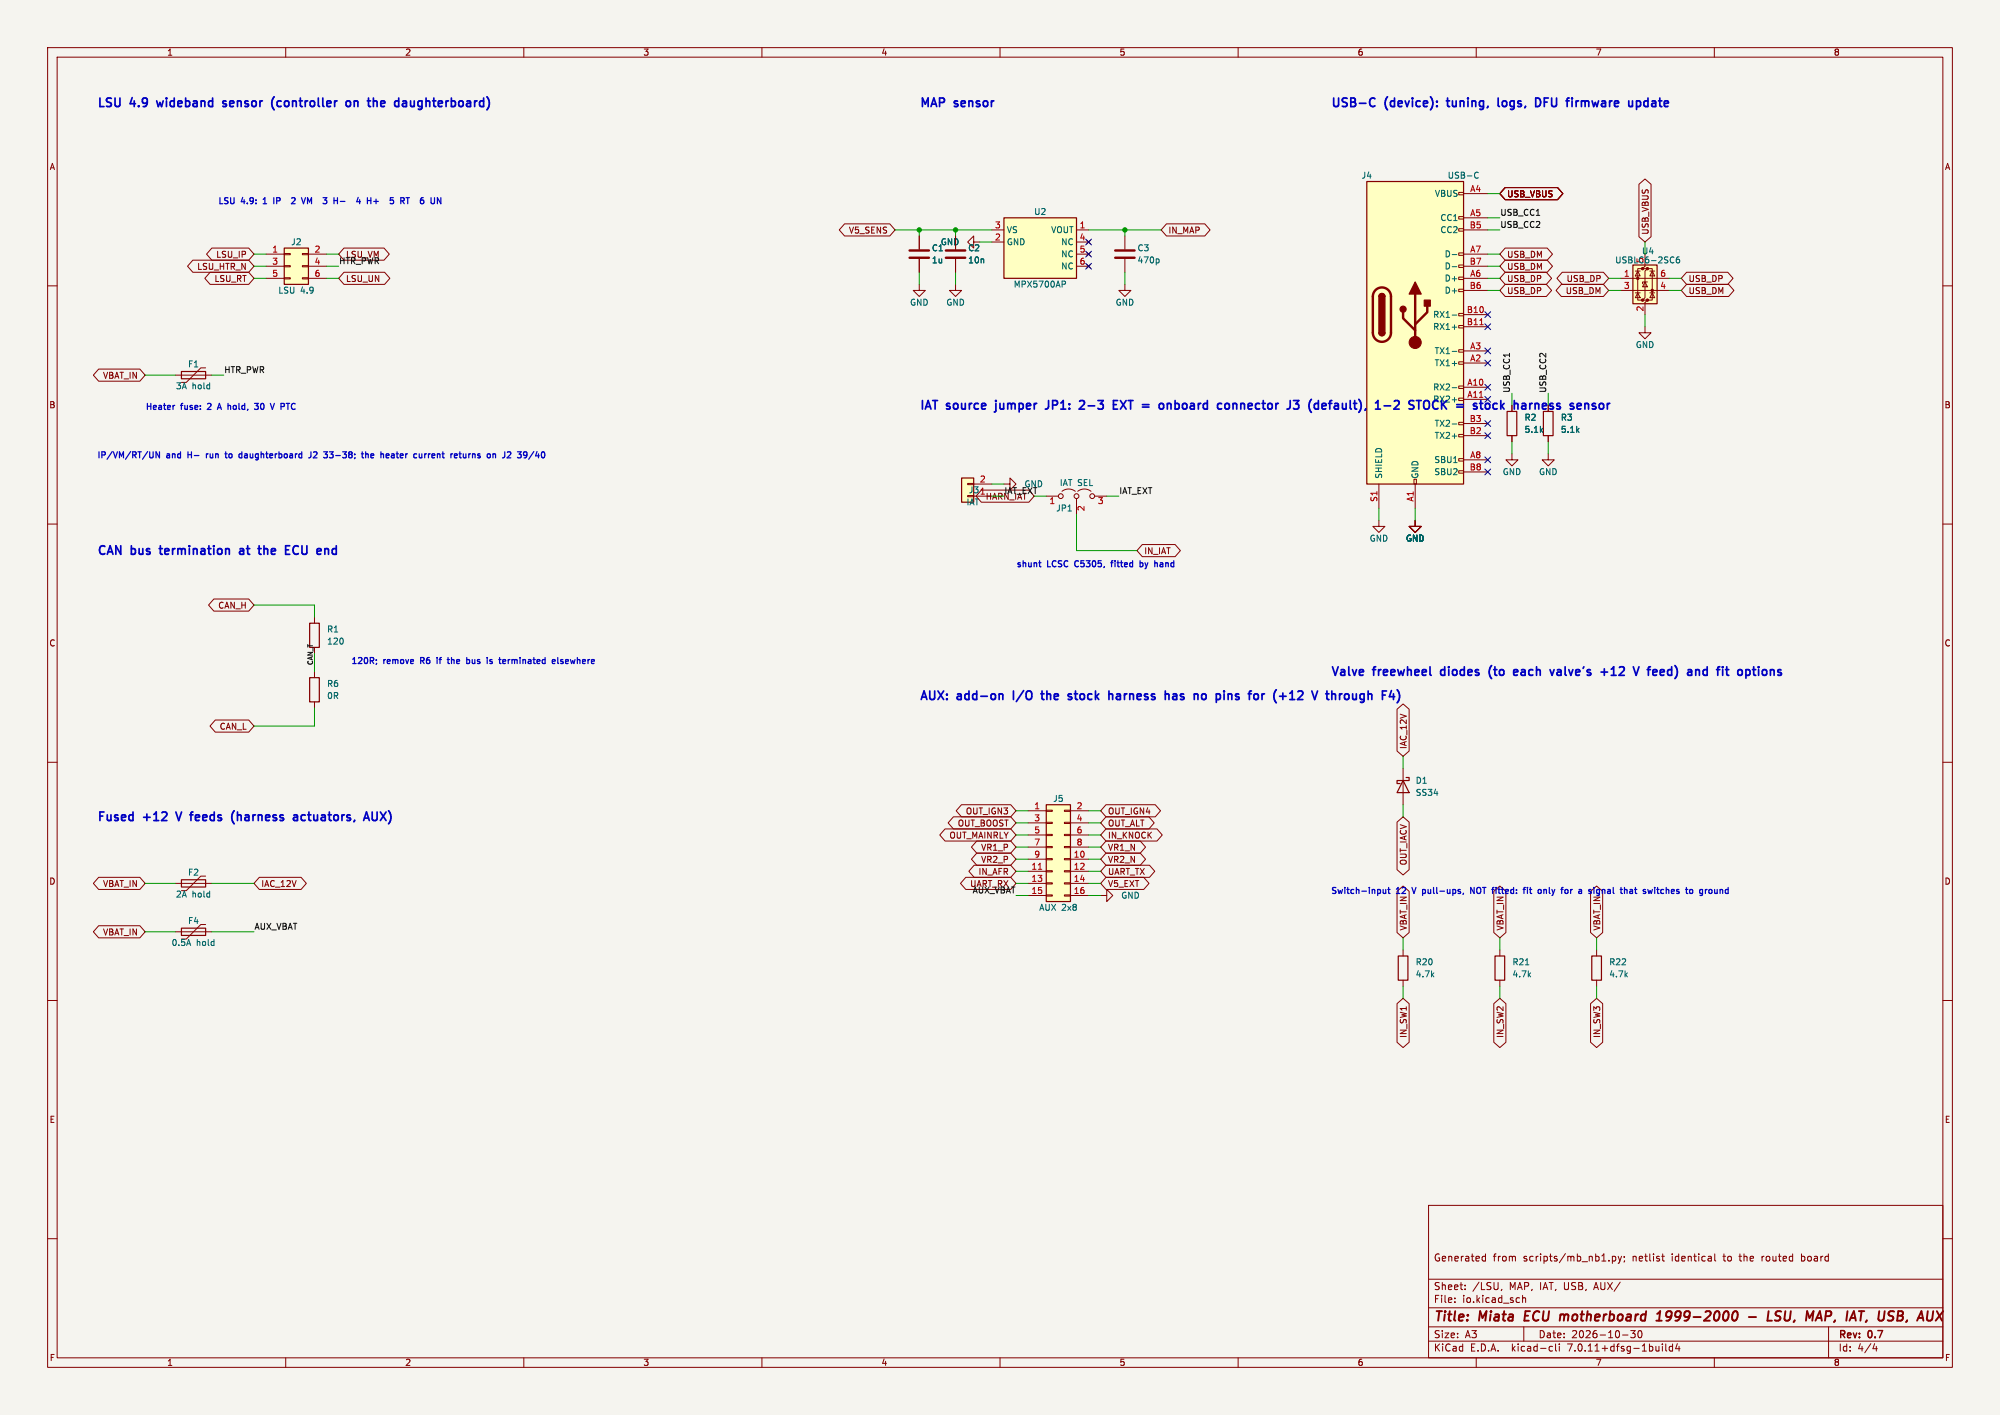
[picture p78: page 4]
