v3ai/miata-ecus/ordered-boards/2026-11/motherboards/1996-97/miata_mb_9697_schematic.pdf

HD4 M3 standoff HD3 M3 standoff HD2 M3 standoff HD1 M3 standoff GND


Valve freewheel diodes (to each valve's +12 V feed) and fit options
