v3ai/miata-ecus/motherboards/1989-93/miata_mb_8993.kicad_pcb

## KiCad design motherboards/1989-93/miata_mb_8993.kicad_pcb (2026-11-04)

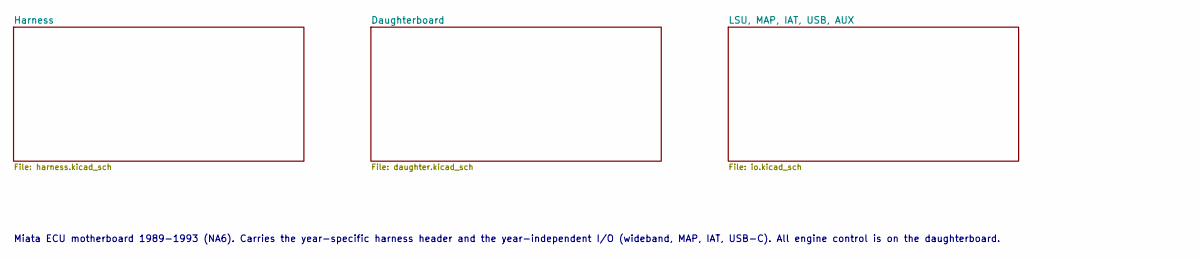
[picture p79: schematic miata_mb_8993.kicad_sch, Miata ECU motherboard 1989-1993 (NA6)]

Notes on the sheet:
Miata ECU motherboard 1989-1993 (NA6). Carries the year-specific harness header and the year-independent I/O (wideband, MAP, IAT, USB-C). All engine control is on the daughterboard.

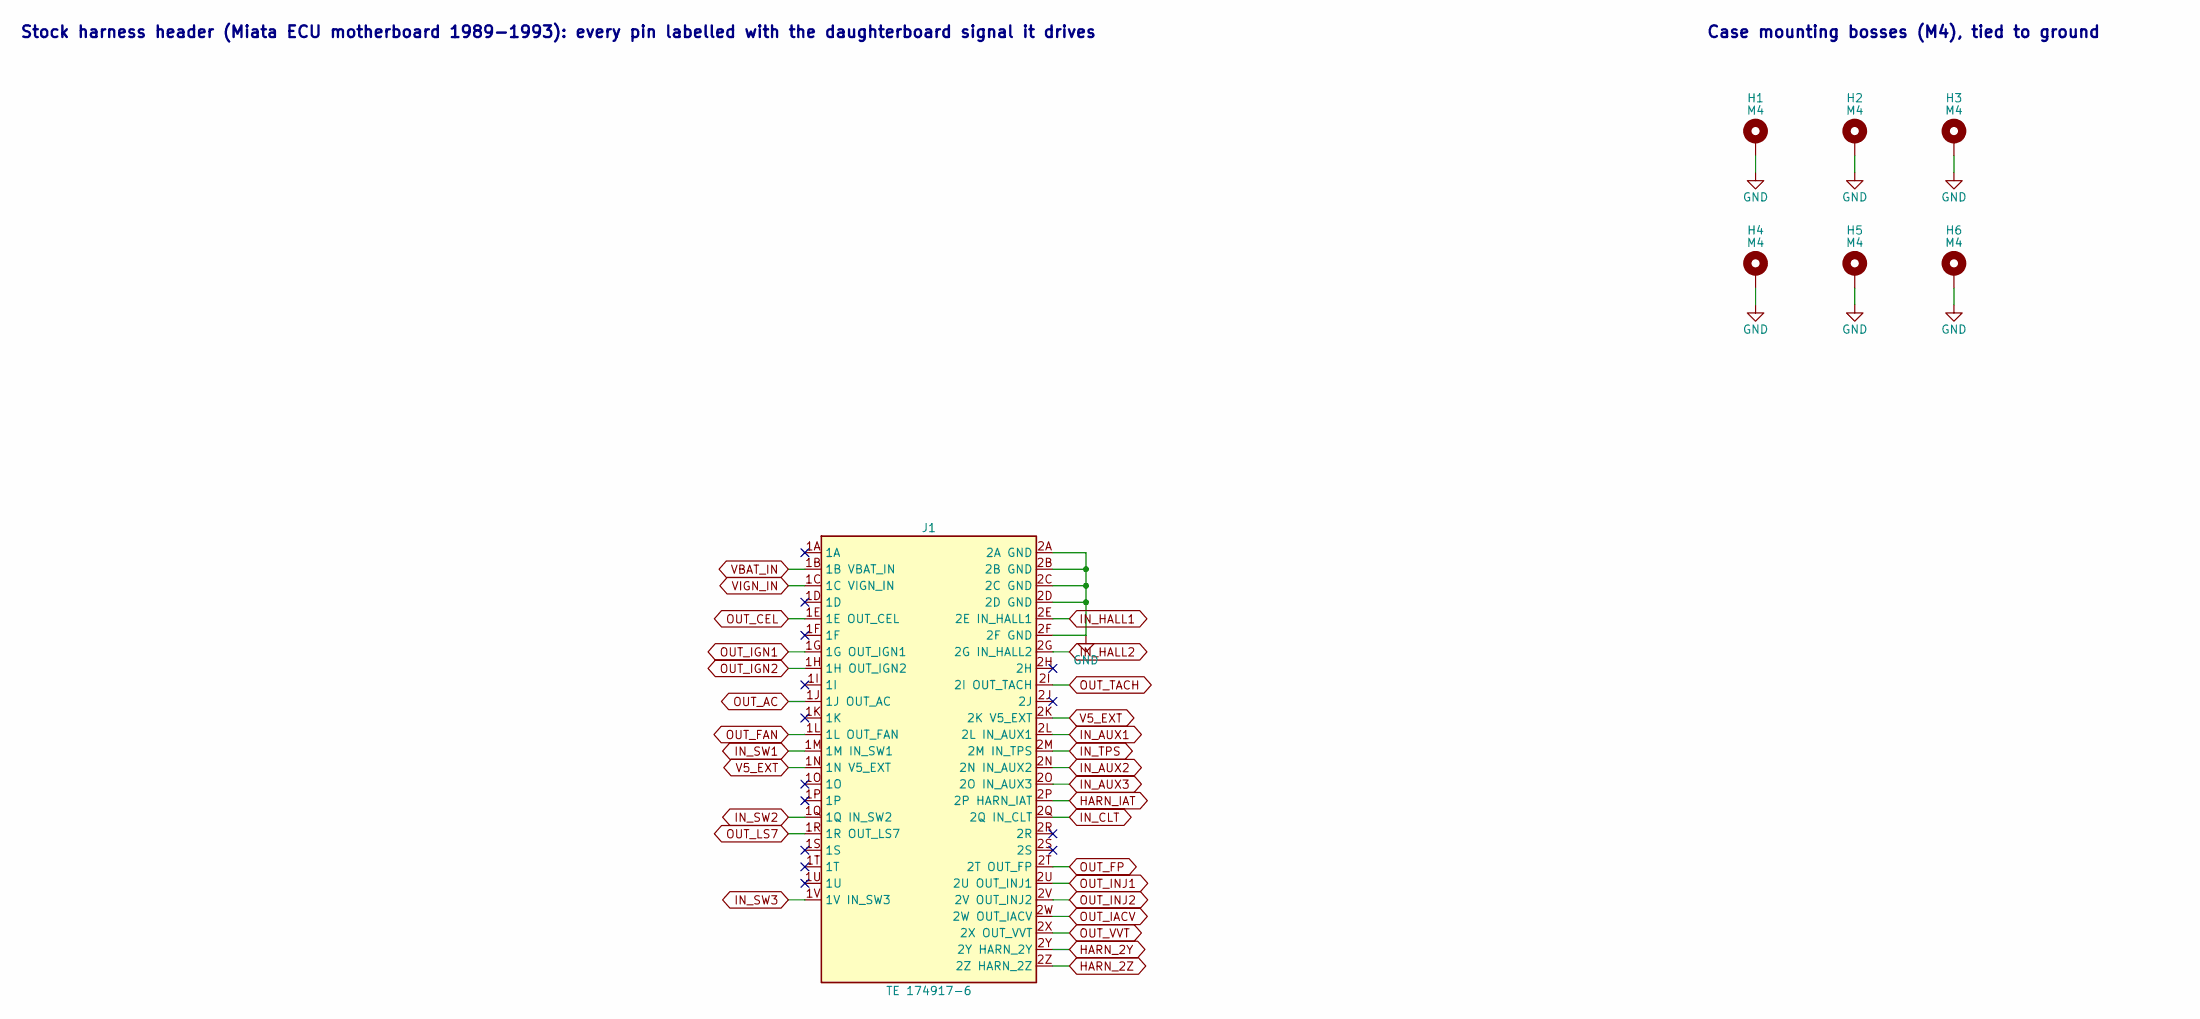
[picture p80: schematic harness.kicad_sch, Miata ECU motherboard 1989-1993 - Harness]

Parts:
H1, H2, H3, H4, H5, H6: M4; MountingHole_M4_4.5mm_Pad7
J1: TE 174917-6; TE_174917-6_48P

Connections:
GND: H1.1, H2.1, H3.1, H4.1, H5.1, H6.1, J1.2A (2A GND), J1.2B (2B GND), J1.2C (2C GND), J1.2D (2D GND), J1.2F (2F GND); also elsewhere on the board
HARN_2Y: J1.2Y (2Y HARN_2Y); also elsewhere on the board
HARN_2Z: J1.2Z (2Z HARN_2Z); also elsewhere on the board
HARN_IAT: J1.2P (2P HARN_IAT); also elsewhere on the board
IN_AUX1: J1.2L (2L IN_AUX1); also elsewhere on the board
IN_AUX2: J1.2N (2N IN_AUX2); also elsewhere on the board
IN_AUX3: J1.2O (2O IN_AUX3); also elsewhere on the board
IN_CLT: J1.2Q (2Q IN_CLT); also elsewhere on the board
IN_HALL1: J1.2E (2E IN_HALL1); also elsewhere on the board
IN_HALL2: J1.2G (2G IN_HALL2); also elsewhere on the board
IN_SW1: J1.1M (1M IN_SW1); also elsewhere on the board
IN_SW2: J1.1Q (1Q IN_SW2); also elsewhere on the board
IN_SW3: J1.1V (1V IN_SW3); also elsewhere on the board
IN_TPS: J1.2M (2M IN_TPS); also elsewhere on the board
OUT_AC: J1.1J (1J OUT_AC); also elsewhere on the board
OUT_CEL: J1.1E (1E OUT_CEL); also elsewhere on the board
OUT_FAN: J1.1L (1L OUT_FAN); also elsewhere on the board
OUT_FP: J1.2T (2T OUT_FP); also elsewhere on the board
OUT_IACV: J1.2W (2W OUT_IACV); also elsewhere on the board
OUT_IGN1: J1.1G (1G OUT_IGN1); also elsewhere on the board
OUT_IGN2: J1.1H (1H OUT_IGN2); also elsewhere on the board
OUT_INJ1: J1.2U (2U OUT_INJ1); also elsewhere on the board
OUT_INJ2: J1.2V (2V OUT_INJ2); also elsewhere on the board
OUT_LS7: J1.1R (1R OUT_LS7); also elsewhere on the board
OUT_TACH: J1.2I (2I OUT_TACH); also elsewhere on the board
OUT_VVT: J1.2X (2X OUT_VVT); also elsewhere on the board
V5_EXT: J1.1N (1N V5_EXT), J1.2K (2K V5_EXT); also elsewhere on the board
VBAT_IN: J1.1B (1B VBAT_IN); also elsewhere on the board
VIGN_IN: J1.1C (1C VIGN_IN); also elsewhere on the board

Notes on the sheet:
Stock harness header (Miata ECU motherboard 1989-1993): every pin labelled with the daughterboard signal it drives
Case mounting bosses (M4), tied to ground

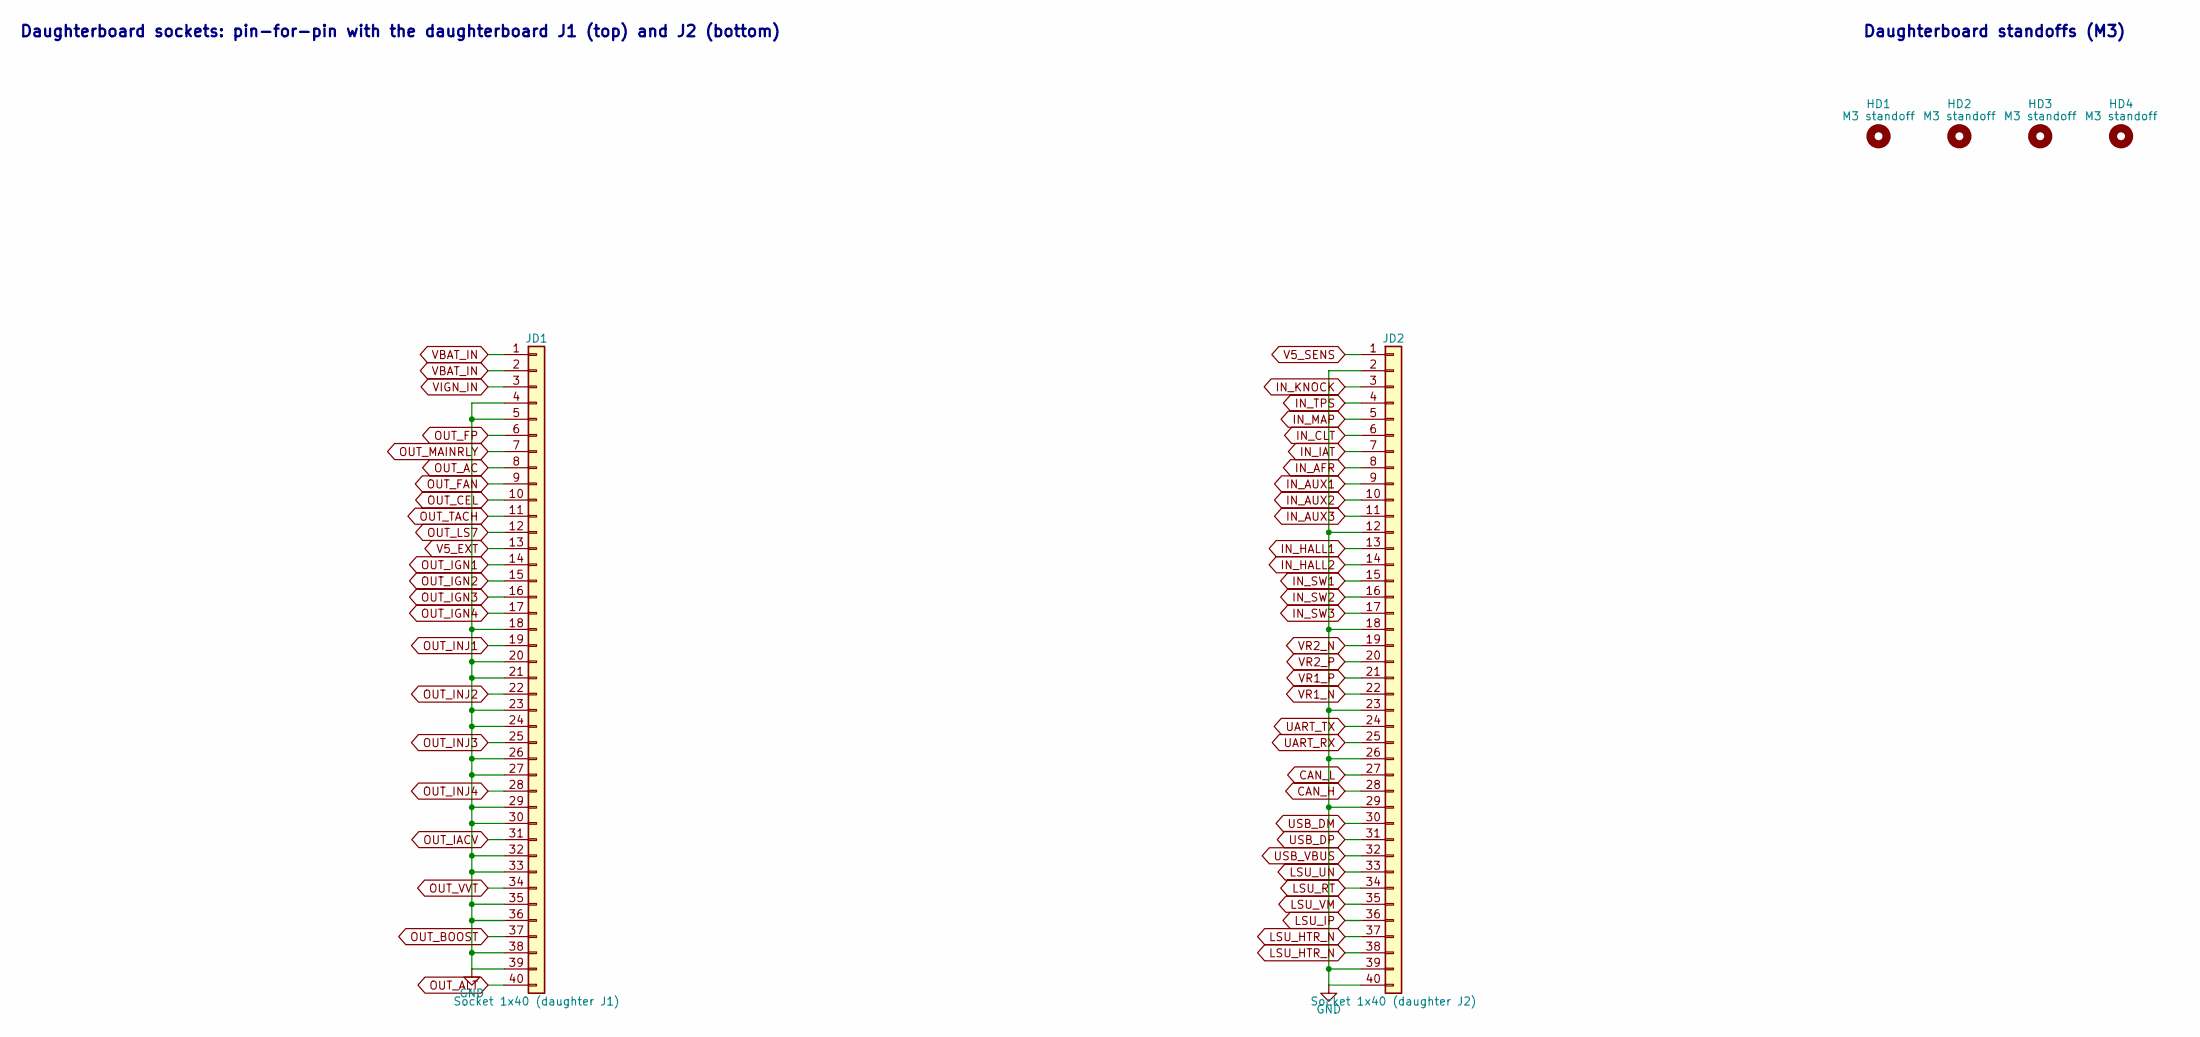
[picture p81: schematic daughter.kicad_sch, Miata ECU motherboard 1989-1993 - Daughterboard]

Parts:
HD1, HD2, HD3, HD4: M3 standoff; MountingHole_3.2mm_M3
JD1: Socket 1x40 (daughter J1); PinSocket_1x40_P2.54mm_Vertical; LCSC C124412
JD2: Socket 1x40 (daughter J2); PinSocket_1x40_P2.54mm_Vertical; LCSC C124412

Connections:
CAN_H: JD2.28; also elsewhere on the board
CAN_L: JD2.27; also elsewhere on the board
GND: JD1.4, JD1.5, JD1.18, JD1.20, JD1.21, JD1.23, JD1.24, JD1.26, JD1.27, JD1.29, JD1.30, JD1.32, JD1.33, JD1.35, JD1.36, JD1.38, JD1.39, JD2.2, JD2.12, JD2.18, JD2.23, JD2.26, JD2.29, JD2.39, JD2.40; also elsewhere on the board
IN_AFR: JD2.8; also elsewhere on the board
IN_AUX1: JD2.9; also elsewhere on the board
IN_AUX2: JD2.10; also elsewhere on the board
IN_AUX3: JD2.11; also elsewhere on the board
IN_CLT: JD2.6; also elsewhere on the board
IN_HALL1: JD2.13; also elsewhere on the board
IN_HALL2: JD2.14; also elsewhere on the board
IN_IAT: JD2.7; also elsewhere on the board
IN_KNOCK: JD2.3; also elsewhere on the board
IN_MAP: JD2.5; also elsewhere on the board
IN_SW1: JD2.15; also elsewhere on the board
IN_SW2: JD2.16; also elsewhere on the board
IN_SW3: JD2.17; also elsewhere on the board
IN_TPS: JD2.4; also elsewhere on the board
LSU_HTR_N: JD2.37, JD2.38; also elsewhere on the board
LSU_IP: JD2.36; also elsewhere on the board
LSU_RT: JD2.34; also elsewhere on the board
LSU_UN: JD2.33; also elsewhere on the board
LSU_VM: JD2.35; also elsewhere on the board
OUT_AC: JD1.8; also elsewhere on the board
OUT_ALT: JD1.40; also elsewhere on the board
OUT_BOOST: JD1.37; also elsewhere on the board
OUT_CEL: JD1.10; also elsewhere on the board
OUT_FAN: JD1.9; also elsewhere on the board
OUT_FP: JD1.6; also elsewhere on the board
OUT_IACV: JD1.31; also elsewhere on the board
OUT_IGN1: JD1.14; also elsewhere on the board
OUT_IGN2: JD1.15; also elsewhere on the board
OUT_IGN3: JD1.16; also elsewhere on the board
OUT_IGN4: JD1.17; also elsewhere on the board
OUT_INJ1: JD1.19; also elsewhere on the board
OUT_INJ2: JD1.22; also elsewhere on the board
OUT_INJ3: JD1.25; also elsewhere on the board
OUT_INJ4: JD1.28; also elsewhere on the board
OUT_LS7: JD1.12; also elsewhere on the board
OUT_MAINRLY: JD1.7; also elsewhere on the board
OUT_TACH: JD1.11; also elsewhere on the board
OUT_VVT: JD1.34; also elsewhere on the board
UART_RX: JD2.25; also elsewhere on the board
UART_TX: JD2.24; also elsewhere on the board
USB_DM: JD2.30; also elsewhere on the board
USB_DP: JD2.31; also elsewhere on the board
USB_VBUS: JD2.32; also elsewhere on the board
V5_EXT: JD1.13; also elsewhere on the board
V5_SENS: JD2.1; also elsewhere on the board
VBAT_IN: JD1.1, JD1.2; also elsewhere on the board
VIGN_IN: JD1.3; also elsewhere on the board
VR1_N: JD2.22; also elsewhere on the board
VR1_P: JD2.21; also elsewhere on the board
VR2_N: JD2.19; also elsewhere on the board
VR2_P: JD2.20; also elsewhere on the board

Notes on the sheet:
Daughterboard sockets: pin-for-pin with the daughterboard J1 (top) and J2 (bottom)
Daughterboard standoffs (M3)

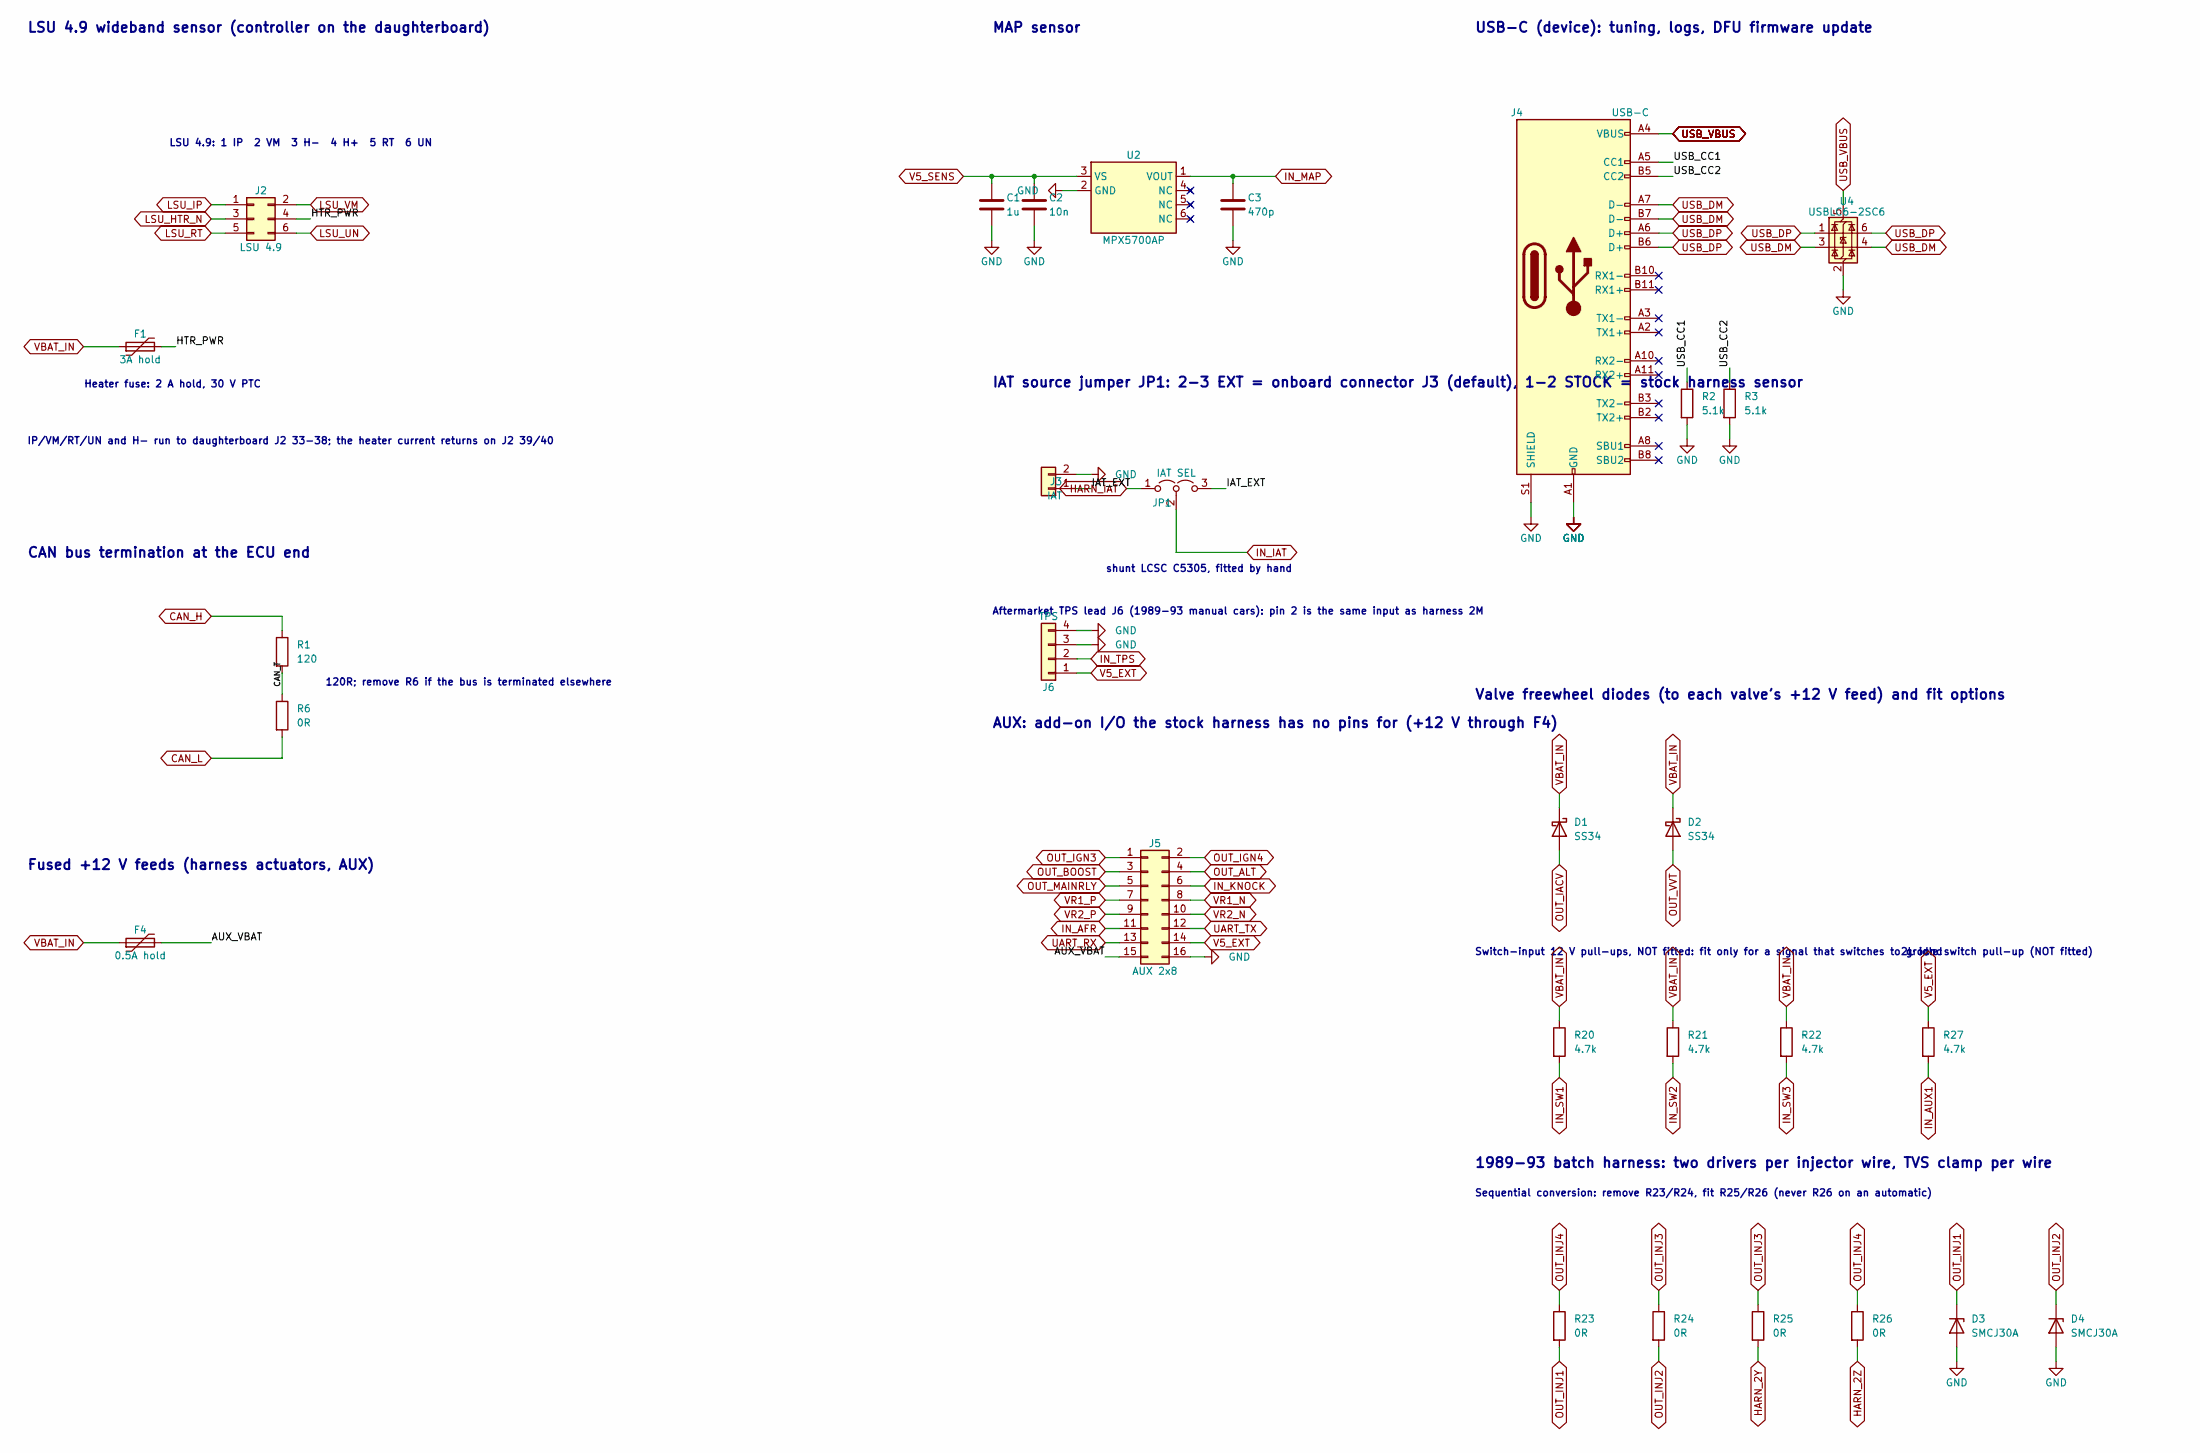
[picture p82: schematic io.kicad_sch, Miata ECU motherboard 1989-1993 - LSU, MAP, IAT, USB, AUX]

Parts:
C1: 1u; C_0603_1608Metric; LCSC C15849
C2: 10n; C_0603_1608Metric; LCSC C57112
C3: 470p; C_0603_1608Metric; LCSC C1620
D1, D2: SS34; D_SMA; LCSC C8678
D3, D4: SMCJ30A; D_SMC; LCSC C224048
F1: 3A hold; Fuse_2920_7451Metric; LCSC C22446884
F4: 0.5A hold; Fuse_1206_3216Metric; LCSC C70077
J2: LSU 4.9; Molex_Micro-Fit_3.0_43045-0600_2x03_P3.00mm_Horizontal; LCSC C127367
J3: IAT; Molex_Micro-Fit_3.0_43650-0200_1x02_P3.00mm_Horizontal; LCSC C587650
J4: USB-C; USB_C_GCT_USB4105_16P; LCSC C3020560
J5: AUX 2x8; IDC-Header_2x08_P2.54mm_Vertical; LCSC C3406
J6: TPS; Molex_Micro-Fit_3.0_43650-0400_1x04_P3.00mm_Horizontal; LCSC C277684
JP1: IAT SEL; PinHeader_1x03_P2.54mm_Vertical; LCSC C49257
R1: 120; R_0603_1608Metric; LCSC C22787
R2, R3: 5.1k; R_0603_1608Metric; LCSC C23186
R6: 0R; R_0603_1608Metric; LCSC C21189
R20, R21, R22, R27: 4.7k; R_0603_1608Metric
R23, R24: 0R; R_0805_2012Metric; LCSC C17477
R25, R26: 0R; R_0805_2012Metric
U2: MPX5700AP; MPX5700AP_867B_Flat; LCSC C90152
U4: USBLC6-2SC6; SOT-23-6; LCSC C7519

Connections:
/LSU, MAP, IAT, USB, AUX/AUX_VBAT: F4.2, J5.15
/LSU, MAP, IAT, USB, AUX/CAN_T: R1.2, R6.1
/LSU, MAP, IAT, USB, AUX/HTR_PWR: F1.2, J2.4
/LSU, MAP, IAT, USB, AUX/IAT_EXT: J3.1, JP1.3 (B)
/LSU, MAP, IAT, USB, AUX/USB_CC1: J4.A5 (CC1), R2.1
/LSU, MAP, IAT, USB, AUX/USB_CC2: J4.B5 (CC2), R3.1
CAN_H: R1.1; also elsewhere on the board
CAN_L: R6.2; also elsewhere on the board
GND: C1.2, C2.2, C3.2, D3.2 (A), D4.2 (A), J3.2, J4.A1 (GND), J4.A12 (GND), J4.B1 (GND), J4.B12 (GND), J4.S1 (SHIELD), J5.16, J6.3, J6.4, R2.2, R3.2, U2.2 (GND), U4.2 (GND); also elsewhere on the board
HARN_2Y: R25.2; also elsewhere on the board
HARN_2Z: R26.2; also elsewhere on the board
HARN_IAT: JP1.1 (A); also elsewhere on the board
IN_AFR: J5.11; also elsewhere on the board
IN_AUX1: R27.2; also elsewhere on the board
IN_IAT: JP1.2 (C); also elsewhere on the board
IN_KNOCK: J5.6; also elsewhere on the board
IN_MAP: C3.1, U2.1 (VOUT); also elsewhere on the board
IN_SW1: R20.2; also elsewhere on the board
IN_SW2: R21.2; also elsewhere on the board
IN_SW3: R22.2; also elsewhere on the board
IN_TPS: J6.2; also elsewhere on the board
LSU_HTR_N: J2.3; also elsewhere on the board
LSU_IP: J2.1; also elsewhere on the board
LSU_RT: J2.5; also elsewhere on the board
LSU_UN: J2.6; also elsewhere on the board
LSU_VM: J2.2; also elsewhere on the board
OUT_ALT: J5.4; also elsewhere on the board
OUT_BOOST: J5.3; also elsewhere on the board
OUT_IACV: D1.2 (A); also elsewhere on the board
OUT_IGN3: J5.1; also elsewhere on the board
OUT_IGN4: J5.2; also elsewhere on the board
OUT_INJ1: D3.1 (K), R23.2; also elsewhere on the board
OUT_INJ2: D4.1 (K), R24.2; also elsewhere on the board
OUT_INJ3: R24.1, R25.1; also elsewhere on the board
OUT_INJ4: R23.1, R26.1; also elsewhere on the board
OUT_MAINRLY: J5.5; also elsewhere on the board
OUT_VVT: D2.2 (A); also elsewhere on the board
UART_RX: J5.13; also elsewhere on the board
UART_TX: J5.12; also elsewhere on the board
USB_DM: J4.A7 (D-), J4.B7 (D-), U4.3 (I/O2), U4.4 (I/O2); also elsewhere on the board
USB_DP: J4.A6 (D+), J4.B6 (D+), U4.1 (I/O1), U4.6 (I/O1); also elsewhere on the board
USB_VBUS: J4.A4 (VBUS), J4.A9 (VBUS), J4.B4 (VBUS), J4.B9 (VBUS), U4.5 (VBUS); also elsewhere on the board
V5_EXT: J5.14, J6.1, R27.1; also elsewhere on the board
V5_SENS: C1.1, C2.1, U2.3 (VS); also elsewhere on the board
VBAT_IN: D1.1 (K), D2.1 (K), F1.1, F4.1, R20.1, R21.1, R22.1; also elsewhere on the board
VR1_N: J5.8; also elsewhere on the board
VR1_P: J5.7; also elsewhere on the board
VR2_N: J5.10; also elsewhere on the board
VR2_P: J5.9; also elsewhere on the board

Notes on the sheet:
LSU 4.9 wideband sensor (controller on the daughterboard)
LSU 4.9: 1 IP 2 VM 3 H- 4 H+ 5 RT 6 UN
IP/VM/RT/UN and H- run to daughterboard J2 33-38; the heater current returns on J2 39/40
Heater fuse: 2 A hold, 30 V PTC
CAN bus termination at the ECU end
120R; remove R6 if the bus is terminated elsewhere
MAP sensor
IAT source jumper JP1: 2-3 EXT = onboard connector J3 (default), 1-2 STOCK = stock harness sensor
shunt LCSC C5305, fitted by hand
Aftermarket TPS lead J6 (1989-93 manual cars): pin 2 is the same input as harness 2M
USB-C (device): tuning, logs, DFU firmware update
Fused +12 V feeds (harness actuators, AUX)
AUX: add-on I/O the stock harness has no pins for (+12 V through F4)
Valve freewheel diodes (to each valve's +12 V feed) and fit options
Switch-input 12 V pull-ups, NOT fitted: fit only for a signal that switches to ground
2L idle switch pull-up (NOT fitted)
1989-93 batch harness: two drivers per injector wire, TVS clamp per wire
Sequential conversion: remove R23/R24, fit R25/R26 (never R26 on an automatic)

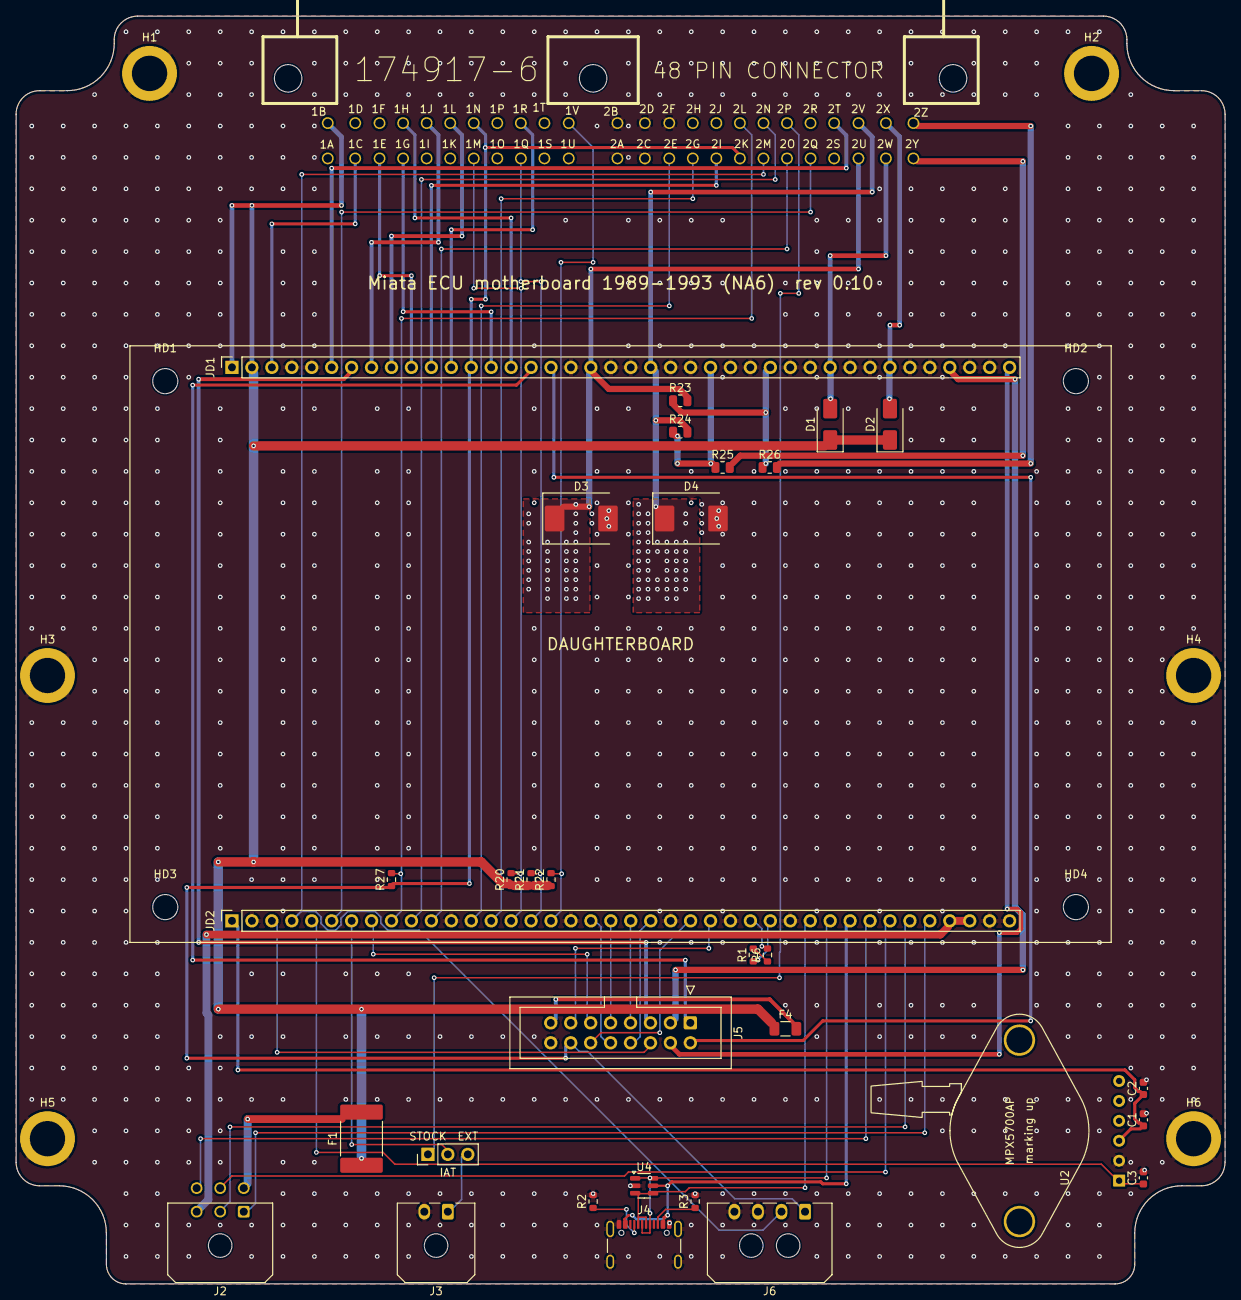
[picture p83: board miata_mb_8993.kicad_pcb from above]

Board: 2 copper layers, 154.0 x 161.5 mm, 42 parts (0 on the bottom side), 63 nets.
