v3ai/miata-ecus/daughterboard/miata_ecu_daughter.kicad_pcb

## KiCad design daughterboard/miata_ecu_daughter.kicad_pcb (2026-11-04)

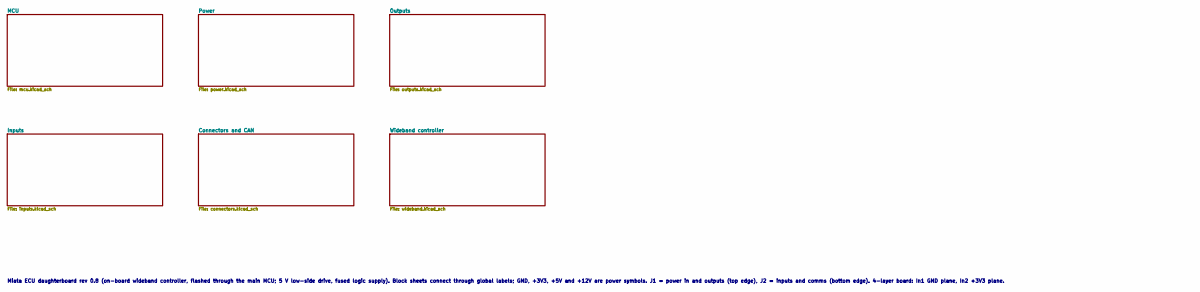
[picture p84: schematic miata_ecu_daughter.kicad_sch, Miata ECU daughterboard]

Notes on the sheet:
Miata ECU daughterboard rev 0.8 (on-board wideband controller, flashed through the main MCU; 5 V low-side drive, fused logic supply). Block sheets connect through global labels; GND, +3V3, +5V and +12V are power symbols. J1 = power in and outputs (top edge), J2 = inputs and comms (bottom edge). 4-l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

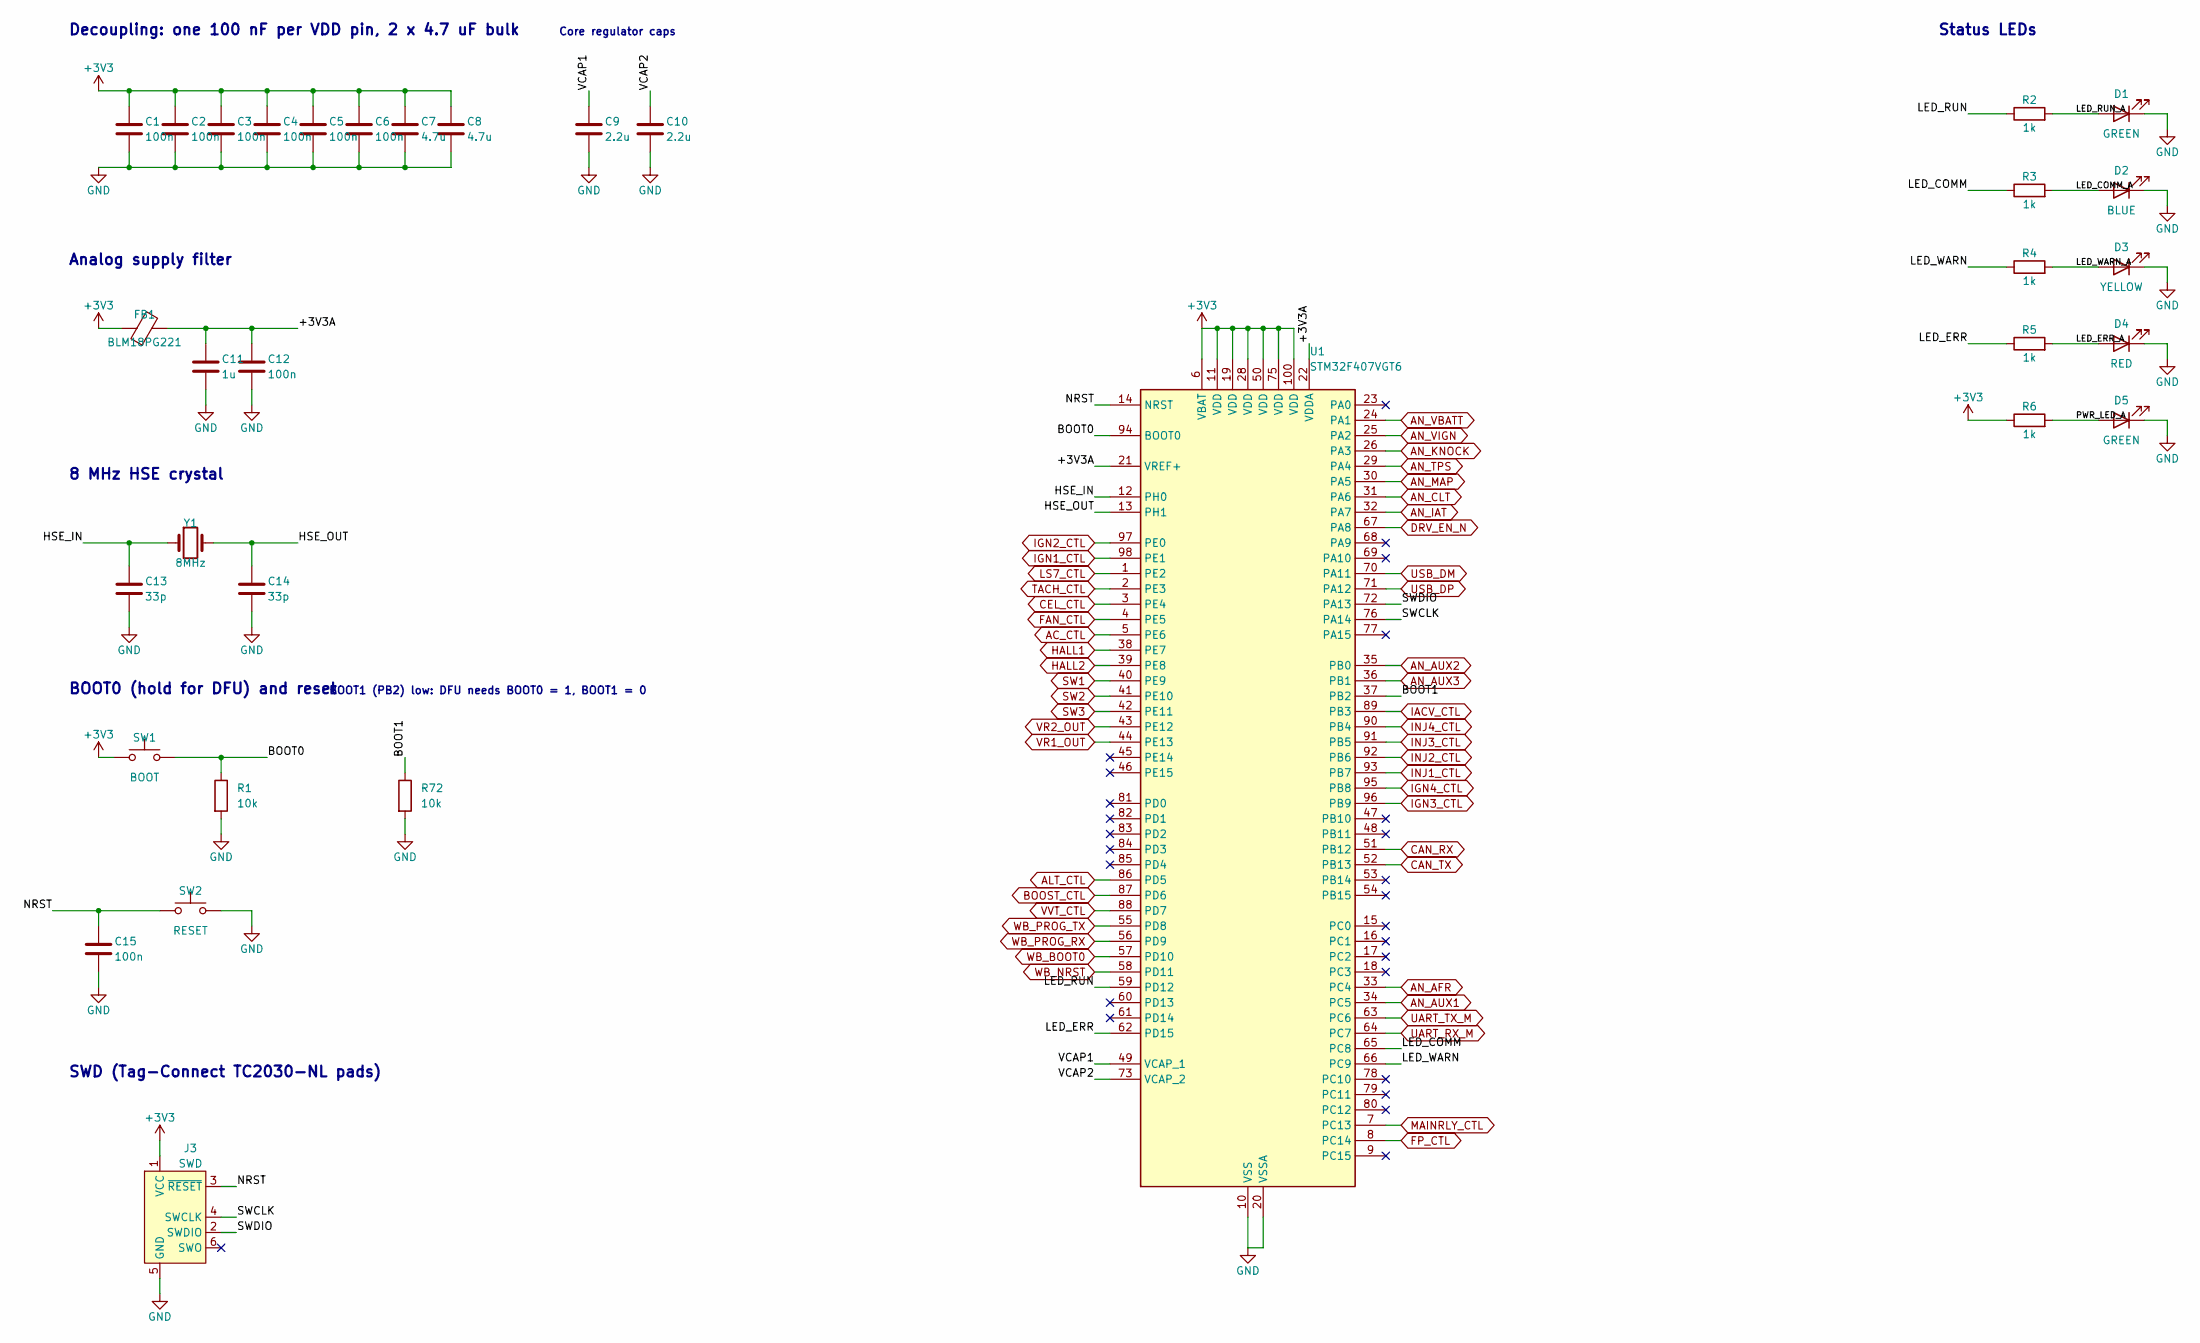
[picture p85: schematic mcu.kicad_sch, Miata ECU daughterboard - MCU]

Parts:
C1, C2, C3, C5, C6, C12, C15: 100n; C_0603_1608Metric; LCSC C14663
C4: 100n; C_0402_1005Metric; LCSC C1525
C7, C8: 4.7u; C_0603_1608Metric; LCSC C19666
C9, C10: 2.2u; C_0603_1608Metric; LCSC C23630
C11: 1u; C_0603_1608Metric; LCSC C15849
C13, C14: 33p; C_0603_1608Metric; LCSC C1663
D1, D5: GREEN; LED_0603_1608Metric; LCSC C12624
D2: BLUE; LED_0603_1608Metric; LCSC C2288
D3: YELLOW; LED_0603_1608Metric; LCSC C2287
D4: RED; LED_0603_1608Metric; LCSC C2286
FB1: BLM18PG221; L_0603_1608Metric; LCSC C80165
J3: SWD; Tag-Connect_TC2030-IDC-NL_2x03_P1.27mm_Vertical
R1: 10k; R_0603_1608Metric; LCSC C25804
R2, R3, R4, R5, R6: 1k; R_0603_1608Metric; LCSC C21190
R72: 10k; R_0402_1005Metric; LCSC C25744
SW1: BOOT; SW_Push_1P1T_XKB_TS-1187A; LCSC C318884
SW2: RESET; SW_Push_1P1T_XKB_TS-1187A; LCSC C318884
U1: STM32F407VGT6; LQFP-100_14x14mm_P0.5mm; LCSC C12345
Y1: 8MHz; Crystal_SMD_5032-2Pin_5.0x3.2mm; LCSC C115962

Connections:
+3V3: C1.1, C2.1, C3.1, C4.1, C5.1, C6.1, C7.1, C8.1, FB1.1, J3.1 (VCC), R6.1, SW1.1, U1.6 (VBAT), U1.11 (VDD), U1.19 (VDD), U1.28 (VDD), U1.50 (VDD), U1.75 (VDD), U1.100 (VDD); also elsewhere on the board
/MCU/+3V3A: C11.1, C12.1, FB1.2, U1.21 (VREF+), U1.22 (VDDA)
/MCU/BOOT0: R1.1, SW1.2, U1.94 (BOOT0)
/MCU/BOOT1: R72.1, U1.37 (PB2)
/MCU/HSE_IN: C13.1, U1.12 (PH0), Y1.1
/MCU/HSE_OUT: C14.1, U1.13 (PH1), Y1.2
/MCU/LED_COMM: R3.1, U1.65 (PC8)
/MCU/LED_COMM_A: D2.2 (A), R3.2
/MCU/LED_ERR: R5.1, U1.62 (PD15)
/MCU/LED_ERR_A: D4.2 (A), R5.2
/MCU/LED_RUN: R2.1, U1.59 (PD12)
/MCU/LED_RUN_A: D1.2 (A), R2.2
/MCU/LED_WARN: R4.1, U1.66 (PC9)
/MCU/LED_WARN_A: D3.2 (A), R4.2
/MCU/NRST: C15.1, J3.3 (~RESET), SW2.1, U1.14 (NRST)
/MCU/PWR_LED_A: D5.2 (A), R6.2
/MCU/SWCLK: J3.4 (SWCLK), U1.76 (PA14)
/MCU/SWDIO: J3.2 (SWDIO), U1.72 (PA13)
/MCU/VCAP1: C9.1, U1.49 (VCAP_1)
/MCU/VCAP2: C10.1, U1.73 (VCAP_2)
AC_CTL: U1.5 (PE6); also elsewhere on the board
ALT_CTL: U1.86 (PD5); also elsewhere on the board
AN_AFR: U1.33 (PC4); also elsewhere on the board
AN_AUX1: U1.34 (PC5); also elsewhere on the board
AN_AUX2: U1.35 (PB0); also elsewhere on the board
AN_AUX3: U1.36 (PB1); also elsewhere on the board
AN_CLT: U1.31 (PA6); also elsewhere on the board
AN_IAT: U1.32 (PA7); also elsewhere on the board
AN_KNOCK: U1.26 (PA3); also elsewhere on the board
AN_MAP: U1.30 (PA5); also elsewhere on the board
AN_TPS: U1.29 (PA4); also elsewhere on the board
AN_VBATT: U1.24 (PA1); also elsewhere on the board
AN_VIGN: U1.25 (PA2); also elsewhere on the board
BOOST_CTL: U1.87 (PD6); also elsewhere on the board
CAN_RX: U1.51 (PB12); also elsewhere on the board
CAN_TX: U1.52 (PB13); also elsewhere on the board
CEL_CTL: U1.3 (PE4); also elsewhere on the board
DRV_EN_N: U1.67 (PA8); also elsewhere on the board
FAN_CTL: U1.4 (PE5); also elsewhere on the board
FP_CTL: U1.8 (PC14); also elsewhere on the board
GND: C1.2, C2.2, C3.2, C4.2, C5.2, C6.2, C7.2, C8.2, C9.2, C10.2, C11.2, C12.2, C13.2, C14.2, C15.2, D1.1 (K), D2.1 (K), D3.1 (K), D4.1 (K), D5.1 (K), J3.5 (GND), R1.2, R72.2, SW2.2, U1.10 (VSS), U1.20 (VSSA), U1.27 (VSS), U1.74 (VSS), U1.99 (VSS); also elsewhere on the board
HALL1: U1.38 (PE7); also elsewhere on the board
HALL2: U1.39 (PE8); also elsewhere on the board
IACV_CTL: U1.89 (PB3); also elsewhere on the board
IGN1_CTL: U1.98 (PE1); also elsewhere on the board
IGN2_CTL: U1.97 (PE0); also elsewhere on the board
IGN3_CTL: U1.96 (PB9); also elsewhere on the board
IGN4_CTL: U1.95 (PB8); also elsewhere on the board
INJ1_CTL: U1.93 (PB7); also elsewhere on the board
INJ2_CTL: U1.92 (PB6); also elsewhere on the board
INJ3_CTL: U1.91 (PB5); also elsewhere on the board
INJ4_CTL: U1.90 (PB4); also elsewhere on the board
LS7_CTL: U1.1 (PE2); also elsewhere on the board
MAINRLY_CTL: U1.7 (PC13); also elsewhere on the board
SW1: U1.40 (PE9); also elsewhere on the board
SW2: U1.41 (PE10); also elsewhere on the board
SW3: U1.42 (PE11); also elsewhere on the board
TACH_CTL: U1.2 (PE3); also elsewhere on the board
UART_RX_M: U1.64 (PC7); also elsewhere on the board
UART_TX_M: U1.63 (PC6); also elsewhere on the board
USB_DM: U1.70 (PA11); also elsewhere on the board
USB_DP: U1.71 (PA12); also elsewhere on the board
VR1_OUT: U1.44 (PE13); also elsewhere on the board
VR2_OUT: U1.43 (PE12); also elsewhere on the board
VVT_CTL: U1.88 (PD7); also elsewhere on the board
WB_BOOT0: U1.57 (PD10); also elsewhere on the board
WB_NRST: U1.58 (PD11); also elsewhere on the board
WB_PROG_RX: U1.56 (PD9); also elsewhere on the board
WB_PROG_TX: U1.55 (PD8); also elsewhere on the board

Notes on the sheet:
Decoupling: one 100 nF per VDD pin, 2 x 4.7 uF bulk
Core regulator caps
Analog supply filter
8 MHz HSE crystal
BOOT0 (hold for DFU) and reset
BOOT1 (PB2) low: DFU needs BOOT0 = 1, BOOT1 = 0
SWD (Tag-Connect TC2030-NL pads)
Status LEDs
