v3ai/miata-ecus/daughterboard/miata_ecu_daughter.kicad_pcb

## KiCad design daughterboard/miata_ecu_daughter.kicad_pcb (continued)

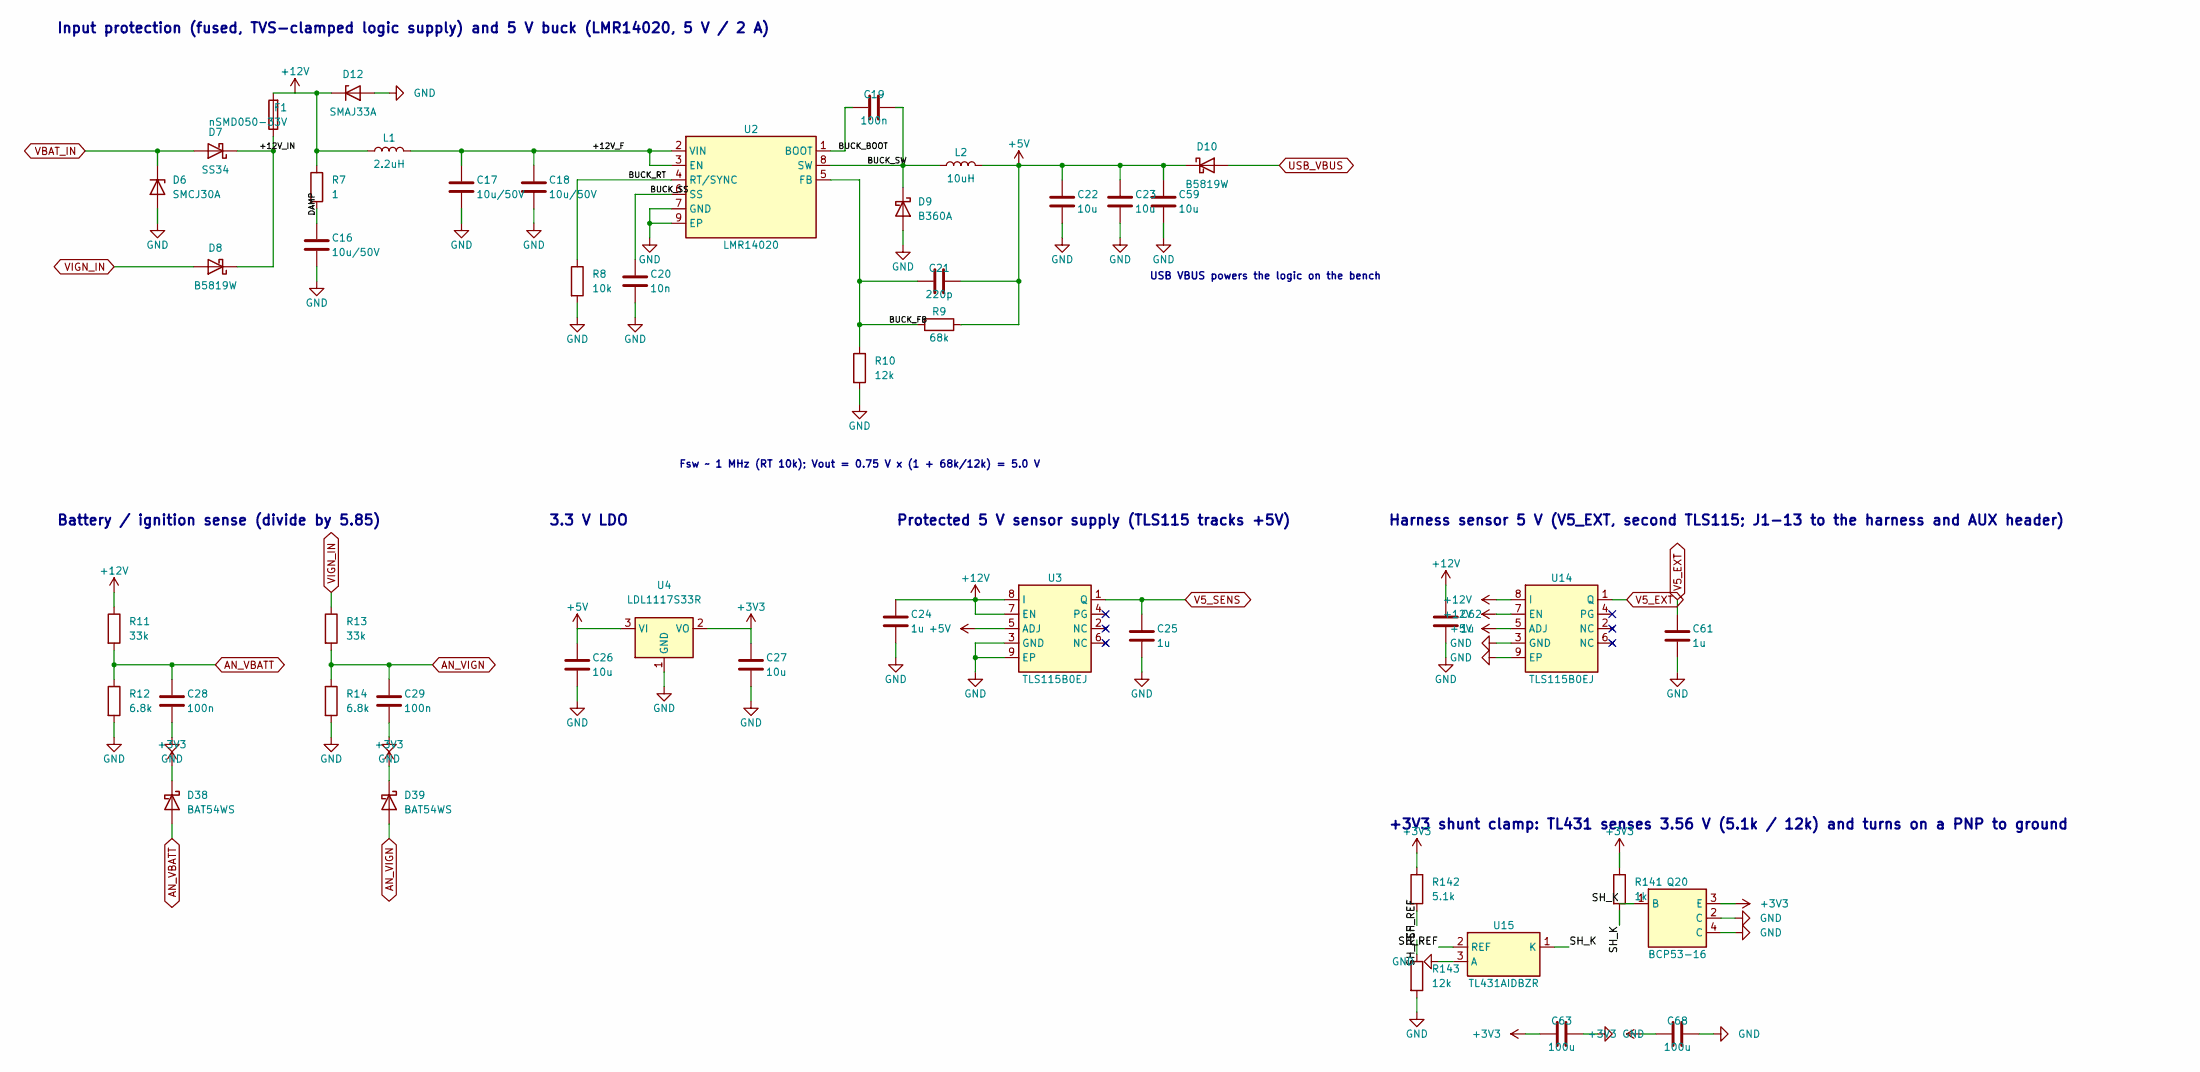
[picture p86: schematic power.kicad_sch, Miata ECU daughterboard - Power]

Parts:
C16, C17, C18: 10u/50V; C_1206_3216Metric; LCSC C13585
C19: 100n; C_0603_1608Metric; LCSC C14663
C20: 10n; C_0603_1608Metric; LCSC C57112
C21: 220p; C_0603_1608Metric; LCSC C1603
C22, C23, C26, C27, C59: 10u; C_0805_2012Metric; LCSC C15850
C24, C25, C61, C62: 1u; C_0603_1608Metric; LCSC C15849
C28, C29: 100n; C_0402_1005Metric; LCSC C1525
C63, C68: 100u; C_1206_3216Metric; LCSC C15008
D6: SMCJ30A; D_SMC; LCSC C224048
D7: SS34; D_SMA; LCSC C8678
D8, D10: B5819W; D_SOD-123; LCSC C8598
D9: B360A; D_SMA; LCSC C94193
D12: SMAJ33A; D_SMA; LCSC C223988
D38, D39: BAT54WS; D_SOD-323; LCSC C124205
F1: nSMD050-33V; Fuse_1206_3216Metric; LCSC C70077
L1: 2.2uH; L_1210_3225Metric; LCSC C70960
L2: 10uH; L_Sunlord_MWSA0603S; LCSC C132141
Q20: BCP53-16; SOT-223; LCSC C85085
R7: 1; R_0603_1608Metric; LCSC C22936
R8: 10k; R_0603_1608Metric; LCSC C25804
R9: 68k; R_0603_1608Metric; LCSC C23231
R10, R143: 12k; R_0603_1608Metric; LCSC C22790
R11, R13: 33k; R_0402_1005Metric; LCSC C25779
R12, R14: 6.8k; R_0402_1005Metric; LCSC C25917
R141: 1k; R_0603_1608Metric; LCSC C21190
R142: 5.1k; R_0603_1608Metric; LCSC C23186
U2: LMR14020; SOIC-8-1EP_3.9x4.9mm_P1.27mm_EP2.29x3mm; LCSC C187824
U3, U14: TLS115B0EJ; Infineon_PG-DSO-8-27_3.9x4.9mm_EP2.65x3mm; LCSC C3743696
U4: LDL1117S33R; SOT-223-3_TabPin2; LCSC C435835
U15: TL431AIDBZR; SOT-23; LCSC C23892

Connections:
+3V3: C27.1, C63.1, C68.1, D38.1 (K), D39.1 (K), Q20.3 (E), R141.1, R142.1, U4.2 (VO); also elsewhere on the board
+5V: C21.1, C22.1, C23.1, C26.1, C59.1, D10.1 (K), L2.2, R9.1, U3.5 (ADJ), U4.3 (VI), U14.5 (ADJ); also elsewhere on the board
+12V: C24.1, C62.1, D12.1 (K), F1.2, L1.1, R7.1, R11.1, U3.7 (EN), U3.8 (I), U14.7 (EN), U14.8 (I)
/Power/+12V_F: C17.1, C18.1, L1.2, U2.2 (VIN), U2.3 (EN)
/Power/+12V_IN: D7.1 (K), D8.1 (K), F1.1
/Power/BUCK_BOOT: C19.1, U2.1 (BOOT)
/Power/BUCK_FB: C21.2, R9.2, R10.1, U2.5 (FB)
/Power/BUCK_RT: R8.1, U2.4 (RT/SYNC)
/Power/BUCK_SS: C20.1, U2.6 (SS)
/Power/BUCK_SW: C19.2, D9.1 (K), L2.1, U2.8 (SW)
/Power/DAMP: C16.1, R7.2
/Power/SH_K: Q20.1 (B), R141.2, U15.1 (K)
/Power/SH_REF: R142.2, R143.1, U15.2 (REF)
AN_VBATT: C28.1, D38.2 (A), R11.2, R12.1; also elsewhere on the board
AN_VIGN: C29.1, D39.2 (A), R13.2, R14.1; also elsewhere on the board
GND: C16.2, C17.2, C18.2, C20.2, C22.2, C23.2, C24.2, C25.2, C26.2, C27.2, C28.2, C29.2, C59.2, C61.2, C62.2, C63.2, C68.2, D6.2 (A), D9.2 (A), D12.2 (A), Q20.2 (C), Q20.4 (C), R8.2, R10.2, R12.2, R14.2, R143.2, U2.7 (GND), U2.9 (EP), U3.3 (GND), U3.9 (EP), U4.1 (GND), U14.3 (GND), U14.9 (EP), U15.3 (A); also elsewhere on the board
USB_VBUS: D10.2 (A); also elsewhere on the board
V5_EXT: C61.1, U14.1 (Q); also elsewhere on the board
V5_SENS: C25.1, U3.1 (Q); also elsewhere on the board
VBAT_IN: D6.1 (K), D7.2 (A); also elsewhere on the board
VIGN_IN: D8.2 (A), R13.1; also elsewhere on the board

Notes on the sheet:
Input protection (fused, TVS-clamped logic supply) and 5 V buck (LMR14020, 5 V / 2 A)
USB VBUS powers the logic on the bench
Fsw ~ 1 MHz (RT 10k); Vout = 0.75 V x (1 + 68k/12k) = 5.0 V
3.3 V LDO
Protected 5 V sensor supply (TLS115 tracks +5V)
Harness sensor 5 V (V5_EXT, second TLS115; J1-13 to the harness and AUX header)
+3V3 shunt clamp: TL431 senses 3.56 V (5.1k / 12k) and turns on a PNP to ground
Battery / ignition sense (divide by 5.85)

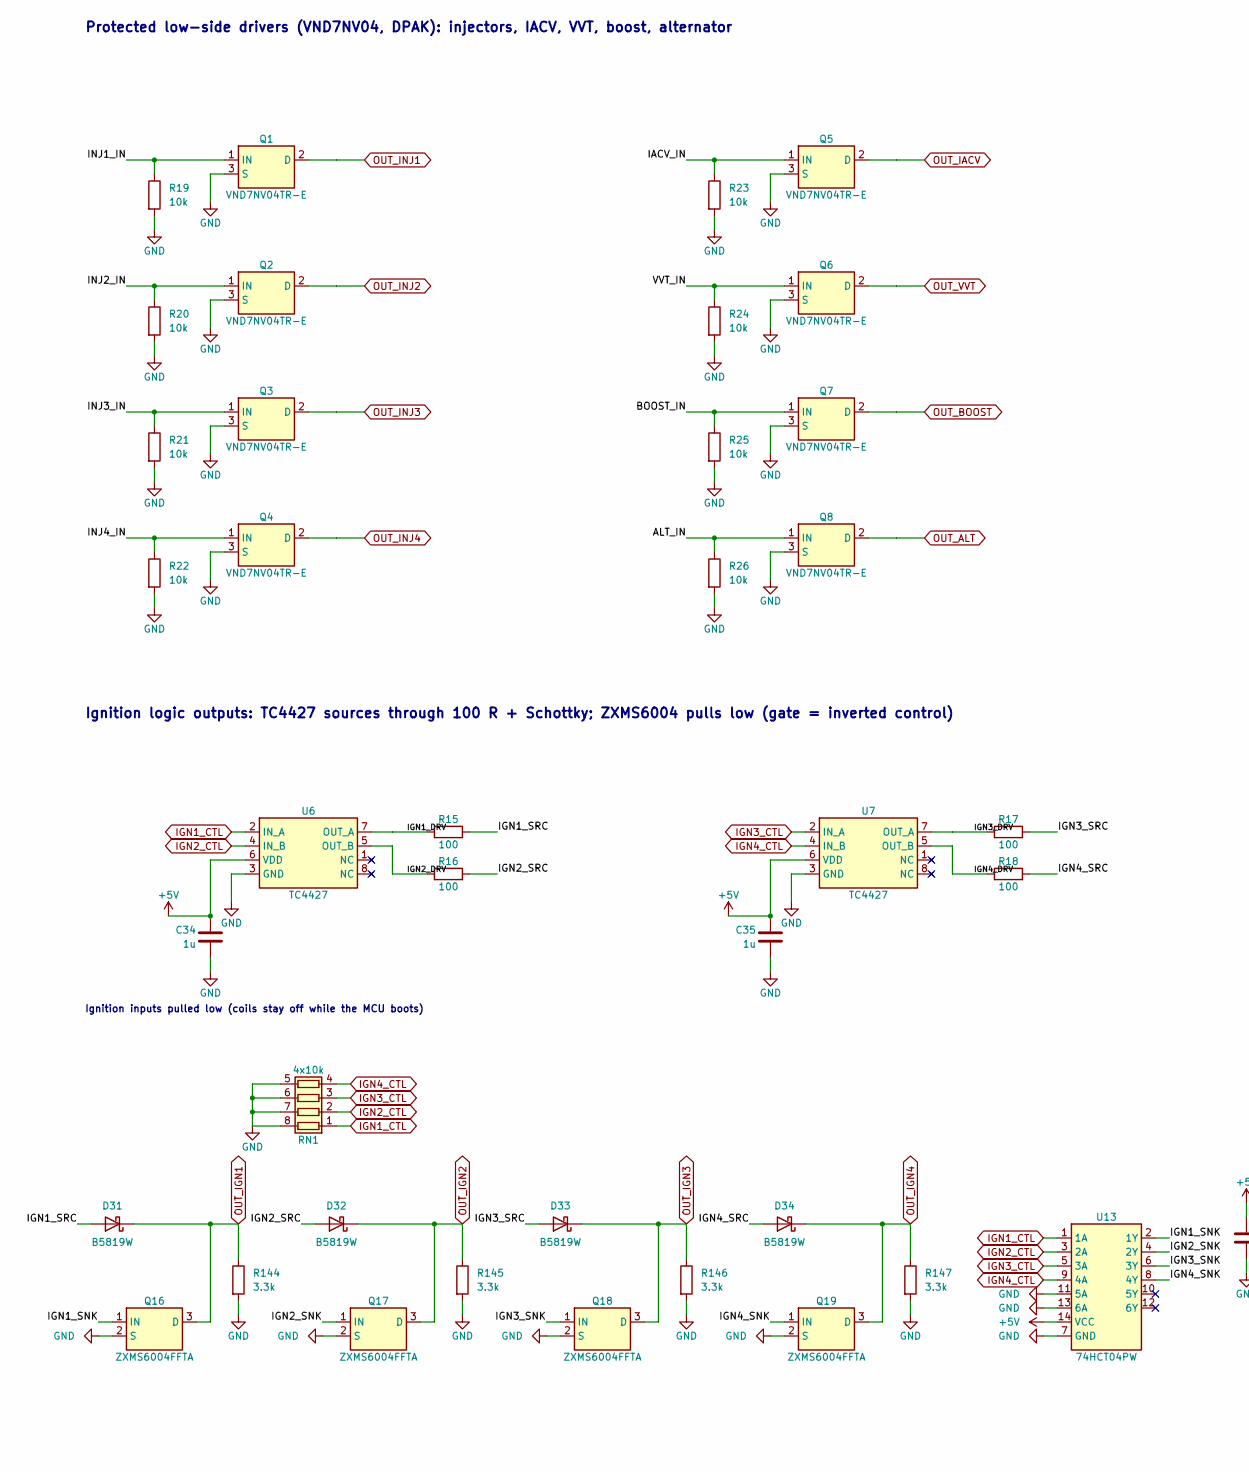
[picture p87: schematic outputs.kicad_sch, Miata ECU daughterboard - Outputs, part in row 1, column 1]

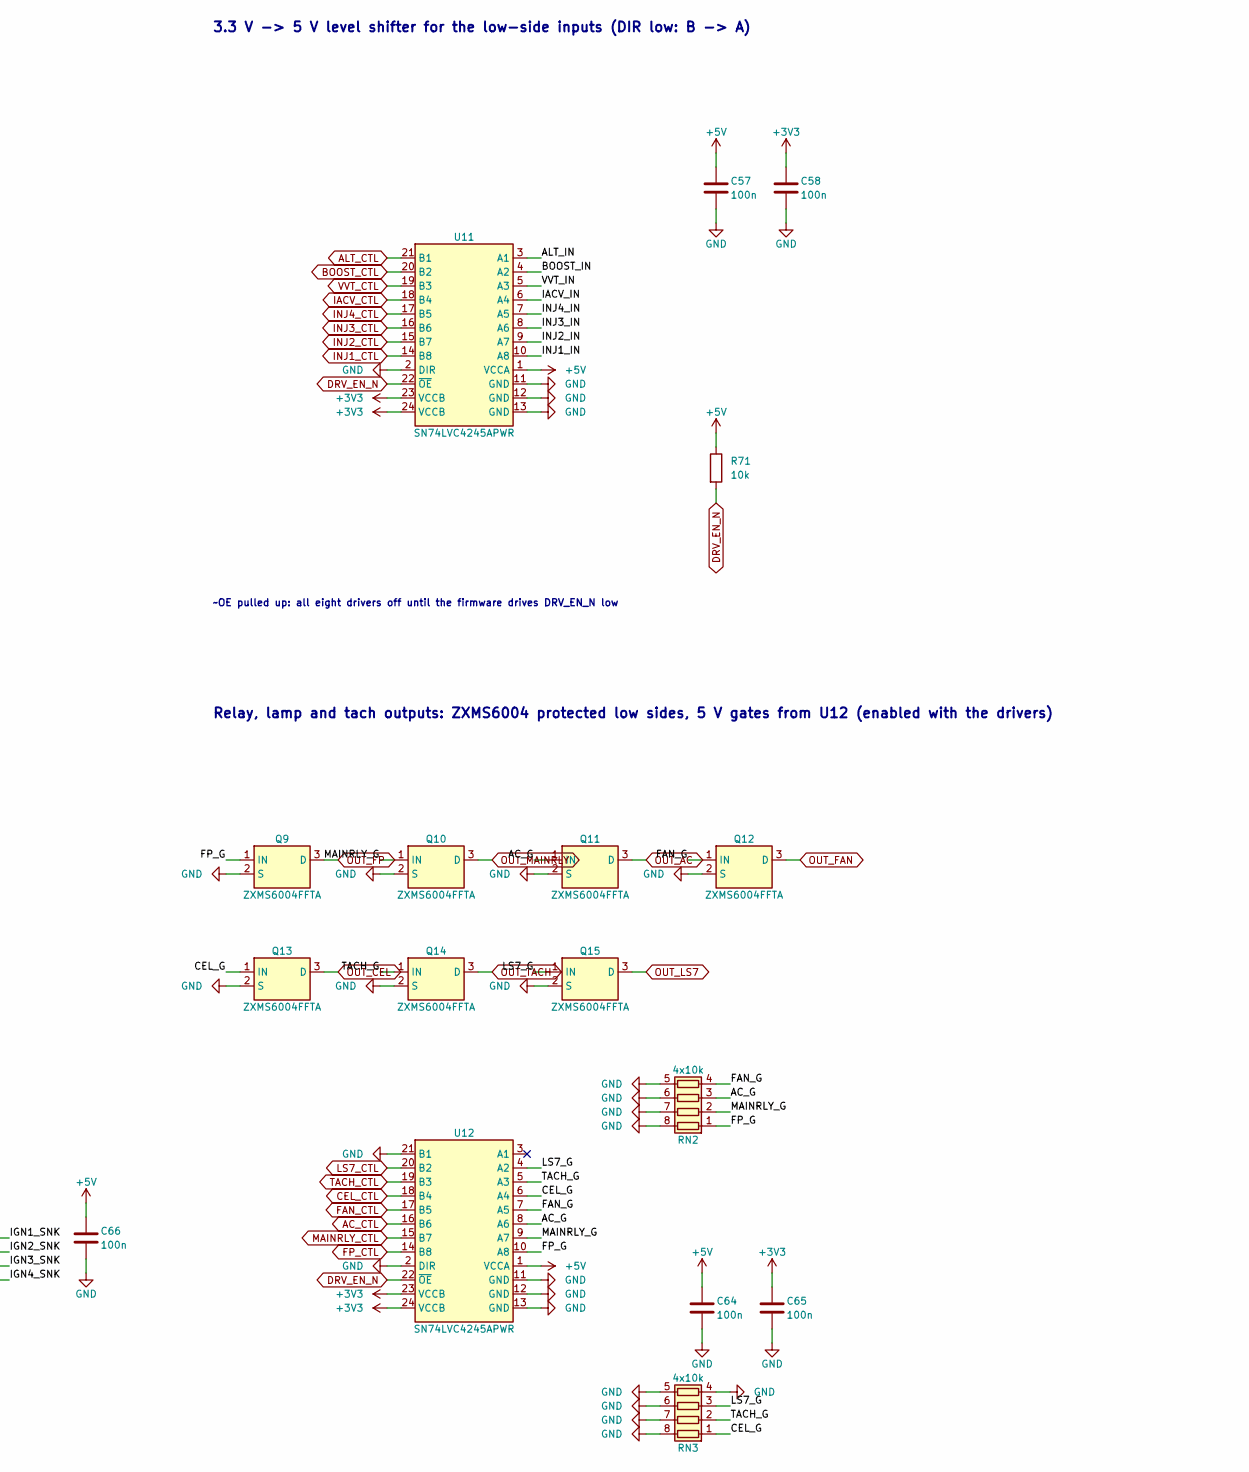
[picture p88: schematic outputs.kicad_sch, Miata ECU daughterboard - Outputs, part in row 1, column 2]

Parts:
C34, C35: 1u; C_0402_1005Metric; LCSC C52923
C57, C58, C64, C65, C66: 100n; C_0402_1005Metric; LCSC C1525
D31, D32, D33, D34: B5819W; D_SOD-123; LCSC C8598
Q1, Q2, Q3, Q4, Q5, Q6, Q7, Q8: VND7NV04TR-E; TO-252-2; LCSC C155605
Q9, Q10, Q11, Q12, Q13, Q14, Q15, Q16, Q17, Q18, Q19: ZXMS6004FFTA; SOT-23; LCSC C95063
R15, R16, R17, R18: 100; R_1206_3216Metric; LCSC C17901
R19, R20, R21, R22, R23, R24, R25, R26: 10k; R_0603_1608Metric; LCSC C25804
R71: 10k; R_0402_1005Metric; LCSC C25744
R144, R145, R146, R147: 3.3k; R_1206_3216Metric; LCSC C26032
RN1, RN2, RN3: 4x10k; R_Array_Convex_4x0603; LCSC C29718
U6, U7: TC4427; SOIC-8_3.9x4.9mm_P1.27mm; LCSC C20551
U11, U12: SN74LVC4245APWR; TSSOP-24_4.4x7.8mm_P0.65mm; LCSC C7859
U13: 74HCT04PW; TSSOP-14_4.4x5mm_P0.65mm; LCSC C131317

Connections:
+3V3: C58.1, C65.1, U11.23 (VCCB), U11.24 (VCCB), U12.23 (VCCB), U12.24 (VCCB); also elsewhere on the board
+5V: C34.1, C35.1, C57.1, C64.1, C66.1, R71.1, U6.6 (VDD), U7.6 (VDD), U11.1 (VCCA), U12.1 (VCCA), U13.14 (VCC); also elsewhere on the board
/Outputs/AC_G: Q11.1 (IN), RN2.3 (R3.1), U12.8 (A6)
/Outputs/ALT_IN: Q8.1 (IN), R26.1, U11.3 (A1)
/Outputs/BOOST_IN: Q7.1 (IN), R25.1, U11.4 (A2)
/Outputs/CEL_G: Q13.1 (IN), RN3.1 (R1.1), U12.6 (A4)
/Outputs/FAN_G: Q12.1 (IN), RN2.4 (R4.1), U12.7 (A5)
/Outputs/FP_G: Q9.1 (IN), RN2.1 (R1.1), U12.10 (A8)
/Outputs/IACV_IN: Q5.1 (IN), R23.1, U11.6 (A4)
/Outputs/IGN1_DRV: R15.1, U6.7 (OUT_A)
/Outputs/IGN1_SNK: Q16.1 (IN), U13.2 (1Y)
/Outputs/IGN1_SRC: D31.2 (A), R15.2
/Outputs/IGN2_DRV: R16.1, U6.5 (OUT_B)
/Outputs/IGN2_SNK: Q17.1 (IN), U13.4 (2Y)
/Outputs/IGN2_SRC: D32.2 (A), R16.2
/Outputs/IGN3_DRV: R17.1, U7.7 (OUT_A)
/Outputs/IGN3_SNK: Q18.1 (IN), U13.6 (3Y)
/Outputs/IGN3_SRC: D33.2 (A), R17.2
/Outputs/IGN4_DRV: R18.1, U7.5 (OUT_B)
/Outputs/IGN4_SNK: Q19.1 (IN), U13.8 (4Y)
/Outputs/IGN4_SRC: D34.2 (A), R18.2
/Outputs/INJ1_IN: Q1.1 (IN), R19.1, U11.10 (A8)
/Outputs/INJ2_IN: Q2.1 (IN), R20.1, U11.9 (A7)
/Outputs/INJ3_IN: Q3.1 (IN), R21.1, U11.8 (A6)
/Outputs/INJ4_IN: Q4.1 (IN), R22.1, U11.7 (A5)
/Outputs/LS7_G: Q15.1 (IN), RN3.3 (R3.1), U12.4 (A2)
/Outputs/MAINRLY_G: Q10.1 (IN), RN2.2 (R2.1), U12.9 (A7)
/Outputs/TACH_G: Q14.1 (IN), RN3.2 (R2.1), U12.5 (A3)
/Outputs/VVT_IN: Q6.1 (IN), R24.1, U11.5 (A3)
AC_CTL: U12.16 (B6); also elsewhere on the board
ALT_CTL: U11.21 (B1); also elsewhere on the board
BOOST_CTL: U11.20 (B2); also elsewhere on the board
CEL_CTL: U12.18 (B4); also elsewhere on the board
DRV_EN_N: R71.2, U11.22 (~OE), U12.22 (~OE); also elsewhere on the board
FAN_CTL: U12.17 (B5); also elsewhere on the board
FP_CTL: U12.14 (B8); also elsewhere on the board
GND: C34.2, C35.2, C57.2, C58.2, C64.2, C65.2, C66.2, Q1.3 (S), Q2.3 (S), Q3.3 (S), Q4.3 (S), Q5.3 (S), Q6.3 (S), Q7.3 (S), Q8.3 (S), Q9.2 (S), Q10.2 (S), Q11.2 (S), Q12.2 (S), Q13.2 (S), Q14.2 (S), Q15.2 (S), Q16.2 (S), Q17.2 (S), Q18.2 (S), Q19.2 (S), R19.2, R20.2, R21.2, R22.2, R23.2, R24.2, R25.2, R26.2, R144.2, R145.2, R146.2, R147.2, RN1.5 (R4.2), RN1.6 (R3.2), RN1.7 (R2.2), RN1.8 (R1.2), RN2.5 (R4.2), RN2.6 (R3.2), RN2.7 (R2.2), RN2.8 (R1.2), RN3.4 (R4.1), RN3.5 (R4.2), RN3.6 (R3.2), RN3.7 (R2.2), RN3.8 (R1.2), U6.3 (GND), U7.3 (GND), U11.2 (DIR), U11.11 (GND), U11.12 (GND), U11.13 (GND), U12.2 (DIR), U12.11 (GND), U12.12 (GND), U12.13 (GND), U12.21 (B1), U13.7 (GND), U13.11 (5A), U13.13 (6A); also elsewhere on the board
IACV_CTL: U11.18 (B4); also elsewhere on the board
IGN1_CTL: RN1.1 (R1.1), U6.2 (IN_A), U13.1 (1A); also elsewhere on the board
IGN2_CTL: RN1.2 (R2.1), U6.4 (IN_B), U13.3 (2A); also elsewhere on the board
IGN3_CTL: RN1.3 (R3.1), U7.2 (IN_A), U13.5 (3A); also elsewhere on the board
IGN4_CTL: RN1.4 (R4.1), U7.4 (IN_B), U13.9 (4A); also elsewhere on the board
INJ1_CTL: U11.14 (B8); also elsewhere on the board
INJ2_CTL: U11.15 (B7); also elsewhere on the board
INJ3_CTL: U11.16 (B6); also elsewhere on the board
INJ4_CTL: U11.17 (B5); also elsewhere on the board
LS7_CTL: U12.20 (B2); also elsewhere on the board
MAINRLY_CTL: U12.15 (B7); also elsewhere on the board
OUT_AC: Q11.3 (D); also elsewhere on the board
OUT_ALT: Q8.2 (D); also elsewhere on the board
OUT_BOOST: Q7.2 (D); also elsewhere on the board
OUT_CEL: Q13.3 (D); also elsewhere on the board
OUT_FAN: Q12.3 (D); also elsewhere on the board
OUT_FP: Q9.3 (D); also elsewhere on the board
OUT_IACV: Q5.2 (D); also elsewhere on the board
OUT_IGN1: D31.1 (K), Q16.3 (D), R144.1; also elsewhere on the board
OUT_IGN2: D32.1 (K), Q17.3 (D), R145.1; also elsewhere on the board
OUT_IGN3: D33.1 (K), Q18.3 (D), R146.1; also elsewhere on the board
OUT_IGN4: D34.1 (K), Q19.3 (D), R147.1; also elsewhere on the board
OUT_INJ1: Q1.2 (D); also elsewhere on the board
OUT_INJ2: Q2.2 (D); also elsewhere on the board
OUT_INJ3: Q3.2 (D); also elsewhere on the board
OUT_INJ4: Q4.2 (D); also elsewhere on the board
OUT_LS7: Q15.3 (D); also elsewhere on the board
OUT_MAINRLY: Q10.3 (D); also elsewhere on the board
OUT_TACH: Q14.3 (D); also elsewhere on the board
OUT_VVT: Q6.2 (D); also elsewhere on the board
TACH_CTL: U12.19 (B3); also elsewhere on the board
VVT_CTL: U11.19 (B3); also elsewhere on the board

Notes on the sheet:
Protected low-side drivers (VND7NV04, DPAK): injectors, IACV, VVT, boost, alternator
Ignition logic outputs: TC4427 sources through 100 R + Schottky; ZXMS6004 pulls low (gate = inverted control)
Ignition inputs pulled low (coils stay off while the MCU boots)
Relay, lamp and tach outputs: ZXMS6004 protected low sides, 5 V gates from U12 (enabled with the drivers)
3.3 V -> 5 V level shifter for the low-side inputs (DIR low: B -> A)
~OE pulled up: all eight drivers off until the firmware drives DRV_EN_N low

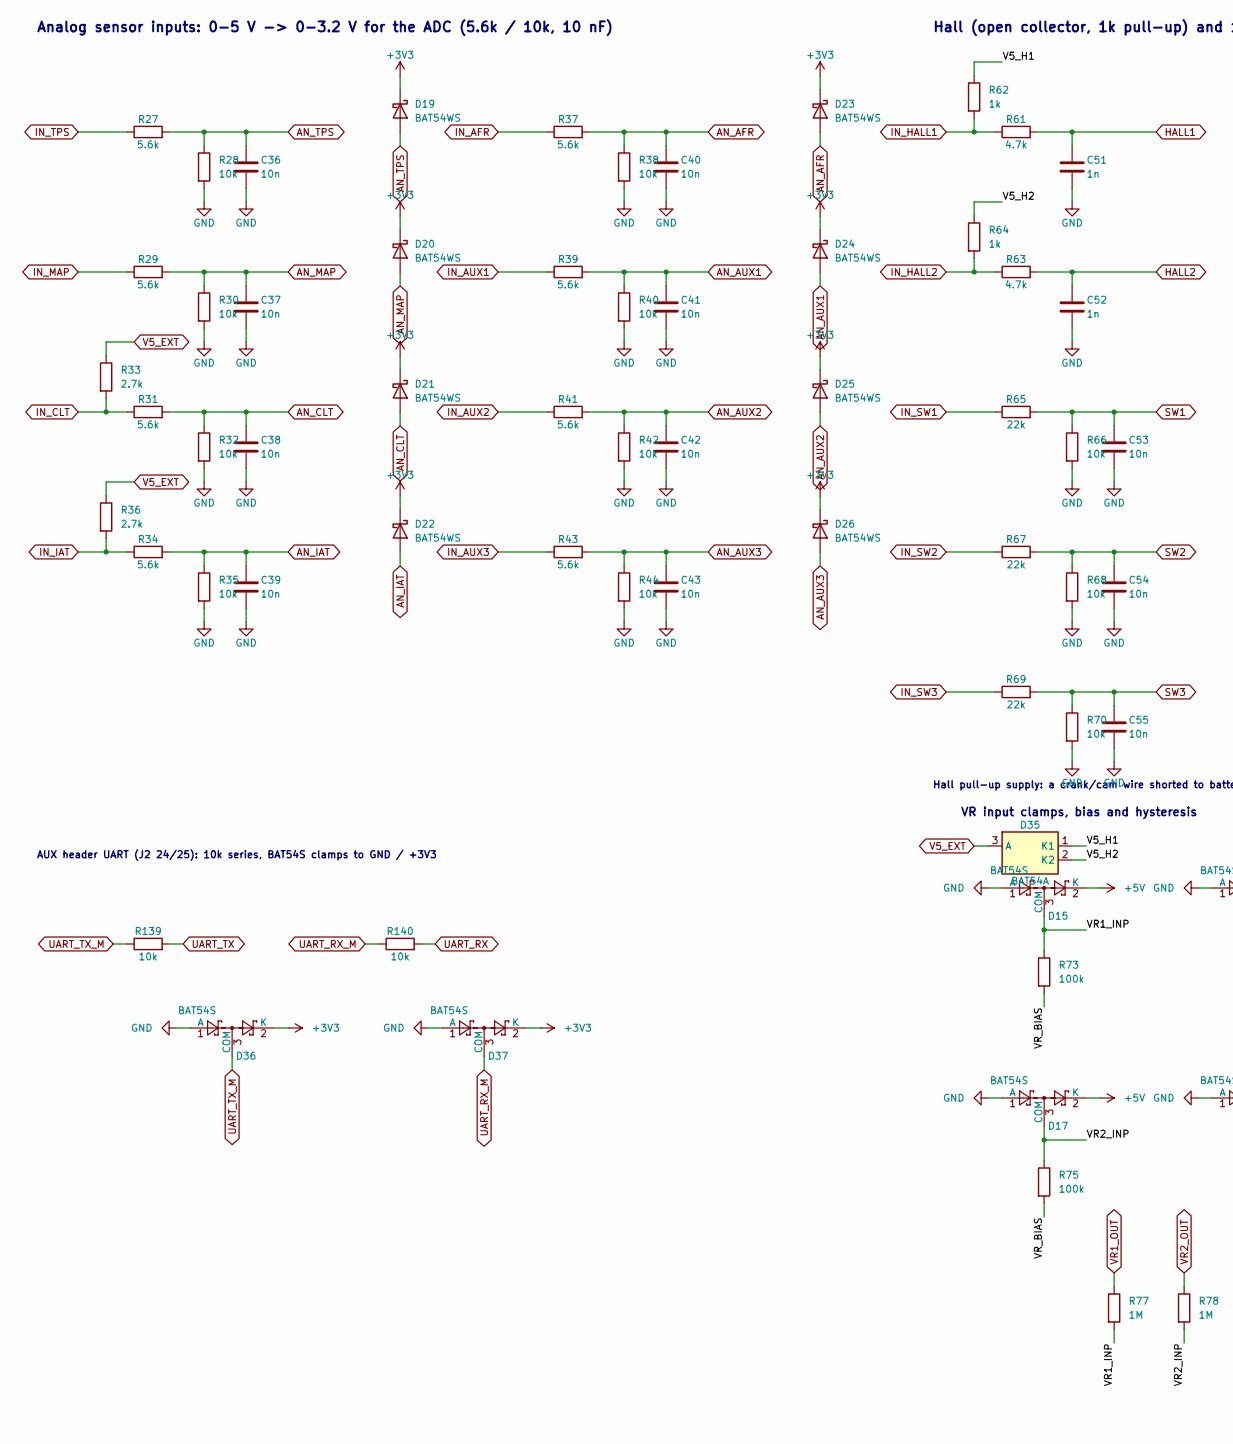
[picture p89: schematic inputs.kicad_sch, Miata ECU daughterboard - Inputs, part in row 1, column 1]

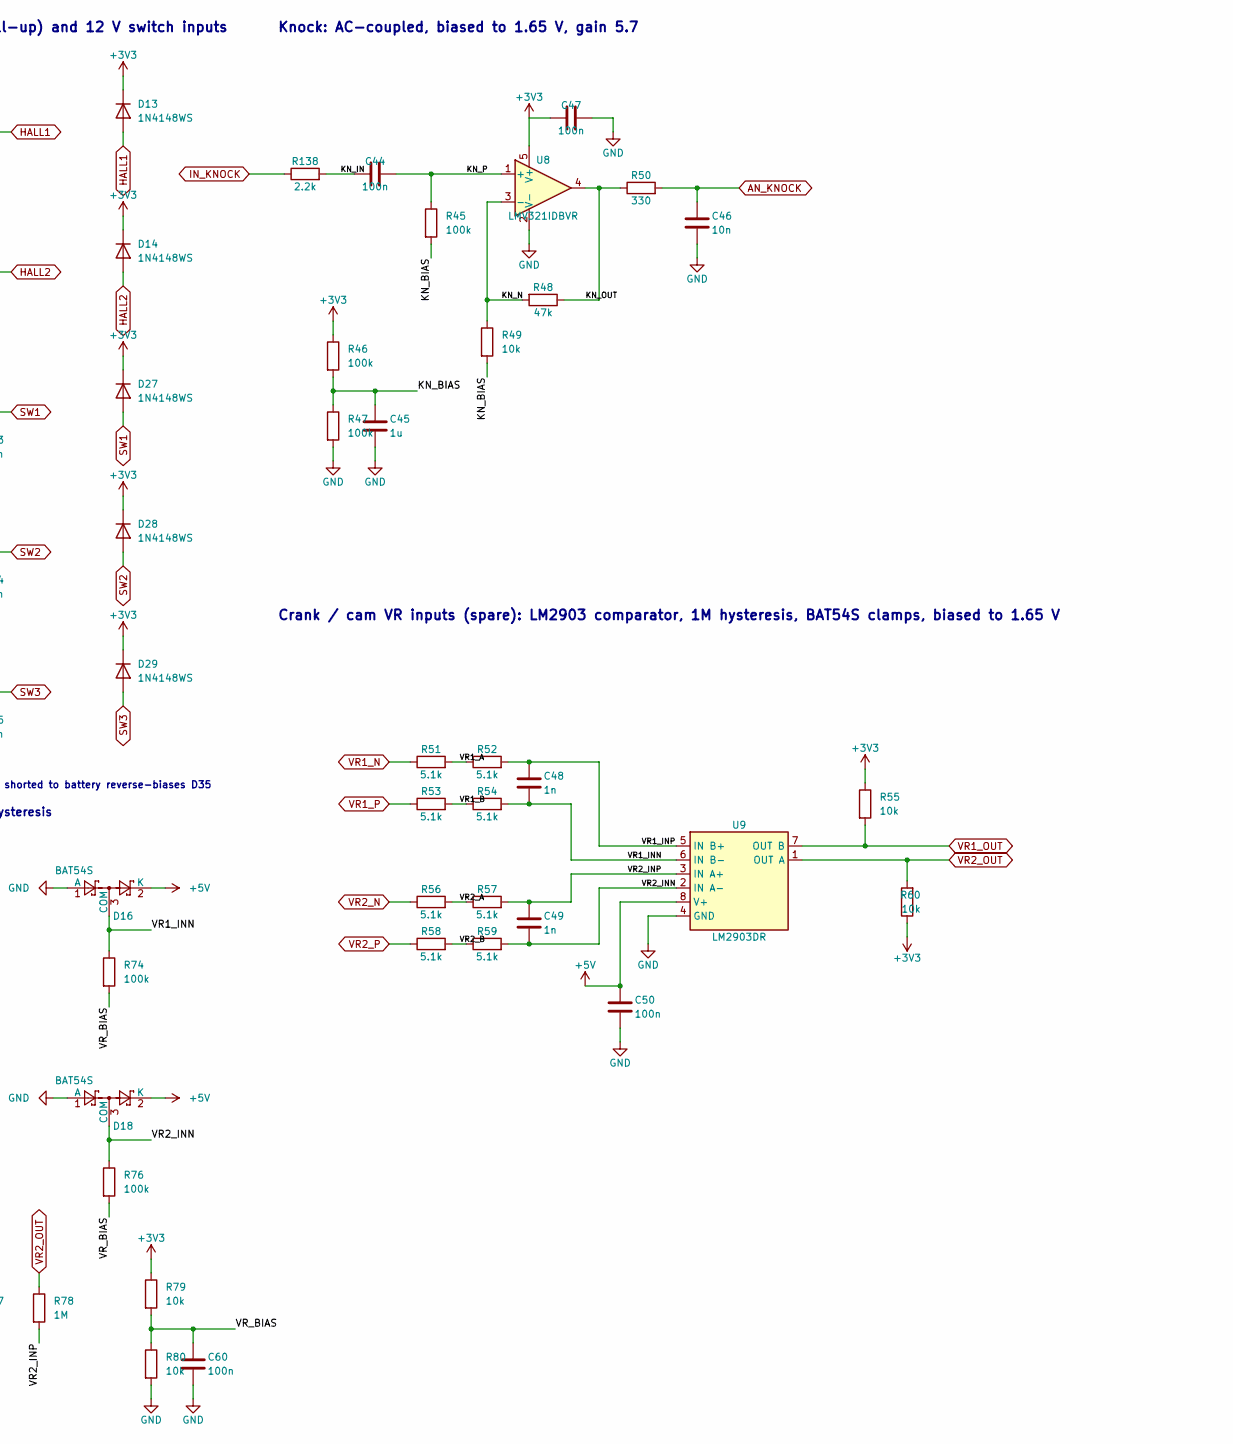
[picture p90: schematic inputs.kicad_sch, Miata ECU daughterboard - Inputs, part in row 1, column 2]

Parts:
C36, C37, C38, C39, C40, C41, C42, C43, C53, C54, C55: 10n; C_0402_1005Metric; LCSC C15195
C44, C47, C50: 100n; C_0603_1608Metric; LCSC C14663
C45: 1u; C_0603_1608Metric; LCSC C15849
C46: 10n; C_0603_1608Metric; LCSC C57112
C48, C49: 1n; C_0805_2012Metric; LCSC C46653
C51, C52: 1n; C_0402_1005Metric; LCSC C1523
C60: 100n; C_0402_1005Metric; LCSC C1525
D13, D14, D27, D28, D29: 1N4148WS; D_SOD-323; LCSC C2128
D15, D16, D17, D18, D36, D37: BAT54S; SOT-23; LCSC C19726
D19, D20, D21, D22, D23, D24, D25, D26: BAT54WS; D_SOD-323; LCSC C124205
D35: BAT54A; SOT-23; LCSC C916423
R27, R29, R31, R34, R37, R39, R41, R43: 5.6k; R_0603_1608Metric; LCSC C23189
R28, R30, R32, R35, R38, R40, R42, R44, R66, R68, R70, R79, R80: 10k; R_0402_1005Metric; LCSC C25744
R33, R36: 2.7k; R_0603_1608Metric; LCSC C13167
R45, R46, R47: 100k; R_0603_1608Metric; LCSC C25803
R48: 47k; R_0603_1608Metric; LCSC C25819
R49, R55, R60, R139, R140: 10k; R_0603_1608Metric; LCSC C25804
R50: 330; R_0603_1608Metric; LCSC C23138
R51, R52, R53, R54, R56, R57, R58, R59: 5.1k; R_0805_2012Metric; LCSC C27834
R61, R63: 4.7k; R_0603_1608Metric; LCSC C23162
R62, R64: 1k; R_0603_1608Metric; LCSC C21190
R65, R67, R69: 22k; R_0402_1005Metric; LCSC C25768
R73, R74, R75, R76: 100k; R_0402_1005Metric; LCSC C25741
R77, R78: 1M; R_0402_1005Metric; LCSC C26083
R138: 2.2k; R_0402_1005Metric; LCSC C25879
U8: LMV321IDBVR; SOT-23-5; LCSC C7972
U9: LM2903DR; SOIC-8_3.9x4.9mm_P1.27mm; LCSC C7549

Connections:
+3V3: C47.1, D13.1 (K), D14.1 (K), D19.1 (K), D20.1 (K), D21.1 (K), D22.1 (K), D23.1 (K), D24.1 (K), D25.1 (K), D26.1 (K), D27.1 (K), D28.1 (K), D29.1 (K), D36.2 (K), D37.2 (K), R46.1, R55.1, R60.1, R79.1, U8.5 (V+); also elsewhere on the board
+5V: C50.1, D15.2 (K), D16.2 (K), D17.2 (K), D18.2 (K), U9.8 (V+); also elsewhere on the board
/Inputs/KN_BIAS: C45.1, R45.2, R46.2, R47.1, R49.2
/Inputs/KN_IN: C44.1, R138.2
/Inputs/KN_N: R48.2, R49.1, U8.3 (-)
/Inputs/KN_OUT: R48.1, R50.1, U8.4
/Inputs/KN_P: C44.2, R45.1, U8.1 (+)
/Inputs/V5_H1: D35.1 (K1), R62.1
/Inputs/V5_H2: D35.2 (K2), R64.1
/Inputs/VR1_A: R51.2, R52.1
/Inputs/VR1_B: R53.2, R54.1
/Inputs/VR1_INN: C48.2, D16.3 (COM), R54.2, R74.1, U9.6 (IN B-)
/Inputs/VR1_INP: C48.1, D15.3 (COM), R52.2, R73.1, R77.2, U9.5 (IN B+)
/Inputs/VR2_A: R56.2, R57.1
/Inputs/VR2_B: R58.2, R59.1
/Inputs/VR2_INN: C49.2, D18.3 (COM), R59.2, R76.1, U9.2 (IN A-)
/Inputs/VR2_INP: C49.1, D17.3 (COM), R57.2, R75.1, R78.2, U9.3 (IN A+)
/Inputs/VR_BIAS: C60.1, R73.2, R74.2, R75.2, R76.2, R79.2, R80.1
AN_AFR: C40.1, D23.2 (A), R37.2, R38.1; also elsewhere on the board
AN_AUX1: C41.1, D24.2 (A), R39.2, R40.1; also elsewhere on the board
AN_AUX2: C42.1, D25.2 (A), R41.2, R42.1; also elsewhere on the board
AN_AUX3: C43.1, D26.2 (A), R43.2, R44.1; also elsewhere on the board
AN_CLT: C38.1, D21.2 (A), R31.2, R32.1; also elsewhere on the board
AN_IAT: C39.1, D22.2 (A), R34.2, R35.1; also elsewhere on the board
AN_KNOCK: C46.1, R50.2; also elsewhere on the board
AN_MAP: C37.1, D20.2 (A), R29.2, R30.1; also elsewhere on the board
AN_TPS: C36.1, D19.2 (A), R27.2, R28.1; also elsewhere on the board
GND: C36.2, C37.2, C38.2, C39.2, C40.2, C41.2, C42.2, C43.2, C45.2, C46.2, C47.2, C50.2, C51.2, C52.2, C53.2, C54.2, C55.2, C60.2, D15.1 (A), D16.1 (A), D17.1 (A), D18.1 (A), D36.1 (A), D37.1 (A), R28.2, R30.2, R32.2, R35.2, R38.2, R40.2, R42.2, R44.2, R47.2, R66.2, R68.2, R70.2, R80.2, U8.2 (V-), U9.4 (GND); also elsewhere on the board
HALL1: C51.1, D13.2 (A), R61.2; also elsewhere on the board
HALL2: C52.1, D14.2 (A), R63.2; also elsewhere on the board
IN_AFR: R37.1; also elsewhere on the board
IN_AUX1: R39.1; also elsewhere on the board
IN_AUX2: R41.1; also elsewhere on the board
IN_AUX3: R43.1; also elsewhere on the board
IN_CLT: R31.1, R33.2; also elsewhere on the board
IN_HALL1: R61.1, R62.2; also elsewhere on the board
IN_HALL2: R63.1, R64.2; also elsewhere on the board
IN_IAT: R34.1, R36.2; also elsewhere on the board
IN_KNOCK: R138.1; also elsewhere on the board
IN_MAP: R29.1; also elsewhere on the board
IN_SW1: R65.1; also elsewhere on the board
IN_SW2: R67.1; also elsewhere on the board
IN_SW3: R69.1; also elsewhere on the board
IN_TPS: R27.1; also elsewhere on the board
SW1: C53.1, D27.2 (A), R65.2, R66.1; also elsewhere on the board
SW2: C54.1, D28.2 (A), R67.2, R68.1; also elsewhere on the board
SW3: C55.1, D29.2 (A), R69.2, R70.1; also elsewhere on the board
UART_RX: R140.2; also elsewhere on the board
UART_RX_M: D37.3 (COM), R140.1; also elsewhere on the board
UART_TX: R139.2; also elsewhere on the board
UART_TX_M: D36.3 (COM), R139.1; also elsewhere on the board
V5_EXT: D35.3 (A), R33.1, R36.1; also elsewhere on the board
VR1_N: R51.1; also elsewhere on the board
VR1_OUT: R55.2, R77.1, U9.7 (OUT B); also elsewhere on the board
VR1_P: R53.1; also elsewhere on the board
VR2_N: R56.1; also elsewhere on the board
VR2_OUT: R60.2, R78.1, U9.1 (OUT A); also elsewhere on the board
VR2_P: R58.1; also elsewhere on the board

Notes on the sheet:
Analog sensor inputs: 0-5 V -> 0-3.2 V for the ADC (5.6k / 10k, 10 nF)
Hall (open collector, 1k pull-up) and 12 V switch inputs
Hall pull-up supply: a crank/cam wire shorted to battery reverse-biases D35
AUX header UART (J2 24/25): 10k series, BAT54S clamps to GND / +3V3
Knock: AC-coupled, biased to 1.65 V, gain 5.7
Crank / cam VR inputs (spare): LM2903 comparator, 1M hysteresis, BAT54S clamps, biased to 1.65 V
VR input clamps, bias and hysteresis

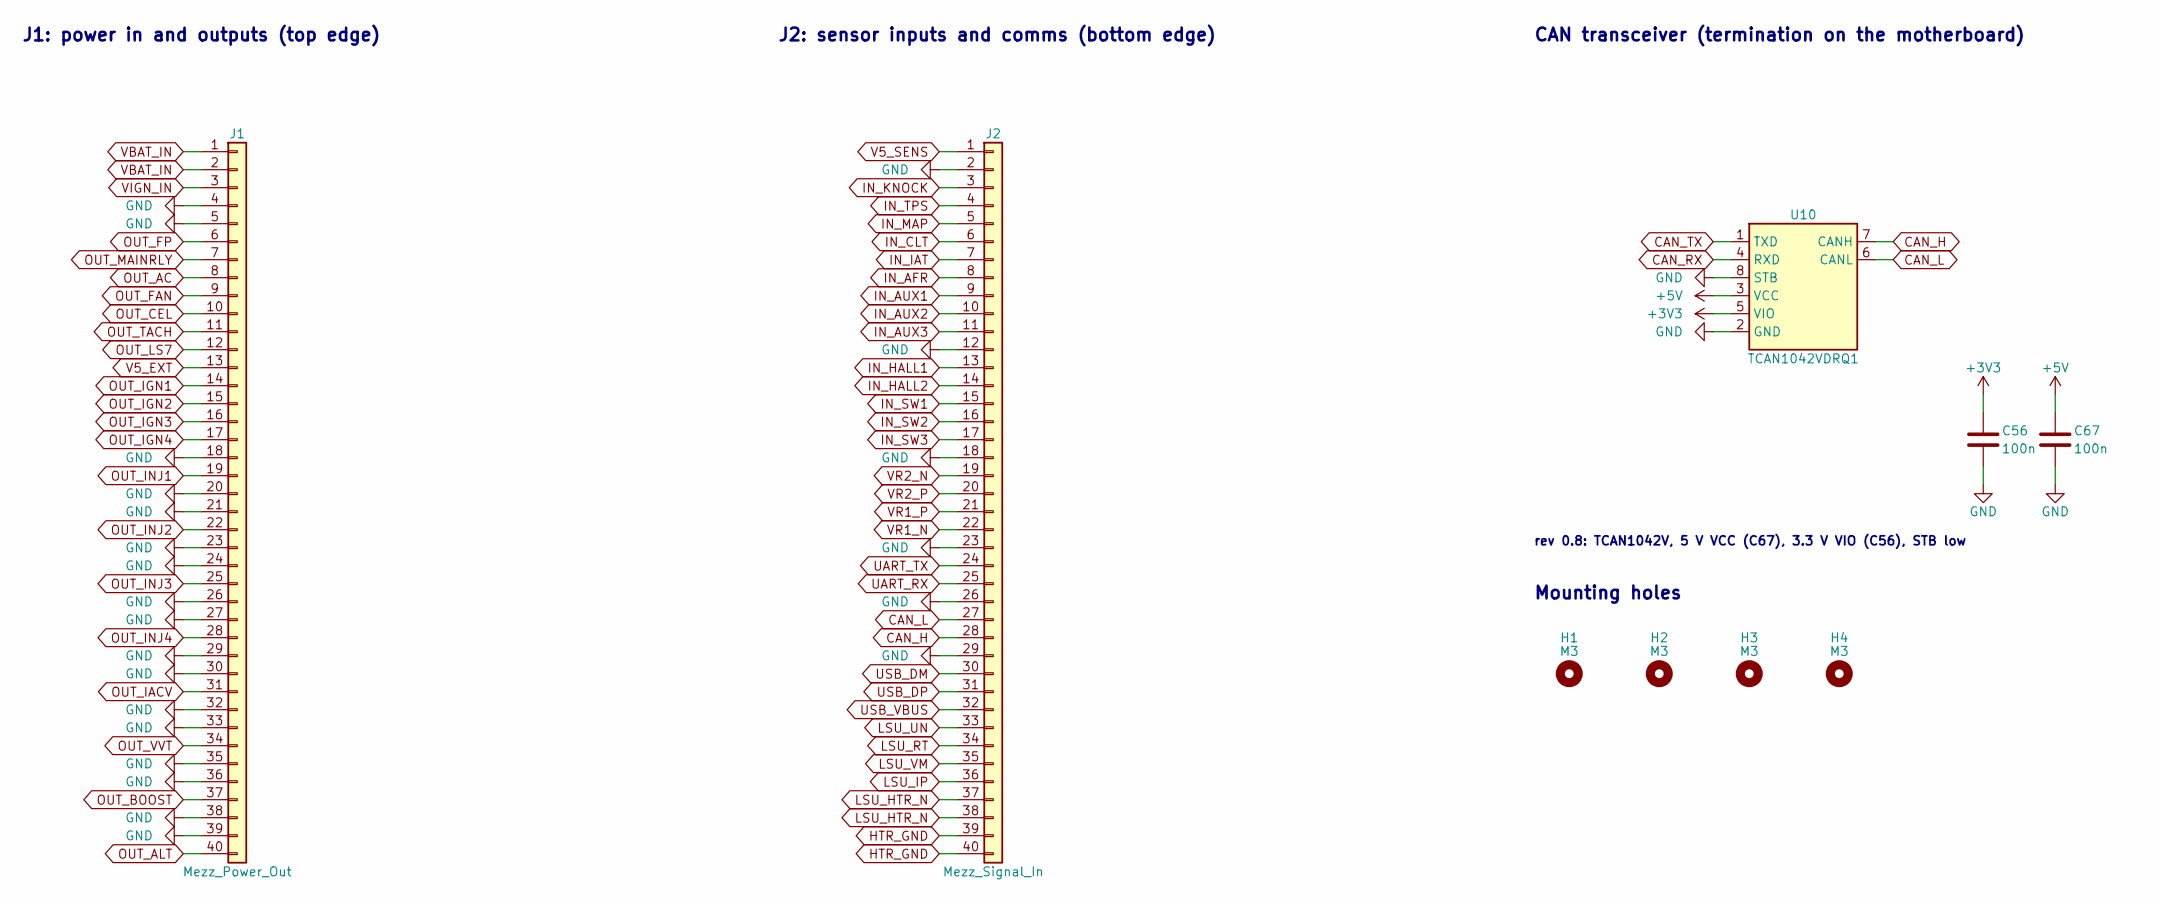
[picture p91: schematic connectors.kicad_sch, Miata ECU daughterboard - Connectors and CAN]

Parts:
C56: 100n; C_0603_1608Metric; LCSC C14663
C67: 100n; C_0402_1005Metric; LCSC C1525
H1, H2, H3, H4: M3; MountingHole_3.2mm_M3
J1: Mezz_Power_Out; PinHeader_1x40_P2.54mm_Vertical; LCSC C2977586
J2: Mezz_Signal_In; PinHeader_1x40_P2.54mm_Vertical; LCSC C2977586
U10: TCAN1042VDRQ1; SOIC-8_3.9x4.9mm_P1.27mm; LCSC C485806

Connections:
+3V3: C56.1, U10.5 (VIO); also elsewhere on the board
+5V: C67.1, U10.3 (VCC); also elsewhere on the board
CAN_H: J2.28, U10.7 (CANH); also elsewhere on the board
CAN_L: J2.27, U10.6 (CANL); also elsewhere on the board
CAN_RX: U10.4 (RXD); also elsewhere on the board
CAN_TX: U10.1 (TXD); also elsewhere on the board
GND: C56.2, C67.2, J1.4, J1.5, J1.18, J1.20, J1.21, J1.23, J1.24, J1.26, J1.27, J1.29, J1.30, J1.32, J1.33, J1.35, J1.36, J1.38, J1.39, J2.2, J2.12, J2.18, J2.23, J2.26, J2.29, U10.2 (GND), U10.8 (STB); also elsewhere on the board
HTR_GND: J2.39, J2.40; also elsewhere on the board
IN_AFR: J2.8; also elsewhere on the board
IN_AUX1: J2.9; also elsewhere on the board
IN_AUX2: J2.10; also elsewhere on the board
IN_AUX3: J2.11; also elsewhere on the board
IN_CLT: J2.6; also elsewhere on the board
IN_HALL1: J2.13; also elsewhere on the board
IN_HALL2: J2.14; also elsewhere on the board
IN_IAT: J2.7; also elsewhere on the board
IN_KNOCK: J2.3; also elsewhere on the board
IN_MAP: J2.5; also elsewhere on the board
IN_SW1: J2.15; also elsewhere on the board
IN_SW2: J2.16; also elsewhere on the board
IN_SW3: J2.17; also elsewhere on the board
IN_TPS: J2.4; also elsewhere on the board
LSU_HTR_N: J2.37, J2.38; also elsewhere on the board
LSU_IP: J2.36; also elsewhere on the board
LSU_RT: J2.34; also elsewhere on the board
LSU_UN: J2.33; also elsewhere on the board
LSU_VM: J2.35; also elsewhere on the board
OUT_AC: J1.8; also elsewhere on the board
OUT_ALT: J1.40; also elsewhere on the board
OUT_BOOST: J1.37; also elsewhere on the board
OUT_CEL: J1.10; also elsewhere on the board
OUT_FAN: J1.9; also elsewhere on the board
OUT_FP: J1.6; also elsewhere on the board
OUT_IACV: J1.31; also elsewhere on the board
OUT_IGN1: J1.14; also elsewhere on the board
OUT_IGN2: J1.15; also elsewhere on the board
OUT_IGN3: J1.16; also elsewhere on the board
OUT_IGN4: J1.17; also elsewhere on the board
OUT_INJ1: J1.19; also elsewhere on the board
OUT_INJ2: J1.22; also elsewhere on the board
OUT_INJ3: J1.25; also elsewhere on the board
OUT_INJ4: J1.28; also elsewhere on the board
OUT_LS7: J1.12; also elsewhere on the board
OUT_MAINRLY: J1.7; also elsewhere on the board
OUT_TACH: J1.11; also elsewhere on the board
OUT_VVT: J1.34; also elsewhere on the board
UART_RX: J2.25; also elsewhere on the board
UART_TX: J2.24; also elsewhere on the board
USB_DM: J2.30; also elsewhere on the board
USB_DP: J2.31; also elsewhere on the board
USB_VBUS: J2.32; also elsewhere on the board
V5_EXT: J1.13; also elsewhere on the board
V5_SENS: J2.1; also elsewhere on the board
VBAT_IN: J1.1, J1.2; also elsewhere on the board
VIGN_IN: J1.3; also elsewhere on the board
VR1_N: J2.22; also elsewhere on the board
VR1_P: J2.21; also elsewhere on the board
VR2_N: J2.19; also elsewhere on the board
VR2_P: J2.20; also elsewhere on the board

Notes on the sheet:
J1: power in and outputs (top edge)
J2: sensor inputs and comms (bottom edge)
CAN transceiver (termination on the motherboard)
rev 0.8: TCAN1042V, 5 V VCC (C67), 3.3 V VIO (C56), STB low
Mounting holes
