v3ai/miata-ecus/daughterboard/miata_ecu_daughter.kicad_pcb

## KiCad design daughterboard/miata_ecu_daughter.kicad_pcb (continued)

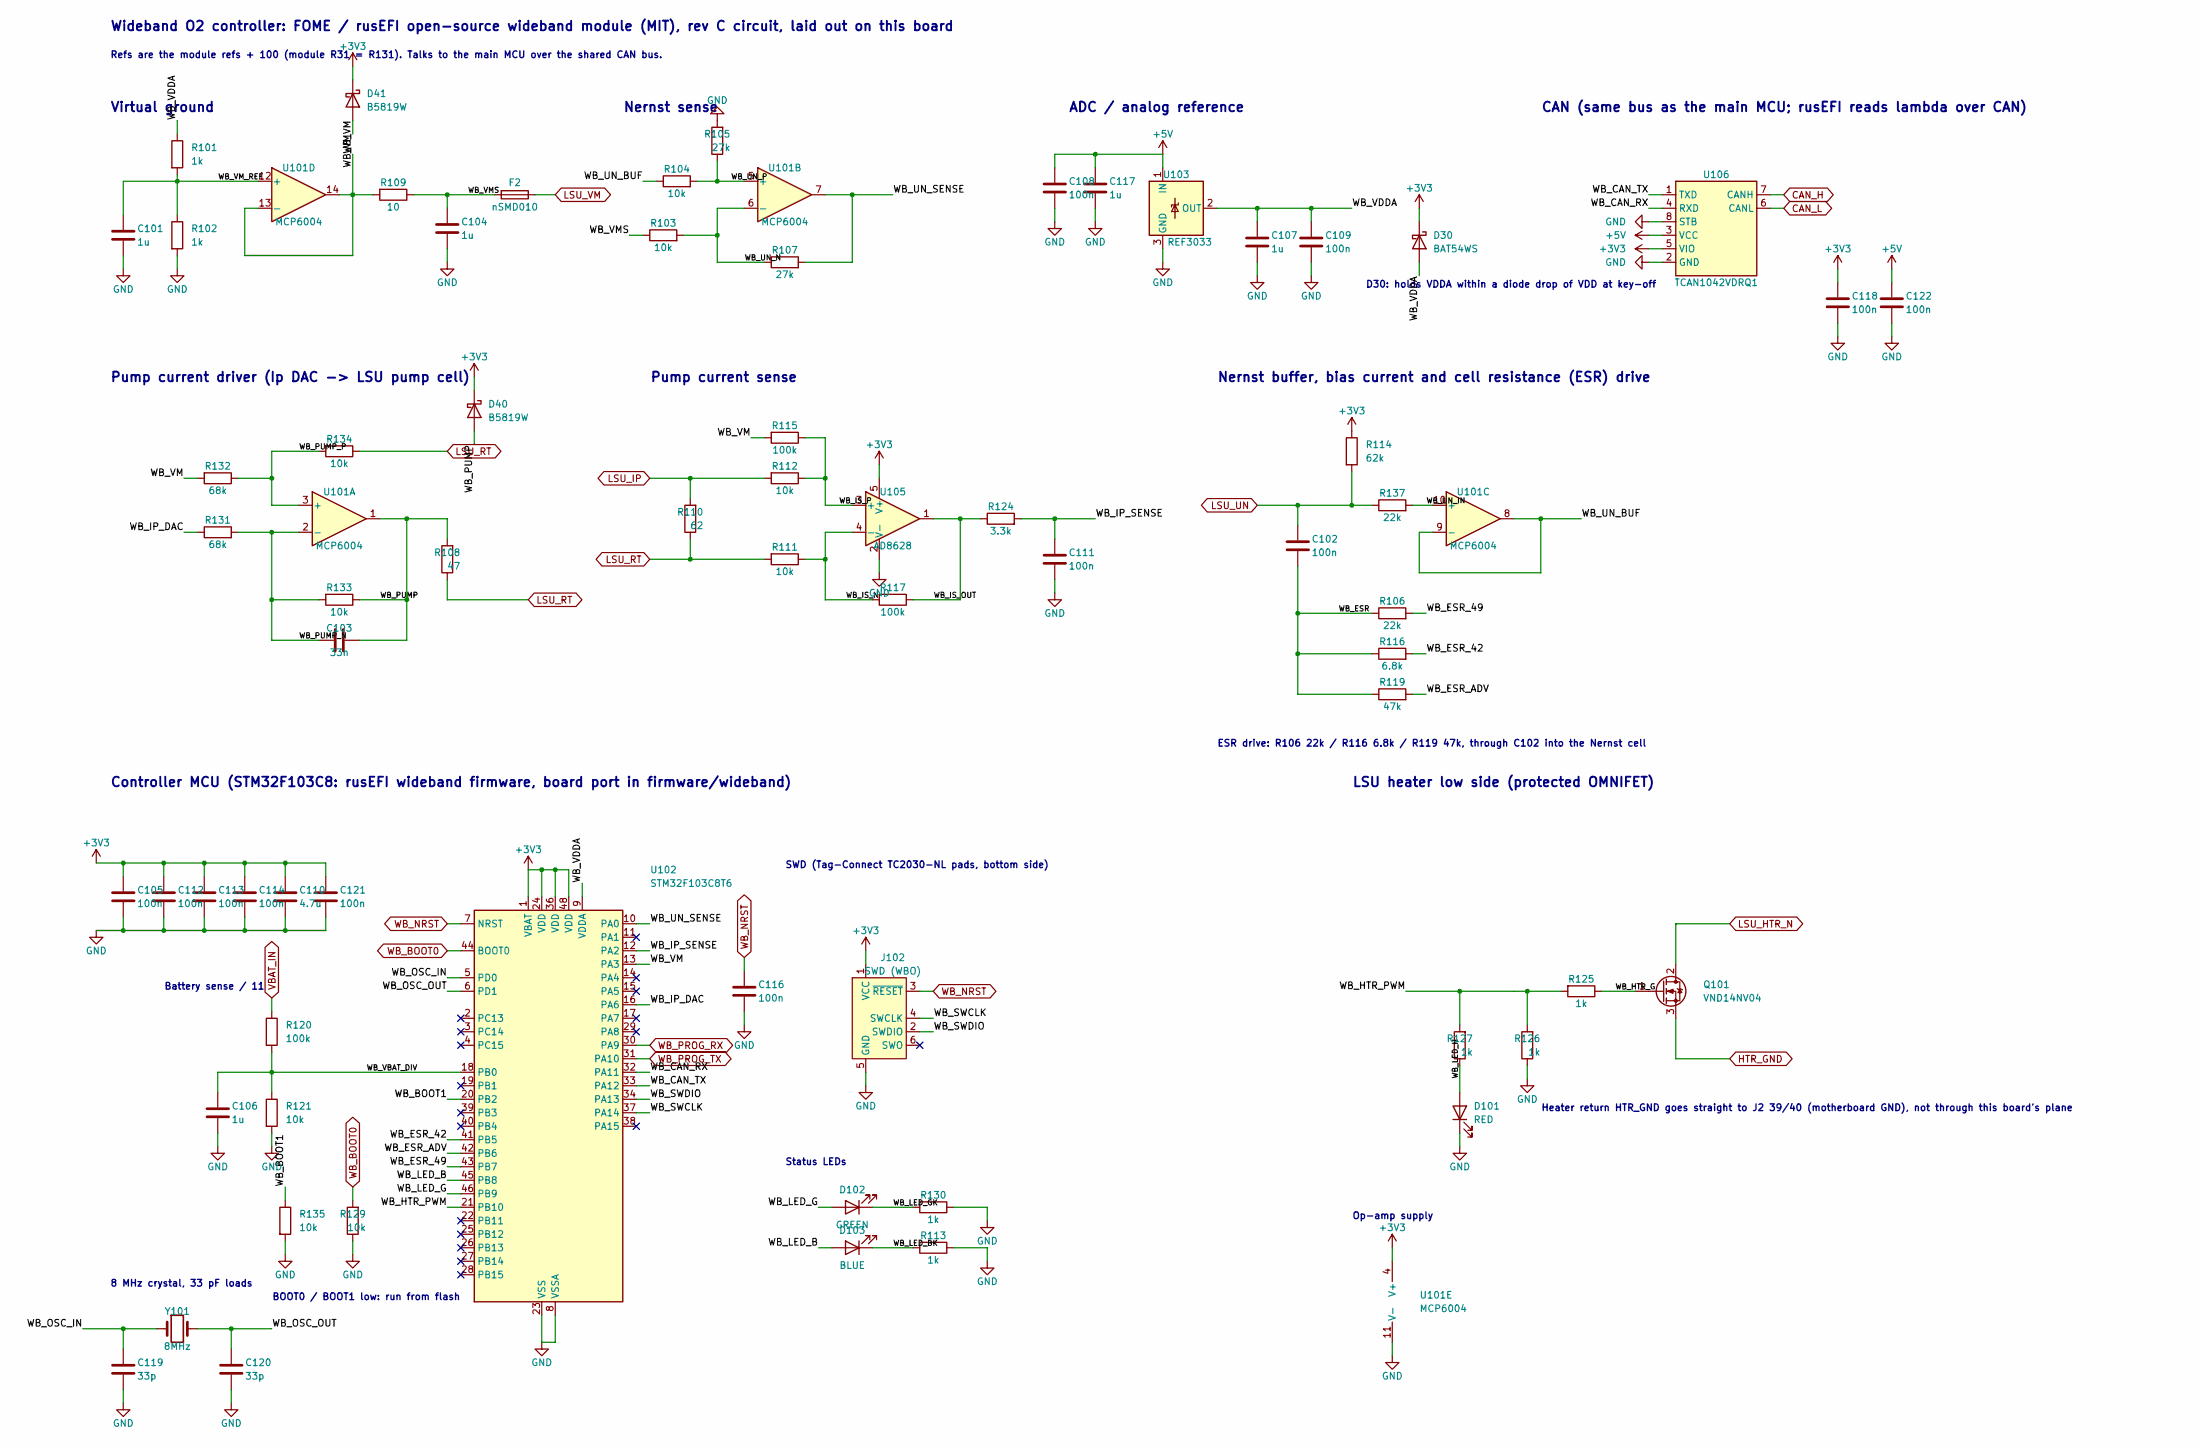
[picture p92: schematic wideband.kicad_sch, Miata ECU daughterboard - Wideband controller]

Parts:
C101, C104, C106, C107, C117: 1u; C_0402_1005Metric; LCSC C52923
C102, C105, C108, C109, C111, C112, C113, C114, C116, C118, C121, C122: 100n; C_0402_1005Metric; LCSC C1525
C103: 33n; C_0402_1005Metric; LCSC C106862
C110: 4.7u; C_0603_1608Metric; LCSC C19666
C119, C120: 33p; C_0402_1005Metric; LCSC C1562
D30: BAT54WS; D_SOD-323; LCSC C124205
D40, D41: B5819W; D_SOD-123; LCSC C8598
D101: RED; LED_0603_1608Metric; LCSC C2286
D102: GREEN; LED_0603_1608Metric; LCSC C12624
D103: BLUE; LED_0603_1608Metric; LCSC C2288
F2: nSMD010; Fuse_1206_3216Metric; LCSC C70065
J102: SWD (WBO); Tag-Connect_TC2030-IDC-NL_2x03_P1.27mm_Vertical
Q101: VND14NV04; TO-252-2; LCSC C2649436
R101, R102, R113, R125, R126, R127, R130: 1k; R_0402_1005Metric; LCSC C11702
R103, R104, R111, R112, R121, R129, R133, R134, R135: 10k; R_0402_1005Metric; LCSC C25744
R105, R107: 27k; R_0402_1005Metric; LCSC C25771
R106, R137: 22k; R_0402_1005Metric; LCSC C25768
R108: 47; R_1206_3216Metric; LCSC C17969
R109: 10; R_1206_3216Metric; LCSC C17903
R110: 62; R_1206_3216Metric; LCSC C25341
R114: 62k; R_0603_1608Metric; LCSC C23221
R115, R117, R120: 100k; R_0402_1005Metric; LCSC C25741
R116: 6.8k; R_0402_1005Metric; LCSC C25917
R119: 47k; R_0402_1005Metric; LCSC C25792
R124: 3.3k; R_0402_1005Metric; LCSC C25890
R131, R132: 68k; R_0402_1005Metric; LCSC C36871
U101: MCP6004; TSSOP-14_4.4x5mm_P0.65mm; LCSC C50282
U102: STM32F103C8T6; LQFP-48_7x7mm_P0.5mm; LCSC C8734
U103: REF3033; SOT-23; LCSC C36658
U105: AD8628; SOT-23-5; LCSC C29309
U106: TCAN1042VDRQ1; SOIC-8_3.9x4.9mm_P1.27mm; LCSC C485806
Y101: 8MHz; Crystal_SMD_5032-2Pin_5.0x3.2mm; LCSC C115962

Connections:
+3V3: C105.1, C110.1, C112.1, C113.1, C114.1, C118.1, C121.1, D30.1 (K), D40.1 (K), D41.1 (K), J102.1 (VCC), R114.1, U101.4 (V+), U102.1 (VBAT), U102.24 (VDD), U102.36 (VDD), U102.48 (VDD), U105.5 (V+), U106.5 (VIO); also elsewhere on the board
+5V: C108.1, C117.1, C122.1, U103.1 (IN), U106.3 (VCC); also elsewhere on the board
/Wideband controller/WB_BOOT1: R135.1, U102.20 (PB2)
/Wideband controller/WB_CAN_RX: U102.32 (PA11), U106.4 (RXD)
/Wideband controller/WB_CAN_TX: U102.33 (PA12), U106.1 (TXD)
/Wideband controller/WB_ESR: C102.2, R106.1, R116.1, R119.1
/Wideband controller/WB_ESR_42: R116.2, U102.41 (PB5)
/Wideband controller/WB_ESR_49: R106.2, U102.43 (PB7)
/Wideband controller/WB_ESR_ADV: R119.2, U102.42 (PB6)
/Wideband controller/WB_HTR_G: Q101.1 (G), R125.1
/Wideband controller/WB_HTR_PWM: R125.2, R126.2, R127.2, U102.21 (PB10)
/Wideband controller/WB_IP_DAC: R131.1, U102.16 (PA6)
/Wideband controller/WB_IP_SENSE: C111.1, R124.2, U102.12 (PA2)
/Wideband controller/WB_IS_N: R111.1, R117.2, U105.4 (-)
/Wideband controller/WB_IS_OUT: R117.1, R124.1, U105.1
/Wideband controller/WB_IS_P: R112.1, R115.1, U105.3 (+)
/Wideband controller/WB_LED_B: D103.2 (A), U102.45 (PB8)
/Wideband controller/WB_LED_BK: D103.1 (K), R113.2
/Wideband controller/WB_LED_G: D102.2 (A), U102.46 (PB9)
/Wideband controller/WB_LED_GK: D102.1 (K), R130.2
/Wideband controller/WB_LED_H: D101.2 (A), R127.1
/Wideband controller/WB_OSC_IN: C119.1, U102.5 (PD0), Y101.1
/Wideband controller/WB_OSC_OUT: C120.1, U102.6 (PD1), Y101.2
/Wideband controller/WB_PUMP: C103.1, D40.2 (A), R108.2, R133.1, U101.1
/Wideband controller/WB_PUMP_N: C103.2, R131.2, R133.2, U101.2 (-)
/Wideband controller/WB_PUMP_P: R132.1, R134.2, U101.3 (+)
/Wideband controller/WB_SWCLK: J102.4 (SWCLK), U102.37 (PA14)
/Wideband controller/WB_SWDIO: J102.2 (SWDIO), U102.34 (PA13)
/Wideband controller/WB_UN_BUF: R104.1, U101.8, U101.9 (-)
/Wideband controller/WB_UN_IN: R137.2, U101.10 (+)
/Wideband controller/WB_UN_N: R103.2, R107.1, U101.6 (-)
/Wideband controller/WB_UN_P: R104.2, R105.1, U101.5 (+)
/Wideband controller/WB_UN_SENSE: R107.2, U101.7, U102.10 (PA0)
/Wideband controller/WB_VBAT_DIV: C106.1, R120.2, R121.1, U102.18 (PB0)
/Wideband controller/WB_VDDA: C107.1, C109.1, D30.2 (A), R101.1, U102.9 (VDDA), U103.2 (OUT)
/Wideband controller/WB_VM: D41.2 (A), R109.2, R115.2, R132.2, U101.13 (-), U101.14, U102.13 (PA3)
/Wideband controller/WB_VMS: C104.1, F2.2, R103.1, R109.1
/Wideband controller/WB_VM_REF: C101.1, R101.2, R102.1, U101.12 (+)
CAN_H: U106.7 (CANH); also elsewhere on the board
CAN_L: U106.6 (CANL); also elsewhere on the board
GND: C101.2, C104.2, C105.2, C106.2, C107.2, C108.2, C109.2, C110.2, C111.2, C112.2, C113.2, C114.2, C116.2, C117.2, C118.2, C119.2, C120.2, C121.2, C122.2, D101.1 (K), J102.5 (GND), R102.2, R105.2, R113.1, R121.2, R126.1, R129.1, R130.1, R135.2, U101.11 (V-), U102.8 (VSSA), U102.23 (VSS), U102.35 (VSS), U102.47 (VSS), U103.3 (GND), U105.2 (V-), U106.2 (GND), U106.8 (STB); also elsewhere on the board
HTR_GND: Q101.3 (S); also elsewhere on the board
LSU_HTR_N: Q101.2 (D); also elsewhere on the board
LSU_IP: R110.2, R112.2; also elsewhere on the board
LSU_RT: R108.1, R110.1, R111.2, R134.1; also elsewhere on the board
LSU_UN: C102.1, R114.2, R137.1; also elsewhere on the board
LSU_VM: F2.1; also elsewhere on the board
VBAT_IN: R120.1; also elsewhere on the board
WB_BOOT0: R129.2, U102.44 (BOOT0); also elsewhere on the board
WB_NRST: C116.1, J102.3 (~RESET), U102.7 (NRST); also elsewhere on the board
WB_PROG_RX: U102.30 (PA9); also elsewhere on the board
WB_PROG_TX: U102.31 (PA10); also elsewhere on the board

Notes on the sheet:
Wideband O2 controller: FOME / rusEFI open-source wideband module (MIT), rev C circuit, laid out on this board
Refs are the module refs + 100 (module R31 = R131). Talks to the main MCU over the shared CAN bus.
Virtual ground
Nernst sense
ADC / analog reference
D30: holds VDDA within a diode drop of VDD at key-off
CAN (same bus as the main MCU; rusEFI reads lambda over CAN)
Pump current driver (Ip DAC -> LSU pump cell)
Pump current sense
Nernst buffer, bias current and cell resistance (ESR) drive
ESR drive: R106 22k / R116 6.8k / R119 47k, through C102 into the Nernst cell
Controller MCU (STM32F103C8: rusEFI wideband firmware, board port in firmware/wideband)
BOOT0 / BOOT1 low: run from flash
Battery sense / 11
8 MHz crystal, 33 pF loads
Status LEDs
SWD (Tag-Connect TC2030-NL pads, bottom side)
LSU heater low side (protected OMNIFET)
Heater return HTR_GND goes straight to J2 39/40 (motherboard GND), not through this board's plane
Op-amp supply

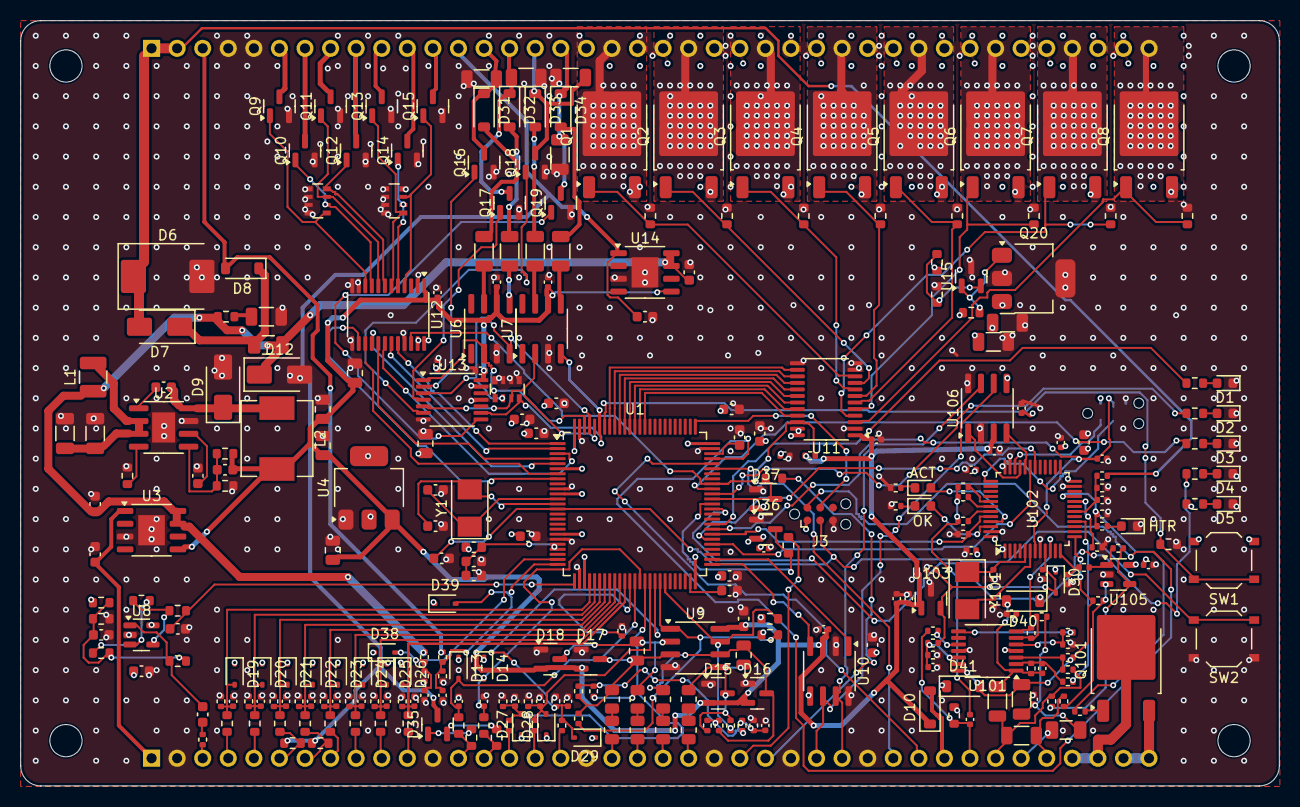
[picture p93: board miata_ecu_daughter.kicad_pcb from above]

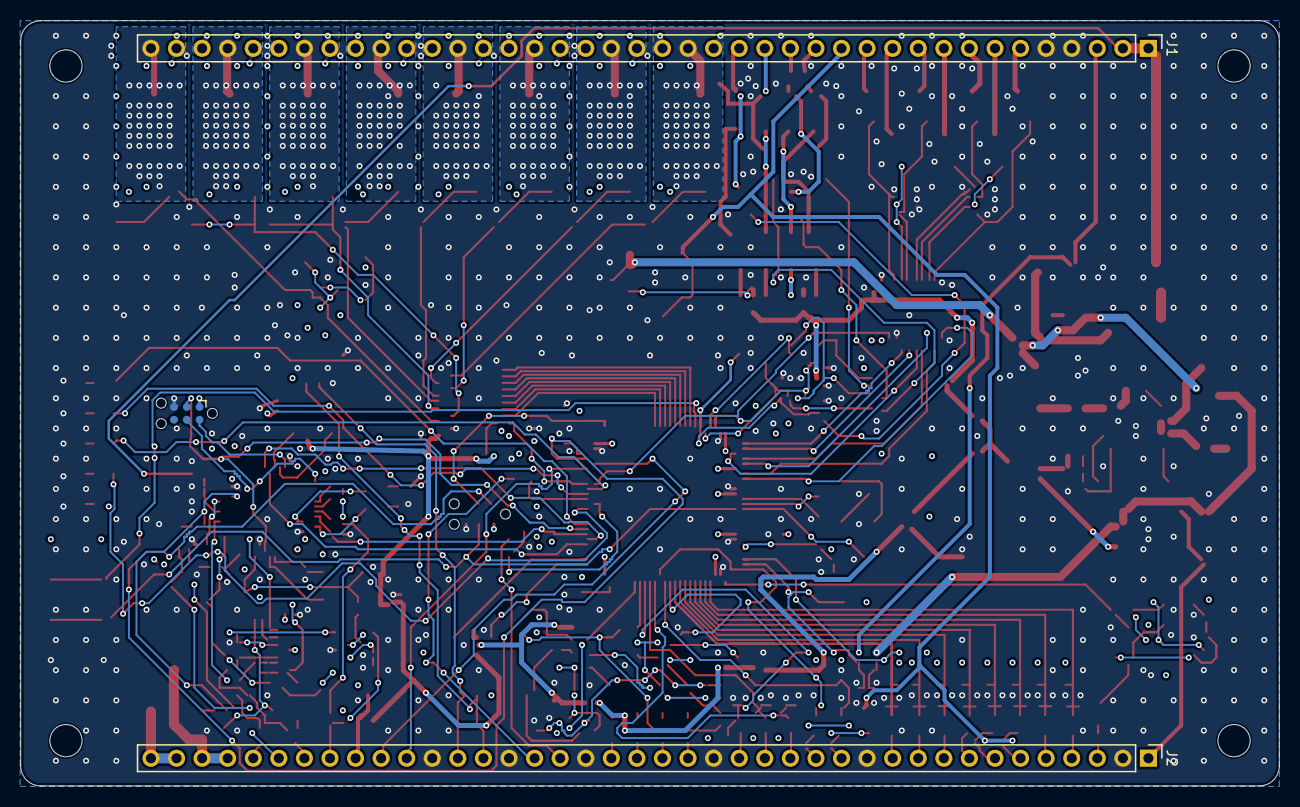
[picture p94: board miata_ecu_daughter.kicad_pcb from below]

Board: 4 copper layers, 125.0 x 76.0 mm, 310 parts (3 on the bottom side), 212 nets.
