v3ai/miata-ecus/ordered-boards/2026-11/daughterboard/mcu.kicad_sch

## KiCad design ordered-boards/2026-11/daughterboard/mcu.kicad_sch (2026-11-13)


Parts:
C1, C2, C3, C5, C6, C12, C15: 100n; C_0603_1608Metric; LCSC C14663
C4: 100n; C_0402_1005Metric; LCSC C1525
C7, C8: 4.7u; C_0603_1608Metric; LCSC C19666
C9, C10: 2.2u; C_0603_1608Metric; LCSC C23630
C11: 1u; C_0603_1608Metric; LCSC C15849
C13, C14: 33p; C_0603_1608Metric; LCSC C1663
D1, D5: GREEN; LED_0603_1608Metric; LCSC C12624
D2: BLUE; LED_0603_1608Metric; LCSC C2288
D3: YELLOW; LED_0603_1608Metric; LCSC C2287
D4: RED; LED_0603_1608Metric; LCSC C2286
FB1: BLM18PG221; L_0603_1608Metric; LCSC C80165
J3: SWD; Tag-Connect_TC2030-IDC-NL_2x03_P1.27mm_Vertical
R1: 10k; R_0603_1608Metric; LCSC C25804
R2, R3, R4, R5, R6: 1k; R_0603_1608Metric; LCSC C21190
R72: 10k; R_0402_1005Metric; LCSC C25744
SW1: BOOT; SW_Push_1P1T_XKB_TS-1187A; LCSC C318884
SW2: RESET; SW_Push_1P1T_XKB_TS-1187A; LCSC C318884
U1: STM32F407VGT6; LQFP-100_14x14mm_P0.5mm; LCSC C12345
Y1: 8MHz; Crystal_SMD_5032-2Pin_5.0x3.2mm; LCSC C115962

Connections:
+3V3: C1.1, C2.1, C3.1, C4.1, C5.1, C6.1, C7.1, C8.1, FB1.1, J3.1 (VCC), R6.1, SW1.1, U1.6 (VBAT), U1.11 (VDD), U1.19 (VDD), U1.28 (VDD), U1.50 (VDD), U1.75 (VDD), U1.100 (VDD)
+3V3A: C11.1, C12.1, FB1.2, U1.21 (VREF+), U1.22 (VDDA)
AC_CTL: U1.5 (PE6)
ALT_CTL: U1.86 (PD5)
AN_AFR: U1.33 (PC4)
AN_AUX1: U1.34 (PC5)
AN_AUX2: U1.35 (PB0)
AN_AUX3: U1.36 (PB1)
AN_CLT: U1.31 (PA6)
AN_IAT: U1.32 (PA7)
AN_KNOCK: U1.26 (PA3)
AN_MAP: U1.30 (PA5)
AN_TPS: U1.29 (PA4)
AN_VBATT: U1.24 (PA1)
AN_VIGN: U1.25 (PA2)
BOOST_CTL: U1.87 (PD6)
BOOT0: R1.1, SW1.2, U1.94 (BOOT0)
BOOT1: R72.1, U1.37 (PB2)
CAN_RX: U1.51 (PB12)
CAN_TX: U1.52 (PB13)
CEL_CTL: U1.3 (PE4)
DRV_EN_N: U1.67 (PA8)
FAN_CTL: U1.4 (PE5)
FP_CTL: U1.8 (PC14)
GND: C1.2, C2.2, C3.2, C4.2, C5.2, C6.2, C7.2, C8.2, C9.2, C10.2, C11.2, C12.2, C13.2, C14.2, C15.2, D1.1 (K), D2.1 (K), D3.1 (K), D4.1 (K), D5.1 (K), J3.5 (GND), R1.2, R72.2, SW2.2, U1.10 (VSS), U1.20 (VSSA), U1.27 (VSS), U1.74 (VSS), U1.99 (VSS)
HALL1: U1.38 (PE7)
HALL2: U1.39 (PE8)
HSE_IN: C13.1, U1.12 (PH0), Y1.1
HSE_OUT: C14.1, U1.13 (PH1), Y1.2
IACV_CTL: U1.89 (PB3)
IGN1_CTL: U1.98 (PE1)
IGN2_CTL: U1.97 (PE0)
IGN3_CTL: U1.96 (PB9)
IGN4_CTL: U1.95 (PB8)
INJ1_CTL: U1.93 (PB7)
INJ2_CTL: U1.92 (PB6)
INJ3_CTL: U1.91 (PB5)
INJ4_CTL: U1.90 (PB4)
LED_COMM: R3.1, U1.65 (PC8)
LED_COMM_A: D2.2 (A), R3.2
LED_ERR: R5.1, U1.62 (PD15)
LED_ERR_A: D4.2 (A), R5.2
LED_RUN: R2.1, U1.59 (PD12)
LED_RUN_A: D1.2 (A), R2.2
LED_WARN: R4.1, U1.66 (PC9)
LED_WARN_A: D3.2 (A), R4.2
LS7_CTL: U1.1 (PE2)
MAINRLY_CTL: U1.7 (PC13)
NRST: C15.1, J3.3 (~RESET), SW2.1, U1.14 (NRST)
PWR_LED_A: D5.2 (A), R6.2
SW1: U1.40 (PE9)
SW2: U1.41 (PE10)
SW3: U1.42 (PE11)
SWCLK: J3.4 (SWCLK), U1.76 (PA14)
SWDIO: J3.2 (SWDIO), U1.72 (PA13)
TACH_CTL: U1.2 (PE3)
UART_RX_M: U1.64 (PC7)
UART_TX_M: U1.63 (PC6)
USB_DM: U1.70 (PA11)
USB_DP: U1.71 (PA12)
VCAP1: C9.1, U1.49 (VCAP_1)
VCAP2: C10.1, U1.73 (VCAP_2)
VR1_OUT: U1.44 (PE13)
VR2_OUT: U1.43 (PE12)
VVT_CTL: U1.88 (PD7)
WB_BOOT0: U1.57 (PD10)
WB_NRST: U1.58 (PD11)
WB_PROG_RX: U1.56 (PD9)
WB_PROG_TX: U1.55 (PD8)

Notes on the sheet:
Decoupling: one 100 nF per VDD pin, 2 x 4.7 uF bulk
Core regulator caps
Analog supply filter
8 MHz HSE crystal
BOOT0 (hold for DFU) and reset
BOOT1 (PB2) low: DFU needs BOOT0 = 1, BOOT1 = 0
SWD (Tag-Connect TC2030-NL pads)
Status LEDs
