v3ai/miata-ecus/ordered-boards/2026-11/daughterboard/outputs.kicad_sch

## KiCad design ordered-boards/2026-11/daughterboard/outputs.kicad_sch (2026-11-13)



Parts:
C34, C35: 1u; C_0402_1005Metric; LCSC C52923
C57, C58, C64, C65, C66: 100n; C_0402_1005Metric; LCSC C1525
D31, D32, D33, D34: B5819W; D_SOD-123; LCSC C8598
Q1, Q2, Q3, Q4, Q5, Q6, Q7, Q8: VND7NV04TR-E; TO-252-2; LCSC C155605
Q9, Q10, Q11, Q12, Q13, Q14, Q15, Q16, Q17, Q18, Q19: ZXMS6004FFTA; SOT-23; LCSC C95063
R15, R16, R17, R18: 100; R_1206_3216Metric; LCSC C17901
R19, R20, R21, R22, R23, R24, R25, R26: 10k; R_0603_1608Metric; LCSC C25804
R71: 10k; R_0402_1005Metric; LCSC C25744
R144, R145, R146, R147: 3.3k; R_1206_3216Metric; LCSC C26032
RN1, RN2, RN3: 4x10k; R_Array_Convex_4x0603; LCSC C29718
U6, U7: TC4427; SOIC-8_3.9x4.9mm_P1.27mm; LCSC C20551
U11, U12: SN74LVC4245APWR; TSSOP-24_4.4x7.8mm_P0.65mm; LCSC C7859
U13: 74HCT04PW; TSSOP-14_4.4x5mm_P0.65mm; LCSC C131317

Connections:
+3V3: C58.1, C65.1, U11.23 (VCCB), U11.24 (VCCB), U12.23 (VCCB), U12.24 (VCCB)
+5V: C34.1, C35.1, C57.1, C64.1, C66.1, R71.1, U6.6 (VDD), U7.6 (VDD), U11.1 (VCCA), U12.1 (VCCA), U13.14 (VCC)
AC_CTL: U12.16 (B6)
AC_G: Q11.1 (IN), RN2.3 (R3.1), U12.8 (A6)
ALT_CTL: U11.21 (B1)
ALT_IN: Q8.1 (IN), R26.1, U11.3 (A1)
BOOST_CTL: U11.20 (B2)
BOOST_IN: Q7.1 (IN), R25.1, U11.4 (A2)
CEL_CTL: U12.18 (B4)
CEL_G: Q13.1 (IN), RN3.1 (R1.1), U12.6 (A4)
DRV_EN_N: R71.2, U11.22 (~OE), U12.22 (~OE)
FAN_CTL: U12.17 (B5)
FAN_G: Q12.1 (IN), RN2.4 (R4.1), U12.7 (A5)
FP_CTL: U12.14 (B8)
FP_G: Q9.1 (IN), RN2.1 (R1.1), U12.10 (A8)
GND: C34.2, C35.2, C57.2, C58.2, C64.2, C65.2, C66.2, Q1.3 (S), Q2.3 (S), Q3.3 (S), Q4.3 (S), Q5.3 (S), Q6.3 (S), Q7.3 (S), Q8.3 (S), Q9.2 (S), Q10.2 (S), Q11.2 (S), Q12.2 (S), Q13.2 (S), Q14.2 (S), Q15.2 (S), Q16.2 (S), Q17.2 (S), Q18.2 (S), Q19.2 (S), R19.2, R20.2, R21.2, R22.2, R23.2, R24.2, R25.2, R26.2, R144.2, R145.2, R146.2, R147.2, RN1.5 (R4.2), RN1.6 (R3.2), RN1.7 (R2.2), RN1.8 (R1.2), RN2.5 (R4.2), RN2.6 (R3.2), RN2.7 (R2.2), RN2.8 (R1.2), RN3.4 (R4.1), RN3.5 (R4.2), RN3.6 (R3.2), RN3.7 (R2.2), RN3.8 (R1.2), U6.3 (GND), U7.3 (GND), U11.2 (DIR), U11.11 (GND), U11.12 (GND), U11.13 (GND), U12.2 (DIR), U12.11 (GND), U12.12 (GND), U12.13 (GND), U12.21 (B1), U13.7 (GND), U13.11 (5A), U13.13 (6A)
IACV_CTL: U11.18 (B4)
IACV_IN: Q5.1 (IN), R23.1, U11.6 (A4)
IGN1_CTL: RN1.1 (R1.1), U6.2 (IN_A), U13.1 (1A)
IGN1_DRV: R15.1, U6.7 (OUT_A)
IGN1_SNK: Q16.1 (IN), U13.2 (1Y)
IGN1_SRC: D31.2 (A), R15.2
IGN2_CTL: RN1.2 (R2.1), U6.4 (IN_B), U13.3 (2A)
IGN2_DRV: R16.1, U6.5 (OUT_B)
IGN2_SNK: Q17.1 (IN), U13.4 (2Y)
IGN2_SRC: D32.2 (A), R16.2
IGN3_CTL: RN1.3 (R3.1), U7.2 (IN_A), U13.5 (3A)
IGN3_DRV: R17.1, U7.7 (OUT_A)
IGN3_SNK: Q18.1 (IN), U13.6 (3Y)
IGN3_SRC: D33.2 (A), R17.2
IGN4_CTL: RN1.4 (R4.1), U7.4 (IN_B), U13.9 (4A)
IGN4_DRV: R18.1, U7.5 (OUT_B)
IGN4_SNK: Q19.1 (IN), U13.8 (4Y)
IGN4_SRC: D34.2 (A), R18.2
INJ1_CTL: U11.14 (B8)
INJ1_IN: Q1.1 (IN), R19.1, U11.10 (A8)
INJ2_CTL: U11.15 (B7)
INJ2_IN: Q2.1 (IN), R20.1, U11.9 (A7)
INJ3_CTL: U11.16 (B6)
INJ3_IN: Q3.1 (IN), R21.1, U11.8 (A6)
INJ4_CTL: U11.17 (B5)
INJ4_IN: Q4.1 (IN), R22.1, U11.7 (A5)
LS7_CTL: U12.20 (B2)
LS7_G: Q15.1 (IN), RN3.3 (R3.1), U12.4 (A2)
MAINRLY_CTL: U12.15 (B7)
MAINRLY_G: Q10.1 (IN), RN2.2 (R2.1), U12.9 (A7)
OUT_AC: Q11.3 (D)
OUT_ALT: Q8.2 (D)
OUT_BOOST: Q7.2 (D)
OUT_CEL: Q13.3 (D)
OUT_FAN: Q12.3 (D)
OUT_FP: Q9.3 (D)
OUT_IACV: Q5.2 (D)
OUT_IGN1: D31.1 (K), Q16.3 (D), R144.1
OUT_IGN2: D32.1 (K), Q17.3 (D), R145.1
OUT_IGN3: D33.1 (K), Q18.3 (D), R146.1
OUT_IGN4: D34.1 (K), Q19.3 (D), R147.1
OUT_INJ1: Q1.2 (D)
OUT_INJ2: Q2.2 (D)
OUT_INJ3: Q3.2 (D)
OUT_INJ4: Q4.2 (D)
OUT_LS7: Q15.3 (D)
OUT_MAINRLY: Q10.3 (D)
OUT_TACH: Q14.3 (D)
OUT_VVT: Q6.2 (D)
TACH_CTL: U12.19 (B3)
TACH_G: Q14.1 (IN), RN3.2 (R2.1), U12.5 (A3)
VVT_CTL: U11.19 (B3)
VVT_IN: Q6.1 (IN), R24.1, U11.5 (A3)

Notes on the sheet:
Protected low-side drivers (VND7NV04, DPAK): injectors, IACV, VVT, boost, alternator
Ignition logic outputs: TC4427 sources through 100 R + Schottky; ZXMS6004 pulls low (gate = inverted control)
Ignition inputs pulled low (coils stay off while the MCU boots)
Relay, lamp and tach outputs: ZXMS6004 protected low sides, 5 V gates from U12 (enabled with the drivers)
3.3 V -> 5 V level shifter for the low-side inputs (DIR low: B -> A)
~OE pulled up: all eight drivers off until the firmware drives DRV_EN_N low
