v3ai/miata-ecus/ordered-boards/2026-11/firmware/board/miata_nb_tune.cpp

/**
 * @file board/miata_nb_tune.cpp
 * @brief Base tune for the 1999-2005 (NB) year presets: rusEFI's own NB tables.
 *
 * rusEFI compiles its NB presets (config/engines/mazda/mazda_miata_vvt.cpp) for its Hellen boards only, so on this
 * board the NB years used to start from rusEFI's generic VE and ignition tables. The tables below are copied
 * unchanged from that file at the pinned rusEFI commit (1374bd07): the VE and ignition tables and the VVT target
 * table are exports of rusEFI's own NB2 tune ("Generated by TS2C", 2017), and the injector lag values go with that
 * VE table. Above about 100 kPa the VE table is a flat 80 %: nobody has tuned it under boost.
 *
 * Licence: unlike the rest of this folder (MIT), THIS FILE IS GPL-3.0, because the tables are rusEFI's:
 *   rusEFI, (c) 2012-2020 Andrey Belomutskiy and contributors, GNU General Public License v3,
 *   https://github.com/rusefi/rusefi/blob/master/firmware/config/engines/mazda/mazda_miata_vvt.cpp
 *
 * It is a starting point, not a finished tune: check base timing with a light and watch the wideband on the first
 * drives (firmware/README.md, "Base tune").
 */
#include "pch.h"

// The bootloader build compiles every board source too, without the engine-configuration include paths.
#ifndef EFI_BOOTLOADER

#include "miata_board.h"
#include "mazda_miata_base_maps.h"
#include "table_helper.h"

// ---- copied from rusEFI mazda_miata_vvt.cpp (GPL-3.0), unchanged ----
#if VVT_TABLE_SIZE == 8
static const float vvt18RpmBins[VVT_TABLE_SIZE] =
{700.0, 1000.0, 2000.0, 3000.0, 3500.0, 4500.0, 5500.0, 6500.0}
;

static const float vvt18LoadBins[VVT_TABLE_SIZE] =
{30.0, 40.0, 50.0, 60.0, 70.0, 75.0, 82.0, 85.0}
;

static const uint8_t SCRIPT_TABLE_vvt_target[VVT_TABLE_SIZE][VVT_TABLE_SIZE] = {
		/* Generated by TS2C on Mon Feb 13 19:11:32 EST 2017*/
		{/* 0 30	*//* 0 700.0*/1,	/* 1 1000.0*/3,	/* 2 2000.0*/10,	/* 3 3000.0*/20,	/* 4 3500.0*/27,	/* 5 4500.0*/28,	/* 6 5500.0*/11,	/* 7 6500.0*/5,	},
		{/* 1 40	*//* 0 700.0*/3,	/* 1 1000.0*/10,	/* 2 2000.0*/19,	/* 3 3000.0*/26,	/* 4 3500.0*/30,	/* 5 4500.0*/28,	/* 6 5500.0*/11,	/* 7 6500.0*/5,	},
		{/* 2 50	*//* 0 700.0*/7,	/* 1 1000.0*/16,	/* 2 2000.0*/24,	/* 3 3000.0*/28,	/* 4 3500.0*/30,	/* 5 4500.0*/28,	/* 6 5500.0*/11,	/* 7 6500.0*/5,	},
		{/* 3 60	*//* 0 700.0*/11,	/* 1 1000.0*/20,	/* 2 2000.0*/27,	/* 3 3000.0*/28,	/* 4 3500.0*/30,	/* 5 4500.0*/28,	/* 6 5500.0*/11,	/* 7 6500.0*/5,	},
		{/* 4 70	*//* 0 700.0*/13,	/* 1 1000.0*/24,	/* 2 2000.0*/31,	/* 3 3000.0*/28,	/* 4 3500.0*/30,	/* 5 4500.0*/28,	/* 6 5500.0*/11,	/* 7 6500.0*/5,	},
		{/* 5 75	*//* 0 700.0*/15,	/* 1 1000.0*/27,	/* 2 2000.0*/33,	/* 3 3000.0*/28,	/* 4 3500.0*/30,	/* 5 4500.0*/28,	/* 6 5500.0*/11,	/* 7 6500.0*/5,	},
		{/* 6 82	*//* 0 700.0*/17,	/* 1 1000.0*/28,	/* 2 2000.0*/33,	/* 3 3000.0*/28,	/* 4 3500.0*/30,	/* 5 4500.0*/28,	/* 6 5500.0*/11,	/* 7 6500.0*/5,	},
		{/* 7 85	*//* 0 700.0*/17,	/* 1 1000.0*/28,	/* 2 2000.0*/33,	/* 3 3000.0*/28,	/* 4 3500.0*/30,	/* 5 4500.0*/28,	/* 6 5500.0*/11,	/* 7 6500.0*/5,	},
};
#endif

#if (VE_RPM_COUNT == 16) && (VE_LOAD_COUNT == 16)
static const int8_t mapBased18vvtVeTable_NB_fuel_rail[16][16] = {
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
		{/* 15 250	*//* 0 700.0*/1,	/* 1 850.0*/1,	/* 2 943.0*/1,	/* 3 1112.0*/2,	/* 4 1310.0*/2,	/* 5 1545.0*/3,	/* 6 1821.0*/3,	/* 7 2146.0*/4,	/* 8 2530.0*/5,	/* 9 2982.0*/6,	/* 10 3515.0*/7,	/* 11 4144.0*/9,	/* 12 4884.0*/10,	/* 13 5757.0*/12,	/* 14 6787.0*/13,	/* 15 8000.0*/14,	},
};
#endif

static void setMazdaMiataNbInjectorLag() {
#if VBAT_INJECTOR_CURVE_SIZE == 8
static const float injectorLagVbattBins[VBAT_INJECTOR_CURVE_SIZE] = {
	6.0, 8.0, 10.0, 11.0, 12.0, 13.0, 14.0, 15.0
};
	copyArray(engineConfiguration->injector.battLagCorrBattBins, injectorLagVbattBins);
#endif // VBAT_INJECTOR_CURVE_SIZE
#if VBAT_INJECTOR_CURVE_PRESSURE_SIZE == 2
static const float injectorLagPressureBins[VBAT_INJECTOR_CURVE_PRESSURE_SIZE] = { 300, 600 };
	copyArray(engineConfiguration->injector.battLagCorrPressBins, injectorLagPressureBins);
#endif // VBAT_INJECTOR_CURVE_PRESSURE_SIZE
#if (VBAT_INJECTOR_CURVE_PRESSURE_SIZE == 2) && (VBAT_INJECTOR_CURVE_SIZE == 8)
static const float injectorLagCorrection[VBAT_INJECTOR_CURVE_PRESSURE_SIZE][VBAT_INJECTOR_CURVE_SIZE] = {
	{ 4.0, 3.0, 2.0, 1.7, 1.5, 1.35, 1.25, 1.20 },
	{ 4.0, 3.0, 2.0, 1.7, 1.5, 1.35, 1.25, 1.20 },
};
	copyTable(engineConfiguration->injector.battLagCorrTable, injectorLagCorrection);
#endif
}
// ---- end of the copied tables ----

/**
 * VE, ignition, injector lag, cranking and idle tables for both NB presets; the VVT target table for 2001-05 only.
 * The same settings rusEFI's setCommonMazdaNB() / setMazdaMiataEngineNB2Defaults() make on its own boards.
 */
void miataSetNbBaseTune(bool vvt) {
	setTable(config->crankingCycleBaseFuel, 27.5);
	setArrayValues(config->cltCrankingCorr, 60);
	setArrayValues(config->afterCrankingIACtaperDuration, 250);

#if (VE_RPM_COUNT == 16) && (VE_LOAD_COUNT == 16)
	copyArray(config->veRpmBins, mazda_miata_nb2_RpmBins);
	copyArray(config->veLoadBins, mazda_miata_nb2_LoadBins);
	copyTable(config->veTable, mapBased18vvtVeTable_NB_fuel_rail);
#endif

#if (IGN_RPM_COUNT == 16) && (IGN_LOAD_COUNT == 16)
	copyArray(config->ignitionRpmBins, ignition18vvtRpmBins);
	copyArray(config->ignitionLoadBins, ignition18vvtLoadBins);
	copyTable(config->ignitionTable, mapBased18vvtTimingTable);
#endif

	setMazdaMiataNbInjectorLag();

	engineConfiguration->wwaeTau = 0.1;

	miataNA_setCltIdleCorrBins();
	miataNA_setCltIdleRpmBins();
	miataNA_setIacCoastingBins();

#if VVT_TABLE_SIZE == 8
	if (vvt) {
		copyArray(config->vvtTable1RpmBins, vvt18RpmBins);
		copyArray(config->vvtTable1LoadBins, vvt18LoadBins);
		copyTable(config->vvtTable1, SCRIPT_TABLE_vvt_target);
	}
#else
	(void)vvt;
#endif
}

#endif // EFI_BOOTLOADER
