v3ai/miata-ecus/(commit log)

2026-10-30 Miata rusEFI ECU: daughterboard rev 0.3 and five year-specific motherboards
    - daughterboard rev 0.3: STM32F407 rusEFI board with the FOME/rusEFI LSU 4.9
    wideband controller laid out in the board's own style
    - motherboards: 1989-93 and 1994-95 rev 0.4, 1996-97 / 1999-2000 / 2001-05
    rev 0.2 (1996-2005 case geometry provisional)
    - scripts: the generator for every board (design, placement, router,
    schematic, release packaging); project footprints; pinout research
    - viewer: interactive 3D viewer of every board and assembly
    Claude-Session: https://claude.ai/code/session_012UFcA8PhPqkqYxcgEjD2n9
2026-10-30 README: 3D renders of the assembled ECU and the daughterboard
    Also fixes the viewer's board surfaces flickering against the board slab at
    assembly-view distances (pale wedges fanned out from the drill holes).
    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
2026-10-30 IAT source jumper on every motherboard; wideband MCU flashed through the main MCU
    - motherboards (1989-93 / 1994-95 rev 0.5, 1996-97 / 1999-2000 / 2001-05
    rev 0.3): the R4/R5 0R links are replaced by JP1, a 1x3 2.54 mm header with
    a removable shunt (STOCK = harness sensor, EXT = IAT connector, default)
    - daughterboard rev 0.4: USART3 (PD8/PD9) to the STM32F042's ROM-bootloader
    USART1 (PA9/PA10), plus PD10 -> its BOOT0 and PD11 -> its NRST, so both
    MCUs can be flashed over the one USB-C port (rusEFI support to be written;
    SWD pads kept as a fallback)
    - scripts: schematic check now also catches nets split across sheets;
    motherboard project template bundled
    - README: flashing and IA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
2026-10-30 Firmware: rusEFI board definition and on-board wideband flasher
    - firmware/board: rusEFI board "miata-ecu" for the STM32F407 daughterboard. Pin map from
    scripts/design.py, board facts pinned (dividers, CLT/IAT pull-up as its Thevenin equivalent,
    CAN2 + CAN wideband, MPX5700AP MAP), five year presets picked from TunerStudio Popular Vehicles.
    - wideband_uart_flash.cpp: programs the STM32F042 wideband over its ROM serial bootloader
    (AN3155 on USART3, BOOT0 on PD10, NRST on PD11) with rusEFI's wideband_image_with_bl.bin,
    then reads it back. Console wbo_uart_flash / wbo_uart_status and a TunerStudio button.
    - rusEFI pinned as the firmware/ext/rusefi submodule (1374bd07).
    - CI: pin cross-c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
2026-10-30 Firmware CI: fix connector yaml, report build errors as annotations
    - daughterboard.yaml: analog pins listed a two-item id with a single class, which rusEFI's
    pinout generator rejects ("Expected multiple classes"); use the EFI_ADC_x id alone. The two
    on-board entries no longer share pin name "onboard" (it became a duplicate #define).
    - Workflow: on failure, re-run the build and post its error lines as an annotation.
    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
2026-10-30 Verification: pinout audit, engine/circuit/flash simulations, safety review
    Firmware fixes found by the review:
    - 1994-95 runs sequential (four injector wires 2U/2V/2Y/2Z), not batch.
    - 1989-93 leaves INJ3/INJ4 unassigned: 3Z is the A/T control unit on automatics.
    - Board expires old warnings itself: with no TunerStudio polling, the NB "not firing
    until cam sync" start-up warning kept the check engine light blinking forever.
    - Board logic split into miata_board.cpp / miata_pins.h so it runs in rusEFI's tests.
    Verification tooling (all in CI, new "simulate" job):
    - firmware/board/tests: all five years in rusEFI's unit-test engine, real NA/NB
    trigger captures, cranking to 6500 rpm, rev li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
2026-10-30 Ignition sense only where the harness has it; review corrections
    The board set rusEFI's ignition-sense input (PA2/VIGN_IN) on every year, but
    the wire exists only on 1989-95 (1C) and 2003-05 (4S). On 1996-2002 cars the
    input reads 0 V, rusEFI decides the key is off and cuts fuel and spark. The
    unit-test build compiles that cut out, so the first simulation missed it.
    - Ignition sense is now set by the 1989-93, 1994-95 and 2003-05 presets only.
    - 2001-02 and 2003-05 get separate Popular Vehicles buttons (board action
    0x11 builds NB2 without main relay or ignition sense).
    - Tests check ignition sense per year, run 2001-02 separately, and run the
    rev limiter on every year (cut at 7600, sync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
2026-10-30 Rev 0.5 daughterboard, rev 0.6 1989-93/1994-95 motherboards: review fixes
    Daughterboard rev 0.5:
    - SN74LVC4245A drives the eight AUIPS2041 low sides at 5 V; output enable pulled
    off (R71) until the firmware enables it on PA8.
    - BOOT1 pull-down (R72); hall input clamps D13/D14.
    - ULN2003 COM to an SMAJ33A TVS (D11) instead of +12V: no key-off back-feed,
    no conduction in a 35 V load dump.
    - Logic supply: D7/D8 -> 0.5 A PTC F1 -> SMAJ33A D12; C16 50 V, SS36 D9, C59.
    - Tach stays an output.
    Motherboards:
    - Idle/VVT freewheel diodes, 4.7k switch pull-up options (not fitted),
    AUX VBAT PTC on all years.
    - 1989-93 rev 0.6: two drivers per injector wire (0R links), SMCJ40A clamps.
    - 2001-05: J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
2026-10-30 Viewer and README renders for daughterboard rev 0.5 and the rev 0.6/0.4 motherboards
    - All six boards' viewer assets (surfaces, component models, parts tables)
    regenerated from the released boards.
    - Viewer labels: daughterboard rev 0.5 (lists the new parts), motherboard revs
    0.6 / 0.6 / 0.4 / 0.4 / 0.4, shortcut chips for U11, the idle/VVT freewheel
    diodes and the 1989-93 injector links and clamps.
    - mpn.json: manufacturer part numbers for the new parts (shop links).
    - README renders refreshed.
    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
2026-10-30 Viewer: version the asset URLs so browsers load the new boards
    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
2026-10-31 Daughterboard: 5.5 A buck inductor, 33 pF crystal caps; NB alternator control off by default
    - L2: Sunlord MWSA0603S-100MT (C132141, 10 uH, Isat 5.5 A, 7 x 6.6 mm). The
    MWSA0503S saturated at 3.5 A, below the LMR14020's 3.8 A maximum current
    limit. Placed on end; D9 and the feedback divider moved 0.3 mm left.
    - C13/C14: 33 pF C0G (C1663) for the 20 pF crystal (were 22 pF).
    - Firmware: NB alternator control ships off until the field current is
    measured (pin, PID and target still set up). Test checks the field isn't
    driven with the default tune.
    - Daughterboard re-routed and released: 754 pads match, 0 unconnected,
    0 clearance errors. Viewer assets and README renders refreshed.
    Co-A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
2026-10-31 Shopping list of the parts JLCPCB doesn't fit, for every board
    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
2026-10-31 Split BOMs: JLC assembles SMD + USB-C, everything else in a self-order BOM
    - order_bom.py: through-hole parts (daughterboard J1/J2; motherboard sockets,
    Micro-Fit, AUX, JP1 header, MAP sensor) leave the JLC BOM and CPL and go to
    fab/self_order_bom.csv with the harness header, shunt, standoffs, screws
    and the not-fitted options. Columns load into LCSC's BOM tool.
    - order_all.py -> docs/order_all_boards.csv: all five motherboards, five
    daughterboards and the in-car parts in one list.
    - bom.py / mb_export.py use it, so future releases keep the split.
    - READMEs and the shopping list page updated.
    Claude-Session: https://claude.ai/c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
2026-10-31 README renders with black solder mask; pcb3d.py MASK/OUTDIR options
    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
2026-10-31 README renders: black solder mask with ENIG gold pads; pcb3d.py FINISH option
    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
2026-10-31 README renders back to black solder mask with tin (HASL) pads
    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
2026-10-31 Daughterboard rev 0.5b: in-stock parts for JLCPCB assembly
    JLCPCB's BOM check flagged ten lines short of stock and one footprint mismatch.
    All replacements are in stock at JLCPCB and fit the existing footprints (no re-route):
    - Q1-Q8: onsemi NCV8406ASTT3G (C459816) instead of AUIPS2041LTR: same SOT-223
    pinout, 60-70 V active clamp, current limit, thermal shutdown, AEC-Q101.
    - D11/D12 Littelfuse SMAJ33A (C223988); F1 TECHFUSE nSMD050-33V (C70077);
    L1 FH CMI322513U2R2KT (C70960); LEDs KENTO KT-0603G/B/Y; C103 YAGEO 33 nF
    50 V (C106862); R110 62 ohm 1% (C23222, was 61.9).
    - U9 (MAX9926, spare VR inputs, out of stock everywhere) not fitted.
    - U105 footprint renamed SOT-23-5 (AD8628ARTZ; pa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
2026-11-01 Daughterboard rev 0.5b: LM2903 VR conditioner, JLC placement fix, parts-availability swaps
    - U9: the out-of-stock, single-source MAX9926 is replaced by an LM2903 dual comparator (TI, onsemi, UMW, ST...).
    Each VR input gets a BAT54S clamp to GND/+5V and 100k to a 1.65 V bias, each output 1M of hysteresis
    (D15-D18, R73-R80, C60). Same output polarity, so J2 wiring and firmware are unchanged. circuit_sim.py
    section H covers it (25 OK / 4 CHECK / 6 REF / 0 FAIL).
    - Re-routed; daughter_patch_05b.py (with hand_route.py) routes HALL1, which the autorouter left open, and
    moves AN_AUX3 clear of the new clamps. Netlist 778 pads, 0 differences; DRC 0 unconnected, 0 clearance.
    - CPLs for all boa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
2026-11-02 Daughterboard rev 0.6: STM32F103C8 wideband controller with its own firmware port
    The STM32F042 has been scarce for years (JLC 167, LCSC ~70); the wideband MCU is now an STM32F103C8T6
    (JLC 200k+), with the FOME/rusEFI module's analog front end unchanged.
    Board
    - U102 LQFP-48 in the F042's spot, pins chosen so each group faces its parts (wideband.py U2_PADS).
    - Y101 8 MHz crystal (+C119/C120 33p) so CAN timing holds over temperature; R135 BOOT1 pull-down;
    C121 VDD decoupling. Re-routed; daughter_patch.py (was daughter_patch_05b.py) now hand-routes HALL1
    only when the router leaves it open. Netlist 795 pads, 0 differences; DRC 0 unconnected, 0 clearance.
    Firmware
    - firmware/wideband: rus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
2026-11-02 Firmware-in-the-loop simulation (Renode) and two firmware fixes it found
    firmware/sim: OpenBLT + rusEFI on an emulated STM32F407 and the wideband
    image on an emulated STM32F103, with models for what Renode 1.15 lacks
    (F4 ADC, stream DMA with circular mode, F1 RCC/flash/ADC, timer clocks,
    DWT, RETTOBASE), a crank/cam generator fed from rusEFI's real cranking
    captures, an output-pin recorder, an LSU 4.9 plant, the F103 ROM
    bootloader protocol on the ECU's programming pins, and a CAN sniffer.
    run_ecu.py runs each model year; run_system.py has the ECU flash a blank
    F103 and read lambda back over CAN. Still being brought up: the
    workflow is manual-only.
    Firmware fixes, both critical errors that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
2026-11-02 sim: 6x faster firmware-in-the-loop, more realistic checks
    - RETTOBASE now comes from a bus front for the NVIC (models/NvicRettobase.cs)
    that reads the NVIC's own active-exception stack, replacing CPU hooks on
    every interrupt entry: a hook hit costs milliseconds of host time.
    - C# DWT cycle counter instead of a Python peripheral (read ~10^5 times/s).
    - ADC models produce one emulator event per regular sequence; DMA writes go
    straight into RAM.
    - Sensors are read from stored-value sensors (MapSlow, Tps1Primary), with
    their SensorType numbers taken from the build.
    - The wideband flash is triggered from rusEFI's main-loop thread for one
    call; the earlier trigger ran with the kernel lo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
2026-11-02 sim: bootloader model reads the CR1 value the firmware wrote (Renode's UART drops CR1.M)
    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
2026-11-02 sim: bootloader model takes the frame format from the USART enable write; fix LSU log format
    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
2026-11-02 sim: run Renode with the monitor on a TCP port (console stdin leaked memory or blocked logging); compile the sampler once
    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
2026-11-02 sim: serial execution for the two-chip run (Renode's per-machine threads froze it), streamed logs with a stall watchdog, host-side progress probe, faster F103 ADC/LSU models
    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
2026-11-02 sim: LSU cavity as an integrator and the Bosch LSU 4.9 pump-current table; TIM4 front for Renode's CCR=0 compare gap (F103 system timer stopped at the 16-bit wrap); CAN bit timing read from the model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
2026-11-02 sim: TIM4 front moves compares at 0 or ARR to 1 (Renode's timer never matches 0 and wraps one count early, which stopped the F103's ChibiOS timer at its first wrap)
    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
2026-11-02 Full-firmware emulation results: two-chip run passes (flash, CAN timing, heater, pump loop, lambda 1.00/0.85/1.20); verification report section with the new hardware findings N1-N13
    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
2026-11-02 sim workflow: build the firmware with rusEFI's custom-board action (as the Firmware workflow), fetch the wideband sources; find the OpenBLT ELF by board name
    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
2026-11-03 sim: log the LSU model every 50 ms, so the per-step pump-current means use enough samples to be stable
    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
2026-11-03 Rev 0.7: fixes for the 2026-11-02 circuit and fault findings (N1-N9), re-verified
    Daughterboard rev 0.7:
    - U4 LDL1117S33R low-dropout 3.3 V regulator (was AMS1117) and D30 BAT54WS from the F103's VDDA to +3V3:
    VDDA - VDD now at most 253 mV at power-up, key-off and brown-out (was 953 mV; ST allows 300 mV) (N1, N4)
    - D19-D26 BAT54WS clamps on the eight analog inputs; 0603 series and CLT/IAT bias resistors (N2)
    - R137 10k into the Nernst buffer input; F103 PA1 no longer on LSU_VM (N3, sense inputs only)
    - 0603 hall pull-ups (N6), R138 2.2k ahead of the knock coupling cap (N7), D27-D29 switch-input clamps (N9)
    - OUT_INJ1-4 copper zones on both outer layers with thermal vias around Q1-Q4 (N8: i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
2026-11-03 Rev 0.8 work in progress: design sources, motherboard and firmware changes (boards not yet released)
    Daughterboard sources (125 x 76 mm): VND7NV04 low sides on tab copper, ZXMS6004 relay/lamp/tach and ignition
    pull-downs, protected harness 5 V (V5_EXT), +3V3 shunt clamp (2 x 100 uF), LSU drive-wire PTC and clamps,
    TCAN1042V, AUX UART protection. Motherboards: harness 5 V cavities and J5-14 on V5_EXT, 1989-93 D3/D4 SMCJ30A
    with heat-spreading copper (mb_tvs_copper.py), R27 idle-switch pull-up option. Firmware: relay pins parked off
    with the other low sides. The routed boards, fab files and docs follow in the release commit.
    Claude-Sessi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
2026-11-03 Rev 0.8 work in progress: 1994-95 motherboard build log, board-check updates in progress
    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
2026-11-03 Rev 0.8 WIP: board_checks rev 0.8 models; R144-R147 3.3k and R139/R140 10k (24 V short ratings); sim TVS copper
    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
2026-11-03 Motherboards rev 0.8 (1989-95) / 0.6 (1996-2005): rebuilt, routed and released
    Harness sensor 5 V cavities and J5-14 on the daughterboard's protected V5_EXT (JD1-13), MAP on its own V5_SENS;
    daughterboard outline 125 x 76 mm; 1989-93: D3/D4 SMCJ30A with cathode copper islands and solid ground pads,
    R27 idle-switch pull-up option. All five: routed completely, schematic netlist 0 mismatches, DRC 0 unconnected.
    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
2026-11-03 Rev 0.8 WIP: place C68 (second +3V3 bulk cap); move the UART clamp parts off the MCU's east pins
    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
2026-11-03 Rev 0.8 WIP: D38/D39 clear of the analog fan lanes, R19-R26 off the board edge; daughter_finish refreshes values and drops GND vias crowding header holes; router ECO0 / stale-net handling
    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
2026-11-03 Rev 0.8 WIP: thermal vias in the DPAK tab pads (25-34 per driver), finishing fixes; sim weights inner copper by via count
    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
2026-11-03 Rev 0.8 WIP: schematic ignition stage wired out (Schottky, pull-down and IntelliFET per channel)
    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
2026-11-03 Rev 0.8 WIP: LED comms/warning on PC8/PC9, NPTH-aware hand router, dangling-copper cleanup, hand-route chain script
    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
2026-11-03 Sim: PC8/PC9 (rev 0.8 LED outputs) off the EXTI lines Renode wires without SYSCFG muxing; park low-side lines only when not already parked, with interrupts locked
    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
2026-11-03 README renders from the rev 0.8 boards
    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
2026-11-04 Rev 0.9 WIP: J1 back on the daughterboard's top edge with the driver strip below it; motherboards place the daughterboard 16 mm lower (centred); viewer standoffs from the board's holes
    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
2026-11-04 Motherboards rev 0.9 (1989-95) / 0.7 (1996-2005): daughterboard 16 mm lower and centred, JD2 / lower standoffs / J5 moved, re-routed (0 unconnected, 0 netlist mismatches)
    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
2026-11-04 Rev 0.9 docs: results re-checked (circuit sim, board checks, copper, mating, pins)
    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
2026-11-04 README renders and viewer assets from the rev 0.9 boards
    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
2026-11-04 Daughterboard re-released JLC-clean (spacing, fab capabilities, silkscreen, via-to-hole); WB_NRST re-routed with the 0.47 mm hole rule; docs
    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
2026-11-04 Fab files named for the board and revision (e.g. miata-ecu-motherboard-1989-93-rev0.9_jlcpcb_gerbers.zip, miata-ecu-daughterboard-rev0.9_jlcpcb_bom.csv); export scripts, READMEs
    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
2026-11-04 JLC files: USB-C (J4) placed at its pad centre in the CPL (KiCad's origin is 1.14 mm toward the edge), and named by part number (USB4105-GF-A) in the BOM so JLC's matcher doesn't leave it unticked
    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
2026-11-04 Self-order BOM: each not-fitted option keeps its own note
    R20-R22 and R27 share a 4.7k part but have different purposes (VSS, A/C,
    clutch 12 V pull-ups; 2L idle-switch 5 V pull-up); R25/R26 the two
    sequential links. The row now lists every ref's note instead of the first.
    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
2026-11-04 1989-93 motherboard rev 0.10: aftermarket TPS connector J6 and the TPS kit
    The 1989-93 manual cars have only an idle switch on the throttle, so rusEFI saw a
    failed TPS (open-loop idle, no TPS acceleration fuel, no overrun cut). New J6
    (Micro-Fit 1x4 right angle, LCSC C277684) on the bottom edge between the USB-C
    and the MAP sensor: 1 = V5_EXT, 2 = IN_TPS (same input as harness 2M),
    3 = GND, 4 = GND (shield). Both nets hand-routed on B.Cu at 0.2 mm clearance;
    two GND stitching vias under J6's pegs removed; nothing else moved.
    Checks: DRC 0 unconnected / 0 clearance, netlist 217 pads / 0 differences,
    jlc_spacing 0 pairs, jlc_fab_check OK, board_checks 1587 OK / 270 CHECK /
    4 FAIL (unchanged L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
2026-11-05 1989-93 motherboard rev 0.11: TPS sensor on the stock throttle plug; 1N no longer hard-wired to 5 V
    Like rusEFI's Hellen NA6 and MRE boards, a 0-5 V sensor now plugs into the
    manual cars' stock throttle switch plug (idle contact 1N, ground 2D,
    full-throttle contact 2L) instead of rev 0.10's separate J6 lead, which is
    removed. 0805 links: R28 1N -> V5_EXT (not fitted), R29 2L -> IN_AUX1
    (fitted, as before), R30 2L -> IN_TPS (not fitted). Conversion: fit R28,
    move R29 to R30.
    Also fixes a fault in every earlier revision: 1N was wired straight to the
    protected sensor 5 V, so with the stock switch (idle contact on 1N per the
    rusEFI sources) the 5 V was shorted to ground at every idle.
    Hand-rou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
2026-11-07 Website: Mono, a black-and-white Shopify theme for selling the ECUs
    website/theme: Online Store 2.0 theme (layout, header/footer groups, hero,
    spec band, image-with-text, feature grid, compatibility table, featured
    collection, FAQ, product, collection, cart, search, blog, password, gift
    card and customer templates). Heading font Jost by default (Shopify dropped
    Futura from its library in 2025), with an Adobe Fonts option for Futura PT.
    Board renders on white from the 3D viewer ship as theme assets. Theme Check:
    0 errors, 2 warnings (the optional Adobe Fonts stylesheet).
    website/products: six draft products (per year + daughterboard) as a
    Shopify import CSV, price 0 until set. website/preview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
2026-11-07 Website: $399 for every year, no daughterboard listing, all years Prototype, new headline
    products.csv: five ECUs (one per model-year range) at $399, still drafts;
    the daughterboard-only product is gone and the 1996-2005 listings lose their
    "coming later" text and tag. Fit tables on the home and product pages say
    Prototype for every year. Hero: "The most affordable Miata EFI.", backed in
    the text by "no other plug-in Miata ECU with a built-in wideband costs less"
    (prices checked 2026-11-07, listed in website/README.md); smaller hero type
    so the longer headline fits. "Upgrade path" column reworded, since
    motherboards aren't sold on their own.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
2026-11-07 Hand-fit parts page: DigiKey links and part numbers instead of LCSC
    Every part DigiKey sells links to a DigiKey search for its manufacturer part
    number. Chinese-brand parts DigiKey doesn't carry get same-size equivalents:
    Sullins PRPC040SAAN-RC (1x40 male), PRPC003SAAN-RC, QPC02SXGN-RC shunt, two
    PPTC201LFBN-RC 1x20 8.5 mm sockets per 1x40 row (the 1x40 isn't normally
    stocked), On Shore 302-S161 box header, Wurth 970110321 standoff, Yageo
    resistors, Molex Micro-Fit by DigiKey-style number, STLINK-V3MINIE,
    TC2030-IDC-NL. New "Copy DigiKey list" button (part number, quantity).
    Claude-Session: https://claude.ai/code/session_012UFcA8PhPqkq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
2026-11-10 Hand-fit parts page: McMaster-Carr links for the screws and nuts
    MAP sensor: M3 x 10 pan head 92000A120 with M3 nylon-insert locknuts
    93625A100 (in place of plain nuts, against vibration). Standoffs: M3 x 6
    pan head 92000A116. All 18-8 stainless, packs of 100. The CSV export gets a
    McMaster-Carr column.
    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
2026-11-12 Firmware: 1C is the start signal, release PC14, shorter Burn dropout; gold sockets
    From an external review, each finding re-checked against rusEFI's source and other sources:
    - 1989-95: 1C is the starter (START) signal, not ignition-on. The NA6/NA94 presets no longer use
    it as ignition sense (rusEFI cut fuel and spark 0.2 s after the key left START). The emulation
    now models 1C as live only while cranking; sim_report no longer expects ignKey on 1C.
    - PC14 (fuel pump) is also OSC32_IN. New board/mcuconf.h turns the LSE off for the firmware and
    the bootloader (RTC from the LSI); board init also clears LSEON. Removes the ~1 s LSE wait.
    - Every Burn disabled all 15 low-side outputs until t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
2026-11-12 Hand-fit parts: one-piece gold 1x40 socket (Würth 61304011821) for JD1/JD2
    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
2026-11-12 Install guide, labelled pictures, features list; NB base tune; optional MAP tee
    Docs
    - INSTALL.md: fitting the ECU to a car. Labelled pictures of every connector
    for each year, header pin maps (AUX, wideband, air temperature, JP1), where
    the stock ECU is, case openings, year-specific steps (1990-93 fuel pump and
    airflow meter), the MAP hose source and firewall route per year, wideband,
    air temperature, first start, AUX add-ons (boost valve, knock, coil-on-plug).
    - README: "Features and limitations" section, link to INSTALL.md.
    - images/annotated_*.jpg and header_pinouts.png, drawn from the viewer and the
    board files by scripts/annotate.py (pin nets are asserted against the PCBs).
    -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
2026-11-12 Firmware: NB tune file builds in the bootloader too; emulation result
    - miata_nb_tune.cpp: its includes now sit inside the EFI_BOOTLOADER guard.
    The OpenBLT build compiles every board source without the engine include
    paths, so CI's bootloader step failed on mazda_miata_base_maps.h. The
    firmware image is unchanged apart from the build time stamp.
    - offline_compile_check.sh also builds the bootloader with the board
    sources (the bundle step that does it comes after the point where the
    offline build stops), so this is caught locally.
    - VERIFICATION.md: six-year emulation with the base tune, 0 FAIL.
    Claude-Session: https://claud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
2026-11-12 Viewer: draw the wideband heater fuse F1; label it on the assembled pictures
    F1 is a 2920 resettable fuse on every motherboard. KiCad's 3D library has no
    model for that package, so the viewer showed only its two pads and the labelled
    pictures pointed at an empty spot. viewer/pcb3d.py now builds a simple body for
    Fuse_2920_7451Metric (dark body, tinned end terminals), the five motherboards'
    viewer assets are rebuilt, and the ten labelled pictures are redrawn. The
    assembled pictures label F1 as well.
    Board files, BOMs and placement files are unchanged: F1 was always in them.
    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
2026-11-12 Re-render the README renders and shop photos with fuse F1 drawn
    Same camera, crops and JPEG settings as before (the old raw renders reproduce
    the published files byte for byte), from a fresh black-mask asset build:
    - images/assembly_1989-93.jpg, assembly_lifted.jpg
    - website/theme/assets/render-*.jpg and website/product-images/*.jpg
    - website/mono-theme.zip rebuilt from theme/ (it also picks up the "what you
    add" wording changed earlier today)
    Besides F1, the daughterboard in these renders is now the released layout:
    the old renders predated the JLCPCB spacing rework (U106 moved, silkscreen
    labels shifted).
    Claude-Session: https://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
2026-11-13 Frozen copy of the boards ordered in November 2026
    ordered-boards/2026-11/ holds the daughterboard rev 0.9 and the five
    motherboards exactly as ordered (design files, fabrication files, docs,
    parts lists, firmware board files), with a note of their known points, so
    they stay usable and sellable after the design moves on.
    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
2026-11-13 Ordered-boards note: refer to the commit (the remote does not take tags)
    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
